gamer927/rav4/docs/06-system-review.md

# System review: fail-safes, fallbacks and integrity

A whole-system review of the RAV4 transmission controller before it goes on a custom circuit
board. It covers how the parts fit together, what happens when each one fails, how every
behaviour is tested, and the risks that are left.

**Verdict:** every failure we can think of ends with the factory computer in charge, and nearly
all of them are also reported on the screen. All tests pass (§6). There are no known open
defects. The remaining risks (§7) can't be designed out, or can only be checked on the real car.
The circuit is laid out as one circuit board (§8) that passes KiCad's design-rule check; the first
one built still has to pass the bench checks listed there.

---

## 1. The system on one page

Cable map

| Piece | Where | What it does |
|---|---|---|
| **TCU box** | Under the passenger side of the dash | An Arduino Mega with one circuit board plugged on top (relays, drivers, inputs, switch filters, screen and probe connections, gyro). It listens to the engine computer and can take over the transmission's three solenoids. |
| **Dash pod** | Dash top, driver's side | The screen, then ECO, SPORT, MANUAL, TEST and ON/OFF in a row. |
| **Shifter base** | Centre console | The Beavis sequential lever (two microswitches). |
| **Car side** | — | 7 listening taps (nothing cut), the 3 solenoid wires (cut and taken through the box), key-on power, the ATF temperature probe, a heatsink with 3 dummy resistors. |

**How control works.** Each of the three solenoids (S1, S2, SL) has its own two-pole relay:

```
relay OFF (no coil power):  factory ECU ──────────────► solenoid      the car as built
relay ON  (coil powered):   factory ECU ──► 15 Ω dummy (ECU sees a normal load, no trouble code)
                            TCU driver  ──────────────► solenoid
```

The relays are only ON while the TCU is in charge. Everything in this review comes back to one
rule: **anything that goes wrong turns the relays off.**

---

## 2. The safety chain

The layers below each work on their own. The ones at the top don't need the Arduino to work.

| # | Layer | What it does | Needs the Arduino? |
|---|---|---|---|
| 1 | **Bypass plug** | Unplug the TCU, plug the BYPASS plug into the car's X2: the solenoids are wired straight to the ECU. The car is 100 % stock. | No |
| 2 | **Relays rest in the factory position** | No power, a dead Mega, a blown fuse, a cut wire: the relays drop out and the ECU drives. | No |
| 3 | **ON/OFF cuts the relays' power directly** | The switch has two poles. Pole 2 carries the relay coils' 12 V (through the dash cable, C7/C8), so OFF drops the relays even if the Mega has crashed with its outputs ON or a driver chip has failed shorted. | No |
| 4 | **Pull-downs on every output** | 10 kΩ on D6, D8, D9, D10: while the Mega resets or boots, every relay and driver reads OFF. | No |
| 5 | **Watchdog, 250 ms** | A hung program resets the Mega within a quarter of a second; the reset turns everything OFF (layer 4). The self-test proves the watchdog works. | Its own timer |
| 6 | **Faults hand back and latch** | Every fault in §4 turns the relays off and stays off until you flip ON/OFF off (or, for stuck hardware, until the next key-on). | Yes |
| 7 | **Rules for taking over** | Only after a fresh OFF→ON flip (≥ 100 ms off), only in D, only with exactly one of ECO/SPORT/MANUAL on, only when calibrated, only when the sensed gear agrees with engine rpm. Never by itself at key-on or after a reset. | Yes |
| 8 | **Self-tests** | At every key-on (PBIT), all the time (CBIT) and when you hold TEST (IBIT). Detailed in spec §7. | Yes |

Layers 1–5 mean that a software bug can't keep the relays on against your will: **ON/OFF off
always wins.**

---

## 3. Fallbacks: what you get when

| Situation | Who shifts | Screen |
|---|---|---|
| ON/OFF off | Factory ECU | TCU IS OFF |
| Key-on with ON/OFF already on | Factory ECU until you flip it off and on | WAITING |
| No mode switch on / two or more on (> 1 s) | Factory ECU; the TCU takes back over by itself when fixed | PICK MODE / MODE ERROR |
| Lever moved out of D | Factory ECU; back to TCU when you return to D (synced to the ECU's gear) | STOCK |
| Takeover asked for on the move, but the sensed gear doesn't fit engine rpm | Factory ECU until the car stops | STOP FIRST |
| Any fault (§4) | Factory ECU | PROBLEM + what's wrong |
| Not calibrated yet | Factory ECU | NOT READY |
| Screen dead or unplugged | TCU carries on (the screen is information only) | — |
| ATF probe or tach lost | TCU carries on, using safe defaults | warning |
| Box unplugged or removed | Factory ECU, via the bypass plug | — |

---

## 4. Failure modes and what happens

How to read this table: **Detected by** is what notices; **Result** is the state the car ends up
in; **Tested by** names the automated test that proves it (unit test function in `test/`,
system scenario in `test/system/`, or cross-check in `tools/system_check.py`). "Hardware" means
it is physics, not software: it happens even if the Mega is dead.

### Power and the Arduino

| Failure | Detected by | Result | Tested by |
|---|---|---|---|
| Key-on power lost / fuse blows | Hardware | Relays drop: ECU | system: *battery voltage collapses* |
| Battery below 10.5 V or above 16 V for 0.5 s | `FAULT_SUPPLY` | ECU, PROBLEM | unit `test_supply_and_tps_faults`; system: *battery voltage collapses* |
| Load dump / spikes on 12 V | TVS1/TVS2 (27 V) | Clamped | — (part choice) |
| Wires reversed at X1 | D1 blocks on the logic feed; TVS1 conducts on the driver feed and blows its 5 A fuse | Logic protected, nothing powered | — (part choice) |
| 5 V regulator fails shorted (12 V on 5 V) | TVS3 clamps, the 2 A fuse blows | Mega off: relays drop, ECU | — (part choice) |
| Program hangs | Watchdog (250 ms) | Reset, everything off, ECU | system: *firmware hung with relays on*; IBIT watchdog step |
| Reset mid-drive (any cause) | Pull-downs + arming rule | Relays drop; **no** automatic re-takeover | unit `test_boot_requires_switch_cycle`, `test_boot_glitch_does_not_arm`; system: *reset at 50 mph* |
| Mega's outputs stuck ON (crash, damaged pin, shorted ULN2803) | You flip ON/OFF off | Relays drop in hardware | system: *firmware hung with relays on* |

### The ON/OFF switch and its wiring

| Failure | Detected by | Result | Tested by |
|---|---|---|---|
| Read pole's wire (C5) broken | Reads OFF | ECU (safe direction) | system: *ON/OFF turned OFF while driving* |
| Read pole's wire shorted to ground (reads ON) | Power pole still cuts; A7 vs D26 disagree | Relays drop in hardware, `FAULT_ONOFF` | unit `test_onoff_two_poles_and_relay`; system: *ON/OFF read wire shorted* |
| Power pole wire (C7/C8) broken, F2 blown | A7 sees no coil power with D26 ON | ECU, `FAULT_ONOFF` | system: *relay coil fuse blown* |
| Power pole welded or shorted (no hardware cut) | A7 sees coil power with D26 OFF; key-on and IBIT cut checks | `FAULT_ONOFF` on the screen; the firmware's own OFF still works | system: *ON/OFF power pole shorted*; IBIT *ON/OFF CUT* |
| C7/C8 shorted to ground | F2 (PTC) trips | No coil power: ECU, `FAULT_ONOFF` | cross-check 5 (PTC in the feed) |
| Switch bounce, a glitch at boot | Debounce + ≥ 100 ms OFF before arming | Not armed | unit `test_debouncer`, `test_boot_glitch_does_not_arm` |

### Relays, drivers and solenoids

| Failure | Detected by | Result | Tested by |
|---|---|---|---|
| Relay welded / stuck in the TCU position | Key-on relay-release check (drivers on, relays off: any current = stuck) | No takeover all drive, RELAY STUCK | unit `test_onoff_two_poles_and_relay`, `test_detects_faults`; system: *relay welded* |
| Relay doesn't pull in | Current check (commanded on, < 0.6 A) | ECU, `FAULT_SOLENOID` | unit `test_cbit_solenoid_fault` |
| Solenoid wire broken (open) | Current check | ECU, `FAULT_SOLENOID` | system: *solenoid wire breaks while driving* |
| Solenoid wire shorted to ground | Current check (> over-current limit) | ECU, `FAULT_SOLENOID` | unit `test_cbit_solenoid_short`; system: *solenoid wire shorted* |
| Driver MOSFET fails shorted | Current check (commanded off, > 0.2 A) | ECU (the relay disconnects the driver) | unit `test_cbit_solenoid_short` |
| Wrong gear engaged (swapped S1/S2, hydraulic fault, bad sensor) | Ratio check: rpm vs speed × gear, with lockup on | ECU, `FAULT_RATIO` / WRONG GEAR | unit `test_ratio_fault` |
| Relay coil flyback when ON/OFF opens | DF (UF4007) and the ULN2803's diodes | Clamped | cross-check 5 (DF on the coil feed) |

### Sensors and inputs

| Failure | Detected by | Result | Tested by |
|---|---|---|---|
| Speed signal lost at speed | Speed drops faster than any car can brake | ECU, `FAULT_VSS` | unit `test_vss_faults`; system: *speed signal lost at 45 mph* |
| Speed signal dead from the start | Engine working hard in 2nd+ at "0 mph" for 3 s | ECU, `FAULT_VSS` | unit `test_vss_faults` |
| Throttle sensor open/short | Voltage out of range for 0.2 s | ECU, `FAULT_TPS` | unit `test_supply_and_tps_faults` |
| Tach lost | No rpm above 15 mph for 2 s | TCU carries on: over-rev guards use speed × ratio, ratio check pauses; NO RPM warning | unit `test_onoff_two_poles_and_relay`; system: *tach lost* |
| ECU sense input dead or mis-wired | Sensed gear vs engine rpm at takeover | Waits for a stop, then starts in 1st | unit `test_entry_plausibility`, `test_entry_sync`; system: *ECU sense dead* |
| Lever-D input broken (reads "not D") | Reads not-D | ECU (safe direction) | system: *lever out of D* |
| **Lever-D input stuck on** (reads D in P, R, N, 2, L) | Engine starts while it reads D (the starter only turns in P or N) | No takeover until the next key-on, LEVER SENSOR | unit `test_lever_stuck_at_start`; system: *lever-D input stuck on* |
| Brake input dead | Self-test prompt PRESS THE BRAKE | Lockup still releases on throttle-off rules; found at the next self-test | IBIT prompts |
| ATF probe unplugged | Bad readings | Warning; lockup uses the normal rules | system: *ATF probe unplugged* |
| ATF overheats | 110 °C / 125 °C | Warning; lockup held on to cool | system: *ATF overheats*; unit `test_hot_atf_widens_lockup` |
| Gyro dead | Self-test, `latValid` false | Corner hold switched off; everything else carries on | unit `test_corner_hold` |

### Driver controls

| Failure | Detected by | Result | Tested by |
|---|---|---|---|
| Two mode switches on, or none | Exactly-one rule, 1 s grace | ECU until fixed, MODE ERROR / PICK MODE | unit `test_mode_switch_fault_and_stuck_button`; system: *two mode switches on* |
| Mode switch wire broken | Reads off: none on | ECU, PICK MODE | same |
| Shifter microswitch stuck | Held 10 s | Warning (SHIFTER?); no repeat shifts | unit `test_mode_switch_fault_and_stuck_button`, `test_no_autorepeat_and_interval` |
| Dangerous shift asked for | Over-rev check (5,800 rpm), 1st capped at 28 mph; ECO/SPORT upshift at 6,200 rpm, MANUAL shows SHIFT UP! from 6,000 rpm and leaves it to the driver | Downshift refused; upshift done (ECO/SPORT) or asked for (MANUAL) | unit `test_downshift_overrev_guard`, `test_rev_limit_upshift`, `test_manual_auto_downshift_to_stop` |
| Screen cable cut / screen dead | I²C timeout (3 ms) | Control unaffected, loop never stalls | system: *screen cable cut* |

### The self-test itself

| Failure | Detected by | Result | Tested by |
|---|---|---|---|
| Self-test started with the engine running | Two checks: rpm **and** charging voltage | Refused (CAN'T TEST) | unit `test_interlocks`; system: *self-test refused with the engine running* |
| Car moves / lever to D / engine starts mid-test | Checked every loop | Test aborts, everything off at once | unit `test_abort` |

---

## 5. Integrity: does everything agree?

`tools/system_check.py` checks the things no single test sees, by reading the actual circuit,
circuit board, firmware, housings and documents:

1. Every Mega pin the firmware uses is wired to the signal that means the same thing, and no
   wired Mega pin is unused.
2. Every net at a Mega pin carries that pin's signal.
3. Every output that drives a relay or a solenoid driver goes only to ULN2803A inputs (each has
   its own pull-down inside the chip): nothing can hold it on while the Mega resets.
4. Every switch input has its 2.2k pull-up, 10k series resistor and 100 nF capacitor.
5. The ON/OFF hardware cut: the relay coils are fed **only** through the switch's power pole (DASH terminals 7 and 8),
   through the PTC, with the flyback diode, and the sense reaches A7.
6. The box's glands, the board's terminal groups and the cable map agree, in the same order.
7. Every screen text fits where it's drawn.
8. Part counts on the shopping list match the board.
9. The spec's pin table lists every pin the firmware uses.
10. Every link in the documents points at a file that exists.
11. The circuit board file is the circuit: every pad of every part is on the net the circuit
    says (read straight from `hardware/pcb/rav4-tcu.kicad_pcb`), and KiCad's design-rule check
    reports no errors and no unconnected pads.

The checker was itself tested by breaking things on purpose (a wrong Mega pin, relay coils fed
straight from 12 V, an over-long screen line, a missing pull-down): it caught every one.

**Physical fit** (`tools/build_stl.sh`): each housing's fit check intersects every part, wire
bundle, plug and gland with the housing and with each other, and must come out empty:

- **TCU box:** the circuit board with every part at its real size and height (read from the
  board design), the Mega under it with its jacks, every cable's wires fanning from its gland to
  its terminal group, the lid lip, at least 15 mm of working room in front of the terminals,
  and no two glands' nuts touching.
- **Dash pod:** every switch body with its terminals and a wire bend (ON/OFF modelled as a
  2-pole switch, 18 × 22 × 50 mm), the screen, 8 lever connectors, both glands, the ON/OFF
  cover, and the pod tilting through its whole range on the hinge.
- **Shifter base:** bolt tips, mounting bolts, the gland and cable, connectors, and the real
  Beavis shifter body standing on the deck with its wire hole opening into the body's pocket.

All three pass.

---

## 6. Test results

| Suite | What | Result |
|---|---|---|
| `make test` | Unit tests: every control rule, fault, interlock and self-test step, every limit exactly at its value (`test/test_tcu_logic.cpp`, `test/test_self_test.cpp`). Built with AddressSanitizer and UBSan: a read past an array fails | **2,221 + 274 checks, 0 failures** |
| `make system` | The real `tcu.ino`, compiled for a PC, wired to a simulated car (engine, gears that follow the solenoids, relays that pull in 15 ms after their coil is powered, current sensors with their own zero offsets, a gyro that drifts, welded contacts, broken wires), one failure per scenario. The screen is read back from the pixels sent over I2C; 250 ms without a watchdog kick fails | **38 scenarios, 0 failures** |
| `make golden` | Every system scenario's screen changes (row by row, flashes included) and USB event lines, and the calibration session's whole log, against reference copies (`test/system/golden/`) | **identical** |
| `make chip` | The `.hex` exactly as flashed, started by the Mega's real bootloader, on a simulated ATmega2560 (simavr): see §6.1 | **18 scenarios, 0 failures** |
| `make calibrate-test` | The calibration helper on a simulated parked session and drive, with a speed sensor 6 % off and an engine 5 % off: it must find both, write a `config.h` that compiles, and refuse bad recordings | **32 checks, 0 failures** |
| `python3 tools/system_check.py` | Cross-checks (§5) | **864 pass, 0 problems** |
| `tools/build_stl.sh` | Fit checks (§5), STLs, renders | **all pass** |
| `make avr` | Compile for the Mega 2560, warnings as errors | **OK**: 15 % flash, 47 % RAM (the core linked as the Arduino IDE does it); the self-test's saved results are clear of the bootloader's stack |
| `make mutate` | How good the tests are: §6.2 | see §6.2 |

`make check` runs all of these but the fit checks and `make mutate`. Run it after any change.

### 6.1 The chip test: the firmware as flashed

The PC tests replace the Arduino core, the chip and its bootloader with stand-ins written for the
tests. A wrong assumption about the hardware then sits in the stand-in too, and the test passes:
the bootloader clearing the reset-cause register (§6.4) was found only once the real bootloader
ran. `make chip` (`test/chip/chip_test.cpp`) removes that layer: the `.hex` the Arduino build
makes, the real stk500v2 bootloader at its real address, every instruction, timer, interrupt, the
watchdog, the ADC, the UART and the I2C hardware simulated by simavr. Around the chip, the board
and the car come from the circuit, not from `config.h`: the pins are read from the Arduino core's
own Mega pin table; the screen is an SSD1309 whose pixels are read back as text; the temperature
probe is a DS18B20 answering bit by bit on the 1-Wire line, with its checksum written from the
datasheet; the gyro is an MPU-6050. The firmware is judged only by its pins, its USB log and its
screen.

It covers, on the shipped build: the boot through the bootloader; never taking over before
calibration; the probe (read once a second, bad readings and its power-on value handled, nothing
made up before the first reading); the screen cable cut and back; the **full self-test answered
from the screen, ending in the deliberate watchdog reset through the real bootloader**. And on the
calibrated build: taking over and shifting 1-4, MANUAL shifting with the lever, corner hold from
the gyro over I2C, ON/OFF, a broken solenoid wire, a lost speed signal, a battery collapse, the
reset button mid-drive, a welded relay at key-on, a lost tach.

Measured on the chip: the slowest loop while driving is **7.6 ms** (the control period is 10 ms;
the watchdog allows 250 ms); 46 ms once at power-up, parked, while it prints the self-test table;
**3,740 bytes** of stack never touched.

### 6.2 Do the tests catch bugs? Mutation testing

A test suite that passes says nothing until you know it would fail on a bug. `tools/mutate.py`
plants one small bug at a time in the firmware (a `<` becomes `<=`, `&&` becomes `||`, `true`
becomes `false`, a statement disappears; 1,397 in all), rebuilds, and runs the unit tests, the
system test, the calibration helper and the golden comparison against it; the hardware-side ones
that get past those also face the chip test. Each planted bug ends up in one of these:

- **caught**: some test fails;
- **missed**: a gap;
- **at a limit only**: it only matters when a reading lands exactly on a limit (`<` vs `<=` on a
  voltage, a speed or a time). The safety limits have their own exactly-at-the-limit tests;
- **can't simulate**: real, but no simulation can show it (an interrupt landing between two
  reads, a floating pin). Counted against the score, never as caught;
- **equivalent**: provably changes nothing, each listed in `mutate.py` with the reason (e.g.
  "the Mega's bootloader already disables the watchdog", "the Mega's own LED is under the board").

| Code | Caught | Missed | At a limit only | Can't simulate | Equivalent | Score (all) | Score without the at-a-limit ones |
|---|---|---|---|---|---|---|---|
| `self_test.cpp` (the self-test's verdicts) | 208 | 0 | 0 | 0 | 15 | **100 %** | **100 %** |
| `tcu_logic.cpp` (every driving and safety decision) | 443 | 0 | 62 | 0 | 44 | 88 % | **100 %** |
| `tcu.ino` (pins, sensors, screen, log, the watchdog step) | 522 | 5 | 37 | 6 | 44 | 92 % | **98 %** |

When this started the scores were 60 %, 68 % and 29 %: passing tests were far weaker than they
looked. The five still missed, all minor:

- the temperature reading could come one second later than it does;
- two in the health line's stack-margin arithmetic (a diagnostic);
- "LEVER NOT IN D" could also show in one rare STOCK state;
- a refused self-test's CAN'T TEST could linger for a second into a new one.

The full list, with every equivalent's reason, is in `build/mutants/report.md` after
`make mutate` (`python3 tools/mutate.py --report` rewrites it from the saved results).

### 6.3 What only the real car can prove

Everything above is simulation. These can't be simulated with any confidence and are checked by
the build book's meter checks, the bench test and the staged car test (spec §9): the solenoids'
real resistance and the hydraulics' response time; the real gear ratios, speed-sensor pulses and
throttle voltages (calibration, spec §8); electrical noise in the car; the relays' and MOSFETs'
real switching; the screen's I2C over the real 2.5 m cable; heat.

### 6.4 Found by the deeper testing

| Found | Fix |
|---|---|
| **Bug (real hardware only):** the Mega's bootloader clears the reset-cause register, so SAFETY RESET would always fail and a hang never showed TCU RESTARTED | A mark left by the watchdog's interrupt; the PC simulator now models the bootloader too, and the chip test runs the real one |
| The PC tests read the screen from the firmware's own text buffer: deleting the call that draws the screen passed | The screen is read from the pixels sent over I2C |
| The PC stand-in returned the wire's level when the firmware read back one of its own outputs; the chip returns the level written. So on the PC the current sensors' zeros were never learned, hidden by a perfect 2.50 V zero | Fixed, and every sensor now has a real-world zero offset (2.47-2.54 V) |
| Relays and solenoids reacted instantly in the tests, so a self-test step that measured too early still passed | A relay takes 15 ms to close, a solenoid's current 20 ms to come up |
| A broken ON/OFF hardware cut, a welded relay during the cut, or the cut with no current sensors could all have shown OK in the self-test without a test noticing | Each has its own test now |
| No test ran the gyro from end to end; a stuck lever-D, the throttle sensor's open wire, a corrupted saved self-test table, the probe's bad readings | Scenarios for each, on the PC and on the chip |

**System scenarios** (each in its own process, from a cold boot):

| Scenario | Shows |
|---|---|
| boots parked | key-on checks pass, factory ECU drives |
| ON/OFF already ON at key-on | waits for a fresh flip |
| normal drive | takes over in D, shifts 1-4, watchdog kicked |
| ON/OFF turned OFF while driving | ECU back within 60 ms |
| firmware hung with relays on | ON/OFF still cuts them in hardware |
| ON/OFF read wire shorted | power pole cuts, mismatch reported |
| ON/OFF power pole shorted | found at key-on and reported |
| relay coil fuse blown | no takeover, reported |
| relay welded | found at key-on, no takeover |
| solenoid wire breaks while driving | ECU back, reported |
| two mode switches on | ECU after 1 s, back when fixed |
| lever out of D | ECU back |
| lever-D input stuck on | found at engine start, no takeover |
| MANUAL at the redline | no automatic upshift, SHIFT UP! on the screen |
| speed signal lost at 45 mph | ECU back |
| tach lost | still in control, warned |
| screen cable cut | control unaffected, loop never stalls |
| battery voltage collapses | ECU back |
| ECU sense dead, takeover on the move | waits for a stop |
| reset at 50 mph (a hang: the watchdog fires) | relays drop, no takeover after the reboot, TCU RESTARTED |
| reset button at 30 mph | relays drop, no RESTARTED note (it wasn't a hang) |
| self-test SAFETY RESET on a real Mega's bootloader | passes after the reboot; pressing reset instead fails it |
| solenoid wire shorted | over-current, ECU back |
| ATF probe unplugged | warned, still in control |
| ATF overheats | warned, lockup held to cool it |
| self-test (IBIT) | every check passes, including the hardware cut |
| self-test refused with the engine running | refused |
| build book 13.4 (jack stands), step by step | the screen says what the book says at each step |
| corner hold from the gyro | an 8 deg/s zero drift learned at a stop and re-learned as it warms up; a long gentle bend doesn't spoil it; a real corner holds the gear |
| gyro glitches, then dies mid-corner | the hold ends, still in control |
| throttle reading | 0/50/100 % right, also with a shifted engine ground |
| throttle sensor wire broken | ECU back, PEDAL SENSOR |
| saved self-test table corrupted over the reset | not restored |
| screen tour | below zero, the SENSORS page's values, the TEST page before the key-on checks, a self-test stopped by the engine starting, one TEST press skipping one prompt, a self-test with more failures than fit on the screen |
| wrong gear engaged (S1/S2 swapped) | ECU back, WRONG GEAR |
| shifter switch stuck closed | one shift, SHIFTER? |
| SPORT brake hold | HOLDING GEAR on the screen |
| 40 mph round a long gentle bend | not learned as the gyro's zero |

### What this review found and fixed

| Found | Fix |
|---|---|
| ON/OFF only *asked* the Mega to hand back: a crashed Mega or a shorted driver chip could keep the relays on | Two-pole switch; pole 2 carries the coils' power (J5, F2, DF), A7 checks it, `FAULT_ONOFF`, IBIT step ON/OFF CUT |
| **Bug:** the switch filters started at "off", so a switch already ON at key-on (or after a reset at speed) looked like a fresh flip and armed the TCU | Filters start from the real pin level; arming needs ≥ 100 ms of OFF first |
| A dead ECU-sense input reads as "4th gear": a takeover on the move could start in the wrong gear | Sensed gear must agree with engine rpm, else wait for a stop |
| A welded relay was only found when you ran the self-test | Relay-release check at every key-on, `FAULT_RELAY` |
| Losing the tach while driving was silent | NO RPM warning |
| A lever-D input stuck on was never noticed | Checked at every engine start, `FAULT_LEVER` |
| A failed 5 V regulator could put 12 V into the Mega | TVS3 across the 5 V rail |
| Several screen lines were too long for the display | Shortened; now checked automatically |
| The dash cable's C7/C8 route to J5 crossed the logic board | Routed along the front gap, then back between the boards; fit check passes. Since then C7/C8 are DASH terminals 7 and 8 on the circuit board |
| Hand-wiring two perfboards and a hub (~175 wires) was the biggest job, and the likeliest place for a mistake | One printed circuit board does all the wiring; its connections are checked pad by pad against the circuit |
| The ON/OFF switch was modelled as a 1-pole switch; the pod had room for only 5 connectors | Modelled as a larger 2-pole switch with 8 connectors; pod fit check passes |
| Before calibration the self-test marked CALIBRATED as **BAD**, so the bench test could never say ALL OK, and the main screen said SELF-TEST BAD | "Not calibrated yet" is now a CHECK (a reminder) |
| On the bench nothing drives the gas pedal input, so the self-test always reported GAS PEDAL BAD | Build book 10.1: a two-resistor gas pedal stand-in for the bench |
| **Bug (real hardware only):** the Mega's own bootloader clears the chip's reset-cause register before the program starts, so the program never saw a watchdog reset: the self-test's SAFETY RESET step would always have said BAD, and a hang never showed TCU RESTARTED. The simulator had set the register by hand, so it couldn't see this | The watchdog's timeout now runs a short routine that leaves a mark in memory that survives the reset, then resets. The simulator now models the bootloader, and the new scenarios fail on the old code |
| Unused Mega pins were left floating (the datasheet advises against it: they pick up noise) | Pulled up at boot; a cross-check makes sure none of them is wired on the board |
| Nothing showed how close the program runs to its limits | Every 10 s the USB log has a `# health` line: the slowest loop (the watchdog allows 250 ms) and the stack margin. The calibration helper prints both and flags a loop over 100 ms or under 512 bytes of margin |

---

## 7. What's left: honest residual risks

Nothing on this list has a known fix that wouldn't add a new risk of its own.

1. **A dummy resistor goes open while the TCU is in charge.** The ECU sees an open solenoid
   circuit, stores a trouble code, lights the check-engine light, and may run its own limp mode
   after you hand back, until the next key cycle. The TCU can't see it (it senses the ECU's
   command voltage, not the current into the dummy). *Mitigation:* 50 W resistors on a
   heatsink, checked in build book part 9; the light tells you. Not dangerous.
2. **Relay contact gap at handover.** Break-before-make takes about 5–10 ms with no drive to the
   solenoid. That's shorter than the hydraulics respond, so no shift happens, but it's not zero.
3. **MANUAL doesn't upshift for you at the redline** (your choice). The screen says SHIFT UP!
   from 6,000 rpm; past that, the engine computer's own fuel cut limits the revs. That fuel cut
   is expected but not yet confirmed for this engine (spec §10). Setting
   `MANUAL_REV_LIMIT_UPSHIFT = true` brings back the automatic upshift.
4. **The screen going dark doesn't hand back.** By design: the screen is information, not
   safety. Faults still hand back; ON/OFF still works by feel (the cover).
5. **A relay that sticks *during* a drive** (rather than at key-on). If it sticks in the TCU
   position after you hand back, that solenoid gets no command from either side until it's
   found at the next key-on (RELAY STUCK). The relays switch about 1 A against an 8 A rating,
   so welding is very unlikely. *Recovery:* the bypass plug.
6. **The solenoid wire itself (outside the box) shorted to +12 V.** The solenoid is on whatever
   either computer says. This is the same as on a stock car; the ratio check catches the wrong
   gear while the TCU is in charge.
7. **Brake input dead.** Lockup then releases only on the throttle rules, not on the brake. A
   stall is still prevented by the low-speed lockup release, and the next self-test finds it.
8. **What the manual valve does in 2, L and R with D-range solenoid commands** (only possible
   with a stuck lever-D input, which is now caught at engine start). Toyota's hydraulics are
   expected to block it; **VERIFY** in the repair manual.
9. **Untested on real hardware.** Every number above comes from simulation and the design.
   Calibration (spec §8) and the staged test plan (spec §9) are required before driving.
10. **Zero risk isn't possible.** A double failure (for example a hung Mega *and* a welded
   ON/OFF power pole) defeats two layers at once. The bypass plug, and pulling the TCU's
   fuse, are always there.

---

## 8. The circuit board

The whole TCU circuit is one 2-layer board, 200 × 170 mm, that plugs onto the Mega's pins
(`tools/pcb.py`; the files to order it are in [`hardware/pcb/`](../hardware/pcb/README.md)).
It reuses the tested circuit in `tools/boards.py` net for net, with the same connectors, so the
cables, housings and tests carry over. What changed on the way:

| Change | Why |
|---|---|
| The ribbon cables and the hub are gone: the board's own pins plug into the Mega | Fewer connections to go wrong; nothing to come loose |
| The adjustable LM2596HV buck module became a fixed RECOM R-78HB5.0-0.5 (9–72 V in) with 47 µF + 100 nF | Nothing to set before first power-up, so the Mega can't get a wrongly set voltage; through-hole, solders straight in |
| The two pull-up groups were both RU1–RU6; the switch inputs' are now **RU11–RU17** | One board needs unique names |
| The MOSFETs lie flat with their tabs bolted down; the current-sensor modules plug into 3 holes plus 2 short **LINK** wires | Low and solid in a car that vibrates |
| Tracks sized by current: 1.5 mm for the solenoid supply, 1.0 mm for the solenoid, load and 12 V lines, ground filled on both layers | Each solenoid draws about 1 A; the tracks stay cool |
| **Found on review:** the ground copper ran under each MOSFET's bolted metal tab (which is its drain, switched +12 V) and under the bolt's nut, with only the thin solder mask between them | Bare board, no copper, under every tab and around every bolt on both sides; a system check keeps it that way |
| **Found by the part fit check:** the Mega's and the modules' pin holes left 0.09 mm round a square pin; the MOSFETs' 1.1 mm holes left almost nothing round their legs; a 10 mm-wide 100 µF capacitor (some are) would hit the regulator; a long ACS712 module could cover its LINK holes | Pin holes 1.1 mm, MOSFET holes 1.3 mm, regulator moved 1.3 mm, LINK holes 35 mm from the pins; `tools/part_fit.py` checks every part at its largest size on every build |
| Made easier to solder (rev 2): the board grew from 150 to 170 mm deep and its parts spread out, bigger pads (long ovals on the chips), every part's value printed beside its name, sockets for U1 and U2, no ground pad joined solidly to the ground copper | A first-time builder can read every part off the board and heat every joint; the box grew to 216 × 212 mm. The router's via check was also fixed (it let a wide track leave a via too close to another track; KiCad's check caught it) |
| **Optimised (rev 3):** 22 parts left out. The 4 pull-downs on the ULN2803A's inputs duplicated the chip's own (2.7 kΩ + 7.2 kΩ to ground inside each input). The 18 BAT85 clamp diodes on the switch and throttle inputs: with the switch inputs' series resistor raised from 1 kΩ to 10 kΩ, a core shorted to 12 V puts at most 0.65 mA into the Mega's own input clamps (Microchip AN2519 allows 1 mA), and the 10 kΩ + 100 nF filter swallows a spike | 113 parts instead of 135, 44 fewer joints, one part type less to buy; nothing on the board depends on a part that isn't there any more (cross-checks 3 and 4) |
| **Found on review:** the board's posts were 2.5 mm too short: they left out the plastic strip of the male headers, which sits on top of the Mega's sockets | Posts 18.6 mm; the fit check passes at the new height |

Checks on the design: every chip's pinout was compared by hand with its datasheet (ULN2803,
LM393, PC817, IRF4905, R-78HB, the G2RL-2 relay's contacts, the sensor and gyro modules), and
`tools/part_fit.py` checks every real part at the largest size it's sold in against its holes,
its neighbours, the screw heads and the Mega underneath
([report](../hardware/pcb/part_fit.md)). KiCad's design-rule check reports **0 errors and 0 unconnected pads**
(`hardware/pcb/drc.txt`; the warnings left are text crossing pads, and library notices), the
system check matches every pad to the circuit, and the box's fit check uses the real board.

Still to do on the **first board** (nothing has been made yet):

- [ ] Look over the board maker's preview of the Gerbers before paying: the outline with its
      notch, the 5 mounting holes and the labels.
- [ ] Before soldering anything, push it onto a bare Mega with the header strips in: every pin
      goes through without force, and the notch clears the USB and power jacks.
- [ ] Build it step by step with the build book's meter checks (part 4 onwards), then the bench
      test (part 10): the full self-test passes, including **ON/OFF CUT** and **SAFETY RESET**.
- [ ] `IS_AMPS_PER_VOLT` calibrated; each solenoid channel reads about 0.8 A into 15 Ω.
- [ ] The 5 V rail reads 4.9–5.1 V and stays there with the engine cranking. The regulator
      needs about 9 V in; a weak battery that sags lower than that while cranking resets the
      Mega, which is safe (the relays drop and the engine computer is in charge) but will
      show as a fresh key-on.
- [ ] The 2-pole ON/OFF switch you bought fits the pod (18 × 22 mm body or smaller) and its
      cover clears.
- [ ] Everything in spec §10 (open items to VERIFY) ticked off.

---

*RAV4 TCU by gamer927 · [CC BY-NC-SA 4.0](../LICENSE): free to build, not to sell.*
