gamer927/rav4/docs/pcb-bottom.png

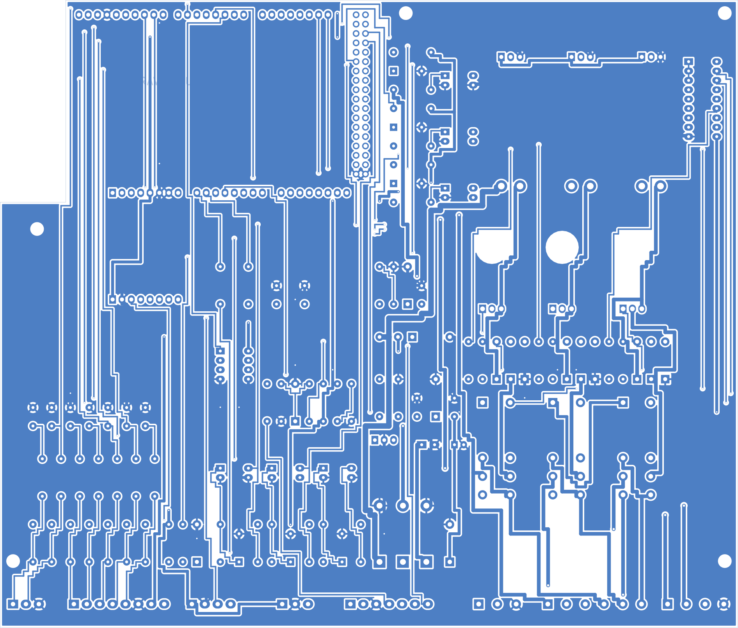
docs/pcb-bottom.png
