gamer927/rav4/hardware/fit-pod.png

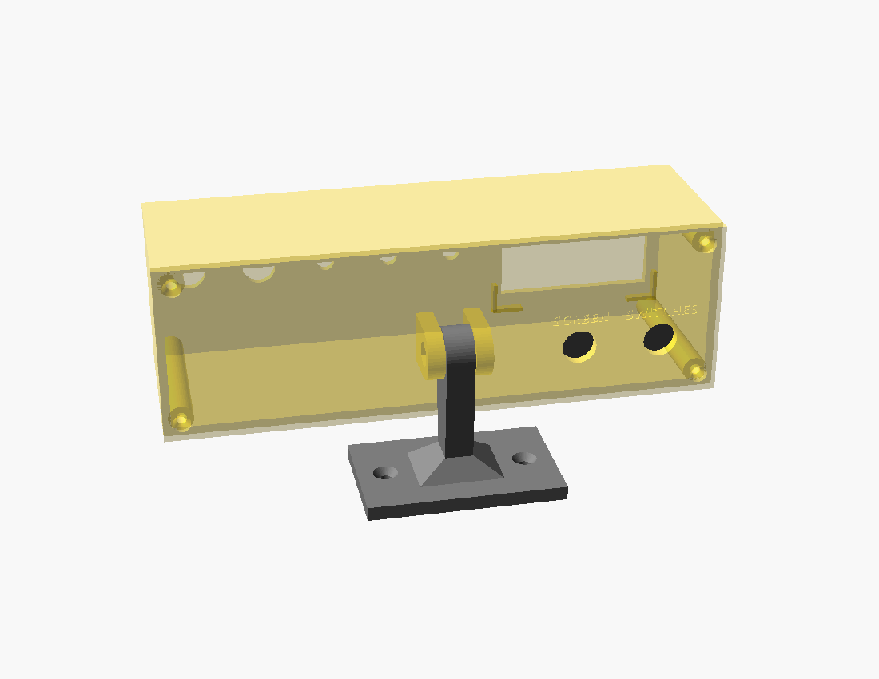
hardware/fit-pod.png
