gamer927/rav4/hardware/pcb/placement.png

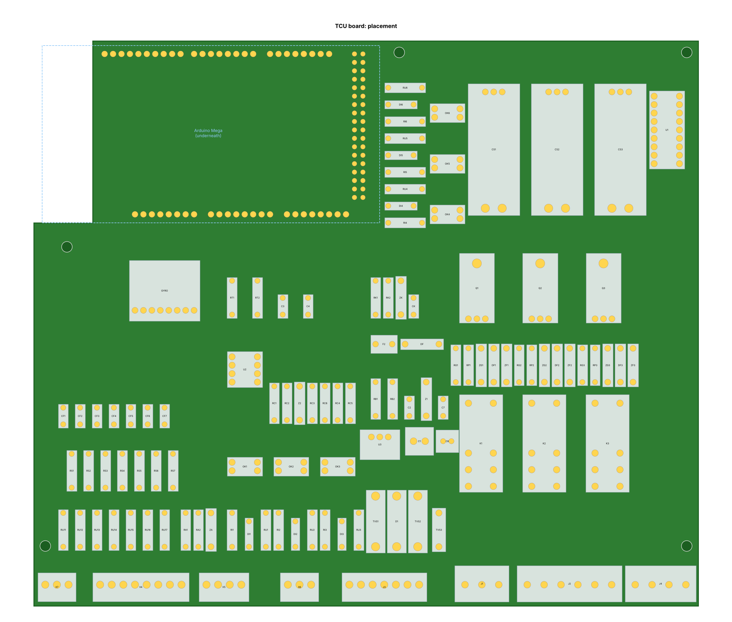
hardware/pcb/placement.png
