gamer927/rav4/hardware/pcb/bom.csv

Qty | Value | Footprint | References
3 | ACS712-05B | ACS712_Module | CS1 CS2 CS3
1 | 47 µF 16 V | CP_Radial_D6.3mm_P2.50mm | C6
1 | 100 µF 50 V | CP_Radial_D8.0mm_P3.50mm | C1
12 | 100 nF | C_Disc_D5.0mm_W2.5mm_P5.00mm | C2 C3 C4 C7 CF1 CF2 CF3 CF4 CF5 CF6 CF7 CK
1 | PTC 0.25 A | C_Disc_D7.5mm_W5.0mm_P5.00mm | F2
1 | R-78HB5.0-0.5 | Converter_DCDC_RECOM_R-78HB-0.5_THT | U3
1 | ULN2803A | DIP-18_W7.62mm_LongPads | U1
6 | PC817 | DIP-4_W7.62mm_LongPads | OK1 OK2 OK3 OK4 OK5 OK6
1 | LM393 | DIP-8_W7.62mm_LongPads | U2
1 | P6KE6.8A | D_DO-15_P10.16mm_Horizontal | TVS3
2 | 1.5KE27A | D_DO-201AD_P15.24mm_Horizontal | TVS1 TVS2
1 | 1N5822 | D_DO-201AD_P15.24mm_Horizontal | D1
6 | 1N4148 | D_DO-35_SOD27_P7.62mm_Horizontal | DI1 DI2 DI3 DI4 DI5 DI6
4 | 1N4733A 5.1 V | D_DO-41_SOD81_P10.16mm_Horizontal | Z1 Z2 ZA ZK
3 | 1N4744A 15 V | D_DO-41_SOD81_P10.16mm_Horizontal | ZG1 ZG2 ZG3
3 | 1N4749A 24 V | D_DO-41_SOD81_P10.16mm_Horizontal | ZF1 ZF2 ZF3
4 | UF4007 | D_DO-41_SOD81_P10.16mm_Horizontal | DF DF1 DF2 DF3
1 | GY-521 | GY-521_Module | GYRO
1 | 1.8k | R_Axial_DIN0207_L6.3mm_D2.5mm_P10.16mm_Horizontal | RC5
1 | 100 | R_Axial_DIN0207_L6.3mm_D2.5mm_P10.16mm_Horizontal | RA2
23 | 10k | R_Axial_DIN0207_L6.3mm_D2.5mm_P10.16mm_Horizontal | RB2 RC2 RC4 RC6 RK2 RP1 RP2 RP3 RS1 RS2 RS3 RS4 RS5 RS6 RS7 RT1 RT2 RU1 RU2 RU3 RU4 RU5 RU6
1 | 1M | R_Axial_DIN0207_L6.3mm_D2.5mm_P10.16mm_Horizontal | RC3
10 | 2.2k | R_Axial_DIN0207_L6.3mm_D2.5mm_P10.16mm_Horizontal | RI1 RI2 RI3 RU11 RU12 RU13 RU14 RU15 RU16 RU17
1 | 22k | R_Axial_DIN0207_L6.3mm_D2.5mm_P10.16mm_Horizontal | RC1
3 | 3.3k | R_Axial_DIN0207_L6.3mm_D2.5mm_P10.16mm_Horizontal | RI4 RI5 RI6
4 | 4.7k | R_Axial_DIN0207_L6.3mm_D2.5mm_P10.16mm_Horizontal | RA1 RG1 RG2 RG3
2 | 47k | R_Axial_DIN0207_L6.3mm_D2.5mm_P10.16mm_Horizontal | RB1 RK1
3 | G2RL-2 12 V | Relay_DPDT_Omron_G2RL-2 | K1 K2 K3
3 | IRF4905 | TO-220-3_Horizontal_TabDown | Q1 Q2 Q3
1 | PWR | TerminalBlock_Phoenix_MKDS-1,5-3-5.08_1x03_P5.08mm_Horizontal | J1
1 | LOAD | TerminalBlock_Phoenix_MKDS-1,5-4-5.08_1x04_P5.08mm_Horizontal | J4
1 | SOL | TerminalBlock_Phoenix_MKDS-1,5-6-5.08_1x06_P5.08mm_Horizontal | J2
1 | ATF | TerminalBlock_Phoenix_PT-1,5-3-3.5-H_1x03_P3.50mm_Horizontal | X6
1 | SHIFT | TerminalBlock_Phoenix_PT-1,5-3-3.5-H_1x03_P3.50mm_Horizontal | X7
1 | SCREEN | TerminalBlock_Phoenix_PT-1,5-4-3.5-H_1x04_P3.50mm_Horizontal | X5
1 | SIG | TerminalBlock_Phoenix_PT-1,5-7-3.5-H_1x07_P3.50mm_Horizontal | J3
1 | DASH | TerminalBlock_Phoenix_PT-1,5-8-3.5-H_1x08_P3.50mm_Horizontal | X4
1 | Arduino Mega 2560 (underneath, on male headers) | Arduino_Mega2560_Shield | A1
