gamer927/rav4/hardware/beavis_shifter/MainBody.stl

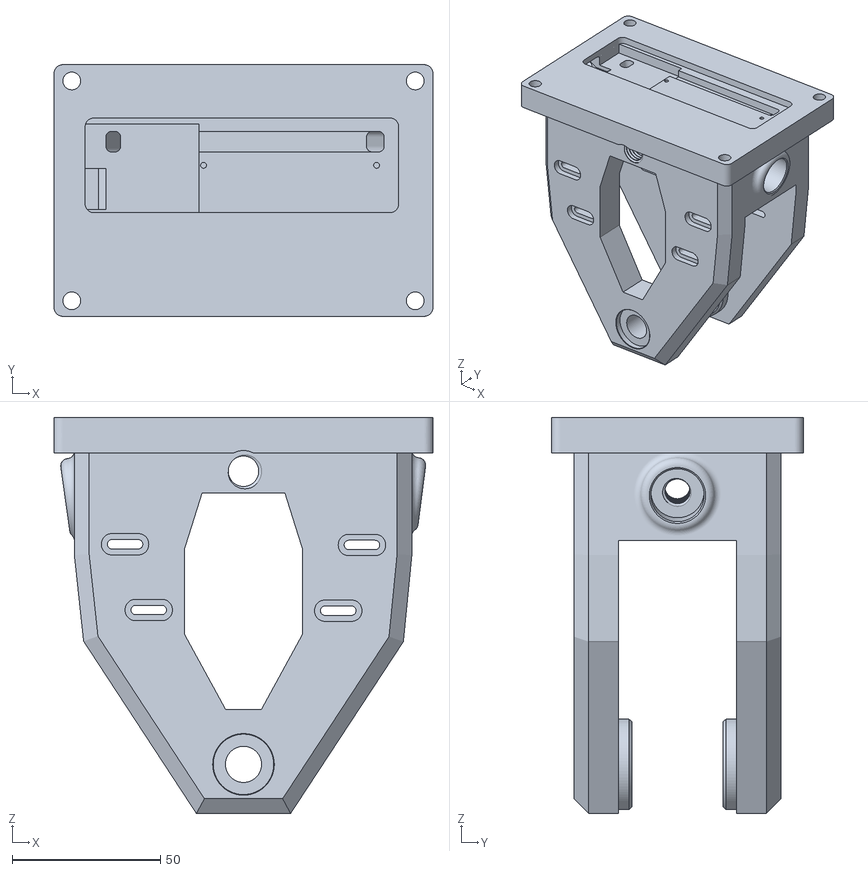
[picture p12: CAD file, 2026-10-27]
hardware/beavis_shifter/MainBody.stl
128.0 x 85.0 x 133.7
