gamer927/rav4/hardware/stl/tcu_enclosure_box.stl

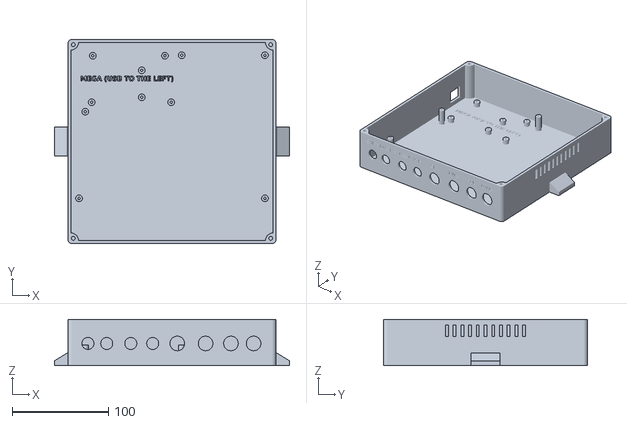
[picture p13: CAD file, 2026-10-28]
hardware/stl/tcu_enclosure_box.stl
244.0 x 212.0 x 48.0
