gamer927/rav4/hardware/beavis_shifter/BottomCover.stl

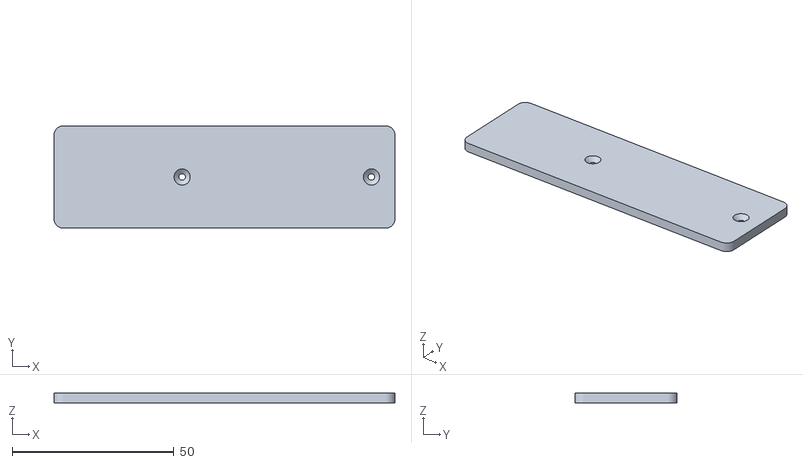
[picture p14: CAD file, 2026-10-27]
hardware/beavis_shifter/BottomCover.stl
105.3 x 31.6 x 3.05
