gamer927/rav4/hardware/stl/tcu_enclosure_lid.stl

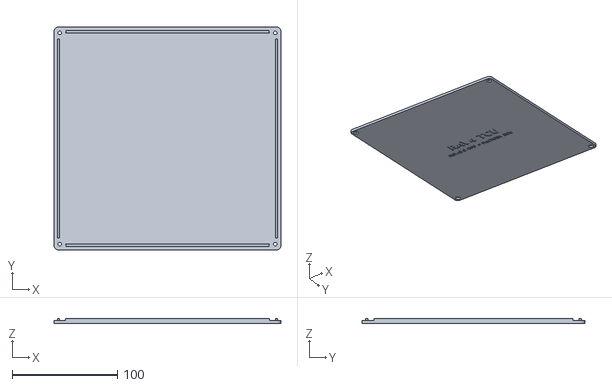
[picture p15: CAD file, 2026-10-28]
hardware/stl/tcu_enclosure_lid.stl
216.0 x 212.0 x 5.00
