gamer927/rav4/hardware/beavis_shifter/ShifterShaft.stl

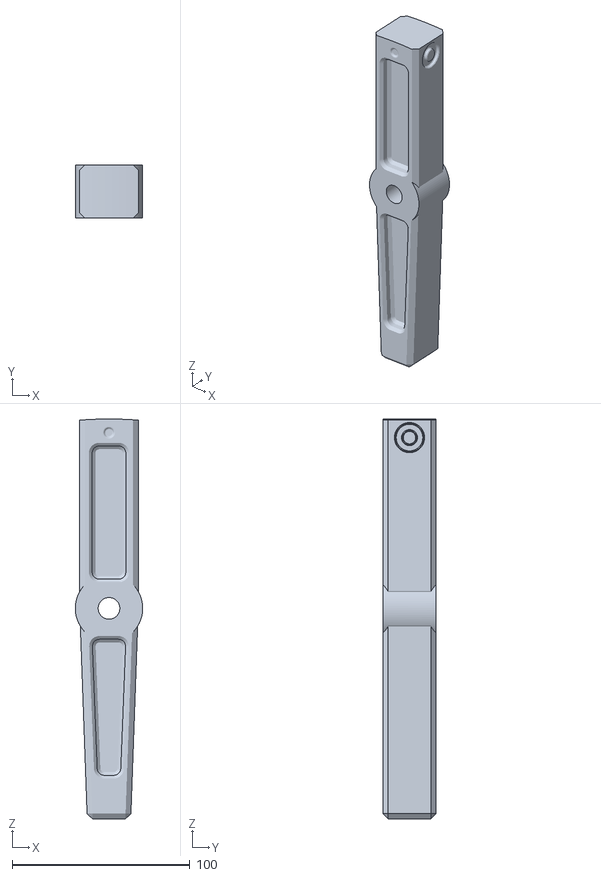
[picture p16: CAD file, 2026-10-27]
hardware/beavis_shifter/ShifterShaft.stl
38.0 x 30.0 x 225.3
