gamer927/rav4/hardware/stl/tcu_enclosure_box_no_ears.stl

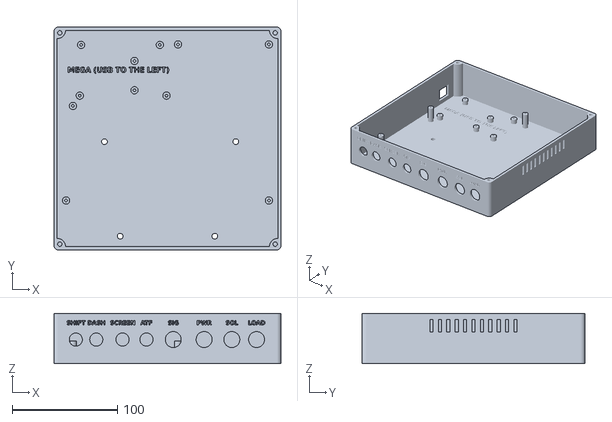
[picture p17: CAD file, 2026-10-28]
hardware/stl/tcu_enclosure_box_no_ears.stl
216.0 x 212.0 x 48.0
