gamer927/rav4/hardware/beavis_shifter/Knob.stl

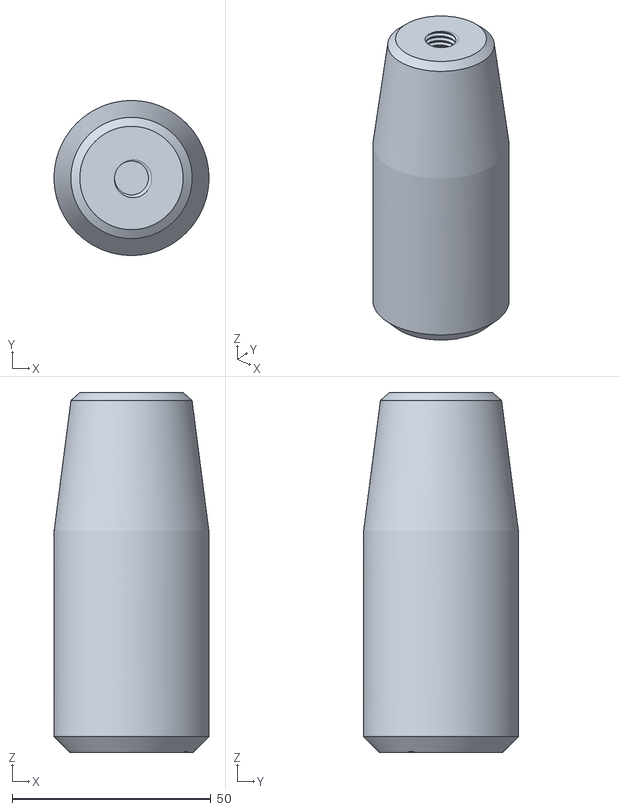
[picture p18: CAD file, 2026-10-27]
hardware/beavis_shifter/Knob.stl
39.0 x 39.0 x 90.6
