gamer927/rav4/hardware/stl/dash_pod_back.stl

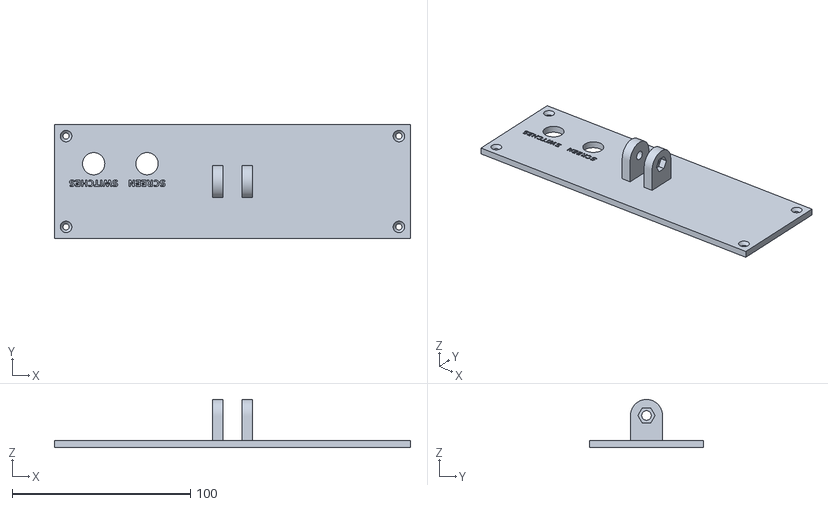
[picture p19: CAD file, 2026-10-28]
hardware/stl/dash_pod_back.stl
200.0 x 64.0 x 27.0
