gamer927/rav4/hardware/beavis_shifter/PivotCap.stl

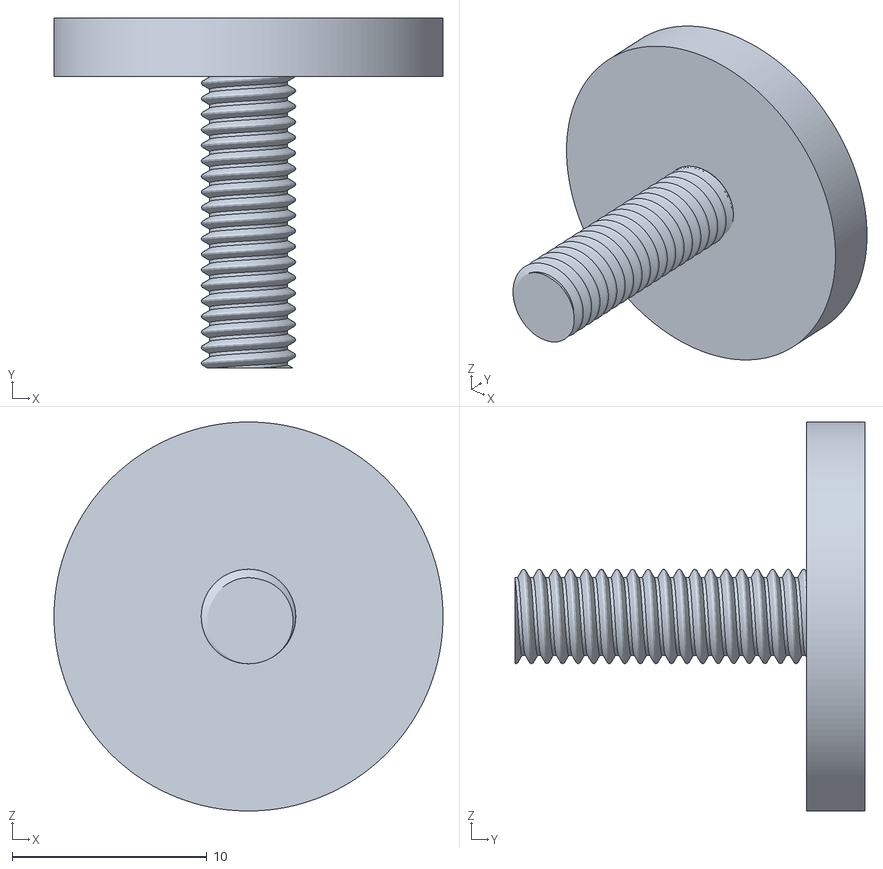
[picture p20: CAD file, 2026-10-27]
hardware/beavis_shifter/PivotCap.stl
20.0 x 18.0 x 20.0
