gamer927/rav4/hardware/stl/dash_pod_panel_test.stl

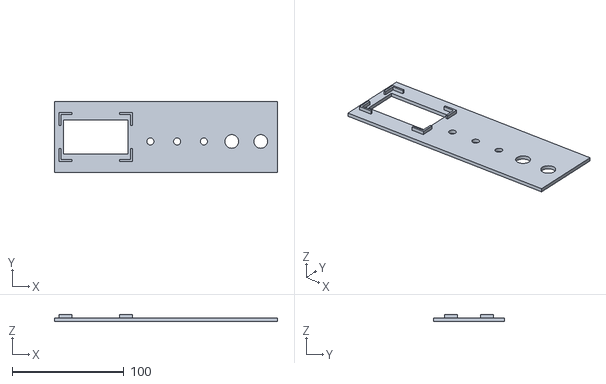
[picture p21: CAD file, 2026-10-28]
hardware/stl/dash_pod_panel_test.stl
200.0 x 64.0 x 6.00
