gamer927/rav4/hardware/beavis_shifter/SwitchSpacer.stl

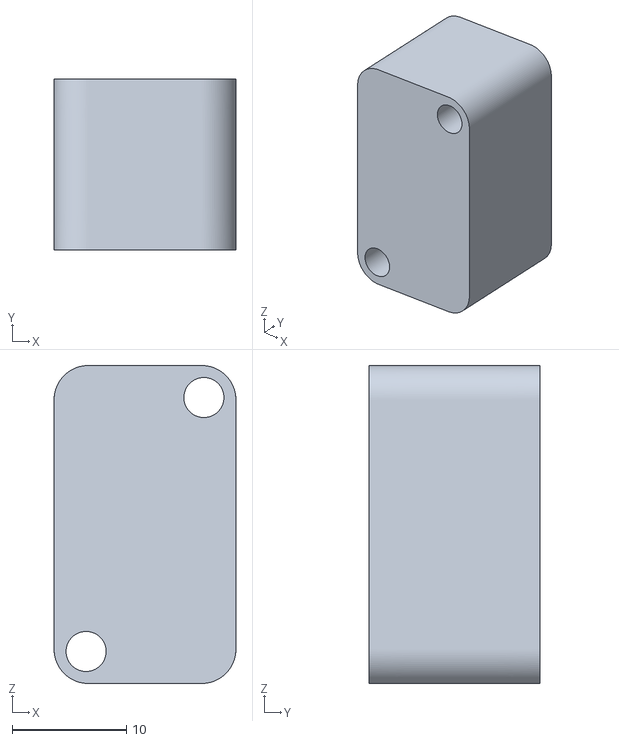
[picture p22: CAD file, 2026-10-27]
hardware/beavis_shifter/SwitchSpacer.stl
15.9 x 15.0 x 27.8
