gamer927/rav4/hardware/stl/shifter_base_box.stl

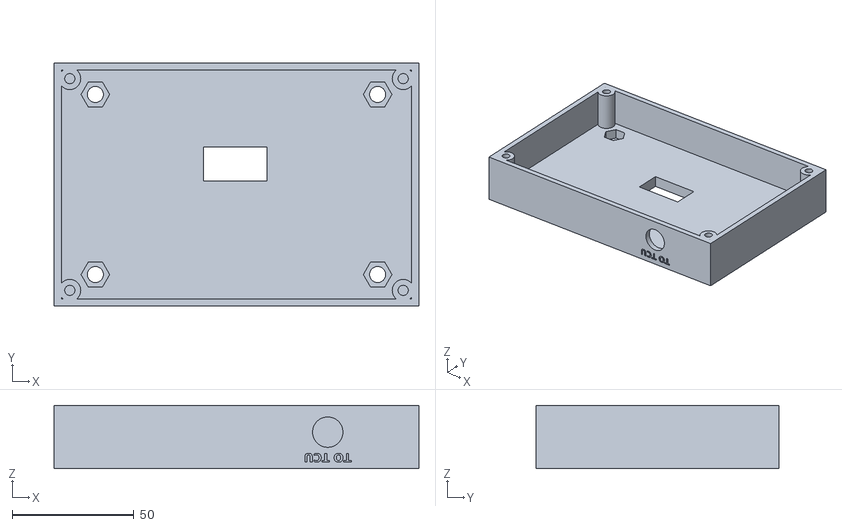
[picture p23: CAD file, 2026-10-28]
hardware/stl/shifter_base_box.stl
150.0 x 100.0 x 26.0
