gamer927/rav4/hardware/beavis_shifter/PivotPin.stl

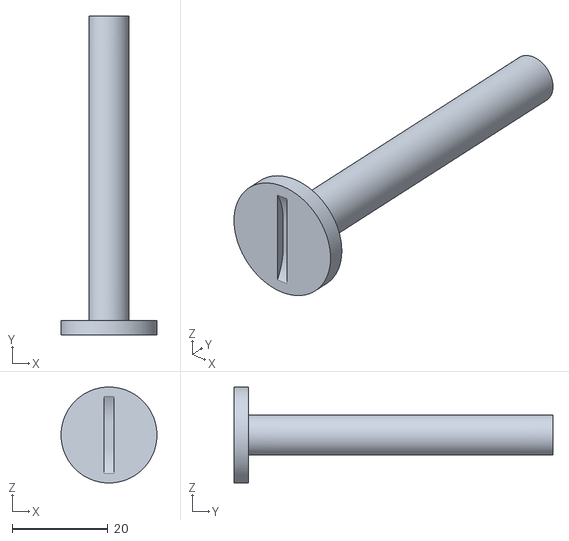
[picture p24: CAD file, 2026-10-27]
hardware/beavis_shifter/PivotPin.stl
20.0 x 66.5 x 20.0
