gamer927/rav4/hardware/stl/dash_pod_mount.stl

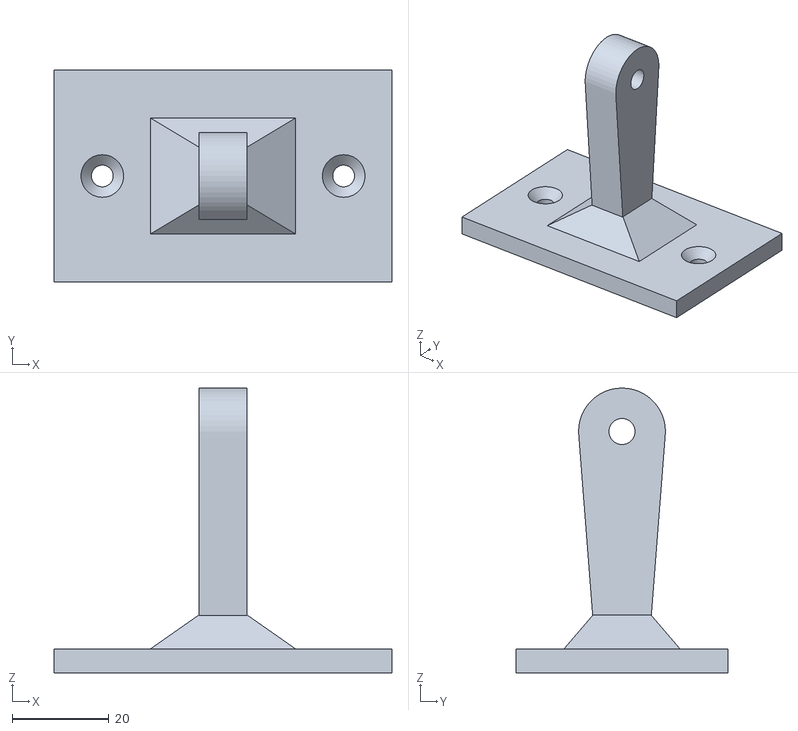
[picture p25: CAD file, 2026-10-28]
hardware/stl/dash_pod_mount.stl
70.0 x 44.0 x 59.0
