gamer927/rav4/hardware/stl/dash_pod_shell.stl

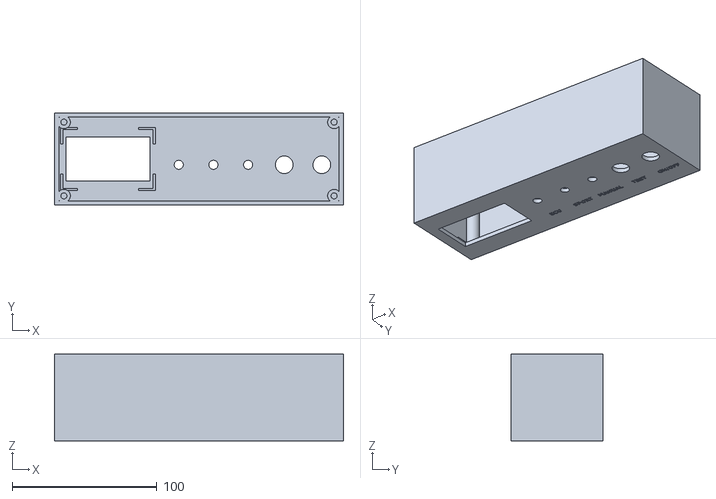
[picture p26: CAD file, 2026-10-28]
hardware/stl/dash_pod_shell.stl
200.0 x 64.0 x 60.0
