gamer927/rav4/hardware/stl/shifter_base_bottom.stl

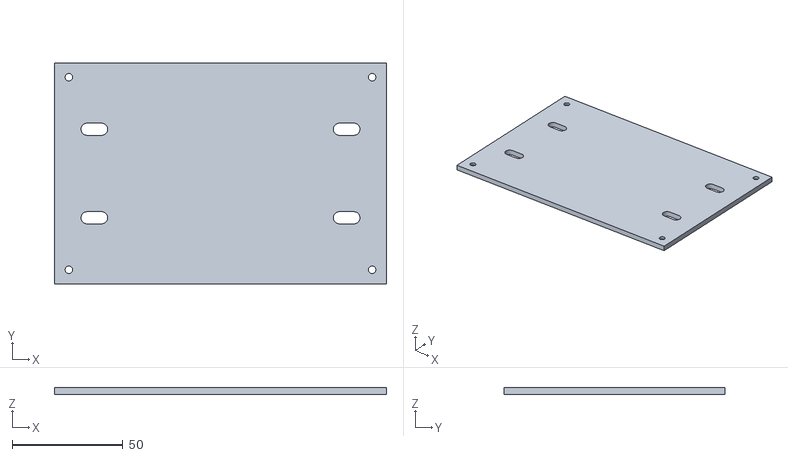
[picture p27: CAD file, 2026-10-28]
hardware/stl/shifter_base_bottom.stl
150.0 x 100.0 x 3.00
