gamer927/rav4/hardware/stl/console_pod_shell.stl

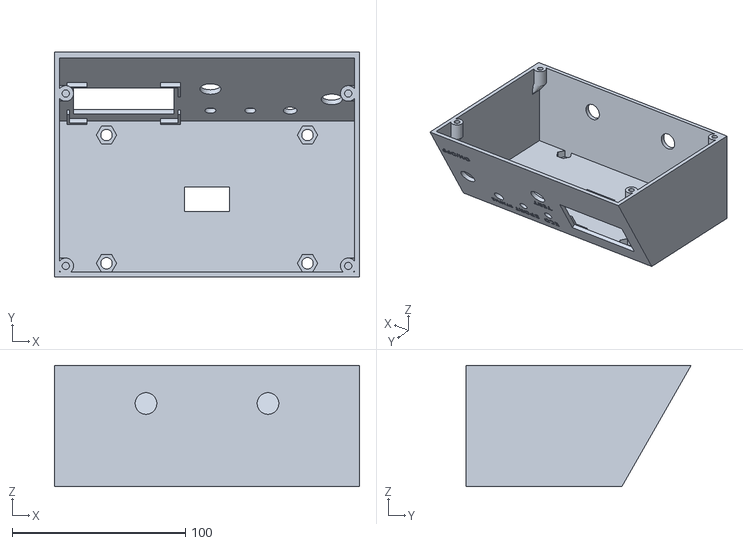
[picture p28: CAD file, 2026-10-27]
hardware/stl/console_pod_shell.stl
176.0 x 130.0 x 70.0
