gamer927/rav4/hardware/stl/console_pod_panel_test.stl

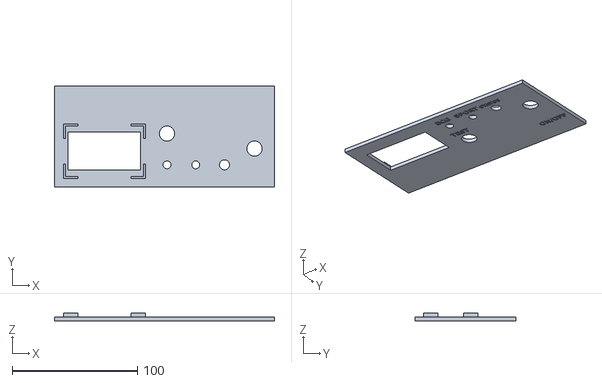
[picture p29: CAD file, 2026-10-27]
hardware/stl/console_pod_panel_test.stl
176.0 x 80.6 x 6.00
