gamer927/rav4/hardware/stl/console_pod_bottom.stl

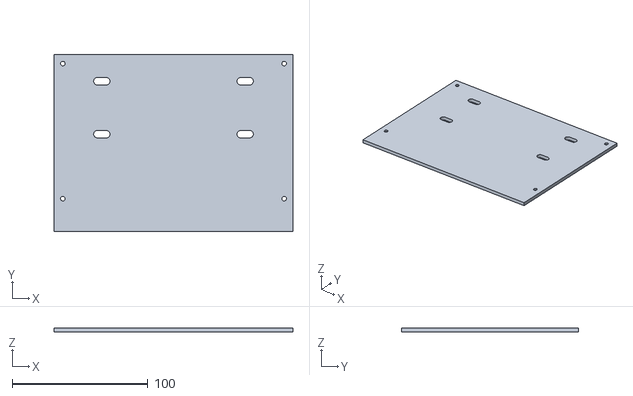
[picture p30: CAD file, 2026-10-27]
hardware/stl/console_pod_bottom.stl
176.0 x 130.0 x 3.00
