gamer927/rav4/hardware/board_envelopes.scad

// SPDX-License-Identifier: CC-BY-NC-SA-4.0
// Copyright (c) 2026 gamer927. RAV4 TCU, https://github.com/gamer927/rav4
// Generated by tools/boards.py - do not edit. Each part: [x0, y0, x1, y1, height]
// in mm, board-local (origin = board's front-left corner, height above the board).
power_board_size = [90, 150];
power_parts = [
    [6.90, 2.36, 11.98, 9.98, 10],  // J1a
    [11.98, 2.36, 17.06, 9.98, 10],  // J1b
    [17.06, 2.36, 22.14, 9.98, 10],  // J1c
    [9.31, 16.83, 14.65, 26.49, 6],  // TVS1
    [16.93, 16.83, 22.27, 26.49, 6],  // D1
    [24.55, 16.83, 29.89, 26.49, 6],  // TVS2
    [9.19, 35.38, 17.31, 43.50, 14],  // C1
    [18.33, 36.14, 20.87, 42.74, 3],  // RB1
    [23.41, 36.14, 25.95, 42.74, 3],  // RB2
    [13.50, 45.79, 20.62, 48.33, 6],  // C2
    [22.01, 48.20, 27.35, 51.00, 3],  // Z1
    [42.97, 125.29, 85.64, 146.63, 15],  // BUCK
    [1.19, 111.83, 10.08, 149.93, 18],  // JA
    [8.04, 82.49, 10.84, 87.83, 3],  // TVS3
    [28.24, 127.07, 33.82, 149.93, 5],  // U1
    [16.30, 144.85, 22.90, 147.39, 3],  // RD1
    [16.30, 139.77, 22.90, 142.31, 3],  // RD2
    [16.30, 134.69, 22.90, 137.23, 3],  // RD3
    [16.30, 129.61, 22.90, 132.15, 3],  // RD4
    [32.30, 17.98, 45.00, 46.81, 15.7],  // K1
    [47.54, 17.98, 60.24, 46.81, 15.7],  // K2
    [62.78, 17.98, 75.48, 46.81, 15.7],  // K3
    [0.30, 57.22, 7.92, 62.30, 10],  // J5a
    [0.30, 62.30, 7.92, 67.38, 10],  // J5b
    [5.38, 71.44, 8.42, 78.56, 11],  // F2
    [79.16, 46.93, 81.96, 52.27, 3],  // DF
    [79.29, 18.36, 81.83, 24.96, 3],  // RK1
    [84.37, 18.36, 86.91, 24.96, 3],  // RK2
    [84.37, 30.80, 86.91, 37.92, 6],  // CK
    [79.16, 34.23, 81.96, 39.57, 3],  // ZK
    [27.22, 2.36, 32.30, 9.98, 10],  // J2a
    [32.30, 2.36, 37.38, 9.98, 10],  // J2b
    [37.38, 2.36, 42.46, 9.98, 10],  // J2c
    [42.46, 2.36, 47.54, 9.98, 10],  // J2d
    [47.54, 2.36, 52.62, 9.98, 10],  // J2e
    [52.62, 2.36, 57.70, 9.98, 10],  // J2f
    [62.78, 2.36, 67.86, 9.98, 10],  // J4a
    [67.86, 2.36, 72.94, 9.98, 10],  // J4b
    [72.94, 2.36, 78.02, 9.98, 10],  // J4c
    [78.02, 2.36, 83.10, 9.98, 10],  // J4d
    [32.30, 53.66, 42.46, 58.24, 19],  // Q1
    [31.03, 61.54, 33.57, 68.14, 3],  // RG1
    [36.11, 61.54, 38.65, 68.14, 3],  // RP1
    [41.06, 62.17, 43.86, 67.51, 3],  // ZG1
    [34.71, 73.60, 40.05, 76.40, 3],  // DF1
    [34.71, 78.68, 40.05, 81.48, 3],  // ZF1
    [31.03, 84.65, 43.73, 115.64, 15],  // CS1
    [47.54, 53.66, 57.70, 58.24, 19],  // Q2
    [46.27, 61.54, 48.81, 68.14, 3],  // RG2
    [51.35, 61.54, 53.89, 68.14, 3],  // RP2
    [56.30, 62.17, 59.10, 67.51, 3],  // ZG2
    [49.95, 73.60, 55.29, 76.40, 3],  // DF2
    [49.95, 78.68, 55.29, 81.48, 3],  // ZF2
    [46.27, 84.65, 58.97, 115.64, 15],  // CS2
    [62.78, 53.66, 72.94, 58.24, 19],  // Q3
    [61.51, 61.54, 64.05, 68.14, 3],  // RG3
    [66.59, 61.54, 69.13, 68.14, 3],  // RP3
    [71.54, 62.17, 74.34, 67.51, 3],  // ZG3
    [65.19, 73.60, 70.53, 76.40, 3],  // DF3
    [65.19, 78.68, 70.53, 81.48, 3],  // ZF3
    [61.51, 84.65, 74.21, 115.64, 15],  // CS3
    [0.30, 49.60, 7.92, 54.68, 10],  // J3a
    [0.30, 44.52, 7.92, 49.60, 10],  // J3b
    [0.30, 39.44, 7.92, 44.52, 10],  // J3c
    [0.30, 34.36, 7.92, 39.44, 10],  // J3d
    [0.30, 29.28, 7.92, 34.36, 10],  // J3e
    [0.30, 24.20, 7.92, 29.28, 10],  // J3f
    [0.30, 19.12, 7.92, 24.20, 10],  // J3g
    [18.08, 53.41, 23.66, 58.49, 5],  // OK1
    [10.71, 53.92, 13.25, 60.52, 3],  // RI1
    [13.50, 53.66, 15.54, 58.24, 2],  // DI1
    [28.49, 53.92, 31.03, 60.52, 3],  // RU1
    [18.08, 66.11, 23.66, 71.19, 5],  // OK2
    [10.71, 66.62, 13.25, 73.22, 3],  // RI2
    [13.50, 66.36, 15.54, 70.94, 2],  // DI2
    [28.49, 66.62, 31.03, 73.22, 3],  // RU2
    [18.08, 78.81, 23.66, 83.89, 5],  // OK3
    [10.71, 79.32, 13.25, 85.92, 3],  // RI3
    [13.50, 79.06, 15.54, 83.64, 2],  // DI3
    [28.49, 79.32, 31.03, 85.92, 3],  // RU3
    [18.08, 91.51, 23.66, 96.59, 5],  // OK4
    [10.71, 92.02, 13.25, 98.62, 3],  // RI4
    [13.50, 91.76, 15.54, 96.34, 2],  // DI4
    [28.49, 92.02, 31.03, 98.62, 3],  // RU4
    [18.08, 104.21, 23.66, 109.29, 5],  // OK5
    [10.71, 104.72, 13.25, 111.32, 3],  // RI5
    [13.50, 104.46, 15.54, 109.04, 2],  // DI5
    [28.49, 104.72, 31.03, 111.32, 3],  // RU5
    [18.08, 116.91, 23.66, 121.99, 5],  // OK6
    [10.71, 117.42, 13.25, 124.02, 3],  // RI6
    [13.50, 117.16, 15.54, 121.74, 2],  // DI6
    [28.49, 117.42, 31.03, 124.02, 3],  // RU6
    [79.04, 106.75, 84.62, 116.91, 5],  // U2
    [76.75, 59.00, 79.29, 65.60, 3],  // RC1
    [79.29, 59.00, 81.83, 65.60, 3],  // RC2
    [81.70, 59.63, 84.50, 64.97, 3],  // Z2
    [84.37, 59.00, 86.91, 65.60, 3],  // RC3
    [86.91, 59.00, 89.45, 65.60, 3],  // RC6
    [76.75, 74.24, 79.29, 80.84, 3],  // RC4
    [79.29, 74.24, 81.83, 80.84, 3],  // RC5
    [81.83, 74.24, 84.37, 80.84, 3],  // RT1
    [84.37, 74.24, 86.91, 80.84, 3],  // RT2
    [86.91, 71.44, 89.45, 78.56, 6],  // C3
    [76.75, 86.68, 79.29, 93.80, 6],  // C4
    [79.54, 89.22, 81.58, 93.80, 2],  // DT1
    [82.08, 89.22, 84.12, 93.80, 2],  // DT2
    [84.62, 89.22, 86.66, 93.80, 2],  // DT3
    [87.16, 89.22, 89.20, 93.80, 2],  // DT4
];
power_terminals = [  // [name, x0, y0, x1, y1, height]
    ["J1", 6.90, 2.36, 22.14, 9.98, 10],
    ["J2", 27.22, 2.36, 57.70, 9.98, 10],
    ["J3", 0.30, 19.12, 7.92, 54.68, 10],
    ["J4", 62.78, 2.36, 83.10, 9.98, 10],
    ["J5", 0.30, 57.22, 7.92, 67.38, 10],
    ["JA", 1.19, 111.83, 10.08, 149.93, 18],
];
logic_board_size = [90, 70];
logic_parts = [
    [1.82, 0.46, 6.90, 8.08, 10],  // X7a
    [6.90, 0.46, 11.98, 8.08, 10],  // X7b
    [11.98, 0.46, 17.06, 8.08, 10],  // X7c
    [17.06, 0.46, 22.14, 8.08, 10],  // X4a
    [22.14, 0.46, 27.22, 8.08, 10],  // X4b
    [27.22, 0.46, 32.30, 8.08, 10],  // X4c
    [32.30, 0.46, 37.38, 8.08, 10],  // X4d
    [37.38, 0.46, 42.46, 8.08, 10],  // X4e
    [42.46, 0.46, 47.54, 8.08, 10],  // X4f
    [52.62, 0.46, 57.70, 8.08, 10],  // X5a
    [57.70, 0.46, 62.78, 8.08, 10],  // X5b
    [62.78, 0.46, 67.86, 8.08, 10],  // X5c
    [67.86, 0.46, 72.94, 8.08, 10],  // X5d
    [72.94, 0.46, 78.02, 8.08, 10],  // X6a
    [78.02, 0.46, 83.10, 8.08, 10],  // X6b
    [83.10, 0.46, 88.18, 8.08, 10],  // X6c
    [3.09, 57.22, 28.49, 66.12, 18],  // JB
    [3.09, 13.92, 5.63, 20.52, 3],  // RU1
    [5.63, 26.62, 8.17, 33.22, 3],  // RS1
    [3.09, 36.52, 5.63, 43.64, 6],  // CF1
    [5.88, 41.60, 7.92, 46.18, 2],  // DH1
    [3.34, 49.22, 5.38, 53.80, 2],  // DL1
    [8.17, 13.92, 10.71, 20.52, 3],  // RU2
    [10.71, 26.62, 13.25, 33.22, 3],  // RS2
    [8.17, 36.52, 10.71, 43.64, 6],  // CF2
    [10.96, 41.60, 13.00, 46.18, 2],  // DH2
    [8.42, 49.22, 10.46, 53.80, 2],  // DL2
    [18.33, 13.92, 20.87, 20.52, 3],  // RU3
    [20.87, 26.62, 23.41, 33.22, 3],  // RS3
    [18.33, 36.52, 20.87, 43.64, 6],  // CF3
    [21.12, 41.60, 23.16, 46.18, 2],  // DH3
    [18.58, 49.22, 20.62, 53.80, 2],  // DL3
    [23.41, 13.92, 25.95, 20.52, 3],  // RU4
    [25.95, 26.62, 28.49, 33.22, 3],  // RS4
    [23.41, 36.52, 25.95, 43.64, 6],  // CF4
    [26.20, 41.60, 28.24, 46.18, 2],  // DH4
    [23.66, 49.22, 25.70, 53.80, 2],  // DL4
    [28.49, 13.92, 31.03, 20.52, 3],  // RU5
    [31.03, 26.62, 33.57, 33.22, 3],  // RS5
    [28.49, 36.52, 31.03, 43.64, 6],  // CF5
    [31.28, 41.60, 33.32, 46.18, 2],  // DH5
    [28.74, 49.22, 30.78, 53.80, 2],  // DL5
    [33.57, 13.92, 36.11, 20.52, 3],  // RU6
    [36.11, 26.62, 38.65, 33.22, 3],  // RS6
    [33.57, 36.52, 36.11, 43.64, 6],  // CF6
    [36.36, 41.60, 38.40, 46.18, 2],  // DH6
    [33.82, 49.22, 35.86, 53.80, 2],  // DL6
    [38.65, 13.92, 41.19, 20.52, 3],  // RU7
    [41.19, 26.62, 43.73, 33.22, 3],  // RS7
    [38.65, 36.52, 41.19, 43.64, 6],  // CF7
    [41.44, 41.60, 43.48, 46.18, 2],  // DH7
    [38.90, 49.22, 40.94, 53.80, 2],  // DL7
    [74.21, 16.46, 76.75, 23.06, 3],  // RA1
    [79.29, 16.46, 81.83, 23.06, 3],  // RA2
    [84.24, 17.09, 87.04, 22.43, 3],  // ZA
    [53.64, 31.19, 74.72, 47.19, 7],  // GYRO
];
logic_terminals = [  // [name, x0, y0, x1, y1, height]
    ["JB", 3.09, 57.22, 28.49, 66.12, 18],
    ["X4", 17.06, 0.46, 47.54, 8.08, 10],
    ["X5", 52.62, 0.46, 72.94, 8.08, 10],
    ["X6", 72.94, 0.46, 88.18, 8.08, 10],
    ["X7", 1.82, 0.46, 17.06, 8.08, 10],
];
