gamer927/rav4/hardware/pcb_envelope.scad

// Generated by tools/pcb.py - do not edit.
// Board mm: origin at the front-left corner, y towards the back; part heights above the board.
pcb_size = [200.0, 170.0];
pcb_outline = [[0.00, 0.00], [200.00, 0.00], [200.00, 170.00], [17.78, 170.00], [17.78, 115.25], [0.00, 115.25]];
pcb_holes = [[3.50, 18.00], [196.50, 18.00], [196.50, 166.50], [10.00, 108.00], [110.00, 166.50]];
pcb_mega_at = [2.54, 115.25];
pcb_standoff_h = 18.6;
pcb_parts = [  // [ref, x0, y0, x1, y1, height]
    ["RP3", 167.38, 66.24, 170.44, 78.54, 3.0],
    ["DI1", 63.50, 16.71, 66.05, 26.47, 2.5],
    ["X4", 17.70, 1.32, 46.75, 9.97, 11.0],
    ["RT2", 65.78, 86.56, 68.83, 98.86, 3.0],
    ["RG2", 144.53, 66.24, 147.57, 78.54, 3.0],
    ["TVS1", 100.00, 15.91, 105.75, 34.90, 5.8],
    ["RU15", 27.69, 16.71, 30.73, 29.01, 3.0],
    ["DF1", 136.81, 65.94, 140.06, 78.84, 3.2],
    ["RA1", 44.19, 16.71, 47.25, 29.01, 3.0],
    ["RI6", 105.60, 144.20, 117.91, 147.25, 3.0],
    ["CS3", 168.75, 117.50, 184.31, 157.15, 15.0],
    ["F2", 101.34, 75.97, 109.40, 81.51, 13.5],
    ["RG1", 125.47, 66.24, 128.53, 78.54, 3.0],
    ["RI1", 58.17, 16.71, 61.22, 29.01, 3.0],
    ["ZF3", 178.72, 65.94, 181.97, 78.84, 3.2],
    ["RT1", 58.17, 86.56, 61.22, 98.86, 3.0],
    ["RI5", 105.60, 128.97, 117.91, 132.01, 3.0],
    ["RS6", 35.31, 34.49, 38.36, 46.79, 3.0],
    ["RS1", 9.91, 34.49, 12.95, 46.79, 3.0],
    ["RU11", 7.37, 16.71, 10.41, 29.01, 3.0],
    ["ZG3", 171.09, 65.94, 174.34, 78.84, 3.2],
    ["Q1", 128.07, 85.09, 138.62, 106.09, 8.0],
    ["CF1", 7.37, 53.53, 10.41, 60.69, 8.0],
    ["ZG1", 133.00, 65.94, 136.25, 78.84, 3.2],
    ["OK6", 119.18, 145.42, 129.78, 151.12, 9.0],
    ["RU16", 32.77, 16.71, 35.81, 29.01, 3.0],
    ["CF7", 37.84, 53.53, 40.89, 60.69, 8.0],
    ["Q2", 147.12, 85.09, 157.68, 106.09, 8.0],
    ["RK1", 101.34, 86.56, 104.40, 98.86, 3.0],
    ["RC6", 86.10, 54.81, 89.16, 67.12, 3.0],
    ["RU6", 105.60, 154.37, 117.91, 157.41, 3.0],
    ["RC1", 70.86, 54.81, 73.92, 67.12, 3.0],
    ["RU14", 22.61, 16.71, 25.66, 29.01, 3.0],
    ["DF", 110.38, 77.12, 123.29, 80.37, 3.2],
    ["Z1", 116.49, 55.78, 119.74, 68.69, 3.2],
    ["K2", 147.09, 34.19, 160.13, 63.53, 15.7],
    ["K1", 128.03, 34.19, 141.09, 63.53, 15.7],
    ["C6", 121.01, 46.10, 127.87, 52.96, 12.5],
    ["CF3", 17.53, 53.53, 20.58, 60.69, 8.0],
    ["RS4", 25.14, 34.49, 28.19, 46.79, 3.0],
    ["OK2", 72.19, 39.06, 82.78, 44.75, 9.0],
    ["RU13", 17.53, 16.71, 20.58, 29.01, 3.0],
    ["J3", 92.71, 1.32, 118.25, 9.97, 11.0],
    ["RK2", 105.16, 86.56, 108.21, 98.86, 3.0],
    ["OK1", 58.22, 39.06, 68.81, 44.75, 9.0],
    ["OK5", 119.18, 130.18, 129.78, 135.88, 9.0],
    ["RI4", 105.60, 113.72, 117.91, 116.78, 3.0],
    ["RS7", 40.39, 34.49, 43.44, 46.79, 3.0],
    ["X6", 74.20, 1.32, 85.75, 9.97, 11.0],
    ["RU3", 96.26, 16.71, 99.31, 29.01, 3.0],
    ["J2", 145.44, 1.22, 176.97, 12.09, 11.0],
    ["Z2", 78.38, 54.50, 81.63, 67.41, 3.2],
    ["TVS3", 119.84, 16.31, 124.00, 29.41, 4.1],
    ["C2", 111.50, 56.07, 114.56, 63.22, 8.0],
    ["CF4", 22.61, 53.53, 25.66, 60.69, 8.0],
    ["Q3", 166.18, 85.09, 176.72, 106.09, 8.0],
    ["C7", 121.66, 56.07, 124.72, 63.22, 8.0],
    ["ZA", 51.72, 16.41, 54.97, 29.31, 3.2],
    ["DI5", 105.60, 134.30, 115.38, 136.84, 2.5],
    ["U2", 58.22, 65.75, 68.81, 76.50, 9.0],
    ["RU12", 12.45, 16.71, 15.50, 29.01, 3.0],
    ["DI2", 77.47, 16.71, 80.01, 26.47, 2.5],
    ["RC4", 89.91, 54.81, 92.97, 67.12, 3.0],
    ["ZF1", 140.62, 65.94, 143.87, 78.84, 3.2],
    ["RU17", 37.84, 16.71, 40.89, 29.01, 3.0],
    ["RU2", 82.29, 16.71, 85.34, 29.01, 3.0],
    ["ZG2", 152.04, 65.94, 155.29, 78.84, 3.2],
    ["D1", 106.34, 15.91, 112.09, 34.90, 5.8],
    ["RG3", 163.57, 66.24, 166.62, 78.54, 3.0],
    ["GYRO", 28.70, 85.68, 50.06, 103.97, 7.0],
    ["J4", 177.93, 1.22, 199.29, 12.09, 11.0],
    ["C4", 81.03, 86.56, 84.07, 93.70, 8.0],
    ["RA2", 48.00, 16.71, 51.06, 29.01, 3.0],
    ["RC2", 74.67, 54.81, 77.72, 67.12, 3.0],
    ["DF3", 174.91, 65.94, 178.16, 78.84, 3.2],
    ["TVS2", 112.69, 15.91, 118.44, 34.90, 5.8],
    ["CK", 112.78, 86.56, 115.82, 93.70, 8.0],
    ["RU1", 68.33, 16.71, 71.38, 29.01, 3.0],
    ["ZF2", 159.66, 65.94, 162.91, 78.84, 3.2],
    ["RC5", 93.72, 54.81, 96.78, 67.12, 3.0],
    ["X7", 1.20, 1.32, 12.76, 9.97, 11.0],
    ["K3", 166.13, 34.19, 179.19, 63.53, 15.7],
    ["ZK", 108.87, 86.25, 112.12, 99.17, 3.2],
    ["U1", 185.22, 131.47, 195.81, 154.93, 9.0],
    ["RS2", 14.98, 34.49, 18.03, 46.79, 3.0],
    ["RI2", 72.14, 16.71, 75.19, 29.01, 3.0],
    ["CF6", 32.77, 53.53, 35.81, 60.69, 8.0],
    ["CS1", 130.66, 117.50, 146.21, 157.15, 15.0],
    ["OK3", 86.16, 39.06, 96.75, 44.75, 9.0],
    ["RU4", 105.60, 123.89, 117.91, 126.94, 3.0],
    ["U3", 98.12, 44.03, 110.16, 53.07, 18.0],
    ["X5", 49.70, 1.32, 64.75, 9.97, 11.0],
    ["CF2", 12.45, 53.53, 15.50, 60.69, 8.0],
    ["DF2", 155.85, 65.94, 159.10, 78.84, 3.2],
    ["OK4", 119.18, 114.94, 129.78, 120.64, 9.0],
    ["J1", 126.71, 1.22, 143.00, 12.09, 11.0],
    ["RU5", 105.60, 139.12, 117.91, 142.18, 3.0],
    ["CF5", 27.69, 53.53, 30.73, 60.69, 8.0],
    ["RP2", 148.34, 66.24, 151.38, 78.54, 3.0],
    ["RP1", 129.28, 66.24, 132.34, 78.54, 3.0],
    ["RS5", 30.22, 34.49, 33.28, 46.79, 3.0],
    ["RI3", 86.10, 16.71, 89.16, 29.01, 3.0],
    ["DI6", 105.60, 149.53, 115.38, 152.08, 2.5],
    ["RC3", 82.29, 54.81, 85.34, 67.12, 3.0],
    ["DI4", 105.60, 119.06, 115.38, 121.61, 2.5],
    ["CS2", 149.71, 117.50, 165.25, 157.15, 15.0],
    ["DI3", 91.44, 16.71, 93.99, 26.47, 2.5],
    ["RS3", 20.06, 34.49, 23.11, 46.79, 3.0],
    ["C3", 73.41, 86.56, 76.45, 93.70, 8.0],
    ["C1", 111.78, 45.25, 120.32, 53.81, 16.0],
    ["RB1", 101.34, 56.07, 104.40, 68.38, 3.0],
    ["RB2", 106.43, 56.07, 109.47, 68.38, 3.0],
];
pcb_terminals = [  // [gland, pad x first, pad x last, front of the body y]
    ["SHIFT", 3.48, 10.48, 1.32],
    ["DASH", 19.98, 44.48, 1.32],
    ["SCREEN", 51.98, 62.48, 1.32],
    ["ATF", 76.48, 83.48, 1.32],
    ["SIG", 94.98, 115.98, 1.32],
    ["PWR", 129.77, 139.93, 1.22],
    ["SOL", 148.51, 173.91, 1.22],
    ["LOAD", 180.99, 196.23, 1.22],
];
