gamer927/rav4/docs/05-build-book.md

# Build book: 1999 RAV4 transmission controller

<!-- Generated by tools/pcb.py from tools/build_book_template.md. Edit the template, then run
     python3 tools/pcb.py -->

**Use it like a Lego book.** Do one small step at a time, in order. Each step has a picture, a
list of what you need, and boxes to tick.

Lots of steps end with a **✅ CHECK**. **Don't move on until the check passes.** A mistake
caught straight away takes a minute to fix. Caught at the end, it takes a whole weekend.

You don't need to understand electronics. If you can match a picture to a board, use a
multimeter and solder, you can build this.

| Part | What you do | How long |
|---|---|---|
| [0](#part-0--look-at-the-car) | Look at the car and measure. Nothing gets cut. | 1 evening |
| [1](#part-1--buy-the-parts) | Buy the parts | 1 evening + delivery |
| [2](#part-2--start-printing) | Start the 3D prints (they print while you solder) | about 45 h of printing |
| [3](#part-3--get-ready) | Set up the table, sort the parts into bags | 1 hour |
| [4](#part-4--solder-the-board-steps-1-to-3) | Solder the board: power, relays, solenoid drivers | 2 evenings |
| [5](#part-5--solder-the-board-steps-4-and-5) | Solder the board: the inputs | 1 evening |
| [6](#part-6--the-mega) | Solder the Mega's pins and plug it in | 1 hour |
| [7](#part-7--screen) | Wire the screen | 1 hour |
| [8](#part-8--dash-pod-and-shifter-base) | Build the dash pod and the shifter base | 1 evening |
| [9](#part-9--dummy-loads) | Bolt the 3 big resistors to the heatsink | 30 min |
| [10](#part-10--test-everything-on-the-bench) | Test everything on the table | 1 evening |
| [11](#part-11--close-the-box) | Put it all in the box | 1 evening |
| [12](#part-12--put-it-in-the-car) | Put it in the car | 4 evenings, one job each |
| [13](#part-13--calibrate-and-drive) | Teach it your car, then test drive in 4 stages | 2 evenings + a week of normal driving |

---

## Before you start

### Words you'll see

| Word | What it means |
|---|---|
| **TCU** | This project: the box that can shift the transmission. |
| **Engine computer (ECM)** | The car's own computer, under the dash. It normally shifts the transmission. It stays in the car, untouched. |
| **Solenoid** | An electric valve inside the transmission. Three of them (called **S1, S2, SL**) choose the gear. These are the only 3 car wires that get cut. |
| **Mega** | The Arduino Mega: the little computer inside the TCU box. |
| **The board** | The TCU's printed circuit board. Every part's name and value are printed where it goes (like **RU11 2.2k**); the parts push through the holes and get soldered underneath. All the wiring between them is already on the board. |
| **Screw terminal** | A small block where a wire is held by a screw. Each position's name (like **SOL1** or **ECO**) is printed on the board behind it. |
| **Ground (GND)** | The minus (−) side of the 12 V. On a meter, the black probe goes on ground. |
| **12 V / 5 V** | Voltages. 12 V is the car battery. 5 V is what the Mega runs on. |
| **Relay** | A switch moved by a magnet. It clicks when it gets power. |
| **Resistor** | A small part with coloured stripes. The stripes tell you its value. Each step lists the colours to look for. |
| **Diode** | A small part that only works one way round. **The end with the stripe matters.** |
| **Chip** | A black part with legs. It has a **notch or dot at one end**: match it to the picture. |
| **Module** | A small ready-made board with its own pins. It plugs into the board like a part (the gyro, and the three current sensors). |
| **Socket** | A holder for a chip. You solder the socket in, then push the chip into it: the chip never gets hot, and it can be swapped. |
| **Gland** | The round plastic fitting a cable goes through in the box wall. Tighten it and it grips the cable. |
| **Insert** | A small brass nut you press into the plastic with the hot soldering iron. Screws then go into it. |

### Four skills

**1. The multimeter.** You only need two settings.
- **Beep** (the setting with a speaker symbol). Touch the two probes to two points. A beep
  means they are connected.
- **Volts DC** (V with a straight line). Put the black probe on ground and the red probe on
  the point you're measuring.

**2. Soldering a part.**
1. Push the legs through the holes.
2. Turn the board over. Bend the legs out a little so the part can't fall out.
3. Touch the iron to the leg **and** the copper ring around it, together, for 2 seconds.
4. Feed in solder until it flows around the leg like a little volcano.
5. Take the solder away first, then the iron.
6. Snip the leg off just above the joint.

**3. Soldering a wire** (to the screen's pins, the dash pod switches, the car's wires).
1. Slide a piece of heat-shrink onto the wire first, out of the way.
2. Strip 4 mm of plastic off the end. Twist the strands.
3. Melt a little solder into the strands.
4. Hold the wire against the pin, and touch the iron to both. They join.
5. Slide the heat-shrink over the joint and warm it with the heat gun until it grips.

**4. A screw terminal.** Strip 6 mm off the wire and twist the strands (no solder: it loosens
under a screw). Open the screw, push the wire in all the way, tighten firmly. **Tug it**: it
mustn't come out, and no bare copper shows outside the terminal.

### If a check fails

1. **Stop.** Don't go on to the next step.
2. Compare the board with the picture, part by part. Is anything in the wrong holes, or the
   wrong way round (diodes, chips, the big capacitor)?
3. Look at the underside under a bright light. Look for a **blob of solder joining two pads
   that shouldn't touch**. This is the most common fault. Heat it and drag the iron away to
   split it.
4. Look for a joint that looks dull or lumpy, or a leg with no solder. Reheat it.
5. Do the check again.

### Stay safe

- **Disconnect the car battery's negative (−) terminal before every job on the car.**
- The iron is hot: put it back in its stand every time.
- Wear glasses when snipping legs. Snipped legs fly.

---

## Part 0 — Look at the car

Nothing gets cut or changed today. You're finding things and writing them down.

**You need:** a multimeter, a tape measure, a pen, your phone (for photos), and the factory
repair manual and wiring diagram for your car (search for "1999 RAV4 repair manual" and
"1999 RAV4 EWD").

- [ ] **Transmission code.** Find the metal ID plate on the transmission. Write down the code. On
  a 4WD it's A241H or A540H.
- [ ] **Fuse size.** Pull one fuse out of the fuse box inside the car. Is it a **standard** or a
  **mini** fuse? Write it down.
- [ ] **A key-ON fuse.** Find a fuse that only has power when the key is ON. Check it with the
  meter: about 12 V with the key ON, 0 V with the key OFF. Write down which fuse it is.
- [ ] **Cooler hose size.** At the radiator, find the two transmission cooler hoses
  ([where they are](03-wiring-guide.md#the-atf-temperature-probe)). Measure the rubber hose's
  inside size: **5/16"** or **3/8"**.
- [ ] **Which hose is hot.** Start the cold engine and wait 2 minutes. Feel both hoses. The one
  that warms up first is the **hot hose**. Put a piece of tape on it.
- [ ] **A spot for the TCU box.** Kneel in the passenger footwell and look up under the dash,
  below the glovebox. You need:
  - a metal spot to bolt to (the dash frame, or somewhere to hang a steel bracket)
  - room for a box **216 × 212 × 51 mm** (244 mm wide with its mounting ears)
  - about 10 cm of free space in front of it for the cables
  - nothing in the way of the passenger's knees or the heater ducts

  No room? Take the glovebox out and look behind it instead.
  ([Why this spot](03-wiring-guide.md#where-the-tcu-box-goes).)
- [ ] **A spot for the heatsink** (100 × 100 × 25 mm) near the box, where air moves.
- [ ] **A spot for the dash pod** (200 × 64 × 64 mm) on the **dash top, driver's side**. Sit in
  the driver's seat. You must be able to see it without it blocking the road or the gauges.
  **Never put it over the passenger airbag** (the right-hand half of the dash top).
- [ ] **Room for the shifter base** (150 × 100 mm) on the centre console, next to the gear
  lever, long side pointing front-to-back. With the shifter on top it stands about **35 cm
  tall**: check it clears the dash and the radio. Move your hand through where the lever will
  swing: it mustn't hit the gear lever, handbrake, cup holder or your knee.
- [ ] **The engine computer's wires.** Find the engine computer (the repair manual's "location
  of components" page). For each wire below, do its meter test from
  [wiring guide §5](03-wiring-guide.md) and fill in the table. **Don't cut anything.** Take
  photos.

| Signal | What it is | Terminal | Wire colour | Test OK? |
|---|---|---|---|---|
| S1 | Solenoid 1 | | | ☐ |
| S2 | Solenoid 2 | | | ☐ |
| SL | Lockup solenoid | | | ☐ |
| SPD | Speed | | | ☐ |
| TAC | Engine rpm | | | ☐ |
| VTA | Gas pedal | | | ☐ |
| E2 | Gas pedal sensor ground | | | ☐ |
| E1 | Engine computer ground | | | ☐ |
| STP | Brake light | | | ☐ |
| D | Gear lever in D | | | ☐ |

✅ **CHECK:** every box ticked.
**If not:** stop here. Work out why before you buy anything. Every later step depends on
these wires being the right ones.

---

## Part 1 — Buy the parts

- [ ] **Order the circuit board first** (it takes 1–2 weeks to arrive). Upload
  [`hardware/pcb/rav4-tcu-gerbers.zip`](../hardware/pcb/rav4-tcu-gerbers.zip) to a board maker
  such as JLCPCB or PCBWay. Choose: **2 layers, 1.6 mm thick, 1 oz copper, lead-free HASL**, any
  colour, quantity **5** (the minimum). About $20–40 for five, with shipping. Details:
  [hardware/pcb/README.md](../hardware/pcb/README.md).
- [ ] Open the [shopping list](04-shopping-list.md) (about $625 of parts).
- [ ] Pick the brass tee that matches **your hose size**, and the fuse tap that matches **your
  fuse size** (both from part 0).
- [ ] Order the small electronic parts from **DigiKey or Mouser**.
- [ ] Order the modules and kits from **Amazon** (or AliExpress: cheaper but slower).
- [ ] Get the rest at a **hardware store** and an **auto-parts store**.

✅ **CHECK:** as boxes arrive, tick off each line of the shopping list.

---

## Part 2 — Start printing

The prints take a long time, so start them first. They can print while you solder parts 4
to 7.

**Use PETG or ASA plastic. Never PLA**: it goes soft in a hot car.
Printer settings: 0.2 mm layers, 4 walls, 30–40 % infill, no supports.
(More detail: [hardware/README.md](../hardware/README.md).)

The files are in `hardware/stl/`.

- [ ] **First, the test panel**: `dash_pod_panel_test.stl` (about 1 hour). It's a flat copy of
  the dash pod's front. When your switches and screen arrive, push each one into its hole. If
  one is too tight, the hole size can be changed in `hardware/dash_pod.scad` before you print
  the real pod.
- [ ] TCU box: `tcu_enclosure_box.stl` (about 12 h). If your printer bed is only 220 mm, print
  `tcu_enclosure_box_no_ears.stl` instead.
- [ ] TCU lid: `tcu_enclosure_lid.stl` (about 4 h).
- [ ] Dash pod: `dash_pod_shell.stl` (about 7 h, front face down on the bed).
- [ ] Dash pod back cover: `dash_pod_back.stl` (about 2 h).
- [ ] Dash pod mount: `dash_pod_mount.stl` (about 1 h).
- [ ] Shifter base: `shifter_base_box.stl` (about 5 h, upside down on the bed).
- [ ] Shifter base bottom plate: `shifter_base_bottom.stl` (about 2 h).
- [ ] The shifter's own parts, from [`hardware/beavis_shifter/`](../hardware/beavis_shifter/README.md)
  (designed by bbeavis; about 1.5 days of printing):
  - `MainBody.stl` and `ShifterShaft.stl`, with 3 walls and about 50 % infill
  - `SwitchSpacer.stl`, **4 times**
  - if you want them: `PivotPin.stl`, `PivotCap.stl`, `Knob.stl`
  - skip `BottomCover.stl`
  - use PETG, not the PLA its designer used

The printed parts

✅ **CHECK:** each print lies flat on the table without rocking.
**If not:** it warped. Print it again with the bed a little hotter, or a brim turned on.

---

## Part 3 — Get ready

- [ ] Clear a table. Lay out: soldering iron (set to about 330 °C), solder, flux, wire cutters,
  wire strippers, multimeter, hot-glue gun.
- [ ] **Make your bench power lead:** 12 V adapter → the screw-terminal plug → a **5 A fuse** on
  the + wire. Every test on the table goes through this fuse.
- [ ] **Look over the bare board** under a bright light. Everything is printed on it: each part's
  name and value (like **RU11 2.2k** or **DI1 1N4148**) on or beside its outline, a stripe where a
  diode's stripe goes, a notch where a chip's notch goes, a **+** for the big capacitors, and the
  name of every screw terminal and every Mega pin the TCU uses. Check it against the picture at
  the start of part 4: the outline, the cut-away back-left corner and the 5 mounting holes.
- [ ] **Sort the parts into bags.** One bag per step. Write the step name on each bag. Then
  every step starts with "open the bag":

- [ ] **Bag 1** (step 1, Power in): 1× 3-way 5.08 mm screw terminal (J1); 2× 1.5KE27A diode; 1× P6KE6.8A diode; 1× 1N5822 diode; 1× 100 µF 50 V capacitor, printed **100u**; 1× R-78HB5.0-0.5 regulator; 1× 47 µF 16 V capacitor, printed **47u**; 2× 100 nF capacitor, printed **100n**; 1× 47k resistor (yellow-violet-black-red-brown); 1× 10k resistor (brown-black-black-red-brown); 1× 1N4733A 5.1 V diode, printed **5V1**
- [ ] **Bag 2** (step 2, Relays and the ON/OFF power pole): 1× ULN2803A chip; 3× G2RL-2 12 V relay; 1× 8-way 3.5 mm screw terminal (X4); 1× PTC 0.25 A resettable fuse; 1× UF4007 diode; 1× 47k resistor (yellow-violet-black-red-brown); 1× 10k resistor (brown-black-black-red-brown); 1× 100 nF capacitor, printed **100n**; 1× 1N4733A 5.1 V diode, printed **5V1**; 1× 18-pin chip socket (for U1)
- [ ] **Bag 3** (step 3, Solenoid drivers and current sensors): 1× 6-way 5.08 mm screw terminal (J2); 1× 4-way 5.08 mm screw terminal (J4); 3× IRF4905 transistor; 3× 4.7k resistor (yellow-violet-black-brown-brown); 3× 10k resistor (brown-black-black-red-brown); 3× 1N4744A 15 V diode, printed **15V**; 3× UF4007 diode; 3× 1N4749A 24 V diode, printed **24V**; 3× ACS712-05B module; 3× M3 × 8 screw and nut (to bolt the transistors' tabs down); 6× 2 cm of stiff wire for the LINK holes (the cut-off legs of step 1's three big diodes are perfect)
- [ ] **Bag 4** (step 4, Car signal inputs): 1× 7-way 3.5 mm screw terminal (J3); 1× LM393 chip; 1× 22k resistor (red-red-black-red-brown); 11× 10k resistor (brown-black-black-red-brown); 1× 1M resistor (brown-black-black-yellow-brown); 1× 1.8k resistor (brown-grey-black-brown-brown); 1× 1N4733A 5.1 V diode, printed **5V1**; 2× 100 nF capacitor, printed **100n**; 6× PC817 chip; 3× 2.2k resistor (red-red-black-brown-brown); 6× 1N4148 diode, printed **4148**; 3× 3.3k resistor (orange-orange-black-brown-brown); 1× 8-pin chip socket (for U2)
- [ ] **Bag 5** (step 5, Dash, shifter, screen and probe inputs): 1× 3-way 3.5 mm screw terminal (X7); 1× 4-way 3.5 mm screw terminal (X5); 1× 3-way 3.5 mm screw terminal (X6); 1× 4.7k resistor (yellow-violet-black-brown-brown); 1× 100 Ω resistor (brown-black-black-black-brown); 1× 1N4733A 5.1 V diode, printed **5V1**; 1× GY-521 module; 7× 2.2k resistor (red-red-black-brown-brown); 7× 10k resistor (brown-black-black-red-brown); 7× 100 nF capacitor, printed **100n**
- [ ] **Bag 6** (step 6, The Mega's pins): 3× male header strip, 40-pin (cut to 8, 8, 8, 10, 8, 8 and two 18s)

✅ **CHECK:** the meter reads about 12 V after the fuse, and every bag is full.
**If a bag is short:** order the missing part now, before you start soldering.

---

## Part 4 — Solder the board (steps 1 to 3)

The finished board

**How it goes, like a Lego manual:** the board goes together in **56 small steps**, each one a
few parts of the same kind. Every small step has a picture:

- **FIND** (left): the part to take out of the bag, drawn as it looks: a resistor with its
  coloured stripes, a diode with its stripe, a chip with its notch. How many, and what's
  printed on the board for it.
- **WHERE** (bottom left): the whole board, with the area of this step boxed.
- **The close-up** (right): where they go. This step's parts are in colour with an **orange
  outline** and their name on an orange tag. Parts you've already fitted are faded. Empty places
  look like the bare board: a white outline with the part's name.

For each small step: push the parts in from the top, matching the picture (and the name and
value printed on the board, like **RU11 2.2k**). Bend the legs out a little underneath so they
stay put. Turn the board over, solder, then snip each leg to **no more than 1.5 mm** (the Mega
sits 11 mm below). Tick the boxes and go on to the next small step. The steps go **lowest
parts first**, so the board lies flat on the table while you solder.

**Before you solder a step,** push all of its parts in first and look: everything sits in its
outline without touching its neighbour. Every part on the shopping list has been checked against
the board at the largest size it's sold in ([part fit report](../hardware/pcb/part_fit.md)), so
if something doesn't fit, it's a different part from the one on the list: check it before you
solder it.

**The board's front edge** is the one with the screw terminals. The **back-left corner** is cut
away: that's where the Mega's USB socket comes up.

**Never solder anything into the Mega's holes** until step 6: the two long rows across the back
and the double row at the back, right of the title (their labels say **5V**, **A0**, **D22**…).

After each step there are two checks:
- **No shorts** (power off, meter on beep): the pairs listed must **not** beep. Put the **red**
  probe on the first one named (the 12V, 5V or signal side) and the **black** on GND: the other
  way round, some meters beep through a protection diode. A short chirp that stops straight away
  is fine (a capacitor filling up); a beep that keeps going is a short: find the solder blob
  before you go on.
- **It works** (bench 12 V on): readings taken at the labelled holes.

**Where to probe:** the Mega's holes the TCU uses are labelled on the board (**5V**, **GND**,
**D6**, **A4** and so on). The screw terminals are labelled too (**12V**, **GND**, **SOL1**…).

### Step 1 — Power in

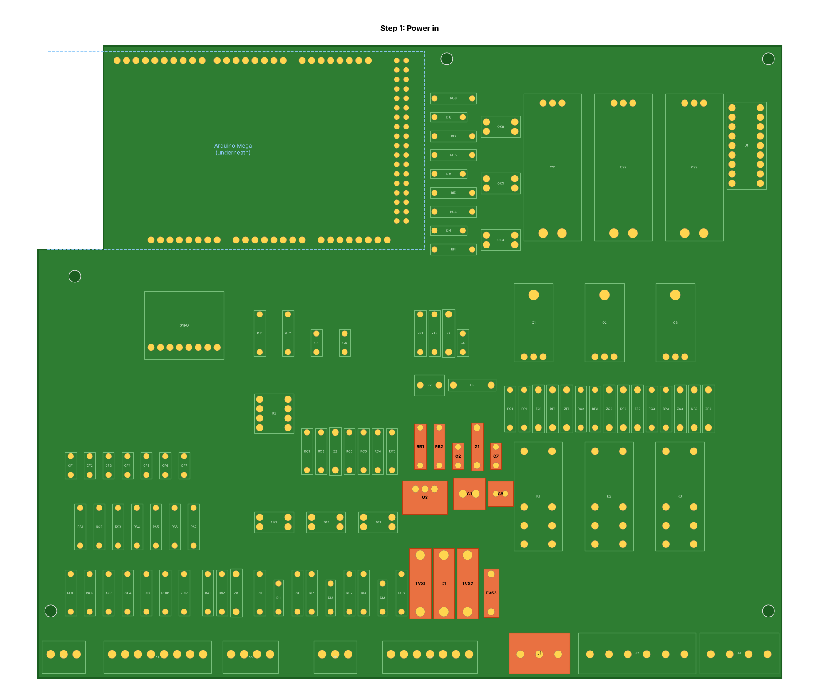
[picture p31: docs/build/pcb-S1.png]
Step 1: everything in this step


*The whole step: 13 parts in 11 small steps. Orange = this step, grey = already in.*

#### 1.1  1× 47k resistor

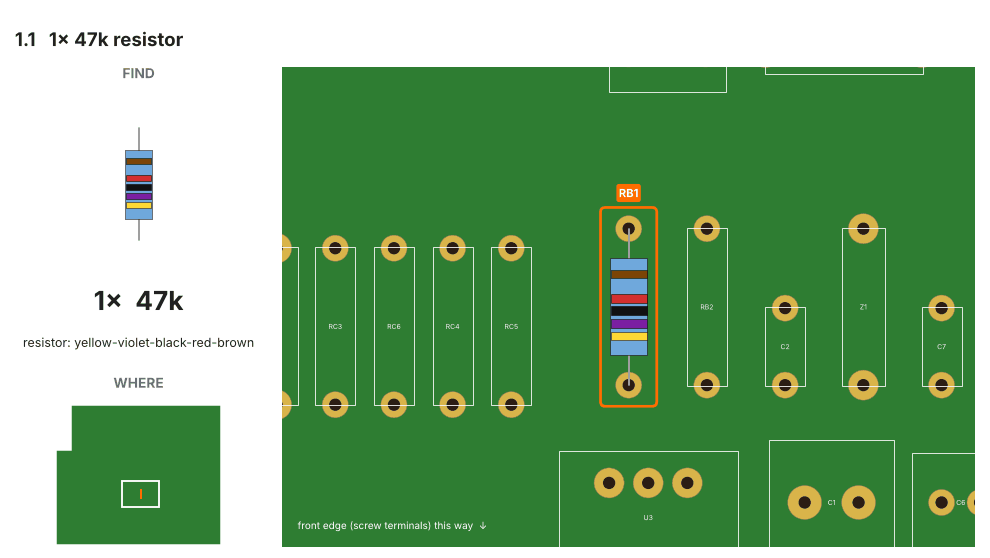
[picture p32: docs/build/pcb-1-1.png]


- [ ] **Where:** **RB1** (printed **47k**), orange in the picture.
- [ ] **Stripes:** yellow-violet-black-red-brown.
- [ ] Solder, then snip the legs to 1.5 mm.

#### 1.2  1× 10k resistor

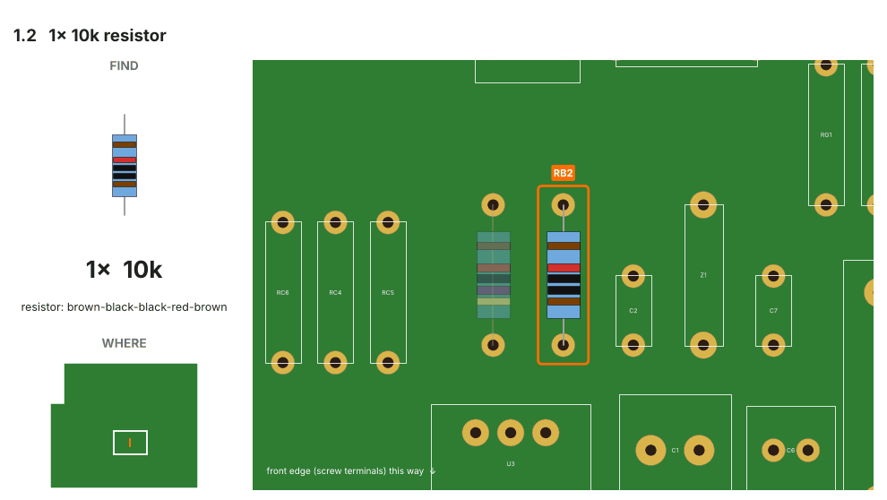
[picture p33: docs/build/pcb-1-2.png]


- [ ] **Where:** **RB2** (printed **10k**), orange in the picture.
- [ ] **Stripes:** brown-black-black-red-brown.
- [ ] Solder, then snip the legs to 1.5 mm.

#### 1.3  2× 1.5KE27A diode

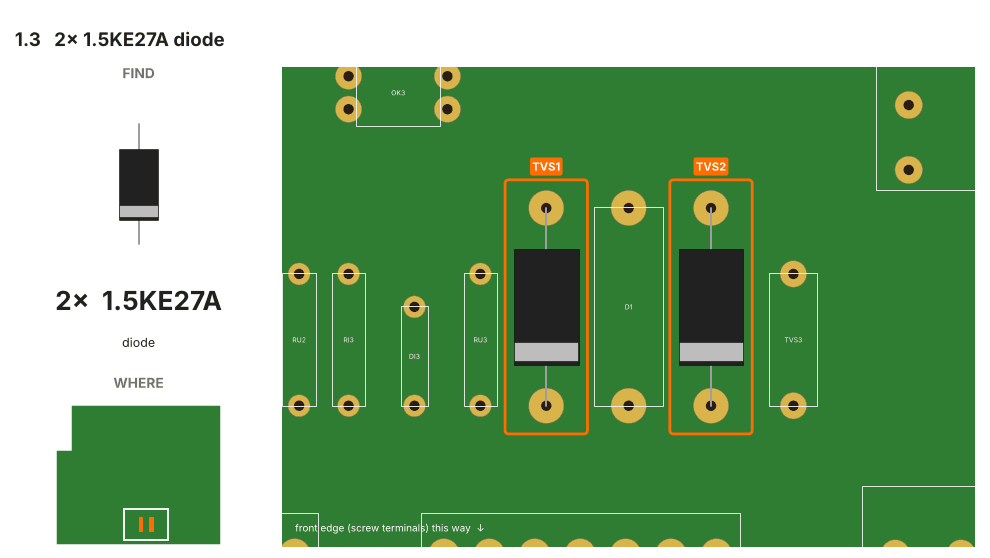
[picture p34: docs/build/pcb-1-3.png]


- [ ] **Where:** **TVS1**, **TVS2** (printed **1.5KE27A**), orange in the picture.
- [ ] **Which way:** Stripe to the end with the stripe printed on the board.
- [ ] Solder, then snip the legs to 1.5 mm.

#### 1.4  1× 1N5822 diode

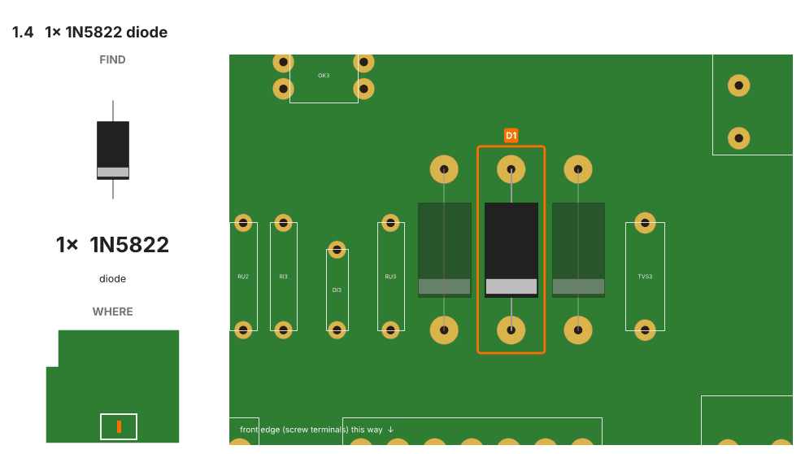
[picture p35: docs/build/pcb-1-4.png]


- [ ] **Where:** **D1** (printed **1N5822**), orange in the picture.
- [ ] **Which way:** Stripe to the end with the stripe printed on the board.
- [ ] Solder, then snip the legs to 1.5 mm.

#### 1.5  1× 1N4733A 5.1 V diode

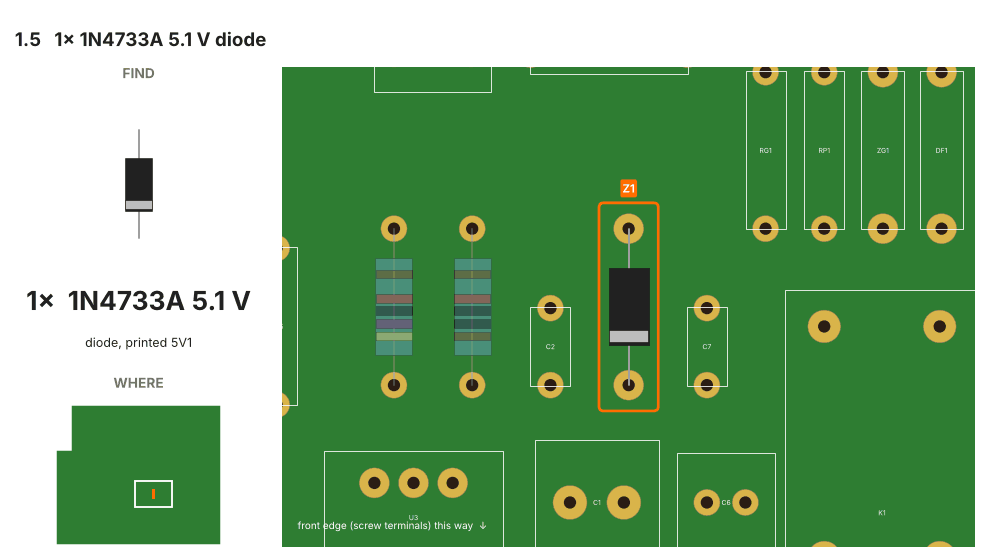
[picture p36: docs/build/pcb-1-5.png]


- [ ] **Where:** **Z1** (printed **5V1**), orange in the picture.
- [ ] **Which way:** Stripe to the end with the stripe printed on the board.
- [ ] Solder, then snip the legs to 1.5 mm.

#### 1.6  1× P6KE6.8A diode

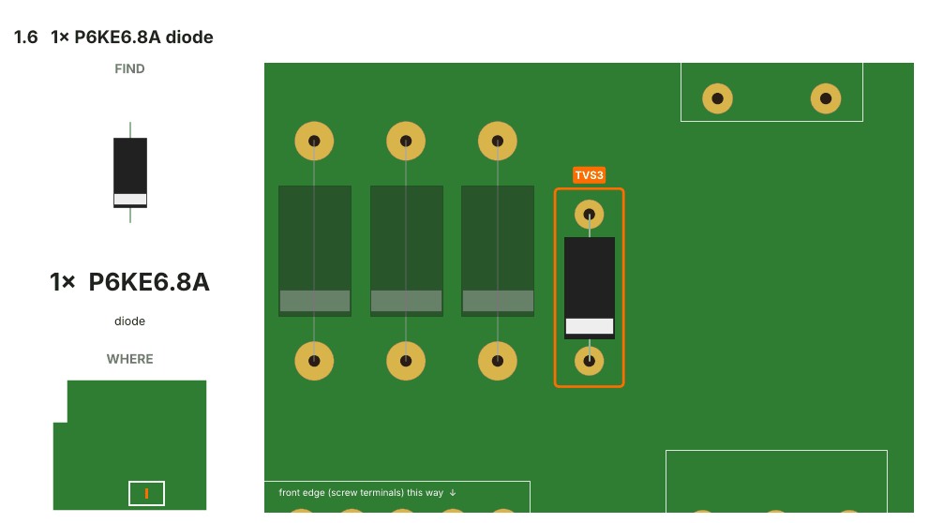
[picture p37: docs/build/pcb-1-6.png]


- [ ] **Where:** **TVS3** (printed **P6KE6.8A**), orange in the picture.
- [ ] **Which way:** Stripe to the end with the stripe printed on the board.
- [ ] Solder, then snip the legs to 1.5 mm.

#### 1.7  2× 100 nF capacitor

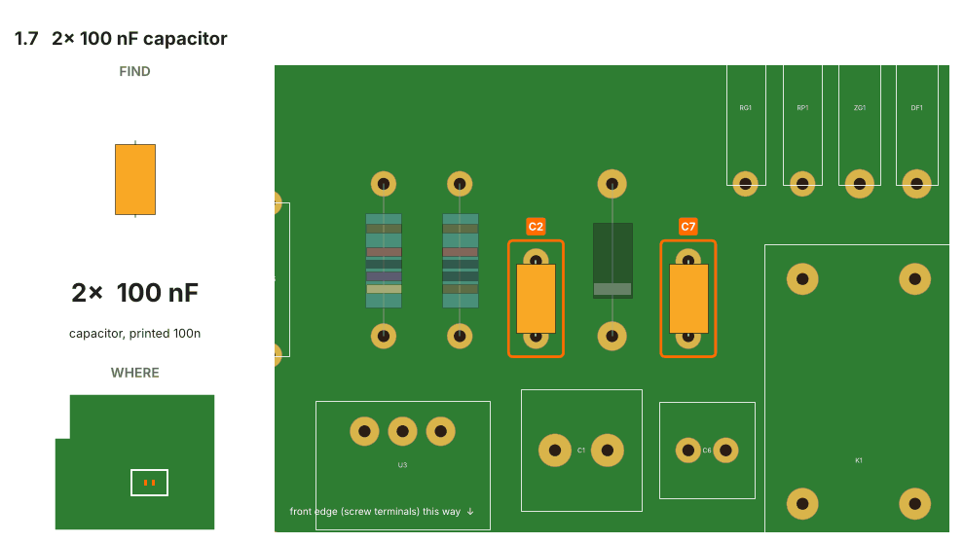
[picture p38: docs/build/pcb-1-7.png]


- [ ] **Where:** **C2**, **C7** (printed **100n**), orange in the picture.
- [ ] Solder, then snip the legs to 1.5 mm.

#### 1.8  1× R-78HB5.0-0.5 5 V regulator

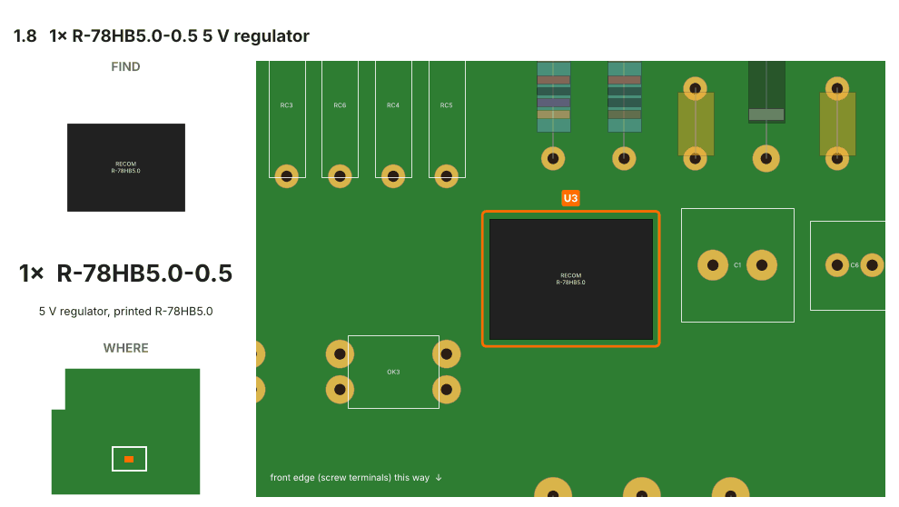
[picture p39: docs/build/pcb-1-8.png]


- [ ] **Where:** **U3**, orange in the picture.
- [ ] **Which way:** The printed side faces the front edge (pin 1, the square pad, on the left).
- [ ] Solder every leg.

#### 1.9  1× 100 µF 50 V capacitor

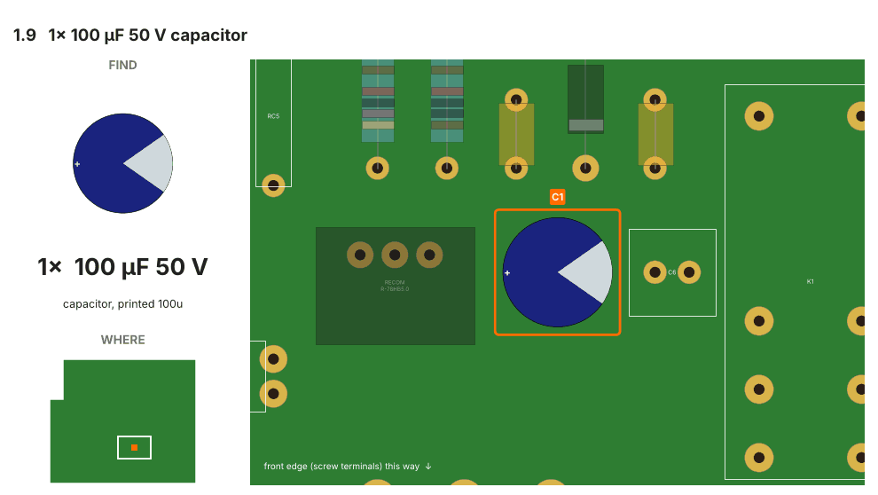
[picture p40: docs/build/pcb-1-9.png]


- [ ] **Where:** **C1** (printed **100u**), orange in the picture.
- [ ] **Which way:** Long leg (+) into the hole marked +; the stripe on the can is the − side.
- [ ] Solder, then snip the legs to 1.5 mm.

#### 1.10  1× 47 µF 16 V capacitor

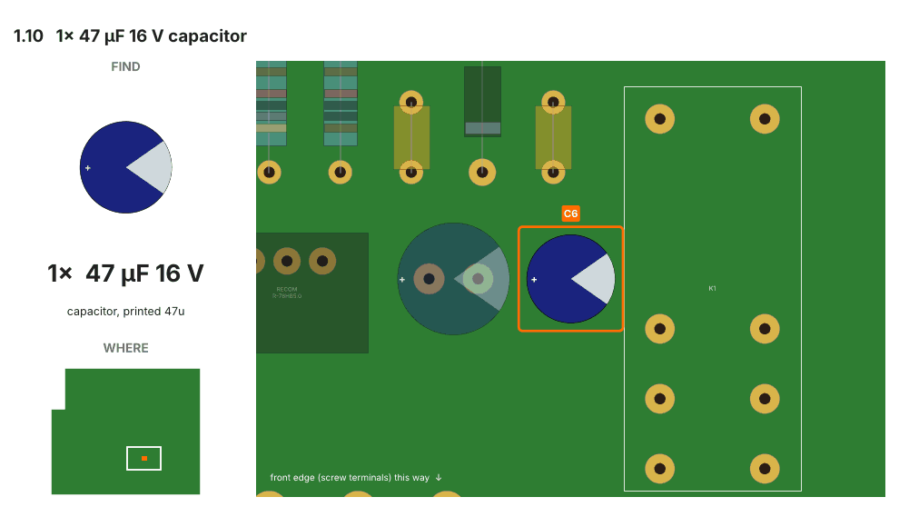
[picture p41: docs/build/pcb-1-10.png]


- [ ] **Where:** **C6** (printed **47u**), orange in the picture.
- [ ] **Which way:** Long leg (+) into the hole marked +; the stripe on the can is the − side.
- [ ] Solder, then snip the legs to 1.5 mm.

#### 1.11  The PWR screw terminal (3-way, 5.08 mm)

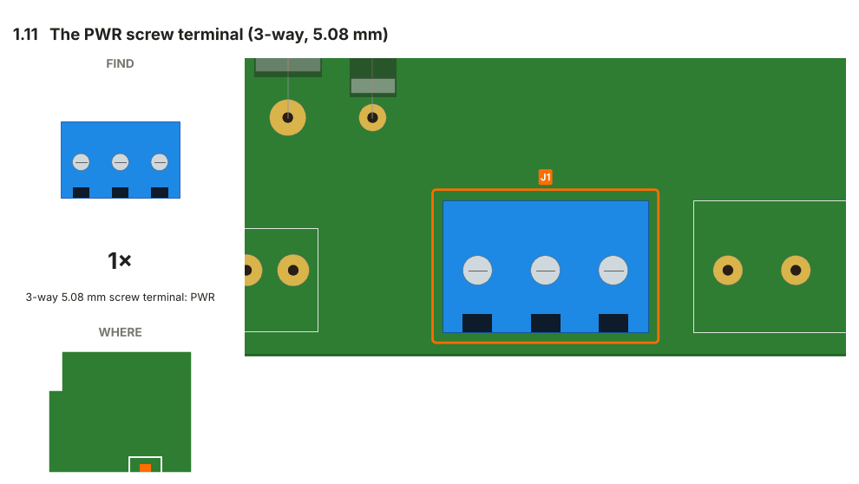
[picture p42: docs/build/pcb-1-11.png]


- [ ] **Where:** **J1**, orange in the picture.
- [ ] **Which way:** Wire openings towards the front edge of the board.
- [ ] Solder every leg.

✅ **CHECK, no shorts** (power off, beep): the first **12V** terminal and **GND**; the second
**12V** terminal and **GND**; the Mega holes **5V** and **GND**.

✅ **CHECK, it works:** bench 12 V **+** to the **second 12V** terminal (the logic feed) and **−**
to **GND**.
- [ ] The Mega holes **5V** to **GND** read **4.8–5.2 V**.
- [ ] Swap the bench wires the wrong way round for one second: **5V** reads **0 V** (the
  wrong-way-round protection works). Put them back.

**If not:** check D1 and the regulator U3 are the right way round.

### Step 2 — Relays and the ON/OFF power pole

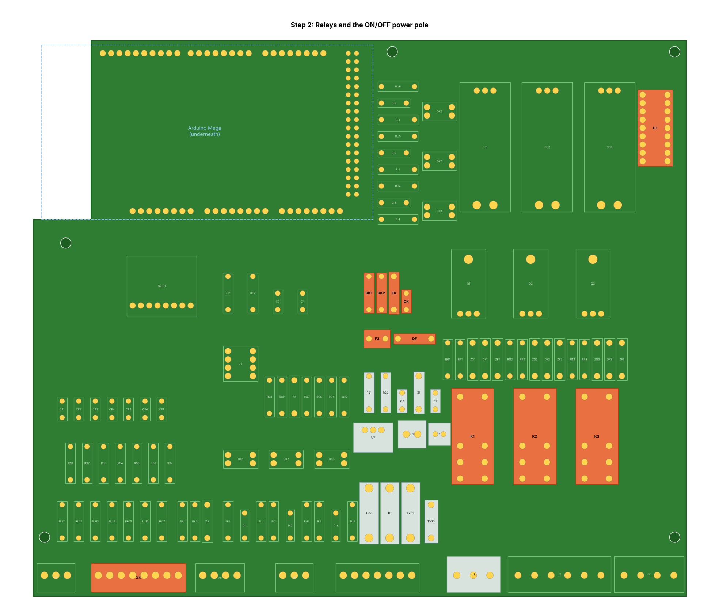
[picture p43: docs/build/pcb-S2.png]
Step 2: everything in this step


*The whole step: 11 parts in 9 small steps. Orange = this step, grey = already in.*

#### 2.1  1× 47k resistor

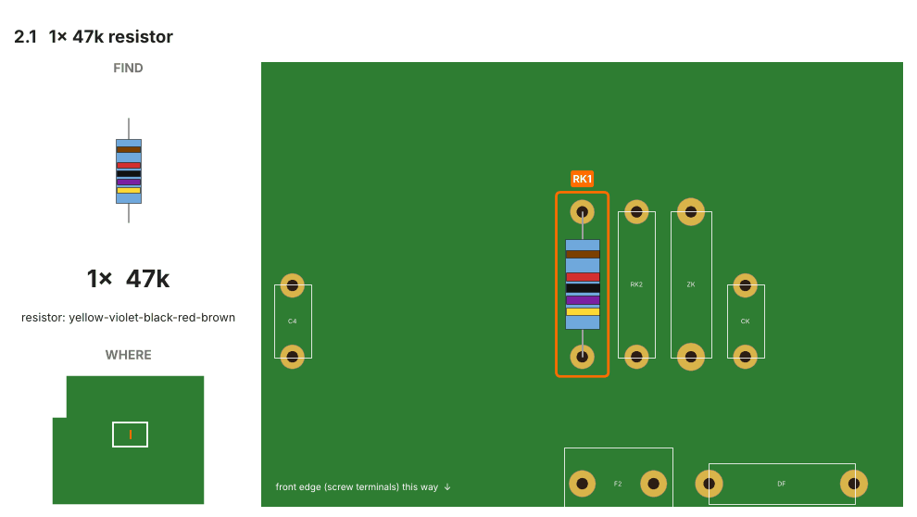
[picture p44: docs/build/pcb-2-1.png]


- [ ] **Where:** **RK1** (printed **47k**), orange in the picture.
- [ ] **Stripes:** yellow-violet-black-red-brown.
- [ ] Solder, then snip the legs to 1.5 mm.

#### 2.2  1× 10k resistor

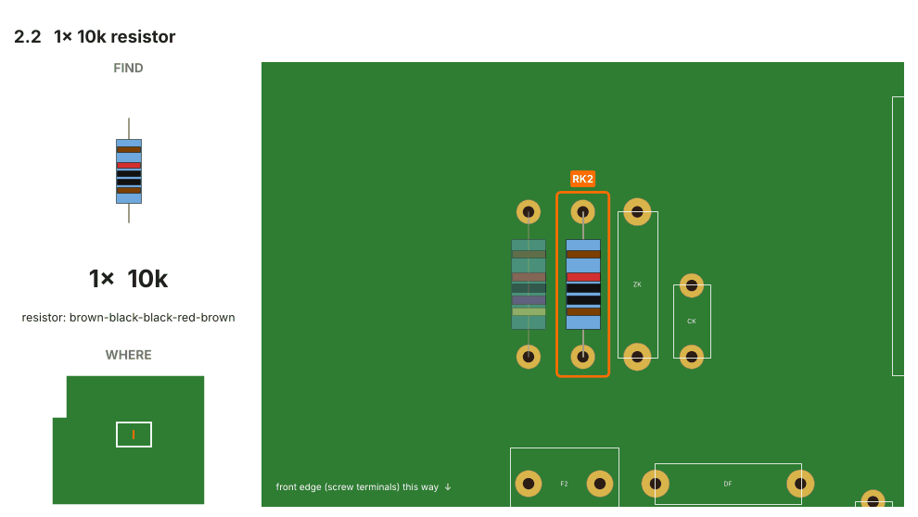
[picture p45: docs/build/pcb-2-2.png]


- [ ] **Where:** **RK2** (printed **10k**), orange in the picture.
- [ ] **Stripes:** brown-black-black-red-brown.
- [ ] Solder, then snip the legs to 1.5 mm.

#### 2.3  1× 1N4733A 5.1 V diode

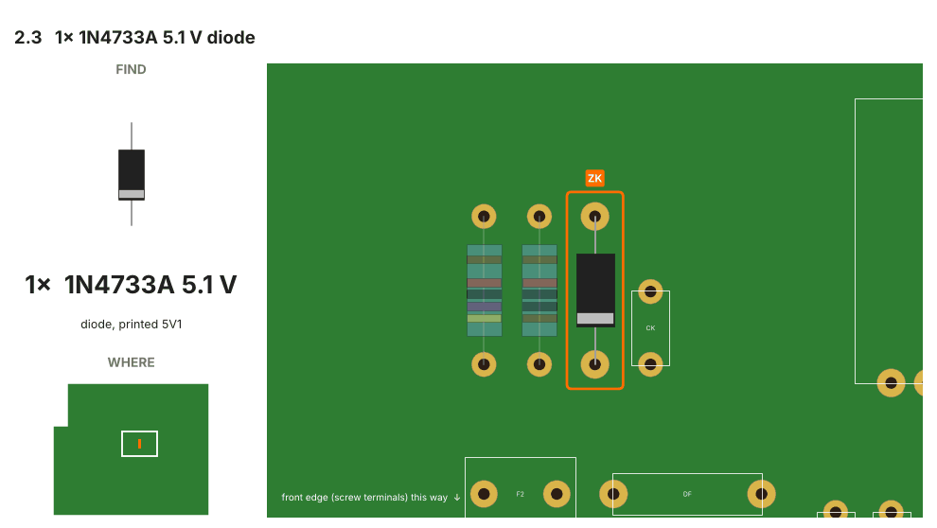
[picture p46: docs/build/pcb-2-3.png]


- [ ] **Where:** **ZK** (printed **5V1**), orange in the picture.
- [ ] **Which way:** Stripe to the end with the stripe printed on the board.
- [ ] Solder, then snip the legs to 1.5 mm.

#### 2.4  1× UF4007 diode

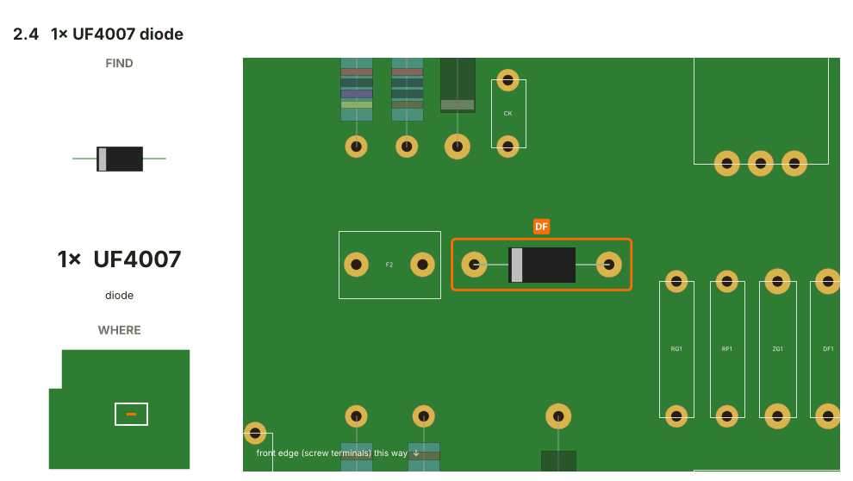
[picture p47: docs/build/pcb-2-4.png]


- [ ] **Where:** **DF** (printed **UF4007**), orange in the picture.
- [ ] **Which way:** Stripe to the end with the stripe printed on the board.
- [ ] Solder, then snip the legs to 1.5 mm.

#### 2.5  1× 100 nF capacitor

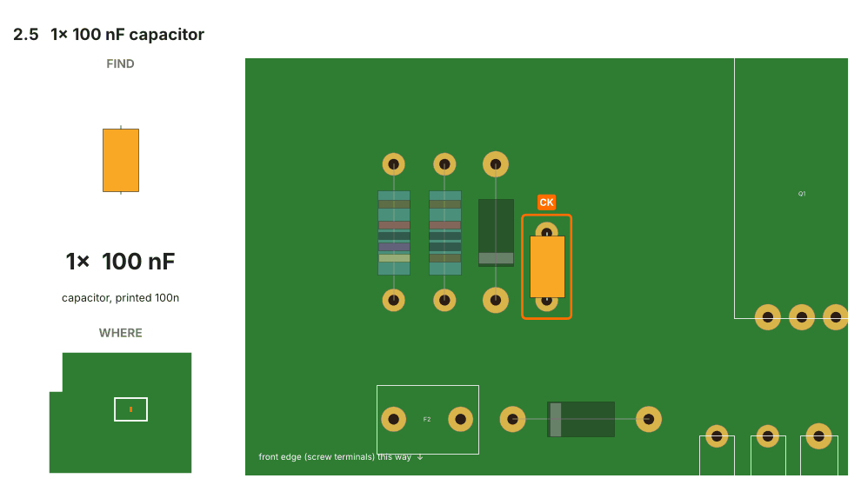
[picture p48: docs/build/pcb-2-5.png]


- [ ] **Where:** **CK** (printed **100n**), orange in the picture.
- [ ] Solder, then snip the legs to 1.5 mm.

#### 2.6  1× PTC 0.25 A resettable fuse

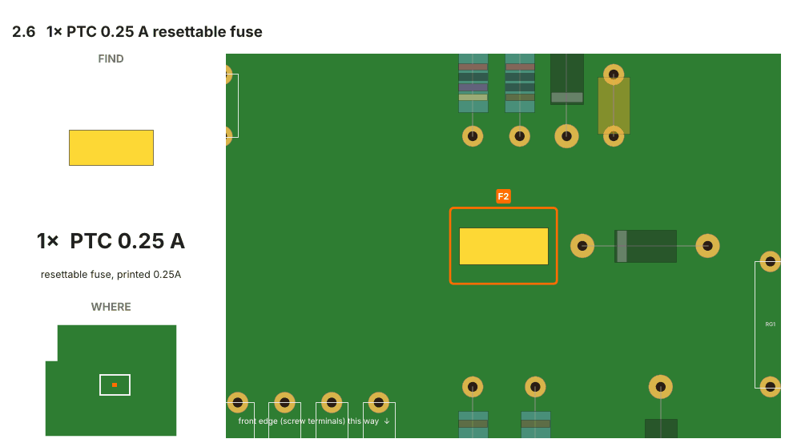
[picture p49: docs/build/pcb-2-6.png]


- [ ] **Where:** **F2** (printed **0.25A**), orange in the picture.
- [ ] **Which way:** Either way round.
- [ ] Solder, then snip the legs to 1.5 mm.

#### 2.7  1× ULN2803A chip

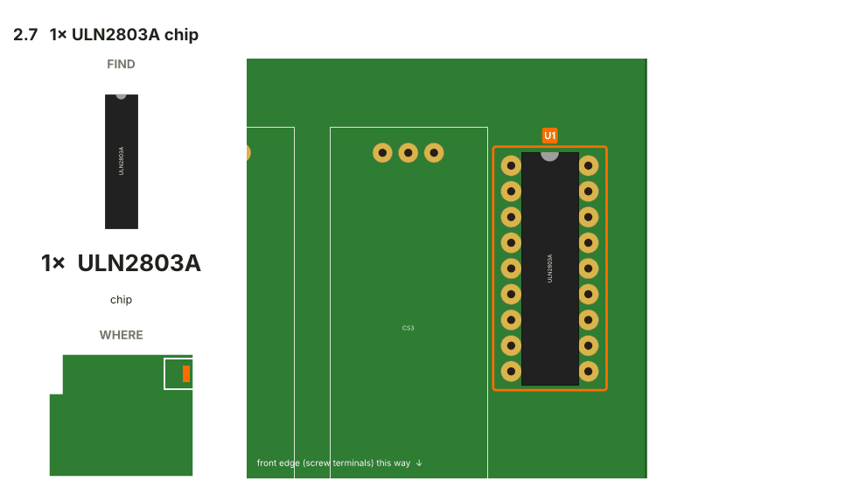
[picture p50: docs/build/pcb-2-7.png]


- [ ] **Where:** **U1**, orange in the picture.
- [ ] **Which way:** Solder its 18-pin socket in, notch to the notch printed on the board. Push the chip into the socket at the end of the step, notch to the notch (bend its legs in a little on the table first if they're splayed).
- [ ] Solder every leg.

#### 2.8  The DASH screw terminal (8-way, 3.5 mm)

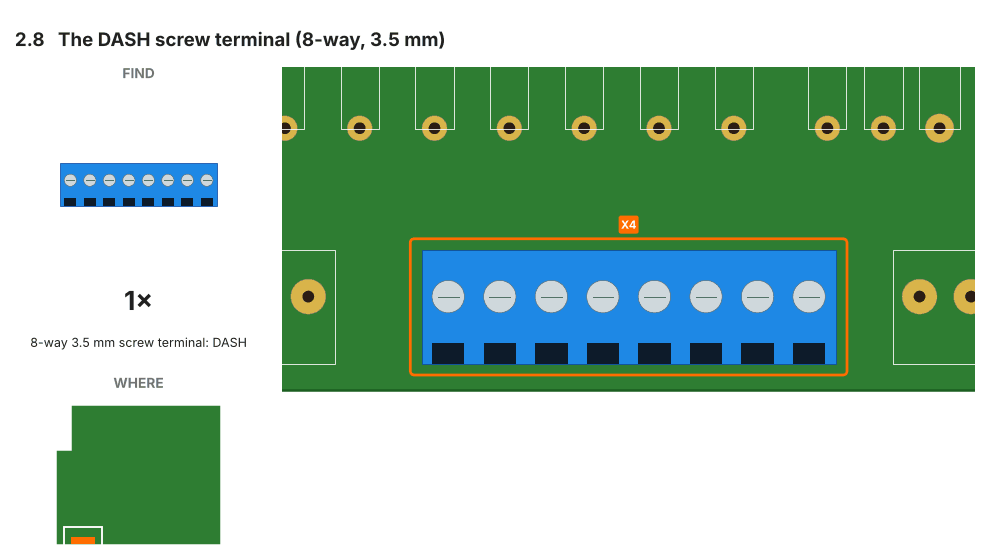
[picture p51: docs/build/pcb-2-8.png]


- [ ] **Where:** **X4**, orange in the picture.
- [ ] **Which way:** Wire openings towards the front edge of the board.
- [ ] Solder every leg.

#### 2.9  3× G2RL-2 12 V relay

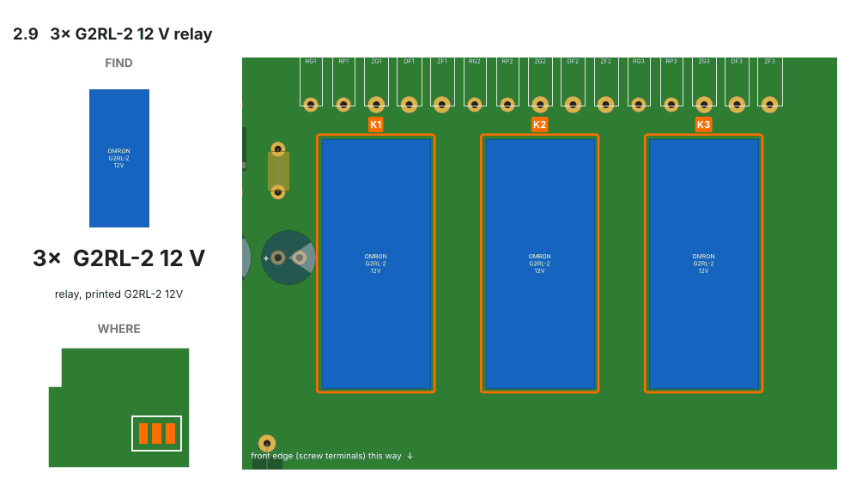
[picture p52: docs/build/pcb-2-9.png]


- [ ] **Where:** **K1**, **K2**, **K3**, orange in the picture.
- [ ] **Which way:** It only fits one way.
- [ ] Solder every leg.

The relays don't get their 12 V directly. It goes out through the **C7** terminal to the
ON/OFF switch on the dash, and comes back on **C8**. So turning ON/OFF off cuts the relays'
power by itself, even if the Mega has frozen. On the table, put a short wire from **C7** to
**C8** to stand in for the switch.

✅ **CHECK, no shorts** (power off, beep): **C8** and **GND**; step 1's pairs again.

✅ **CHECK, it works** (12 V on **both 12V** terminals, **−** on **GND**, C7–C8 wire in):
- [ ] Touch a wire from the Mega hole **5V** to the Mega hole **D6**. All three relays **click**.
  Take the wire away: they click off.
- [ ] Hold 5V to D6 again and pull out the C7–C8 wire: the relays click off.
- [ ] The Mega hole **A7** reads about **2 V** with the C7–C8 wire in, and **0 V** with it out.

**If the relays don't click:** check the chip U1's notch, and that the C7–C8 wire is in.

### Step 3 — Solenoid drivers and current sensors

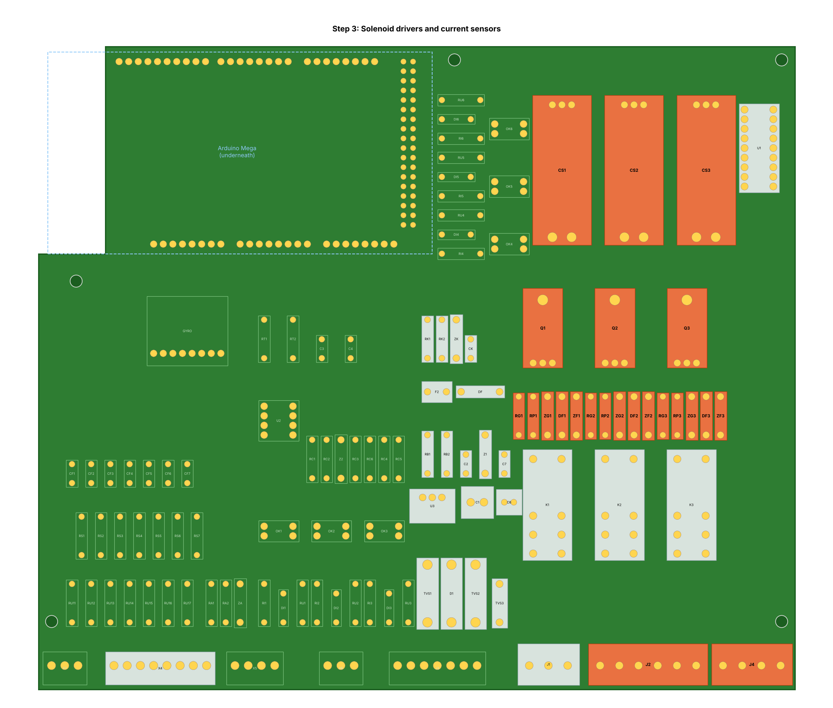
[picture p53: docs/build/pcb-S3.png]
Step 3: everything in this step


*The whole step: 23 parts in 9 small steps. Orange = this step, grey = already in.*

#### 3.1  3× 4.7k resistor

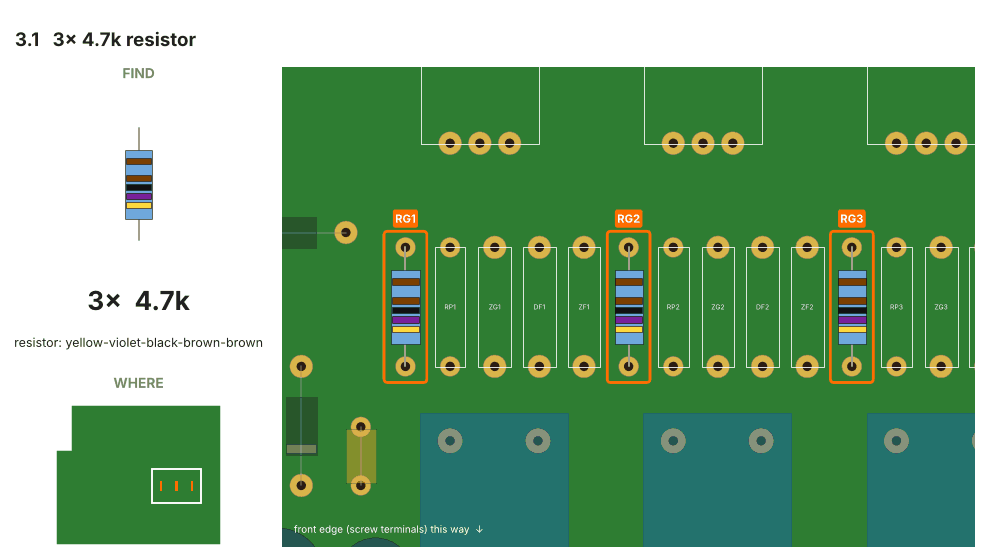
[picture p54: docs/build/pcb-3-1.png]


- [ ] **Where:** **RG1**, **RG2**, **RG3** (printed **4.7k**), orange in the picture.
- [ ] **Stripes:** yellow-violet-black-brown-brown.
- [ ] Solder, then snip the legs to 1.5 mm.

#### 3.2  3× 10k resistor

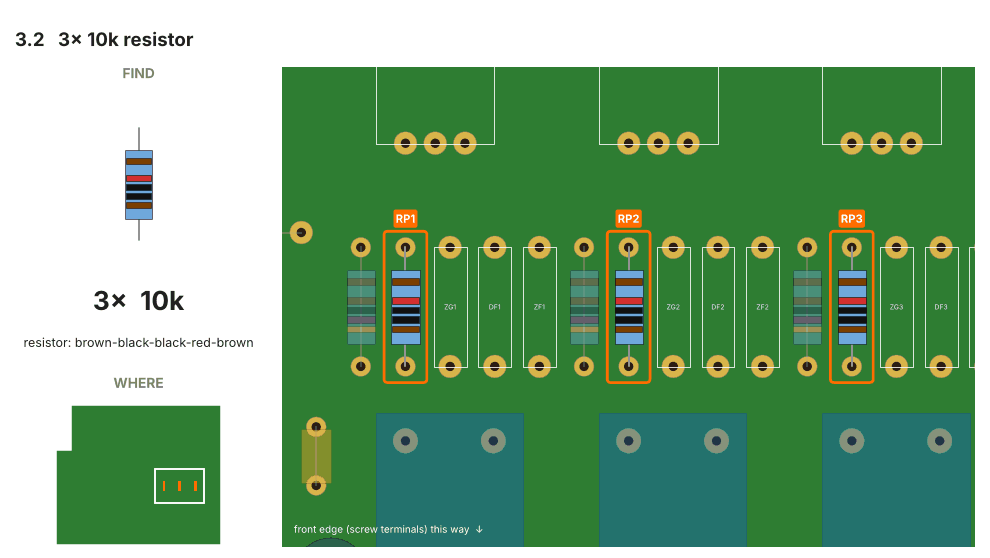
[picture p55: docs/build/pcb-3-2.png]


- [ ] **Where:** **RP1**, **RP2**, **RP3** (printed **10k**), orange in the picture.
- [ ] **Stripes:** brown-black-black-red-brown.
- [ ] Solder, then snip the legs to 1.5 mm.

#### 3.3  3× 1N4744A 15 V diode

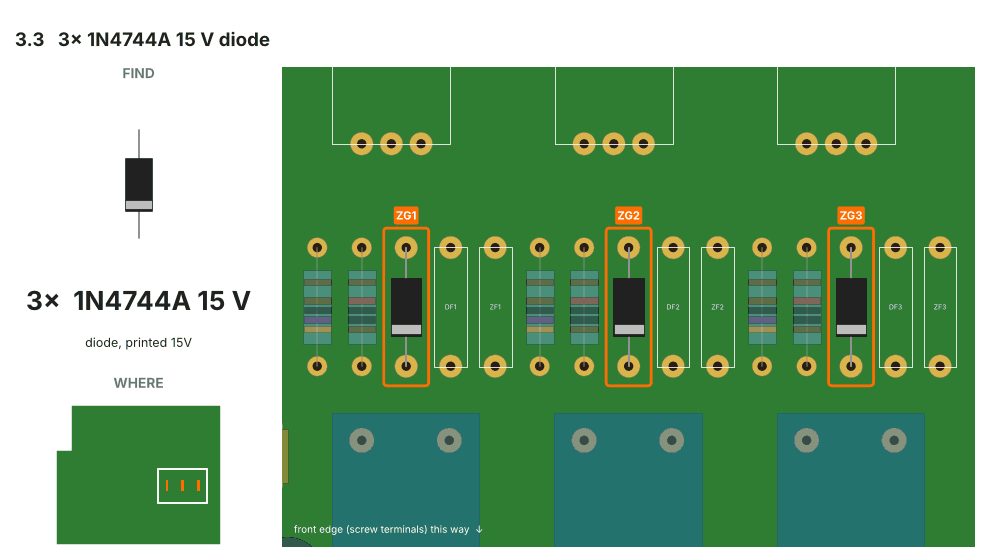
[picture p56: docs/build/pcb-3-3.png]


- [ ] **Where:** **ZG1**, **ZG2**, **ZG3** (printed **15V**), orange in the picture.
- [ ] **Which way:** Stripe to the end with the stripe printed on the board.
- [ ] Solder, then snip the legs to 1.5 mm.

#### 3.4  3× UF4007 diode

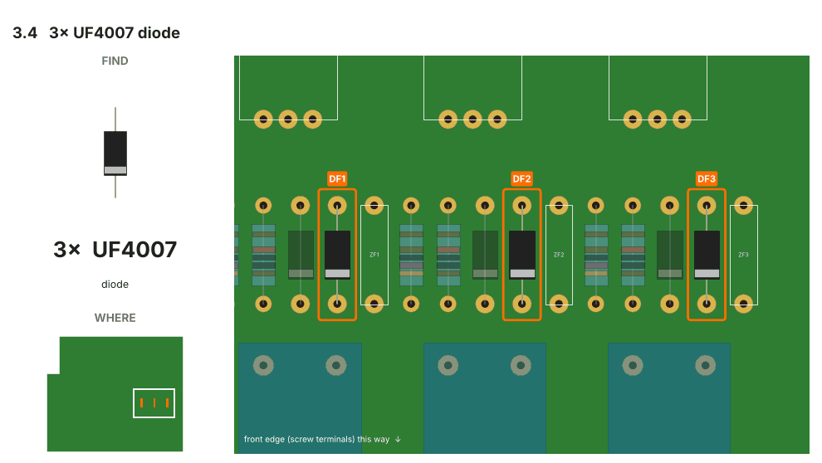
[picture p57: docs/build/pcb-3-4.png]


- [ ] **Where:** **DF1**, **DF2**, **DF3** (printed **UF4007**), orange in the picture.
- [ ] **Which way:** Stripe to the end with the stripe printed on the board.
- [ ] Solder, then snip the legs to 1.5 mm.

#### 3.5  3× 1N4749A 24 V diode

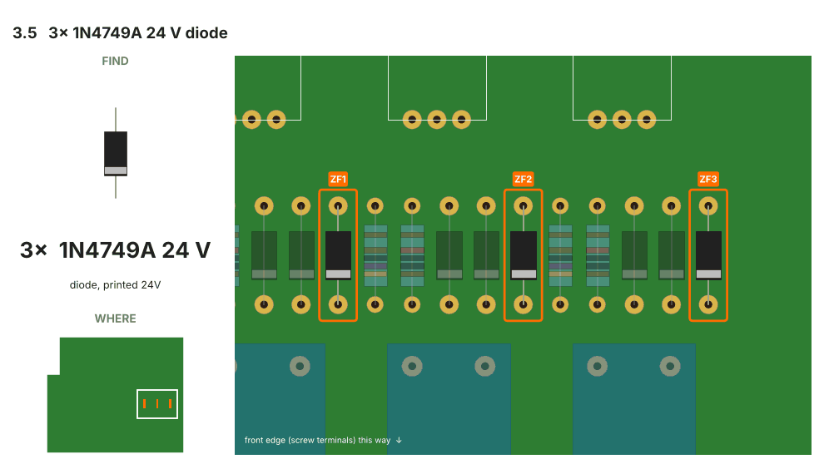
[picture p58: docs/build/pcb-3-5.png]


- [ ] **Where:** **ZF1**, **ZF2**, **ZF3** (printed **24V**), orange in the picture.
- [ ] **Which way:** Stripe to the end with the stripe printed on the board.
- [ ] Solder, then snip the legs to 1.5 mm.

#### 3.6  3× IRF4905 transistor

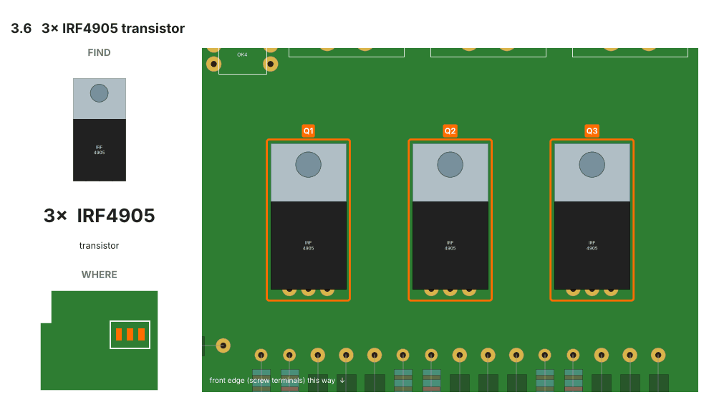
[picture p59: docs/build/pcb-3-6.png]


- [ ] **Where:** **Q1**, **Q2**, **Q3**, orange in the picture.
- [ ] **How:** Bend the legs down 90° about 3.5 mm from the body, so it lies flat with the hole in its metal tab over the hole in the board. Bolt the tab down (M3 × 8 screw and nut) before soldering.
- [ ] Solder every leg.

#### 3.7  The SOL screw terminal (6-way, 5.08 mm)

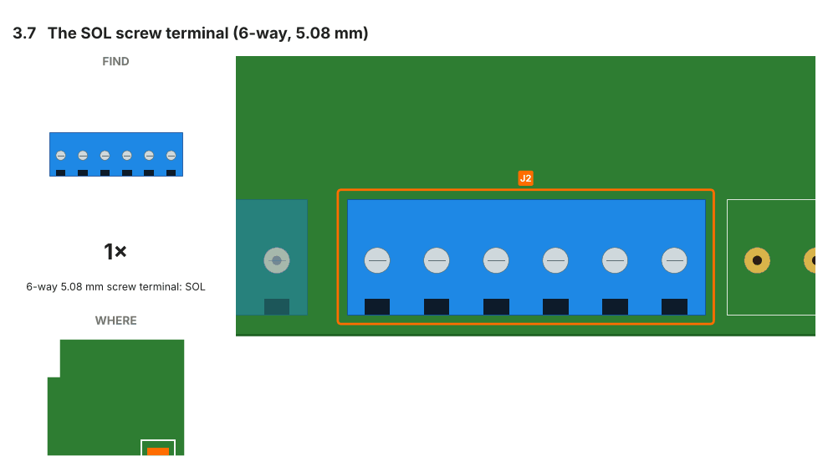
[picture p60: docs/build/pcb-3-7.png]


- [ ] **Where:** **J2**, orange in the picture.
- [ ] **Which way:** Wire openings towards the front edge of the board.
- [ ] Solder every leg.

#### 3.8  The LOAD screw terminal (4-way, 5.08 mm)

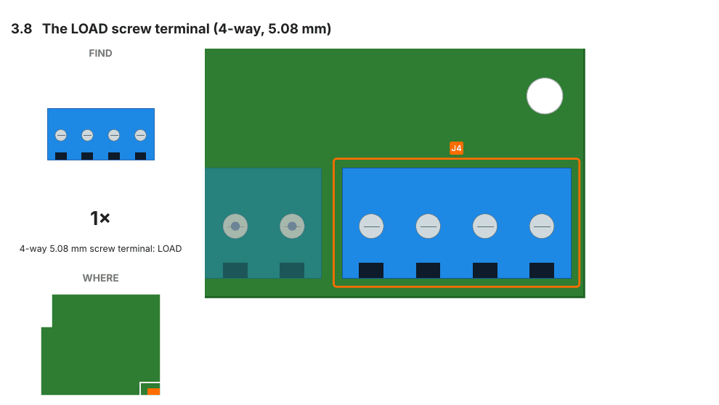
[picture p61: docs/build/pcb-3-8.png]


- [ ] **Where:** **J4**, orange in the picture.
- [ ] **Which way:** Wire openings towards the front edge of the board.
- [ ] Solder every leg.

#### 3.9  3× ACS712-05B module

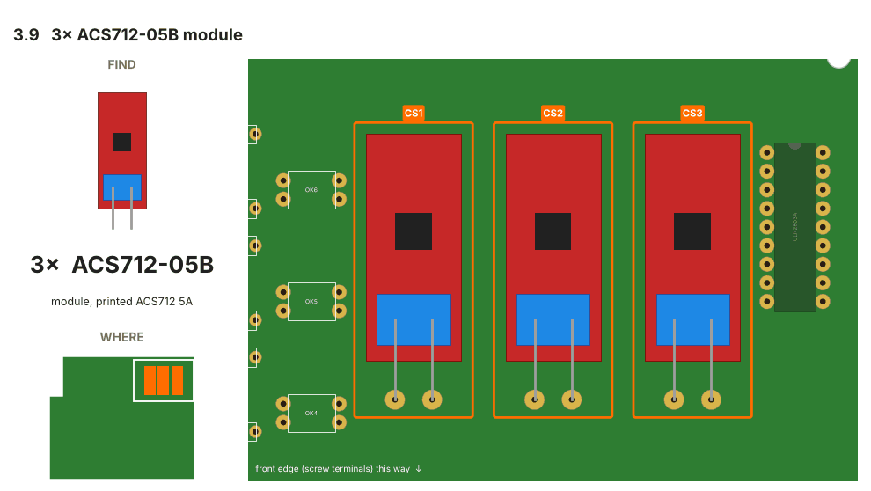
[picture p62: docs/build/pcb-3-9.png]


- [ ] **Where:** **CS1**, **CS2**, **CS3**, orange in the picture.
- [ ] **How:** Its 3 pins go into the holes marked VCC, OUT, GND: check its own printed labels match. If its pins point up or sideways instead of down (sellers differ), lay it in the same place, the same way round, and join each pin to its hole with a short leg offcut. Then two short pieces of stiff wire from its screw terminal into the two big holes marked LINK.
- [ ] Solder every leg.

✅ **CHECK, no shorts** (power off, beep): each **SOL** terminal and **GND**; each **LD**
terminal and **GND**.

✅ **CHECK, relays at rest** (power off, beep): **ECU1** beeps to **SOL1**, **ECU2** to **SOL2**,
**ECU3** to **SOL3**. (Relays off = the engine computer straight through to the transmission.)

✅ **CHECK, it works:** clip one big 15 Ω resistor between **SOL1** and **GND**, lying on the
heatsink. 12 V on both 12V terminals and GND, C7–C8 wire in. While a channel is on, the
resistor takes about **10 W** and gets hot within a minute: keep each test short, and don't
touch it.
- [ ] Hold a wire from **5V** to **D6** (relays on) and another from **5V** to **D8**: **SOL1**
  reads **about 12 V**, and the Mega hole **A4** goes from about **2.50 V** up to about **2.65 V**.
- [ ] Take the wire off **D8**: SOL1 drops to **0 V**.
- [ ] Relays off (no wire on D6), wire on D8: SOL1 stays at **0 V**.
- [ ] The same for the second channel (resistor on **SOL2**, wire on **D9**, reading on **A5**)
  and the third (**SOL3**, **D10**, **A6**).

**If SOL1 stays at 0 V:** check Q1's legs and the two LINK wires on CS1.

---

## Part 5 — Solder the board (steps 4 and 5)

### Step 4 — Car signal inputs

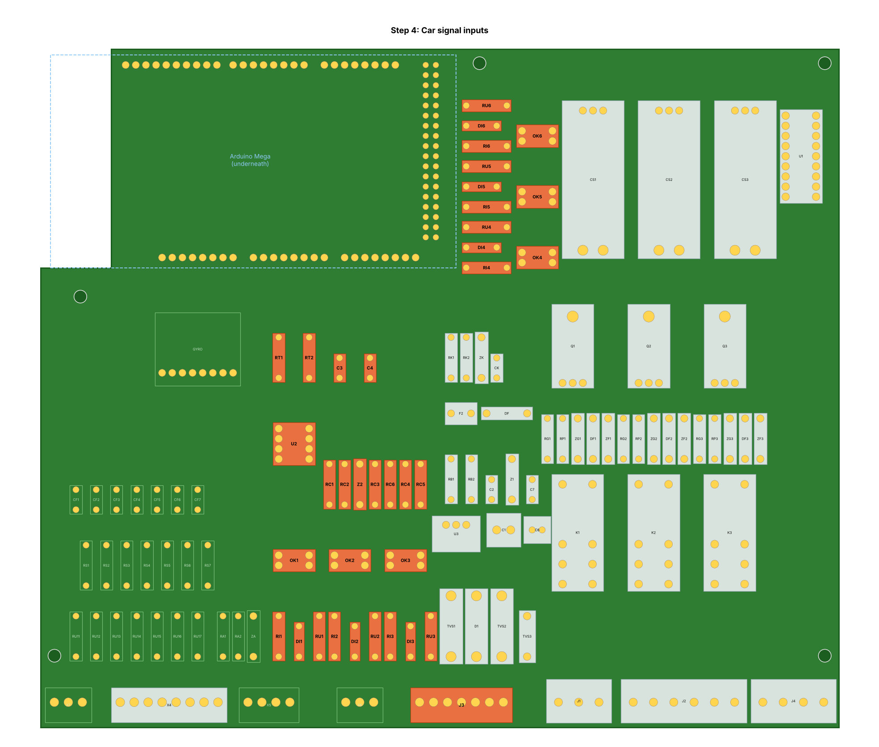
[picture p63: docs/build/pcb-S4.png]
Step 4: everything in this step


*The whole step: 37 parts in 16 small steps. Orange = this step, grey = already in.*

#### 4.1  6× 10k resistor

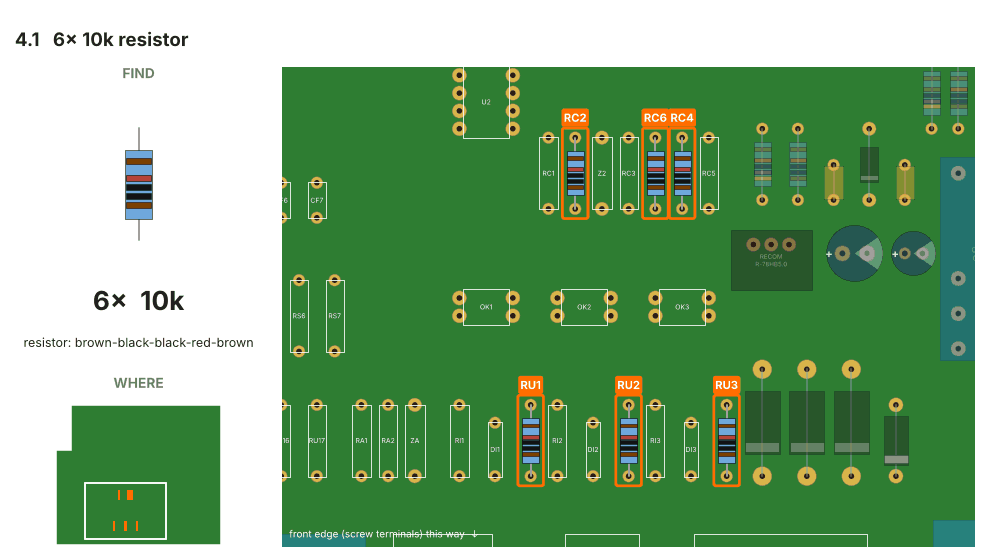
[picture p64: docs/build/pcb-4-1.png]


- [ ] **Where:** **RU1**, **RU2**, **RU3**, **RC2**, **RC6**, **RC4** (printed **10k**), orange in the picture.
- [ ] **Stripes:** brown-black-black-red-brown.
- [ ] Solder, then snip the legs to 1.5 mm.

#### 4.2  3× 10k resistor

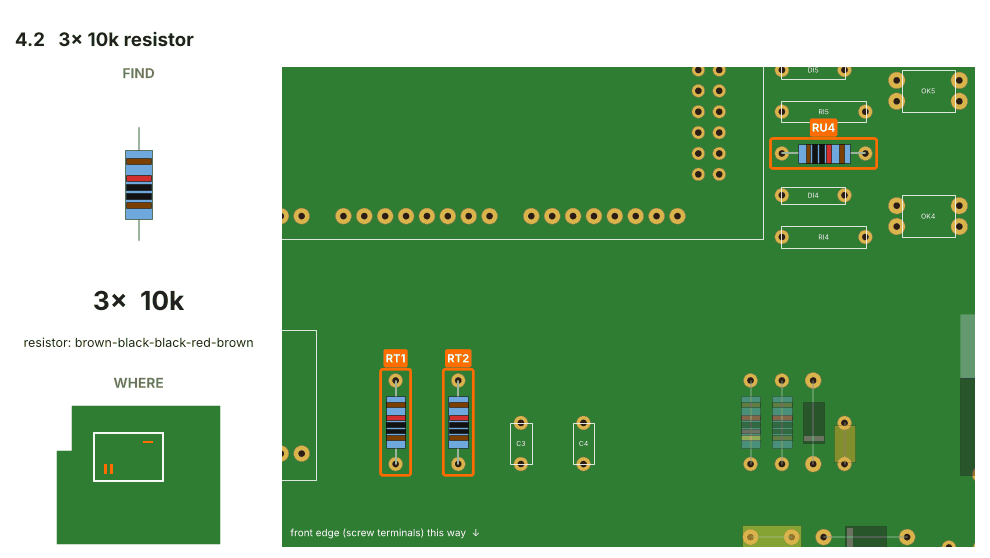
[picture p65: docs/build/pcb-4-2.png]


- [ ] **Where:** **RT1**, **RT2**, **RU4** (printed **10k**), orange in the picture.
- [ ] **Stripes:** brown-black-black-red-brown.
- [ ] Solder, then snip the legs to 1.5 mm.

#### 4.3  2× 10k resistor

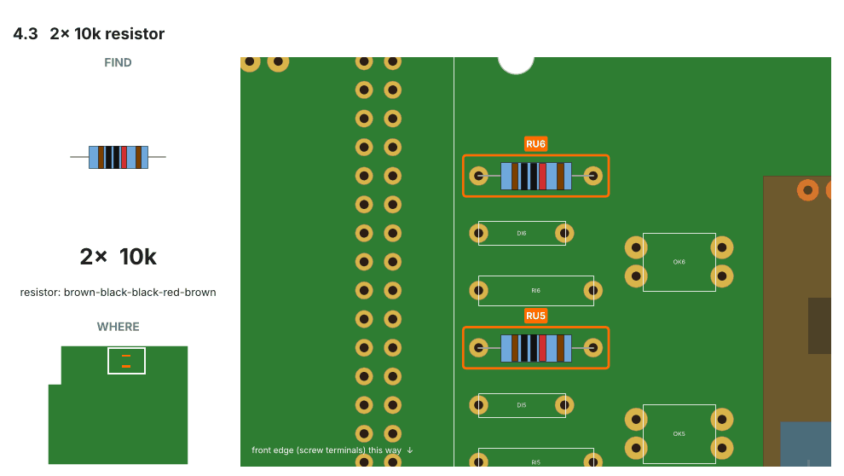
[picture p66: docs/build/pcb-4-3.png]


- [ ] **Where:** **RU5**, **RU6** (printed **10k**), orange in the picture.
- [ ] **Stripes:** brown-black-black-red-brown.
- [ ] Solder, then snip the legs to 1.5 mm.

#### 4.4  3× 2.2k resistor

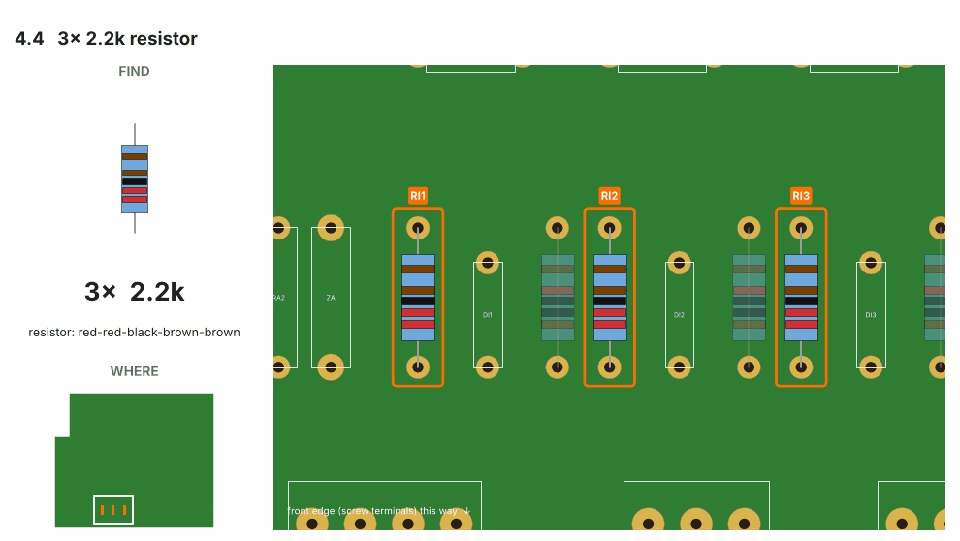
[picture p67: docs/build/pcb-4-4.png]


- [ ] **Where:** **RI1**, **RI2**, **RI3** (printed **2.2k**), orange in the picture.
- [ ] **Stripes:** red-red-black-brown-brown.
- [ ] Solder, then snip the legs to 1.5 mm.

#### 4.5  1× 22k resistor

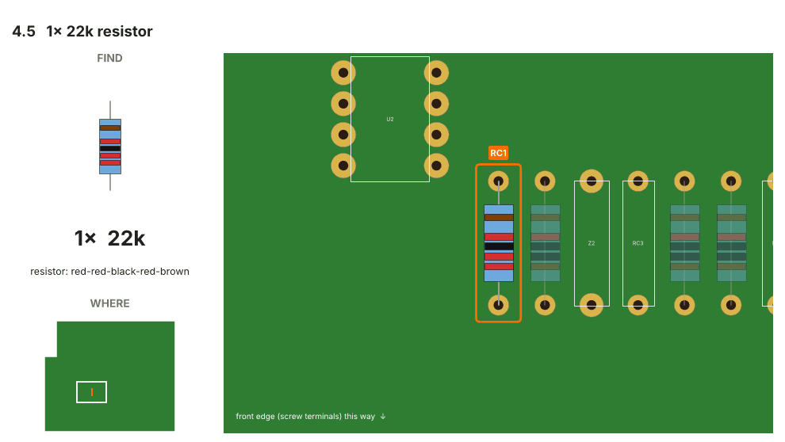
[picture p68: docs/build/pcb-4-5.png]


- [ ] **Where:** **RC1** (printed **22k**), orange in the picture.
- [ ] **Stripes:** red-red-black-red-brown.
- [ ] Solder, then snip the legs to 1.5 mm.

#### 4.6  1× 1M resistor

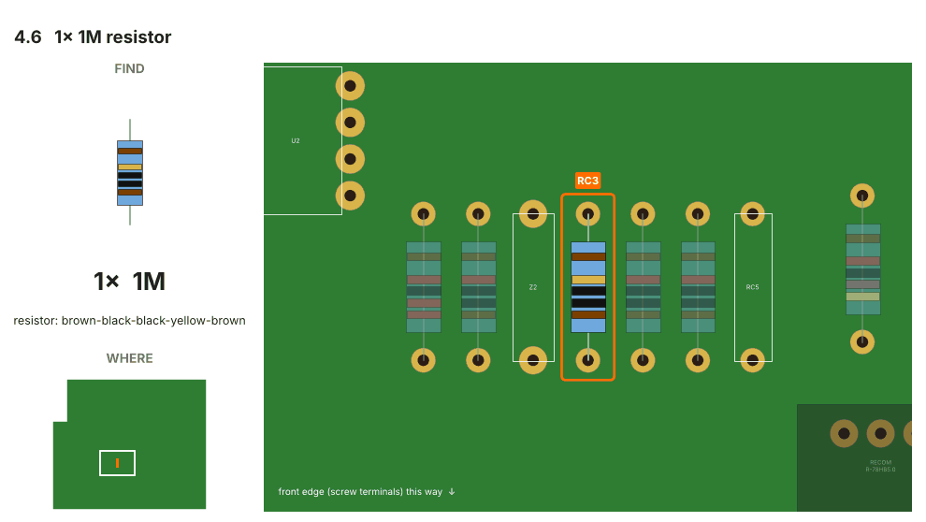
[picture p69: docs/build/pcb-4-6.png]


- [ ] **Where:** **RC3** (printed **1M**), orange in the picture.
- [ ] **Stripes:** brown-black-black-yellow-brown.
- [ ] Solder, then snip the legs to 1.5 mm.

#### 4.7  1× 1.8k resistor

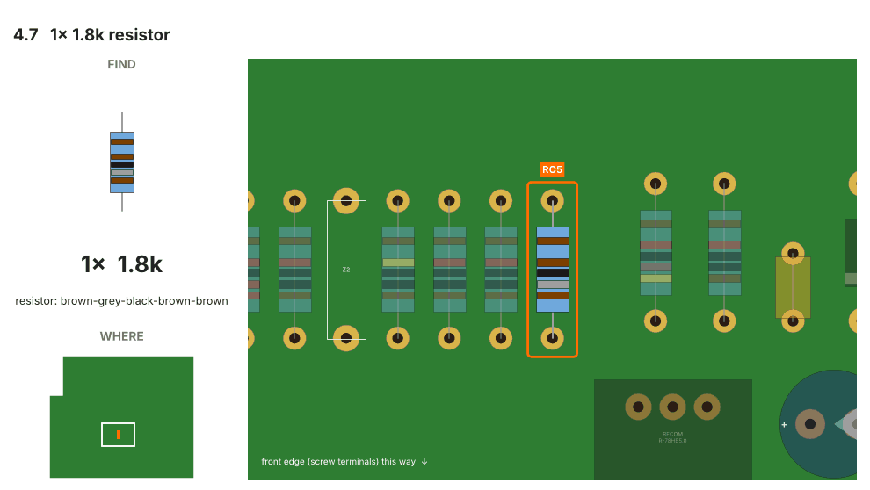
[picture p70: docs/build/pcb-4-7.png]


- [ ] **Where:** **RC5** (printed **1.8k**), orange in the picture.
- [ ] **Stripes:** brown-grey-black-brown-brown.
- [ ] Solder, then snip the legs to 1.5 mm.

#### 4.8  3× 3.3k resistor

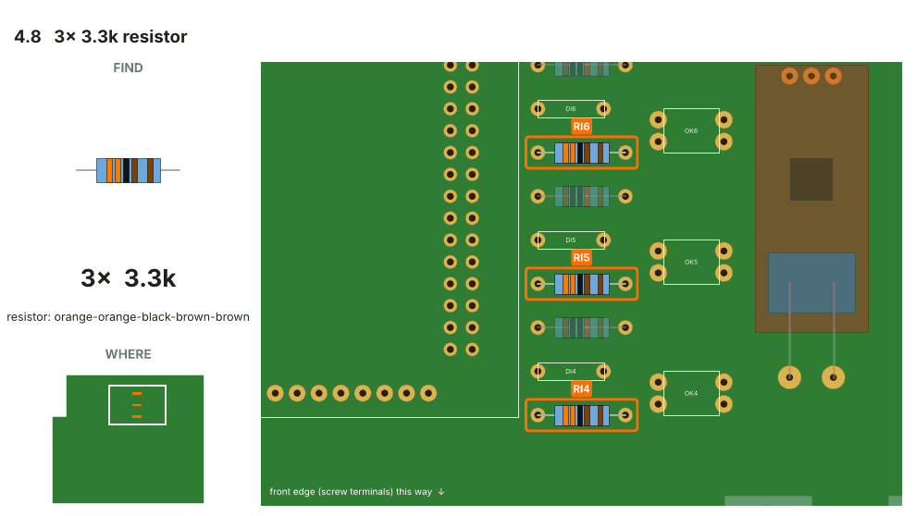
[picture p71: docs/build/pcb-4-8.png]


- [ ] **Where:** **RI4**, **RI5**, **RI6** (printed **3.3k**), orange in the picture.
- [ ] **Stripes:** orange-orange-black-brown-brown.
- [ ] Solder, then snip the legs to 1.5 mm.

#### 4.9  3× 1N4148 diode

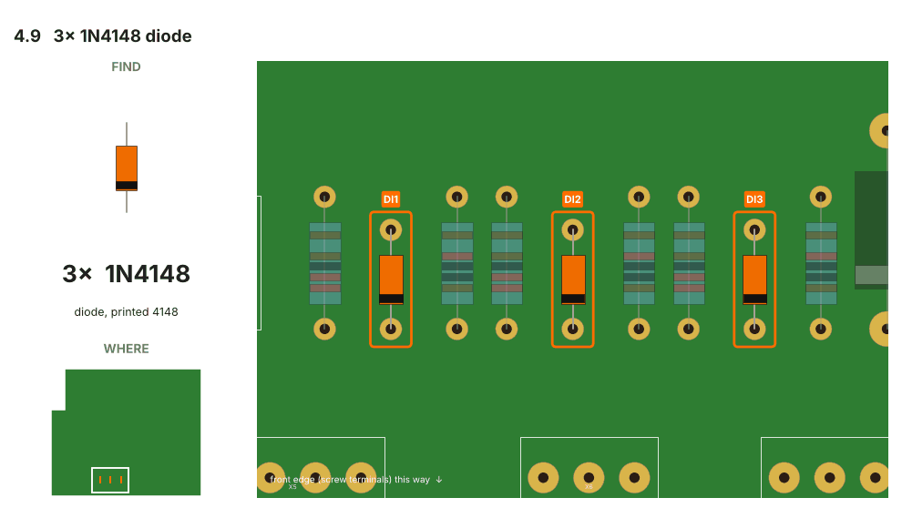
[picture p72: docs/build/pcb-4-9.png]


- [ ] **Where:** **DI1**, **DI2**, **DI3** (printed **4148**), orange in the picture.
- [ ] **Which way:** Stripe to the end with the stripe printed on the board.
- [ ] Solder, then snip the legs to 1.5 mm.

#### 4.10  3× 1N4148 diode

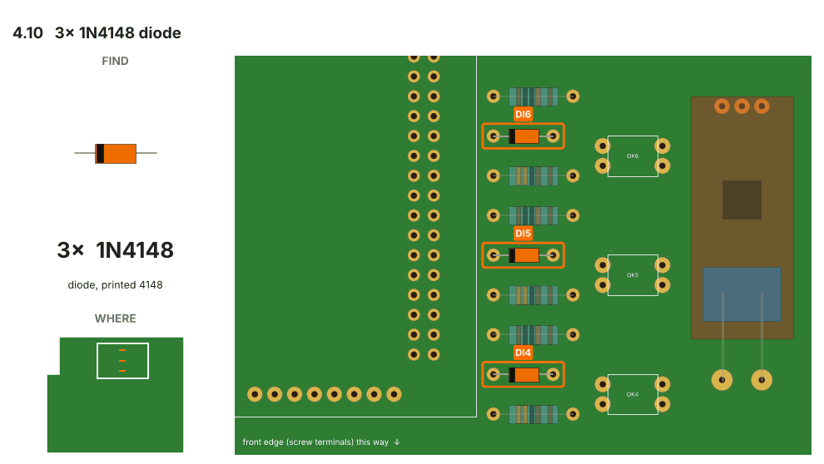
[picture p73: docs/build/pcb-4-10.png]


- [ ] **Where:** **DI4**, **DI5**, **DI6** (printed **4148**), orange in the picture.
- [ ] **Which way:** Stripe to the end with the stripe printed on the board.
- [ ] Solder, then snip the legs to 1.5 mm.

#### 4.11  1× 1N4733A 5.1 V diode

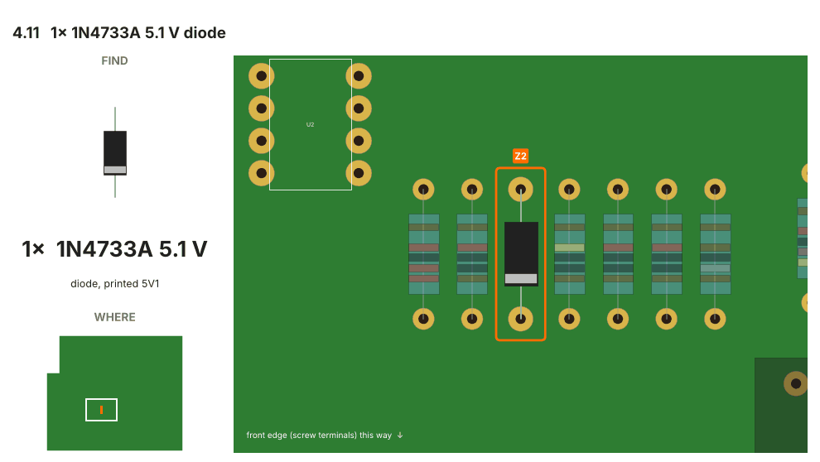
[picture p74: docs/build/pcb-4-11.png]


- [ ] **Where:** **Z2** (printed **5V1**), orange in the picture.
- [ ] **Which way:** Stripe to the end with the stripe printed on the board.
- [ ] Solder, then snip the legs to 1.5 mm.

#### 4.12  2× 100 nF capacitor

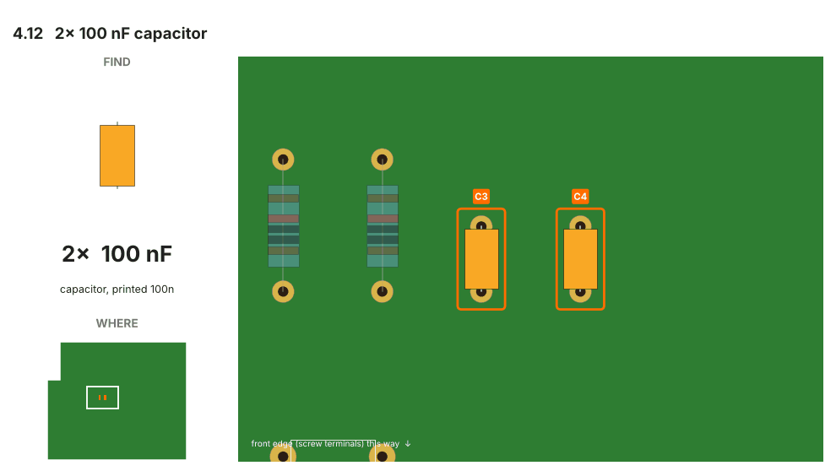
[picture p75: docs/build/pcb-4-12.png]


- [ ] **Where:** **C3**, **C4** (printed **100n**), orange in the picture.
- [ ] Solder, then snip the legs to 1.5 mm.

#### 4.13  1× LM393 chip

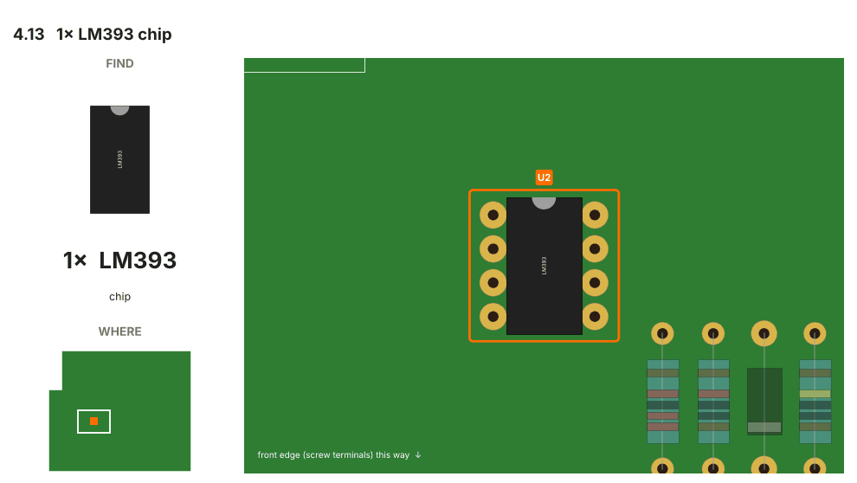
[picture p76: docs/build/pcb-4-13.png]


- [ ] **Where:** **U2**, orange in the picture.
- [ ] **Which way:** Solder its 8-pin socket in, notch to the notch printed on the board. Push the chip into the socket at the end of the step, notch to the notch (bend its legs in a little on the table first if they're splayed).
- [ ] Solder every leg.

#### 4.14  3× PC817 chip

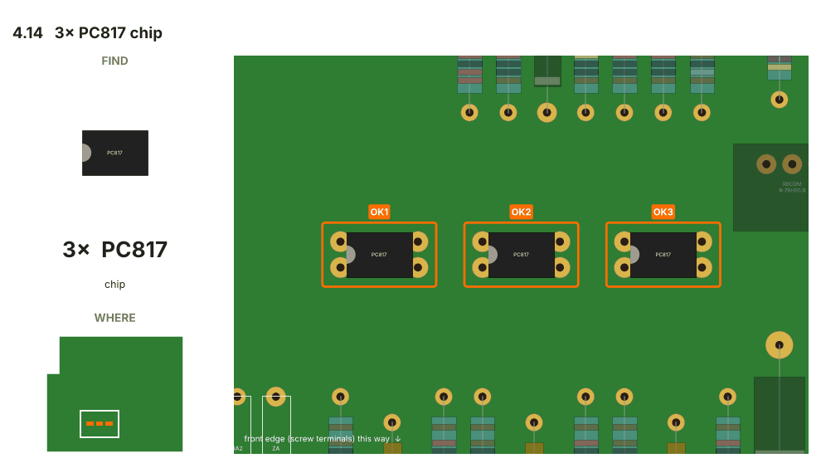
[picture p77: docs/build/pcb-4-14.png]


- [ ] **Where:** **OK1**, **OK2**, **OK3**, orange in the picture.
- [ ] **Which way:** Notch (or dot) to the notch printed on the board.
- [ ] Solder every leg.

#### 4.15  3× PC817 chip

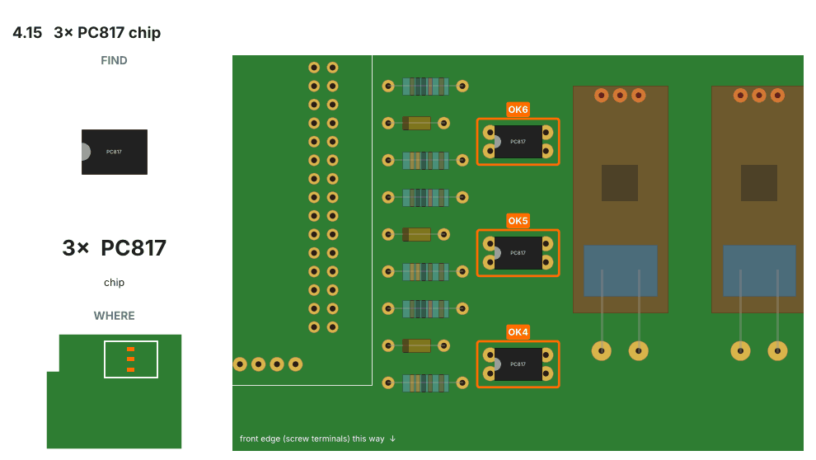
[picture p78: docs/build/pcb-4-15.png]


- [ ] **Where:** **OK4**, **OK5**, **OK6**, orange in the picture.
- [ ] **Which way:** Notch (or dot) to the notch printed on the board.
- [ ] Solder every leg.

#### 4.16  The SIG screw terminal (7-way, 3.5 mm)

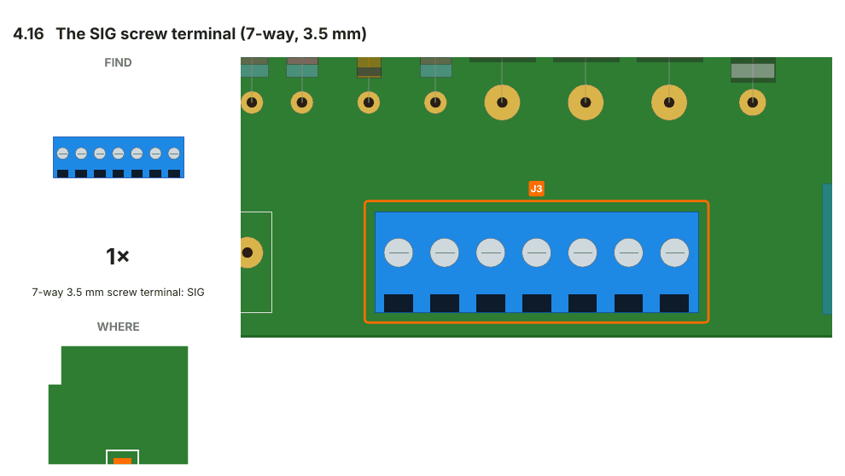
[picture p79: docs/build/pcb-4-16.png]


- [ ] **Where:** **J3**, orange in the picture.
- [ ] **Which way:** Wire openings towards the front edge of the board.
- [ ] Solder every leg.

✅ **CHECK, no shorts** (power off, beep): step 1's pairs again.

✅ **CHECK, it works** (bench 12 V on): each Mega hole below reads **5 V**. Then touch 12 V (a
wire from a **12V** terminal) to its terminal: the hole drops to **under 0.5 V**.

| Touch 12 V to | Mega hole |
|---|---|
| **D** (SIG) | D28 |
| **STP** (SIG) | D27 |
| **TAC** (SIG) | D3 |
| **ECU1** (SOL) | D29 |
| **ECU2** (SOL) | D30 |
| **ECU3** (SOL) | D31 |

- [ ] **Speed:** the Mega hole **D2** reads **0 V** with nothing on **SPD**, and **5 V** with
  5 V or with 12 V on SPD.
- [ ] **Gas pedal:** 5 V (a wire from the **5V** hole) on **VTA**: the **A0** hole reads about
  **5 V**; VTA to GND: **0 V**. The same for **E2** and **A1**.

**If one doesn't change:** check its little 4-legged chip (dot to the printed dot).

### Step 5 — Dash, shifter, screen and probe inputs

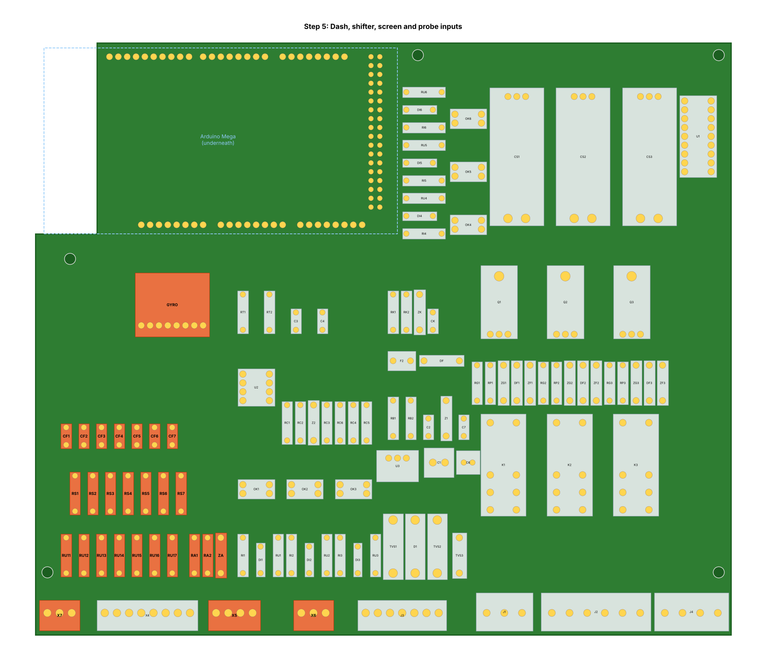
[picture p80: docs/build/pcb-S5.png]
Step 5: everything in this step


*The whole step: 28 parts in 10 small steps. Orange = this step, grey = already in.*

#### 5.1  7× 2.2k resistor

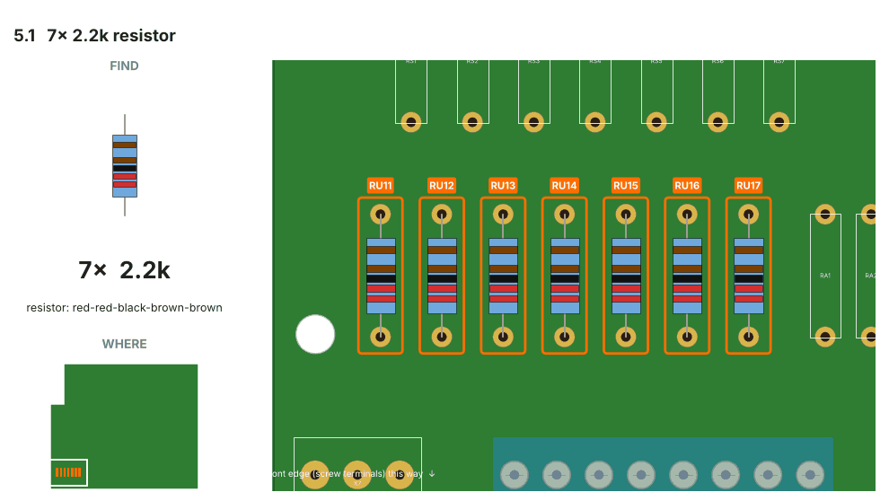
[picture p81: docs/build/pcb-5-1.png]


- [ ] **Where:** **RU11**, **RU12**, **RU13**, **RU14**, **RU15**, **RU16**, **RU17** (printed **2.2k**), orange in the picture.
- [ ] **Stripes:** red-red-black-brown-brown.
- [ ] Solder, then snip the legs to 1.5 mm.

#### 5.2  7× 10k resistor

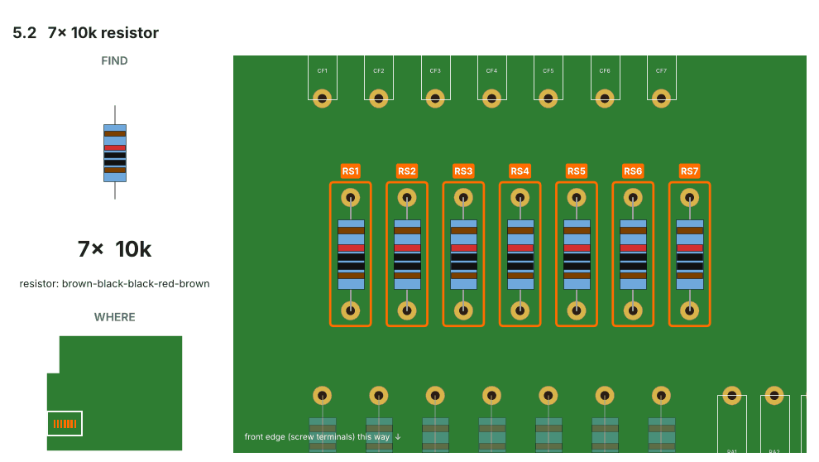
[picture p82: docs/build/pcb-5-2.png]


- [ ] **Where:** **RS1**, **RS2**, **RS3**, **RS4**, **RS5**, **RS6**, **RS7** (printed **10k**), orange in the picture.
- [ ] **Stripes:** brown-black-black-red-brown.
- [ ] Solder, then snip the legs to 1.5 mm.

#### 5.3  1× 4.7k resistor

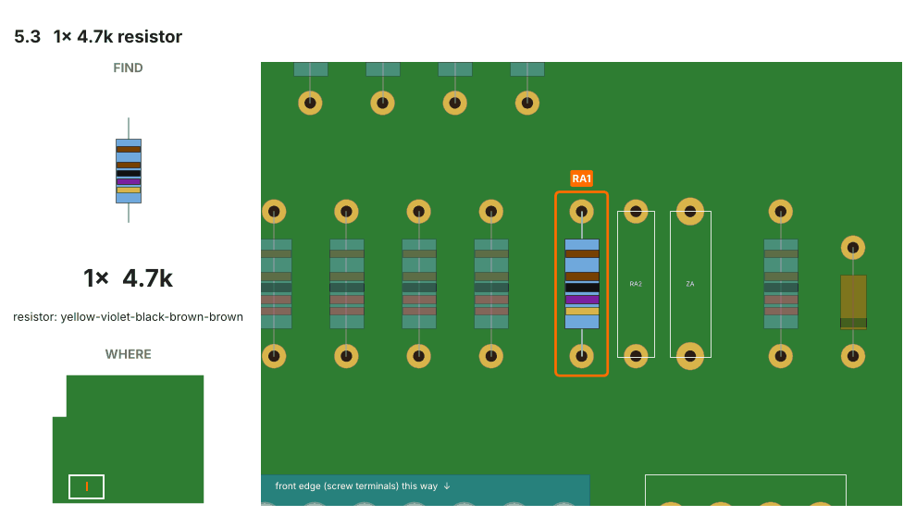
[picture p83: docs/build/pcb-5-3.png]


- [ ] **Where:** **RA1** (printed **4.7k**), orange in the picture.
- [ ] **Stripes:** yellow-violet-black-brown-brown.
- [ ] Solder, then snip the legs to 1.5 mm.

#### 5.4  1× 100 Ω resistor

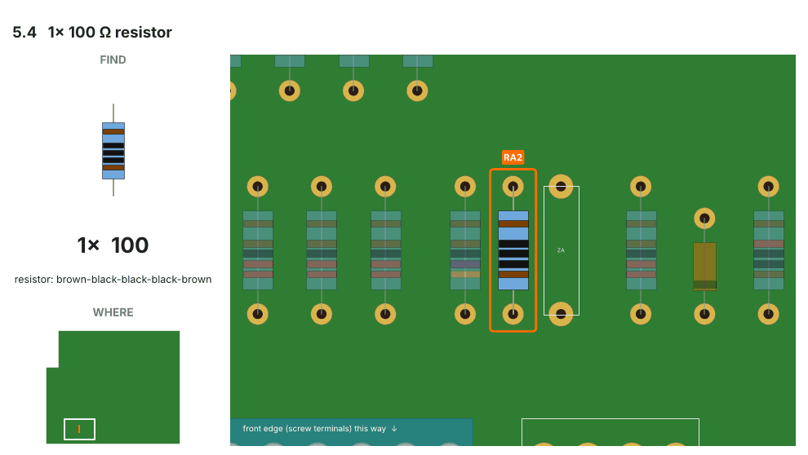
[picture p84: docs/build/pcb-5-4.png]


- [ ] **Where:** **RA2** (printed **100R**), orange in the picture.
- [ ] **Stripes:** brown-black-black-black-brown.
- [ ] Solder, then snip the legs to 1.5 mm.

#### 5.5  1× 1N4733A 5.1 V diode

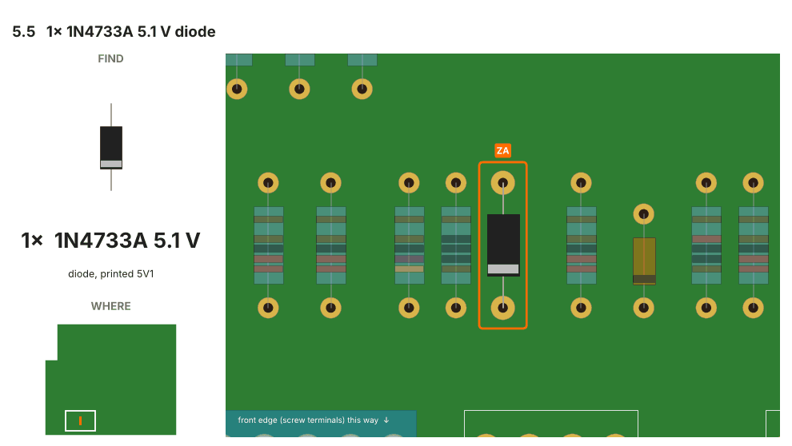
[picture p85: docs/build/pcb-5-5.png]


- [ ] **Where:** **ZA** (printed **5V1**), orange in the picture.
- [ ] **Which way:** Stripe to the end with the stripe printed on the board.
- [ ] Solder, then snip the legs to 1.5 mm.

#### 5.6  7× 100 nF capacitor

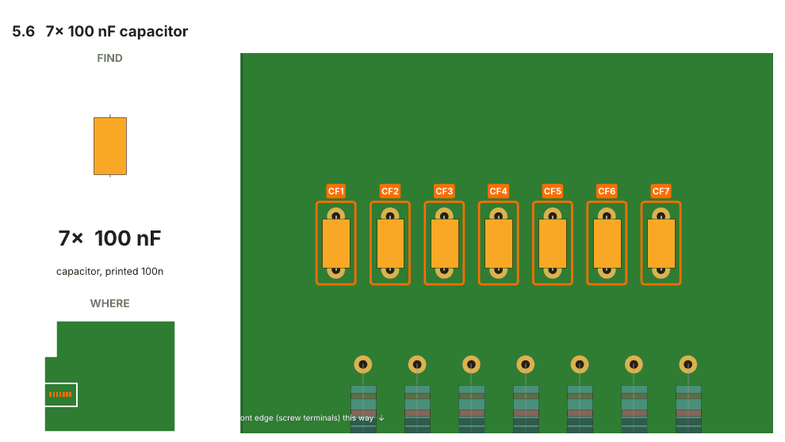
[picture p86: docs/build/pcb-5-6.png]


- [ ] **Where:** **CF1**, **CF2**, **CF3**, **CF4**, **CF5**, **CF6**, **CF7** (printed **100n**), orange in the picture.
- [ ] Solder, then snip the legs to 1.5 mm.

#### 5.7  The SHIFT screw terminal (3-way, 3.5 mm)

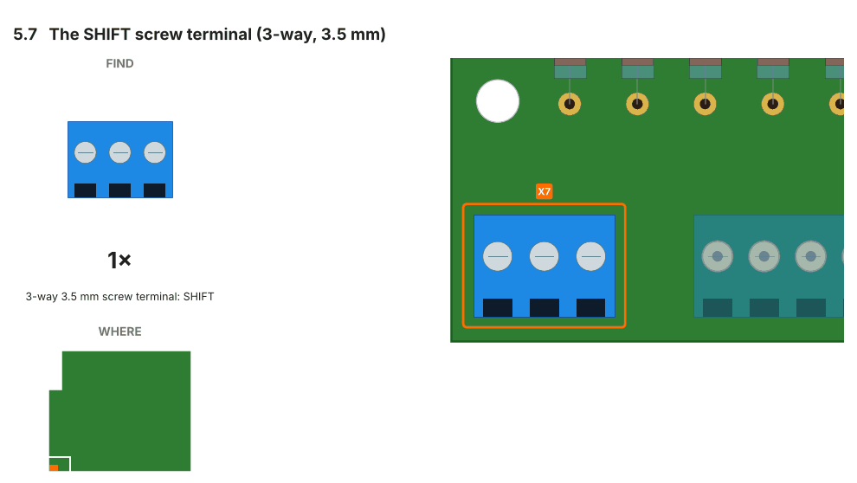
[picture p87: docs/build/pcb-5-7.png]


- [ ] **Where:** **X7**, orange in the picture.
- [ ] **Which way:** Wire openings towards the front edge of the board.
- [ ] Solder every leg.

#### 5.8  The SCREEN screw terminal (4-way, 3.5 mm)

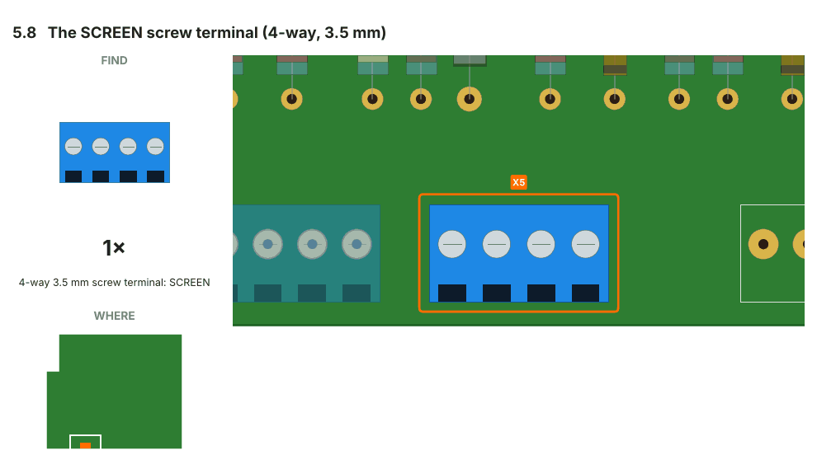
[picture p88: docs/build/pcb-5-8.png]


- [ ] **Where:** **X5**, orange in the picture.
- [ ] **Which way:** Wire openings towards the front edge of the board.
- [ ] Solder every leg.

#### 5.9  The ATF screw terminal (3-way, 3.5 mm)

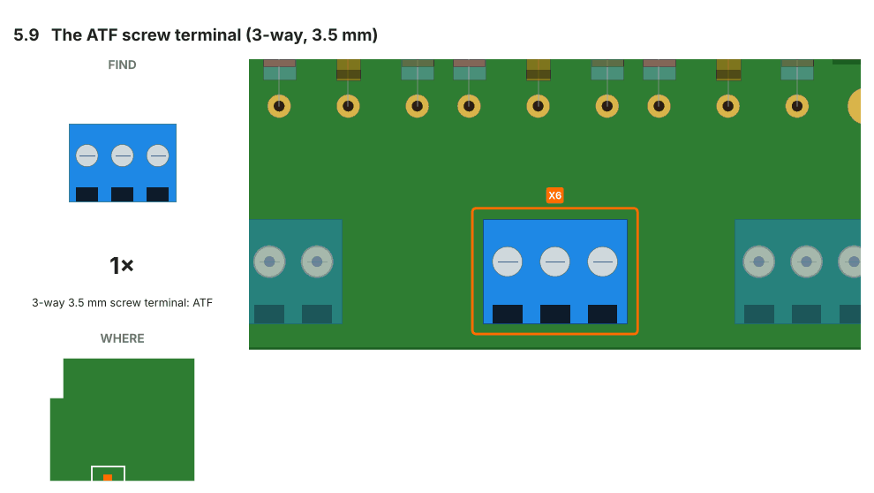
[picture p89: docs/build/pcb-5-9.png]


- [ ] **Where:** **X6**, orange in the picture.
- [ ] **Which way:** Wire openings towards the front edge of the board.
- [ ] Solder every leg.

#### 5.10  1× GY-521 module

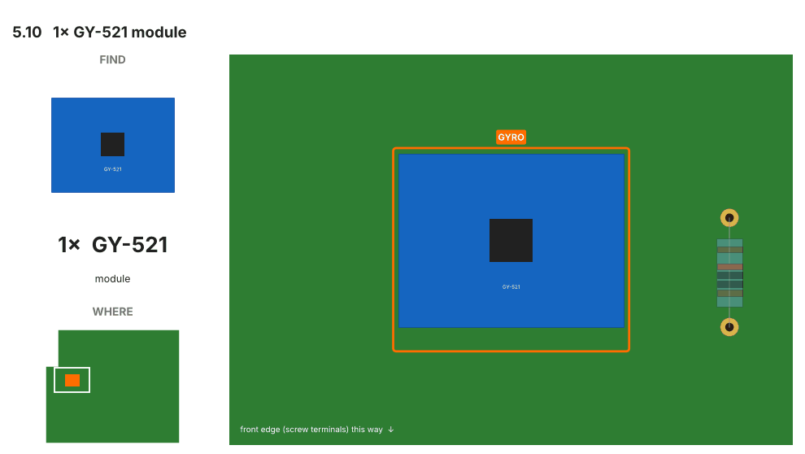
[picture p90: docs/build/pcb-5-10.png]


- [ ] **Where:** **GYRO**, orange in the picture.
- [ ] **How:** Solder its 8-pin header into the board first, then the gyro onto the header, lying flat, chip side up.
- [ ] Solder every leg.

✅ **CHECK, no shorts** (power off, beep): the **SCREEN** terminals **5V** and **GND**; step 1's
pairs again.

✅ **CHECK, it works** (bench 12 V on): the terminals below each read **5 V**. Touch each one to
a **GND** terminal: its Mega hole drops to **0 V**.

| Terminal | UP | DN | ECO | SPT | MAN | TST | ON |
|---|---|---|---|---|---|---|---|
| Mega hole | D22 | D23 | D24 | D25 | D34 | D32 | D26 |

- [ ] The **ATF** terminal **DQ** reads **5 V**.
- [ ] The gyro's tiny light comes on.

---

## Part 6 — The Mega

### Step 6 — The Mega's pins

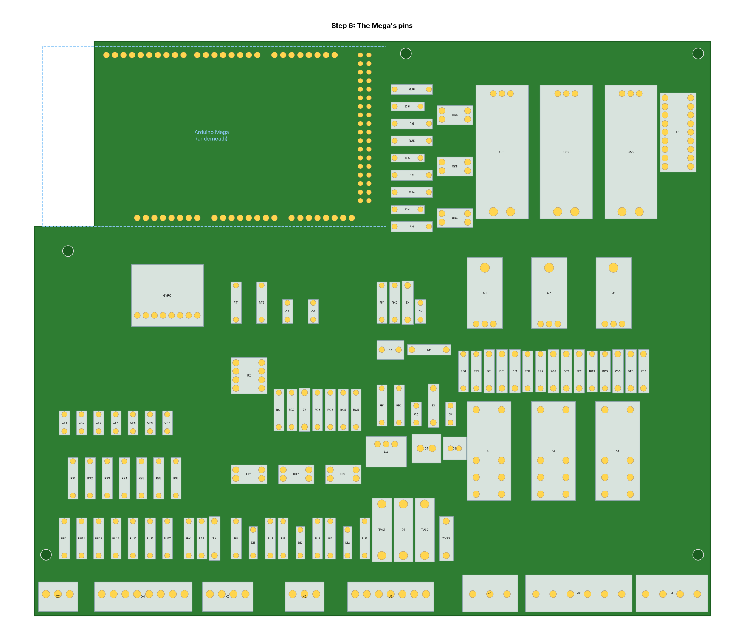
[picture p91: docs/build/pcb-S6.png]
Step 6: everything in this step


*The whole step: 1 part in 1 small step. Orange = this step, grey = already in.*

#### 6.1  The Mega's pins

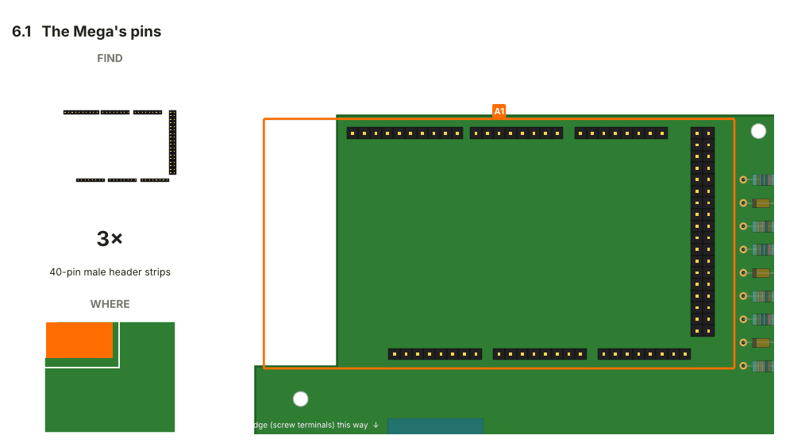
[picture p92: docs/build/pcb-6-1.png]


- [ ] **Where:** the Mega's holes, orange in the picture.
- [ ] **How:** Push the header strips into the Mega's sockets, **long ends down** (cut to length: 8, 8, 8, 10, 8, 8 and two 18s side by side), lay this board on top so every pin pokes through its hole, and solder them from the top. They line up perfectly that way.
- [ ] Solder every leg.

✅ **CHECK** (meter on beep): no two neighbouring Mega pins beep to each other, except where both
are labelled **5V** or both **GND**.

- [ ] Plug the board onto the Mega. Every pin goes into its socket; the Mega's USB and power
  sockets sit in the cut-away corner, clear of the board.

---

## Part 7 — Screen

The screen: gear 18 mm tall

The screen shows the **gear as a big number** with the mode beside it.

- [ ] **Set it up.** Look on the back for the setting printed **SPI** and **I2C** (sometimes
  **IIC**). The seller's page shows which tiny parts to move for I2C. Move them: heat one end,
  slide the part off, then solder it onto the I2C pads. *(Skip this if you bought one that's
  already set to I2C.)*
- [ ] Solder the 4-core screen cable: **VCC → red** core, **GND → black**, **DIN** and **CLK**
  to the other two. Write down which colour went where.
- [ ] Solder a short wire from **DC** to **GND**, and another from **CS** to **GND**.
- [ ] Solder a **10k resistor** (brown-black-black-red-brown) from **RES** to **VCC**.
- [ ] Solder the **1 µF capacitor** from **RES** to **GND**. If it has a stripe, the stripe side
  goes to GND.

✅ **CHECK** (meter on beep):
- [ ] **DC** beeps to **GND**, and **CS** beeps to **GND**.
- [ ] **VCC** does **not** beep to **GND**.
- [ ] Meter on Ω: **RES** to **VCC** reads about **10 kΩ**.
- [ ] At the **far end** of the cable, each core beeps to the screen pin you soldered it to
  (VCC, GND, DIN, CLK), and to no other.

Don't put it in the pod yet. It gets tested in part 10 first.

---

## Part 8 — Dash pod and shifter base

These are two separate pieces, each with its own cable to the TCU box:
- the **dash pod**: the screen and all the switches
- the **shifter base**: the lever you pull and push to shift

Neither needs the box yet.

**About the switches.** A small switch has 3 pins: a middle one and two outer ones. Meter on
beep, lever **up**: find the outer pin that beeps to the middle one. Use those two pins. Then
**lever up = on**.

**The ON/OFF switch has two halves.** It has 6 pins (two rows of 3), or 4 on some switches. Each
half is its own switch, and both flip together. Test each half the same way: lever up, find the
outer pin that beeps to that half's middle pin. Its red cover pushes the lever down (off) when
you close it.

### The dash pod

**8.1 Inserts.** Press the 4 brass inserts into the ends of the corner posts at the open back,
with the soldering iron at 230–250 °C. Push straight in; stop when they're flush with the
plastic.

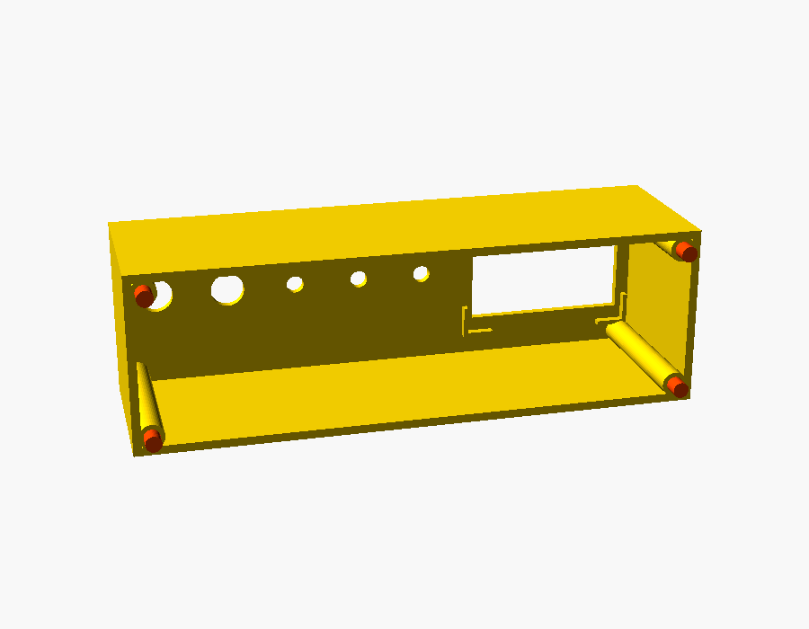
[picture p93: docs/build/pod-1.png]
Dash pod step 1


**8.2 Screen and switches.** Left to right on the front:
- [ ] The **screen** goes into the pocket behind its window, face first. Stick it with
  double-sided foam tape on its black glass edge. It only fits one way.
- [ ] **ECO**, **SPORT**, **MANUAL**: the three small switches.
- [ ] **TEST**: the push button.
- [ ] **ON/OFF**: the big switch, with the red cover's hinge at the top.
- [ ] Tighten each nut from inside. The names are engraved under each hole.

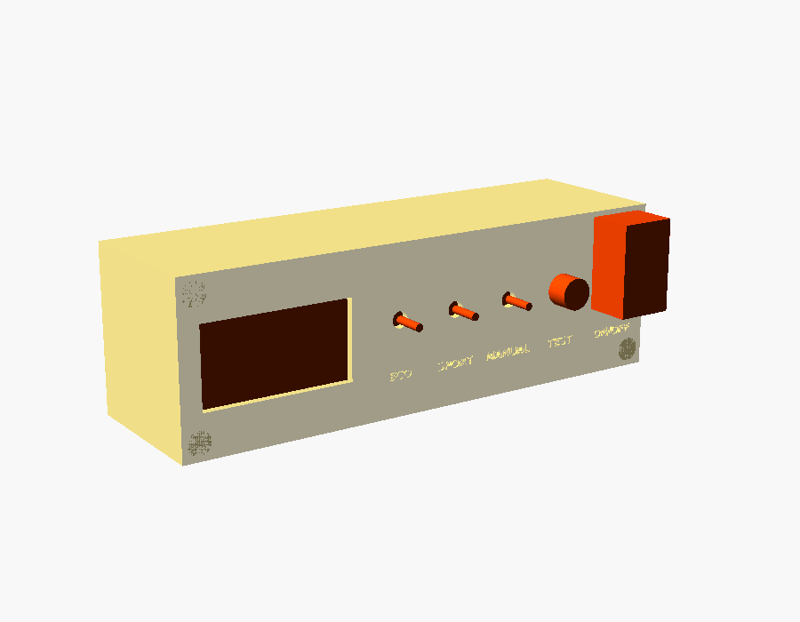
[picture p94: docs/build/pod-2.png]
Dash pod step 2


**8.3 Cables.**
- [ ] Fit the 2 glands in the back cover: **SWITCHES** and **SCREEN**.
- [ ] Push the **8-core cable** through SWITCHES, and the screen's **4-core cable** (from part 7)
  through SCREEN.
- [ ] Join each core of the 8-core cable to its switch with a lever connector:

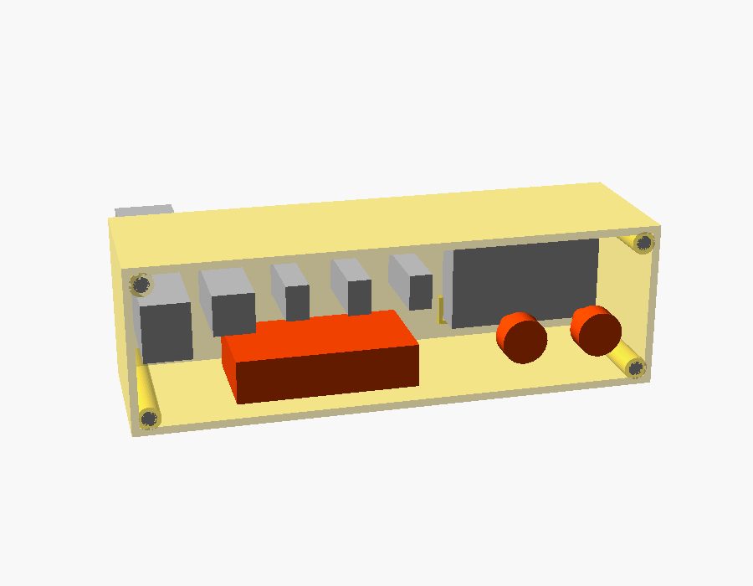
[picture p95: docs/build/pod-3.png]
Dash pod step 3


| Core | Goes to |
|---|---|
| C1 | ECO switch |
| C2 | SPORT switch |
| C3 | MANUAL switch |
| C4 | TEST button |
| C5 | ON/OFF switch, **first half** |
| C6 (ground) | the other pin of **every** switch and the button. Easiest: one black wire soldered from switch to switch, ECO → SPORT → MANUAL → TEST → ON/OFF (first half), with C6 joined to its end |
| C7 | ON/OFF switch, **second half**, middle pin |
| C8 | ON/OFF switch, **second half**, the outer pin that's on with the lever up |

**Never join the two halves of the ON/OFF switch.** C7 and C8 carry the relays' 12 V; the other
cores carry only 5 V.

**8.4 Back cover.** Screw the back cover on (4 × M3 × 10 countersunk). The two hinge tabs stick
out of the back.

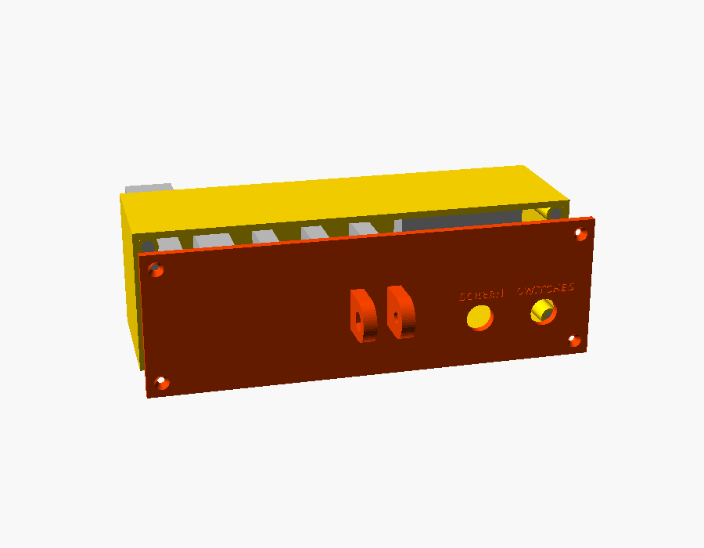
[picture p96: docs/build/pod-4.png]
Dash pod step 4


**8.5 Mount:** later, in the car (part 12.4).

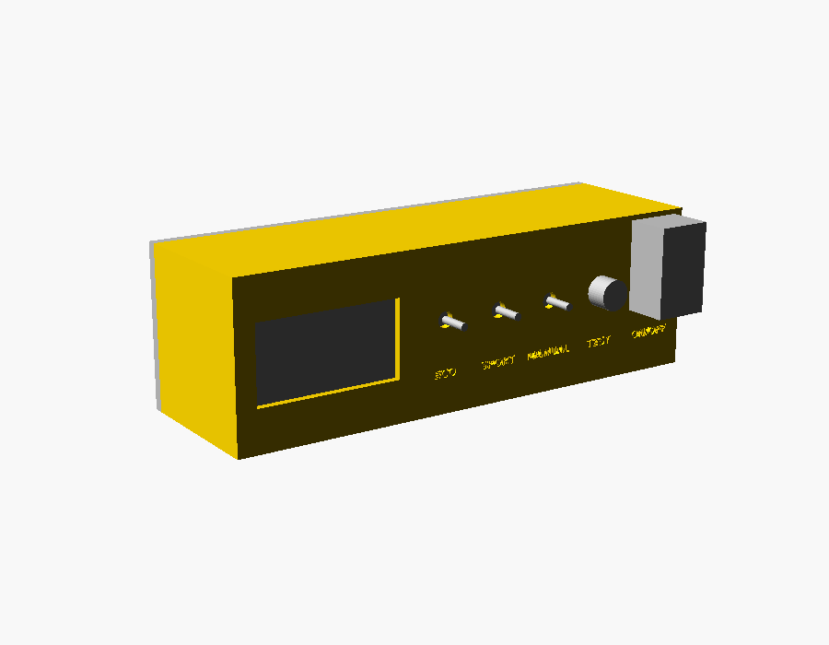
[picture p97: docs/build/pod-5.png]
Dash pod step 5


✅ **CHECK** (meter on beep, at the far end of the 8-core cable):
- [ ] C1 beeps to C6 only with ECO on.
- [ ] C2 beeps to C6 only with SPORT on.
- [ ] C3 beeps to C6 only with MANUAL on.
- [ ] C4 beeps to C6 only while TEST is pressed.
- [ ] C5 beeps to C6 only with ON/OFF on.
- [ ] **C7 beeps to C8 only with ON/OFF on.**
- [ ] C7 and C8 **never** beep to any of C1–C6.

**If a switch works backwards** (beeps when off): move its wire to the other outer pin.

### The shifter base

**8.6 Inserts.** Press 4 brass inserts into the base's corner posts, from underneath.

**8.7 Lever.** Build the Beavis lever as its guide and
[assembly video](https://www.youtube.com/watch?v=a-w8Zu3LSlE) show:
- [ ] The shaft into the body.
- [ ] The pivot tube or M12 bolt.
- [ ] The travel-stop bolts, with the springs over them.
- [ ] Each **V-155-1C25** switch between two spacers, on two M3 × 70 bolts.
- [ ] Leave out the Arduino it mentions: you don't need it.
- [ ] Drill the body's four mounting holes out to **6.5 mm**.
- [ ] Drop 4 M6 nuts into the hex slots under the base's top.
- [ ] Cut the M6 bolts to **the thickness of the shifter's foot + 6 mm**.
- [ ] Bolt the lever down, its long side matching the base's long side.
- [ ] Feed its switch wires down through the rectangular hole.

**8.8 Cable.**
- [ ] Fit a small gland in the back wall (marked **TO TCU**) and push the **3-core cable**
  through.
- [ ] Join it with 3 lever connectors:

| Core | Goes to |
|---|---|
| UP | the upshift switch's **NO** pin (it's printed on the switch) |
| DOWN | the downshift switch's **NO** pin |
| GND | the **COM** pin of **both** switches |

Leave each switch's **NC** pin empty. Write down which colour is UP, DOWN and GND.

The shifter base with the lever

**8.9 Bottom plate:** later, in the car (part 12.4).

✅ **CHECK** (meter on beep, at the far end of the 3-core cable):
- [ ] UP beeps to GND only while you pull the lever for an upshift.
- [ ] DOWN beeps to GND only while you push it for a downshift.

**If it's the wrong way round:** swap the UP and DOWN wires.

---

## Part 9 — Dummy loads

While the TCU is driving the transmission, these 3 big resistors stand in for the solenoids,
so the engine computer doesn't notice anything is different.

- [ ] Lay the three **15 Ω 50 W resistors** on the heatsink's flat side, side by side with a
  finger's width between them. Mark through their corner holes, and drill each mark with a
  **3.2 mm** bit, going through between the fins.
- [ ] Put a thin layer of heatsink paste under each resistor, then bolt it down: **M3 × 16**
  screws from the resistor side, nuts between the fins (2 per resistor). Firm, not crushing.
- [ ] Join one end of all three with a black 18 AWG wire: label it **LOAD GND**.
- [ ] Put a white 18 AWG wire on the other end of each one. Label them **LOAD 1, LOAD 2,
  LOAD 3**.

✅ **CHECK:**
- [ ] Each LOAD wire reads **15 Ω** to LOAD GND (meter on Ω).
- [ ] None of the wires beeps to the heatsink.

---

## Part 10 — Test everything on the bench

The first time everything runs together. Take it slowly: every stage says what you should see,
and what to do if you don't. Allow an evening.

### 10.1 Connect everything (power off)

The board is plugged onto the Mega (part 6). Every cable screws into the terminals with the
same names printed behind them.
- [ ] Shifter cable → the **SHIFT** terminals **UP**, **DN**, **GND**.
- [ ] Dash cable: C1–C8 → the **DASH** terminals **ECO**, **SPT**, **MAN**, **TST**, **ON**,
  **GND**, **C7**, **C8**. (Take out the C7–C8 test wire from step 2 first.)
- [ ] Screen cable → the **SCREEN** terminals: the screen's **VCC** core to **5V**, **GND** to
  **GND**, **DIN** to **SDA**, **CLK** to **SCL** (part 7 says which colour is which).
- [ ] ATF probe → the **ATF** terminals (red = **5V**, black = **GND**, yellow = **DQ**).
- [ ] Dummy loads: LOAD 1, 2, 3, GND → the **LOAD** terminals **LD1**, **LD2**, **LD3**, **GND**.
- [ ] **For the bench only**, three short wires: **SOL1 → LD1, SOL2 → LD2, SOL3 → LD3**. Now the
  big resistors stand in for the solenoids.
- [ ] **For the bench only, a gas pedal stand-in** (otherwise the self-test reports the
  disconnected gas pedal as bad): one 10k resistor from the ATF terminal **5V** to the SIG
  terminal **VTA**, a second 10k from **VTA** to **E2**, and a short wire from **E2** to a **GND**
  terminal.
- [ ] Switches: **ON/OFF off**, ECO on, SPORT and MANUAL off.

✅ **CHECK** (meter on beep, power still off): the two **12V** terminals don't keep beeping to
**GND** (a short chirp is fine).

### 10.2 Load the software onto the Mega

- [ ] Install the free **Arduino IDE** (arduino.cc → Software) on a laptop.
- [ ] Plug the Mega into the laptop with its USB cable. Bench power stays off: the USB powers it.
- [ ] In the Arduino IDE: **File → Open** → `firmware/tcu/tcu.ino` (from this project's folder).
- [ ] **Tools → Board → Arduino Mega or Mega 2560**.
- [ ] **Tools → Port** → the port that appeared when you plugged it in.
- [ ] Press **Upload** (the round arrow button, top left). Wait for **"Done uploading"** at the
  bottom.

**If there's no port:** try another USB cable (some only charge). Cheaper "compatible" Megas
need the **CH340** driver: search "CH340 driver" for your computer, install it, and plug in
again.
**If the upload fails:** close every other program that might be using the port (including a
second Arduino window), unplug, plug back in, and try again.

### 10.3 Open the message window

The Mega writes what it's doing to the laptop. That's often the quickest way to see what's wrong.

- [ ] **Tools → Serial Monitor**. In the bottom-right of the new window, pick **115200 baud**.
- [ ] Press the Mega's small reset button. You should see `# TCU boot`, then a `# PBIT` list of
  checks, then lines of numbers scrolling (one every 0.1 s).

### 10.4 First power-on

- [ ] Bench 12 V: **+** to **both 12V** terminals, **−** to **GND**. The USB cable can stay plugged in.
- [ ] Keep a hand near the bench power plug. Switch the bench 12 V **on**.
- [ ] For 10 seconds, watch and sniff. **Any smoke or a hot smell: power off at once**, and go
  back over the last board step's checks.
- [ ] After 30 seconds, power off and carefully touch the parts. The 5 V regulator U3 may be warm.
  Nothing should be too hot to keep a finger on. Power back on.

✅ **CHECK:** within a second, the screen shows a big **–**, **STOCK**, "TCU IS OFF: STOCK
SHIFTING", and **TRANS** with the room temperature in °F.

**If the screen stays dark:**
- The message window shows `# TCU boot`? Then the Mega is fine and it's the screen: check the
  screen cable in the **SCREEN** terminals (DIN to SDA, CLK to SCL), and part 7's checks.
- Nothing in the message window either? The Mega isn't running the software: check the USB
  cable and the port, and upload again (10.2).

✅ **CHECK:** in the message window, the `# PBIT` list says **OK** on every line, or `--` (not
tested yet), or **CHECK** for CALIBRATED (that's done in part 13). A line saying **BAD** names
the problem: see the table in 10.8.

### 10.5 The SENSORS page

- [ ] Tap TEST once. The **SENSORS** page shows:

| Line | Should read |
|---|---|
| SPEED | 0 MPH |
| ENGINE | 0 RPM |
| GAS PEDAL | about 55 % (the stand-in) |
| TRANS TEMP | room temperature |
| BATTERY | your bench supply's voltage, ±0.3 V |
| SIDE FORCE | about 0.00 G (keep the table still) |
| BRAKE / LEVER | BRAKE OFF, NOT IN D |

- [ ] Touch a wire from a **12V** terminal to **STP**: it says **BRAKE ON**. Take it away: **OFF**.
- [ ] Touch the wire from **12V** to **D**: it says **LEVER IN D**. Take it away.
- [ ] Tap TEST twice more to get back to the main page.

**If a line is wrong:** gas pedal → the stand-in resistors and step 4; trans temp → the ATF
terminals and step 5; brake or lever → STP/D and step 4; side force jumping about → the gyro,
step 5.

### 10.6 The switches

- [ ] Flip **ON/OFF on** (only ECO on): the screen says **NOT READY / NOT CALIBRATED**. That's
  correct: it stays locked until part 13.
- [ ] Turn **SPORT** on as well: after a second, **MODE ERROR**. Turn SPORT off.
- [ ] Turn **ECO** off too (no mode on): after a second, **PICK MODE**. Turn ECO back on.
- [ ] Flip **ON/OFF off**: back to **TCU IS OFF**.

**If a switch does nothing:** check its core in the dash cable (part 8's check) and its
terminal (step 5's check).

### 10.7 The self-test, with the calibration helper

The self-test checks every part of the system in about a minute, asking you to do things as it
goes. The **calibration helper** records it at the same time, and uses the solenoid currents to
set the current sensors.

**Get the helper ready (once):**
- [ ] Install **Python 3** (python.org → Downloads). On Windows, tick **"Add Python to PATH"**
  in the installer.
- [ ] Open a terminal (Windows: Command Prompt; Mac: Terminal) and type:
  `pip install pyserial`
- [ ] In the terminal, go to this project's folder (type `cd ` and drag the folder into the
  window, then press Enter).
- [ ] **Close the Arduino Serial Monitor.** Only one program can use the USB port at a time.

**Run it:**
- [ ] Meter on volts across a **12V** terminal and **GND**. Write down the reading.
- [ ] In the terminal, type: `python3 tools/calibrate.py bench` (on Windows: `py tools\calibrate.py bench`).
- [ ] Type the meter reading when it asks. For the resistor question, press Enter (or measure one
  big resistor on Ω and type that).
- [ ] **ON/OFF on**, only ECO on. **Hold TEST for 2 seconds.** The screen says **TESTING**.
- [ ] The screen flashes (that's the screen test), then the relays click and each solenoid
  channel is tested in turn.
- [ ] Then it asks you to do things. Do each one when it appears (you have 8 seconds; a quick
  TEST press skips one):

| The screen says | You do |
|---|---|
| UPSHIFT THE LEVER | Pull the shifter lever (upshift) |
| DOWNSHIFT THE LEVER | Push it (downshift) |
| TURN ON ONLY ECO | Only ECO on |
| TURN ON ONLY SPORT | Only SPORT on |
| TURN ON ONLY MANUAL | Only MANUAL on |
| PRESS THE BRAKE | Touch a wire from a **12V** terminal to **STP** for a second |
| TURN ON/OFF OFF | Flip ON/OFF off. This checks the switch cuts the relays by itself. |

- [ ] The Mega then restarts itself on purpose (it's testing its safety reset). The screen goes
  blank for a moment and comes back.
- [ ] The helper shows the current-sensor number, old and new, and asks to write it. Type **y**.
- [ ] Open the Arduino IDE and press **Upload** again, so the Mega gets the new number.

### 10.8 The result

✅ **CHECK:** the screen says **ALL OK**. Two lines say **CHECK**, which is normal:
- **SCREEN**: it's asking whether you saw the screen flash. Did you? Then it's fine.
- **CALIBRATED**: that's done in part 13.

- [ ] Hold TEST for 2 seconds once more and run the whole test again. This time each solenoid
  reads about **0.8 A** (your bench voltage ÷ 15).

**If a line says BAD** (tap TEST to page through the details):

| BAD line | What to check |
|---|---|
| BATTERY | The bench supply: must be 10.5–16 V |
| GAS PEDAL | The stand-in resistors (10.1), then step 4 |
| TEMP PROBE | The ATF terminals, then step 5 |
| GYRO | Step 5 |
| SHIFTER | A shifter switch stuck on: part 8's shifter check |
| SOLENOID 1 / SOLENOID 2 / LOCKUP SOL | That channel: its bench wire (SOL → LD), its big resistor, then step 3 |
| RELAYS | A relay contact stuck: steps 2 and 3 |
| SHIFT UP / SHIFT DOWN | The shifter cable and the SHIFT terminals, then step 5 |
| ECO / SPORT / MANUAL SWITCH | That switch's core in the dash cable and the DASH terminals, then step 5 |
| BRAKE | The STP terminal, then step 4 |
| ON/OFF CUT | C7 and C8 at the DASH terminals 7 and 8, and the ON/OFF switch's second half (part 8) |
| RESTARTS | The Mega froze and restarted itself since power-on. Power off and on; if it comes back, upload the software again |
| SAFETY RESET | The Mega didn't come back by itself after restarting. Re-upload; if it keeps happening, see spec §9 (bootloader) |

**If it says STOPPED BECAUSE…**, the next line says why (for example **ON/OFF IS OFF**: it was
turned off before the last prompt). Fix that and run it again.

- [ ] **Bench test passed.** Power off. Take out the three bench wires (SOL1–3 → LD1–3) and the
  gas pedal stand-in.

---

## Part 11 — Close the box

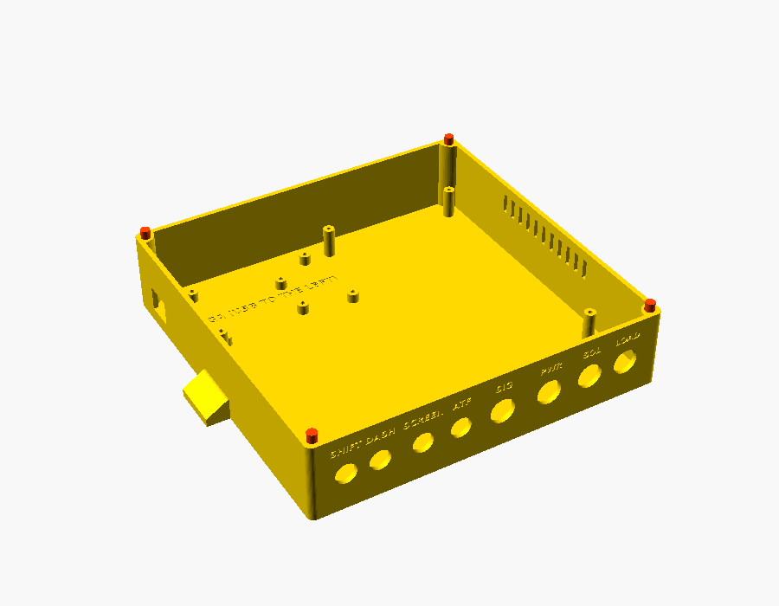
[picture p98: docs/build/box-1.png]
Box step 1


- [ ] **11.1** Press the 4 brass inserts into the box's corner posts with the soldering iron.

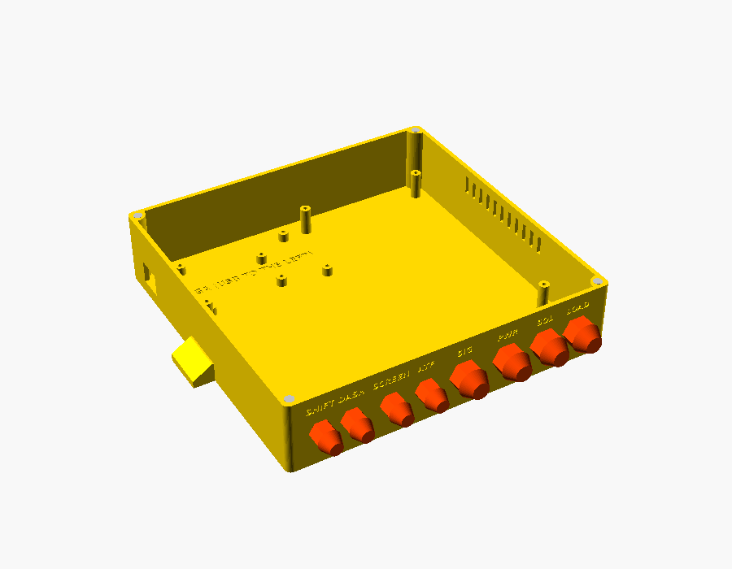
[picture p99: docs/build/box-2.png]
Box step 2


- [ ] **11.2** Fit the 8 glands in the round holes in the front wall. Each hole has its name above
  it. Small glands go in **SHIFT, DASH, SCREEN, ATF**. Big glands go in **SIG, PWR, SOL, LOAD**.

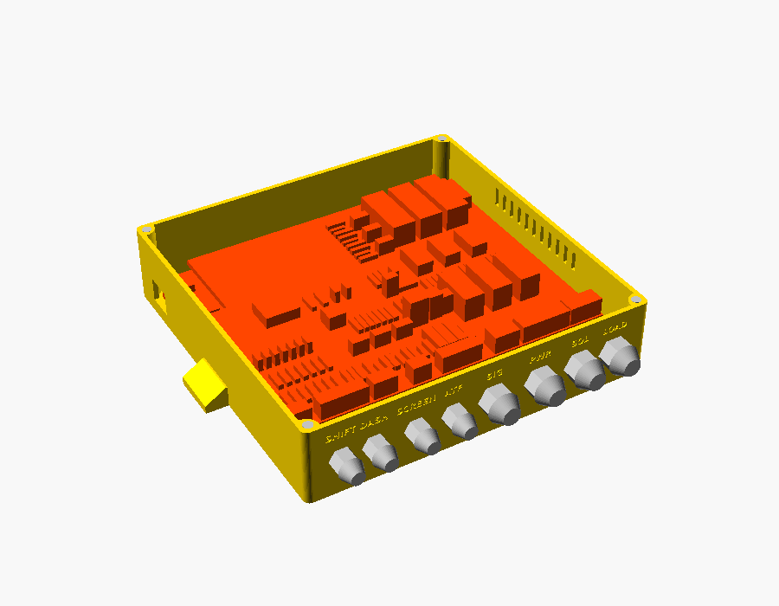
[picture p100: docs/build/box-3.png]
Box step 3


- [ ] **11.3** Unplug the board from the Mega. Screw the Mega onto its 6 short posts (M3 × 6),
  USB socket to the left wall: its name is printed on the floor. Plug the board back onto the Mega
  and screw it to its 5 tall posts (M3 × 6).
- [ ] **11.4** Make the cable ends, one gland at a time. Push the cable through its gland, screw
  its wires into their terminals inside, then fit the **box half** of its plug on the outside end,
  about 30 cm out ([which pin is which](03-wiring-guide.md)):

| Gland | Cable | Inside, to | Plug outside |
|---|---|---|---|
| SHIFT | 3-core from the shifter base | UP, DN, GND | none (goes straight to the shifter base) |
| DASH | 8-core from the dash pod | ECO, SPT, MAN, TST, ON, GND, C7, C8 | none (straight to the dash pod) |
| SCREEN | 4-core from the dash pod | 5V, GND, SDA, SCL | none (straight to the dash pod) |
| ATF | 3-core | 5V, GND, DQ | X6, 3-way |
| SIG | 7 thin wires: D, STP, E1, SPD, TAC, VTA, E2 | D, STP, E1, SPD, TAC, VTA, E2 | X3, 8-way |
| PWR | red, red, black (thick) | 12V (drivers, 5 A fuse), 12V (logic, 2 A fuse), GND | X1, 3-way |
| SOL | 6 wires (thick) | ECU1, ECU2, ECU3, SOL1, SOL2, SOL3 | X2, 6-way |
| LOAD | the heatsink's 4 wires | LD1, LD2, LD3, GND | none (straight to the heatsink) |

✅ **CHECK each cable as soon as it's done** (meter on beep, nothing plugged in):
- [ ] **Every wire:** one probe on the plug's pin outside, the other on its terminal inside:
  beep. Pin 1 goes to the first terminal of its group (counting from the left), pin 2 to the
  second, and so on.
- [ ] **No crossed wires:** no plug pin beeps to the pin next to it.

  These pairs **should** beep, because they're joined inside the box:
  - **X2:** pins 1 and 4, 2 and 5, 3 and 6 (the relays at rest join them).
  - **X3:** pin 3 (E1) beeps to ground (any GND terminal).
- [ ] For cables without a plug (SHIFT, DASH, SCREEN, LOAD), repeat the far-end check from
  part 8, 7 or 9, now through the box's terminals.

- [ ] **11.5** Make the **BYPASS plug**: a 6-way plug that fits the car's half of X2, with three
  short wires inside: **1 to 4, 2 to 5, 3 to 6**. Label it **BYPASS**. Keep it in the glovebox.
  If you ever have a problem, unplug the TCU and plug this in: the car is back to completely
  stock.

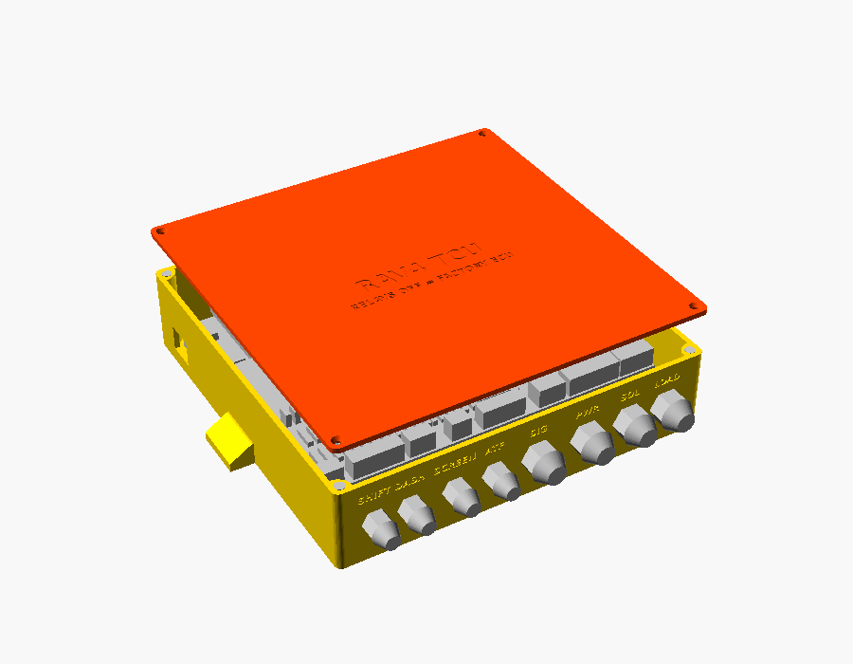
[picture p101: docs/build/box-4.png]
Box step 4


- [ ] **11.6** Tighten every gland. Screw the lid on (4 × M3 × 10 countersunk).

✅ **CHECK, it still works through the plugs** (the full self-test comes again in the car,
12.4): plug the ATF probe into **X6**, and bench 12 V into the box's half of **X1**: **+** to
pins 1 and 2, **−** to pin 3.
- [ ] The screen comes up as in 10.4, with the room temperature.
- [ ] The SENSORS page (tap TEST): BATTERY reads your bench voltage, SIDE FORCE about 0.00 G.
- [ ] ON/OFF **on**: **NOT READY / NOT CALIBRATED**. ON/OFF **off**: **TCU IS OFF**.

---

## Part 12 — Put it in the car

**One job per evening.** After each job the car must drive exactly as before. The TCU can't take
over until the very last job, and only when its ON/OFF switch is on.

**Disconnect the battery's negative (−) terminal before every job.** Solder and heat-shrink
every join. Don't use the clip-on "Scotch-lock" taps.

### 12.1 Mount
- [ ] Bolt the box **flat** in the spot from part 0. Check it with a level app on your phone:
  within 5°.
- [ ] Optional: a USB extension cable from the box into the glovebox, for the laptop.
- [ ] Bolt the heatsink where air moves, at least 50 mm from plastic and from other wires. **It
  gets hot.**

### 12.2 Power
- [ ] Fuse tap into the **key-ON fuse** from part 0.
- [ ] Fuse tap → **5 A** inline fuse → X1 pin 1.
- [ ] Fuse tap → **2 A** inline fuse → X1 pin 2.
- [ ] X1 pin 3 → a body ground bolt (on bare metal).

✅ **CHECK before plugging X1 into the box** (car-side plug):
- [ ] Battery still off, meter on beep: **pin 3** beeps to bare metal on the body. Pins 1 and 2
  do **not** beep to the body.
- [ ] Battery back on, meter on volts, black probe on pin 3:
  - key OFF: pins 1 and 2 read **0 V**
  - key ON: pins 1 and 2 read **about 12 V**
- [ ] Key OFF. Plug X1 into the box. **ON/OFF off.** Key ON.

✅ **CHECK:** the screen lights up within a second. Key OFF: it goes dark.
**If it doesn't light up:** check both fuses, and the ground bolt is on bare metal.

### 12.3 Signal wires
- [ ] At the engine computer, join a new wire to each wire in your part 0 table (D, STP, E1, SPD,
  TAC, VTA, E2). **Don't cut these**: strip a small window, wrap, solder, heat-shrink.
- [ ] Run them to the X3 plug. Twist SPD and TAC together, and VTA and E2 together.

✅ **CHECK before plugging X3 into the box** (car-side plug, battery on):
- [ ] Meter on beep, battery off: each X3 pin beeps to its engine-computer terminal from your
  part 0 table, and **not** to the pins next to it. Pin 3 (E1) beeps to body ground.
- [ ] Battery on, key ON, engine off, meter on volts, black probe on pin 3 (E1):

| X3 pin | Signal | What you should read |
|---|---|---|
| 1 | D | 0 V in P. **About 12 V** with the lever in D (foot on the brake). |
| 2 | STP | 0 V. **About 12 V** with the brake pressed. |
| 6 | VTA | **0.3–0.8 V** with the pedal up, rising smoothly to **3.2–4.9 V** pressed to the floor. |
| 7 | E2 | **Under 0.1 V** |

- [ ] Engine running (in P): pin 5 (TAC) reads a few volts (a pulse signal; the exact number
  depends on your meter).
- [ ] Key OFF, plug X3 into the box.

✅ **CHECK** (SENSORS page):
- [ ] The gas pedal goes from 0 % to about 100 % as you press the pedal.
- [ ] Engine rpm is about 700–800 at idle.
- [ ] BRAKE shows ON while the pedal is pressed.
- [ ] LEVER IN D shows only with the lever in D.

### 12.4 Dash pod and shifter base
- [ ] **Dash pod mount** on the dash top, driver's side: 2 screws into the dash frame, or VHB tape
  on a cleaned spot, arm pointing up ([details](03-wiring-guide.md#the-dash-pod)).
- [ ] **Hang the pod.** Slide the mount's knuckle between the pod's two tabs. Put the M5 × 25 bolt
  through all three, with the nyloc nut in its hex pocket. Tilt the screen to face you, then
  tighten until it holds that angle over bumps.
- [ ] **Shifter base.** Bolt its bottom plate to the console next to the gear lever (4 bolts, big
  washers). Then screw the base onto it from underneath (4 × M3).
- [ ] Hide all three cables under the trim, running to the box. The dash pod's two cables go
  down behind the dash trim.

✅ **CHECK** (engine off, lever in P, ON/OFF on): hold TEST for 2 seconds and do the prompts.
Every prompt passes. **TEMP PROBE** and the three solenoid lines (**SOLENOID 1**, **SOLENOID 2**,
**LOCKUP SOL**) say **BAD** for now: that's expected, their wires go in next (12.5, 12.6). The
self-test runs once more, complete, in 13.3.

### 12.5 ATF probe (engine cold)
- [ ] Follow the [ATF probe instructions](03-wiring-guide.md#the-atf-temperature-probe): cut the
  **hot** hose, fit the tee, probe pointing sideways, clamps tight.
- [ ] Run the cable through a rubber grommet in the firewall, to X6.
- [ ] **Before plugging in:** meter on beep, each X6 pin beeps to its wire at the probe end
  (red, black, yellow), and none beeps to the body.
- [ ] Engine on. Shift through every gear. Look for drips. Check the transmission fluid level
  when it's hot, and top up.

✅ **CHECK:** the trans temperature on the screen rises as the engine warms up. No drips after
a drive.

### 12.6 Solenoid wires (the last job)
- [ ] Battery off. Check the S1, S2 and SL wires once more with the beep test (on the 4WD
  transmission connector they're pins **B3, B6, B5**).
- [ ] Cut each of the three wires.
- [ ] Engine computer side → X2 pins 1, 2, 3. Transmission side → X2 pins 4, 5, 6.

✅ **CHECK before plugging X2 into the box** (car-side plug, battery off, meter on beep):
- [ ] Pins 1, 2, 3 beep to engine computer terminals **S1, S2, SL** (your part 0 table).
- [ ] Pins 4, 5, 6 beep to transmission connector pins **B3, B6, B5** (unplug that connector to
  reach them, then plug it back).
- [ ] Pins 1–3 do **not** beep to pins 4–6 (the cut is clean), and no pin beeps to the body.
- [ ] Meter on Ω: pins 4, 5, 6 each read **11–15 Ω** to the body (that's the solenoid).

- [ ] Plug in X2. **ON/OFF stays off.**

✅ **CHECK:**
- [ ] Go for a drive. It must feel **exactly** as before.
- [ ] Swap in the **BYPASS** plug and drive again. Also exactly as before.
- [ ] Plug in an OBD-II scanner: **no trouble codes**.

**If anything feels different:** put the BYPASS plug in and check the X2 wiring before going
further.

---

## Part 13 — Calibrate and drive

Two halves. First you teach the TCU your car, with the factory computer still shifting (ON/OFF
off the whole time). Then you test it in four stages, from standing still to the road. **Stop at
the first problem.**

You need: the laptop with the Arduino IDE and Python (part 10), the USB cable from the box (or
its extension in the glovebox), and for 13.2 a **passenger** to work the laptop.

### 13.1 Parked: the gas pedal and the battery

About 5 minutes. Car parked, lever in P, **engine OFF**, key **ON**, ON/OFF off.

- [ ] Plug the laptop into the TCU's USB.
- [ ] In the terminal, in the project folder: `python3 tools/calibrate.py parked`
- [ ] Follow it. It asks you to:
  1. keep your foot off the gas pedal for 3 seconds
  2. press the pedal **all the way down** and hold it for 3 seconds
  3. put the meter on the battery's two terminals and type the reading
- [ ] It shows the new numbers next to the old ones. Type **y** to write them.
- [ ] Arduino IDE: **Upload**.

**If it says PROBLEM:** it says what's wrong in words, usually a wire to check from your
part 0 table. Fix it and run the step again.

### 13.2 A drive: speed and engine rpm

About 30 minutes. ON/OFF stays **off**: the factory computer shifts as normal. **Your passenger
works the laptop**; you just drive.

- [ ] Phone on the dash with a GPS speed app (any free "speedometer" app).
- [ ] Before you set off, your passenger types: `python3 tools/calibrate.py drive`
- [ ] Somewhere quiet and safe, at any point in the drive:
  1. Hold a steady **30 mph** on the GPS for **15 seconds**.
  2. Press the **O/D OFF** button on the gear lever (the O/D OFF light comes on). Hold a steady
     **45 mph** for **20 seconds**. Press O/D OFF again (light off).
  3. On a highway, hold a steady **60 mph** on the GPS for **20 seconds**.
- [ ] Then just drive normally for another 20 minutes or so: some gentle, some normal and some
  brisk starts. (It records the factory computer's shift points, for reference.)
- [ ] Parked again, your passenger presses **Ctrl+C**. The helper asks which speeds you held:
  press Enter for "30 60".
- [ ] It shows the new numbers. Type **y** to write them. Arduino IDE: **Upload**.

**If it says PROBLEM:** it tells you which part of the drive to do again, for example "hold
60 mph for longer". The recording is saved in the `calibration` folder.

### 13.3 Unlock

- [ ] In the terminal: `python3 tools/calibrate.py unlock`. It checks all three steps (bench,
  parked, drive) are done and written, then asks you to type **UNLOCK**.
- [ ] Arduino IDE: **Upload**.

✅ **CHECK:** key ON, engine off, lever in P, only ECO on. Flip ON/OFF on: the screen says
**LEVER NOT IN D** instead of NOT CALIBRATED. Run the self-test (hold TEST 2 s): **ALL OK**, and
CALIBRATED now says **OK**.

### 13.4 Test 1: on jack stands

The TCU drives the transmission for the first time, with the car going nowhere.

**Set up safely:**
- [ ] Level, solid ground. **All four wheels** on jack stands, clear of the ground. Your RAV4 is
  full-time 4WD: **never test with only the front or only the rear up.**
- [ ] Parking brake **off** (it would hold the rear wheels while the front ones turn). Nobody
  near the wheels.
- [ ] ON/OFF **off**, ECO on.

**Go:**
1. [ ] Start the engine in P. The screen shows **STOCK** and the trans temperature.
2. [ ] Foot on the brake, lever to **D**. The big number shows **1** (the factory computer's gear).
3. [ ] Flip **ON/OFF on**. The screen says **TCU ON: TCU IS DOING THE SHIFTING**, with **ECO**.
4. [ ] Release the brake: the wheels creep round slowly.
5. [ ] Press the gas gently until the wheels are doing about **25 mph** (tap TEST for the SENSORS
   page to see the speed). Watch the big number go **1 → 2 → 3**. At each shift the engine rpm
   should drop and the wheels keep turning smoothly.
6. [ ] Lift off and brake gently to a stop. The number comes back down to **1**.
7. [ ] Back up to about 20 mph, then flip **ON/OFF off**. The screen says **TCU OFF** and the
   factory computer carries on. Nothing dramatic should happen. Flip it back **on**.
8. [ ] Stop. Turn **ECO off** and **MANUAL on**: the screen says **MANUAL**. Now you shift: at about
   **10 mph** pull the shifter lever: **2**. At about **20 mph** pull again: **3**. Push it: **2**.
   (Pull too early and it says **NO SHIFT: TOO SLOW**: that's correct.)
9. [ ] In 2nd, at about **30 mph**, push the lever for 1st: the screen says **NO SHIFT: TOO FAST
   FOR THAT GEAR**. That's the engine protection working.
10. [ ] Stop, lever to **P**, ON/OFF **off**, engine off.

**Stop at once (flip ON/OFF off) if** the engine revs up without the wheels speeding up (a
"flare"), there's a clunk or grinding, or the screen says **PROBLEM**. Then check the table at
the end of this part.

### 13.5 Test 2: an empty car park

- [ ] Engine on in P, **ON/OFF off**, ECO on. Lever to D, then flip ON/OFF **on**.
- [ ] **ECO:** drive gently around. Shifts should come early and feel as smooth as stock.
- [ ] **SPORT** (stop first, ECO off, SPORT on): the same loop a bit more briskly. Shifts come
  later. Brake firmly from 25 mph: it shifts down as you slow.
- [ ] **MANUAL** (stop, SPORT off, MANUAL on): shift up and down yourself with the lever, between
  10 and 30 mph.
- [ ] At 15 mph, flip **ON/OFF off**: the factory computer takes straight back over.
- [ ] Stopped, turn **two** mode switches on: after a second, **MODE ERROR**, and the factory
  computer shifts. Fix it: the TCU takes back over by itself.

### 13.6 Test 3: the road

- [ ] A short, familiar route, at a quiet time. A passenger to watch the screen helps.
- [ ] Start in **ECO**. Keep a hand near ON/OFF.
- [ ] Afterwards: the trans temperature stayed sensible (usually 160–200 °F; the screen warns
  from 230 °F), and an OBD-II scanner shows **no trouble codes**.

### 13.7 Test 4: normal driving

- [ ] Use it day to day, in each mode. For the first week, check for trouble codes every few
  days.

✅ **CHECK, at any time:** flip ON/OFF off. The car goes straight back to the factory computer.

### If something isn't right

| What happens | What to do |
|---|---|
| Flare (rpm jumps, the car doesn't speed up), clunk or slip | ON/OFF **off** at once. Then check the X2 wiring with 12.6's check. |
| **PROBLEM: WRONG GEAR** | S1 and S2 are probably swapped. ON/OFF off; recheck 12.6's check (pins 1→S1, 2→S2…). |
| **PROBLEM: SOLENOID WIRE** | A solenoid wire or plug: 12.6's check, and the X2 plug's pins. |
| **PROBLEM: NO SPEED SIGNL** | The SPD wire: 12.3's check. |
| **PROBLEM: PEDAL SENSOR** | The VTA or E2 wire: 12.3's check, then redo 13.1. |
| **PROBLEM: ON/OFF SWITCH** | C7/C8 in the dash cable, or the switch's second half (part 8's check). |
| **PROBLEM: RELAY STUCK** | Engine off, P, ON/OFF on, hold TEST: the self-test re-checks the relays. |
| **PROBLEM: LEVER SENSOR** | The D wire reads D all the time: 12.3's check (pin 1). |
| **STOP FIRST** | Normal: the TCU only takes over on the move when it's sure of the gear. Stop, and it takes over. |
| **WAITING** | ON/OFF was already on at key-on. Flip it off, then on. |
| **NO RPM** | The TAC wire: 12.3's check. It's still safe to drive. |
| **SHIFT UP!** (in MANUAL) | Not a fault: the engine is at the redline and the TCU leaves the upshift to you. Pull the lever. |
| Shifts feel too early or too late | Not a fault: the shift points can be adjusted (spec §6.3). Note the speed and gas pedal position. |
| Anything you're unsure about | ON/OFF off, and fit the BYPASS plug until it's sorted. |

---

*The board steps and their pictures are drawn from the board design by
[`tools/pcb.py`](../tools/pcb.py) and [`tools/build_steps.py`](../tools/build_steps.py), the 3D pictures from
the models in [`hardware/`](../hardware/), and the shopping list from
[`tools/shopping_list.py`](../tools/shopping_list.py).*

---

*RAV4 TCU by gamer927 · [CC BY-NC-SA 4.0](../LICENSE): free to build, not to sell.*
