gamer927/rav4/docs/build/board-steps.md

<!-- Generated by tools/boards.py - do not edit by hand. -->

<!-- STEP P1 -->
#### P1.1 — Place 6 parts

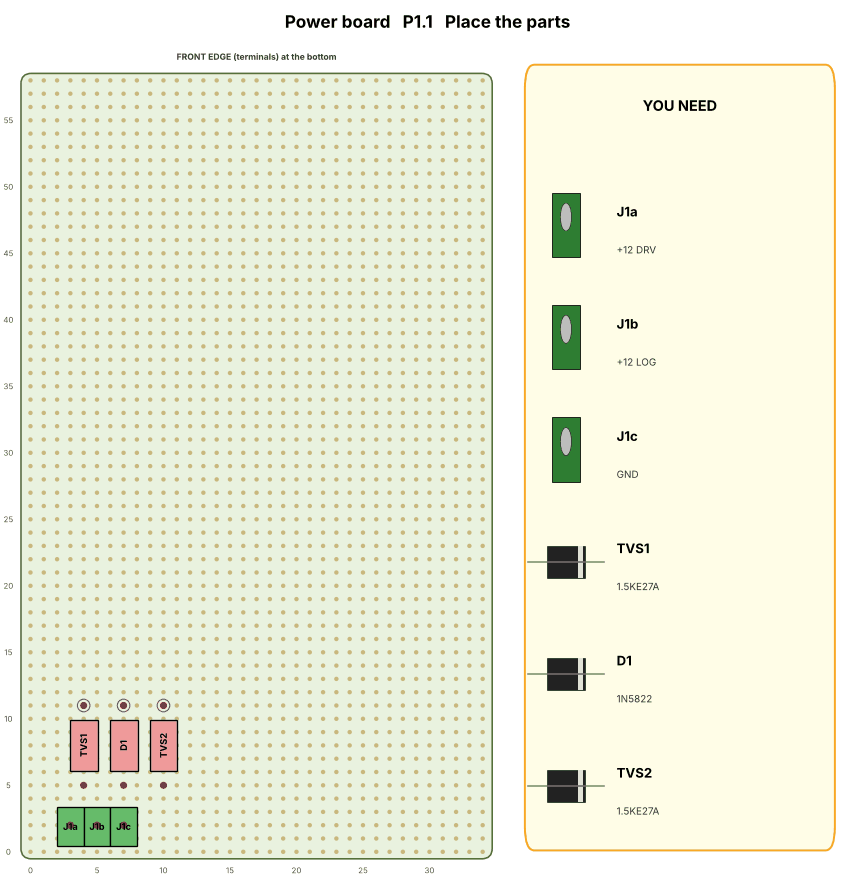
[picture p102: docs/build/power-P1-1.png]
P1.1


- [ ] **J1a**: +12 DRV screw terminal → col 3, row 2
- [ ] **J1b**: +12 LOG screw terminal → col 5, row 2
- [ ] **J1c**: GND screw terminal → col 7, row 2
- [ ] **TVS1**: 1.5KE27A diode → col 4, row 5 and col 4, row 11. Stripe towards the back
- [ ] **D1**: 1N5822 diode → col 7, row 5 and col 7, row 11. Stripe towards the back
- [ ] **TVS2**: 1.5KE27A diode → col 10, row 5 and col 10, row 11. Stripe towards the back

Push the legs through, bend them out a little underneath, solder, snip.

#### P1.2 — Place 6 parts

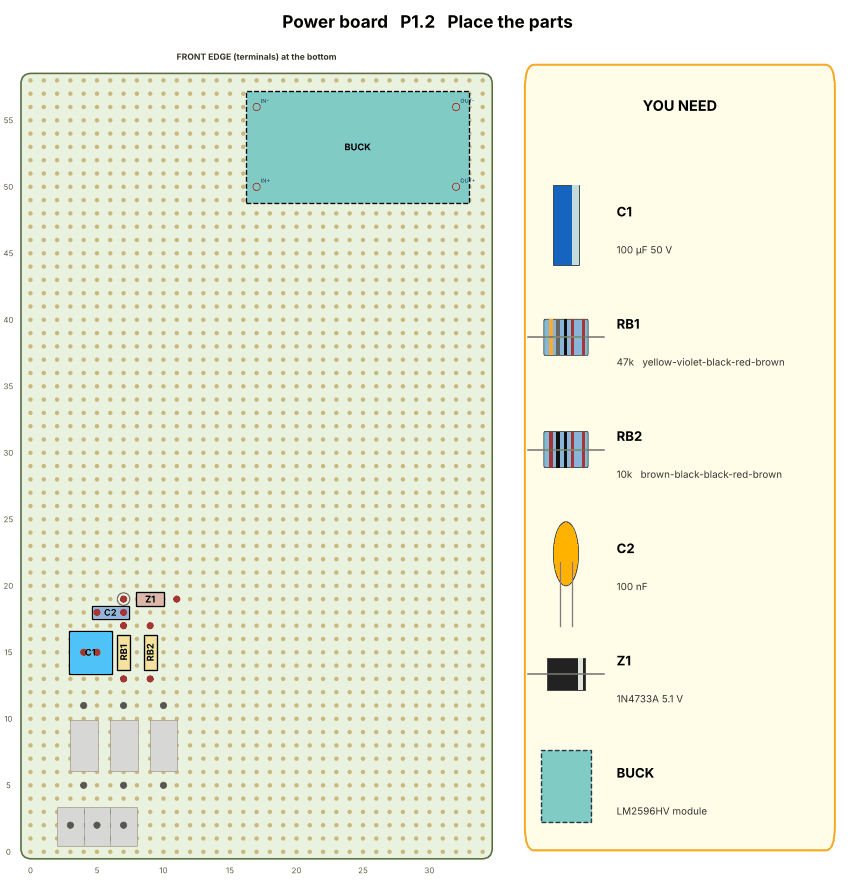
[picture p103: docs/build/power-P1-2.png]
P1.2


- [ ] **C1**: 100 µF 50 V capacitor → col 4, row 15 and col 5, row 15. Long leg left, striped side right
- [ ] **RB1**: 47k resistor (bands: yellow-violet-black-red-brown) → col 7, row 13 and col 7, row 17
- [ ] **RB2**: 10k resistor (bands: brown-black-black-red-brown) → col 9, row 13 and col 9, row 17
- [ ] **C2**: 100 nF capacitor → col 5, row 18 and col 7, row 18
- [ ] **Z1**: 1N4733A 5.1 V diode → col 11, row 19 and col 7, row 19. Stripe left
- [ ] **BUCK**: LM2596HV module → stick it down with foam tape where shown. Set to 5.0 V before wiring 5 V anywhere

Push the legs through, bend them out a little underneath, solder, snip.

#### P1.3 — Solder 6 wires (bottom side)

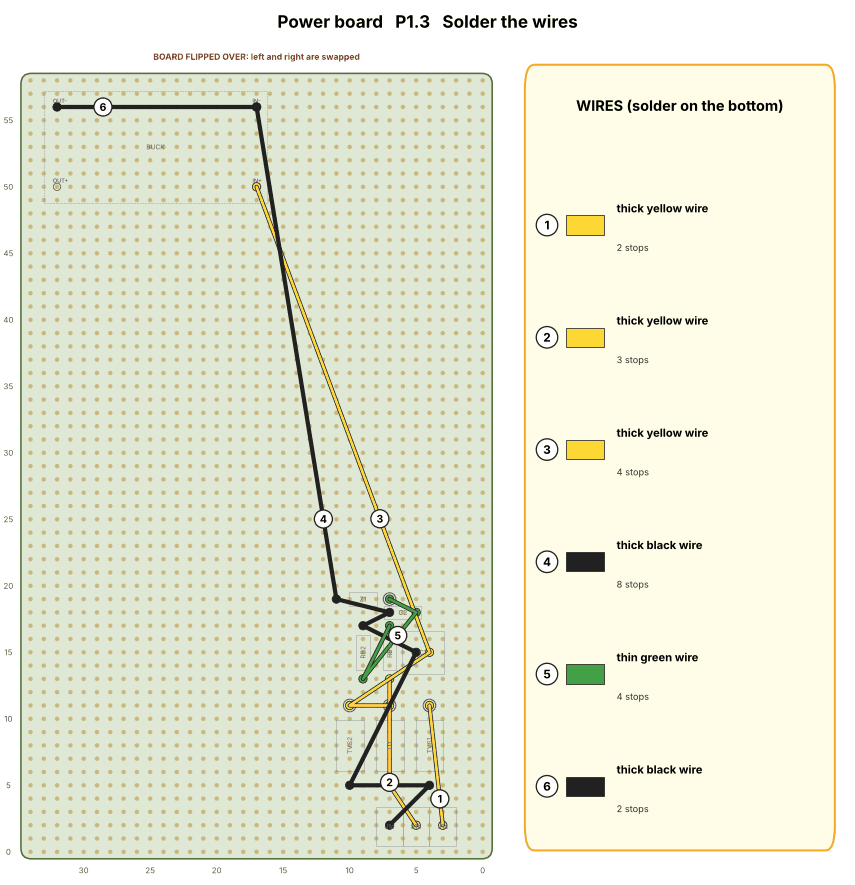
[picture p104: docs/build/power-P1-3.png]
P1.3


- [ ] **1** thick yellow wire: **J1a** (+12 DRV) → **TVS1** stripe end
- [ ] **2** thick yellow wire: **J1b** (+12 LOG) → **D1** plain end → **RB1** at col 7, row 13
- [ ] **3** thick yellow wire: **D1** stripe end → **TVS2** stripe end → **C1** long leg → **BUCK** IN+
- [ ] **4** thick black wire: **J1c** (GND) → **TVS1** plain end → **TVS2** plain end → **C1** short leg → **RB2** at col 9, row 17 → **C2** at col 7, row 18 → **Z1** plain end → **BUCK** IN-
- [ ] **5** thin green wire: **RB1** at col 7, row 17 → **RB2** at col 9, row 13 → **C2** at col 5, row 18 → **Z1** stripe end
- [ ] **6** thick black wire: **BUCK** IN- → **BUCK** OUT-

#### P1 — Meter check (power off)

**Every wire:** meter on beep. Hold one probe on the wire's **first** stop and keep it there. Touch the other probe to **each** of its other stops: every one must beep. (This finds a stop that didn't get soldered.)

- [ ] P1.3 wire 1 (yellow): from **J1a** (+12 DRV), 1 beep
- [ ] P1.3 wire 2 (yellow): from **J1b** (+12 LOG), 2 beeps
- [ ] P1.3 wire 3 (yellow): from **D1** stripe end, 3 beeps
- [ ] P1.3 wire 4 (black): from **J1c** (GND), 7 beeps
- [ ] P1.3 wire 5 (green): from **RB1** at col 7, row 17, 3 beeps
- [ ] P1.3 wire 6 (black): from **BUCK** IN-, 1 beep

**No shorts:** these pairs must **not** beep. (A short chirp that stops straight away is fine: that's a capacitor filling up. A beep that keeps going is a short: find the solder blob before you go on.)

- [ ] **J1a** (+12 DRV) and **J1c** (GND): 12 V (drivers) to ground
- [ ] **J1b** (+12 LOG) and **J1c** (GND): 12 V to ground

<!-- STEP P2 -->
#### P2.1 — Place 2 parts

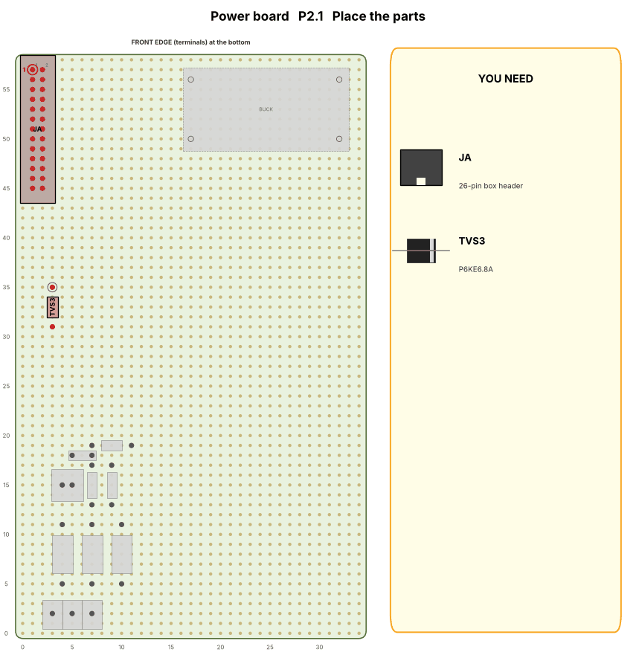
[picture p105: docs/build/power-P2-1.png]
P2.1


- [ ] **JA**: 26-pin box header (ribbon socket) → pin 1 in col 1, row 57. Notch facing the left edge; the square pad (pin 1) at the back
- [ ] **TVS3**: P6KE6.8A diode → col 3, row 31 and col 3, row 35. Stripe towards the back

Push the legs through, bend them out a little underneath, solder, snip.

#### P2.2 — Solder 4 wires (bottom side)

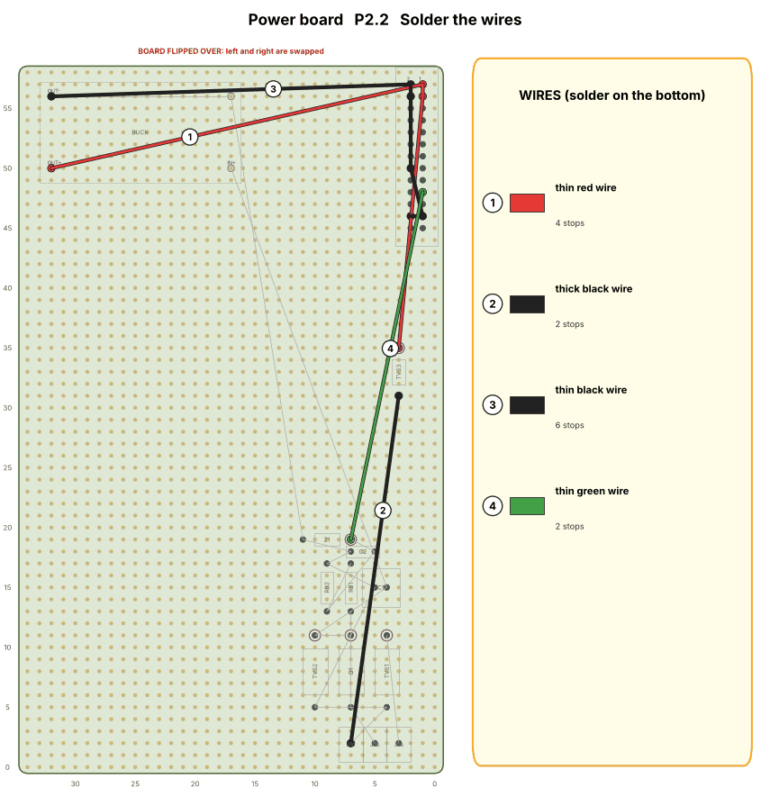
[picture p106: docs/build/power-P2-2.png]
P2.2


- [ ] **1** thin red wire: **BUCK** OUT+ → **JA** pin 1 → **JA** pin 3 → **TVS3** stripe end
- [ ] **2** thick black wire: **TVS3** plain end → **J1c** (GND)
- [ ] **3** thin black wire: **BUCK** OUT- → **JA** pin 2 → **JA** pin 4 → **JA** pin 16 → **JA** pin 23 → **JA** pin 24
- [ ] **4** thin green wire: **Z1** stripe end → **JA** pin 19

#### P2 — Meter check (power off)

**Every wire:** meter on beep. Hold one probe on the wire's **first** stop and keep it there. Touch the other probe to **each** of its other stops: every one must beep. (This finds a stop that didn't get soldered.)

- [ ] P2.2 wire 1 (red): from **BUCK** OUT+, 3 beeps
- [ ] P2.2 wire 2 (black): from **TVS3** plain end, 1 beep
- [ ] P2.2 wire 3 (black): from **BUCK** OUT-, 5 beeps
- [ ] P2.2 wire 4 (green): from **Z1** stripe end, 1 beep

**No shorts:** these pairs must **not** beep. (A short chirp that stops straight away is fine: that's a capacitor filling up. A beep that keeps going is a short: find the solder blob before you go on.)

- [ ] **J1a** (+12 DRV) and **J1c** (GND): 12 V (drivers) to ground
- [ ] **J1b** (+12 LOG) and **J1c** (GND): 12 V to ground
- [ ] **JA** pin 1 and **JA** pin 2: 5 V to ground
- [ ] **J1a** (+12 DRV) and **JA** pin 1: 12 V to 5 V

<!-- STEP P3 -->
#### P3.1 — Place 6 parts

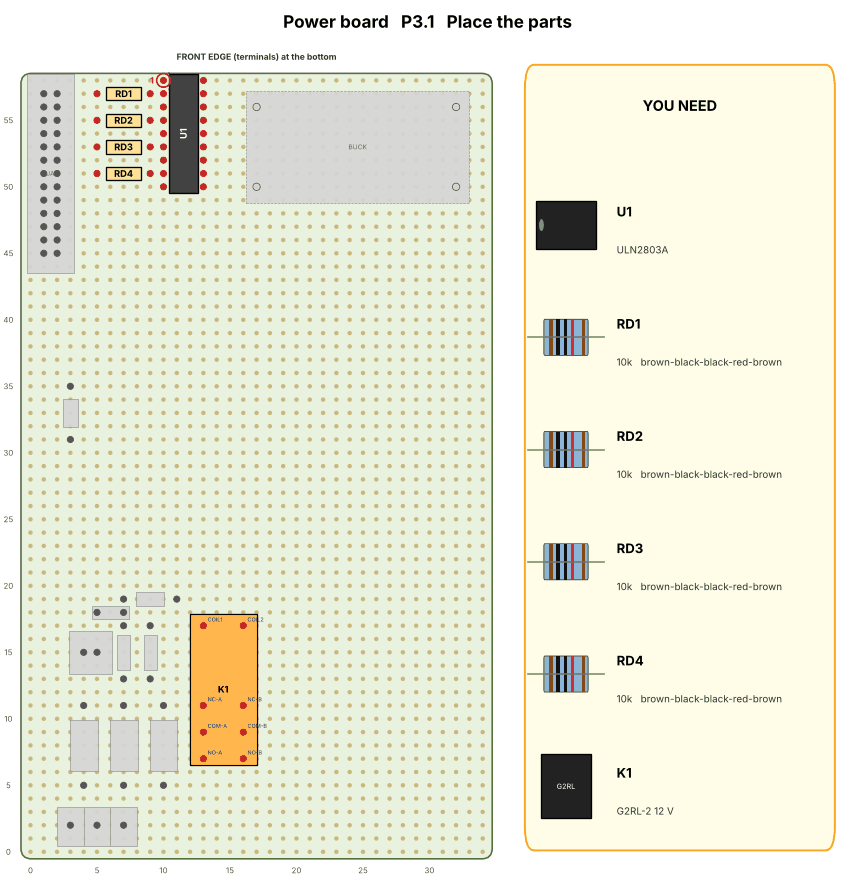
[picture p107: docs/build/power-P3-1.png]
P3.1


- [ ] **U1**: ULN2803A chip → pin 1 in col 10, row 58. Notch or dot at the back-left
- [ ] **RD1**: 10k resistor (bands: brown-black-black-red-brown) → col 5, row 57 and col 9, row 57
- [ ] **RD2**: 10k resistor (bands: brown-black-black-red-brown) → col 5, row 55 and col 9, row 55
- [ ] **RD3**: 10k resistor (bands: brown-black-black-red-brown) → col 5, row 53 and col 9, row 53
- [ ] **RD4**: 10k resistor (bands: brown-black-black-red-brown) → col 5, row 51 and col 9, row 51
- [ ] **K1**: G2RL-2 12 V relay → one coil pin in col 13, row 17. End with 2 pins at the back

Push the legs through, bend them out a little underneath, solder, snip.

#### P3.2 — Place 6 parts

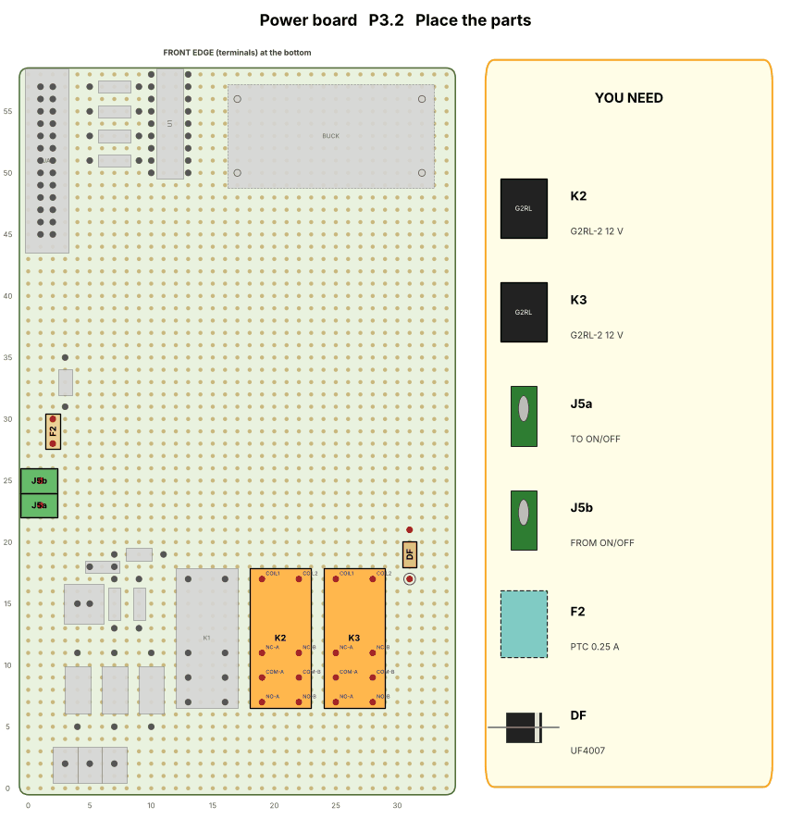
[picture p108: docs/build/power-P3-2.png]
P3.2


- [ ] **K2**: G2RL-2 12 V relay → one coil pin in col 19, row 17. End with 2 pins at the back
- [ ] **K3**: G2RL-2 12 V relay → one coil pin in col 25, row 17. End with 2 pins at the back
- [ ] **J5a**: TO ON/OFF screw terminal → col 1, row 23
- [ ] **J5b**: FROM ON/OFF screw terminal → col 1, row 25
- [ ] **F2**: PTC 0.25 A resettable fuse → col 2, row 28 and col 2, row 30. Either way round
- [ ] **DF**: UF4007 diode → col 31, row 21 and col 31, row 17. Stripe towards the front

Push the legs through, bend them out a little underneath, solder, snip.

#### P3.3 — Place 4 parts

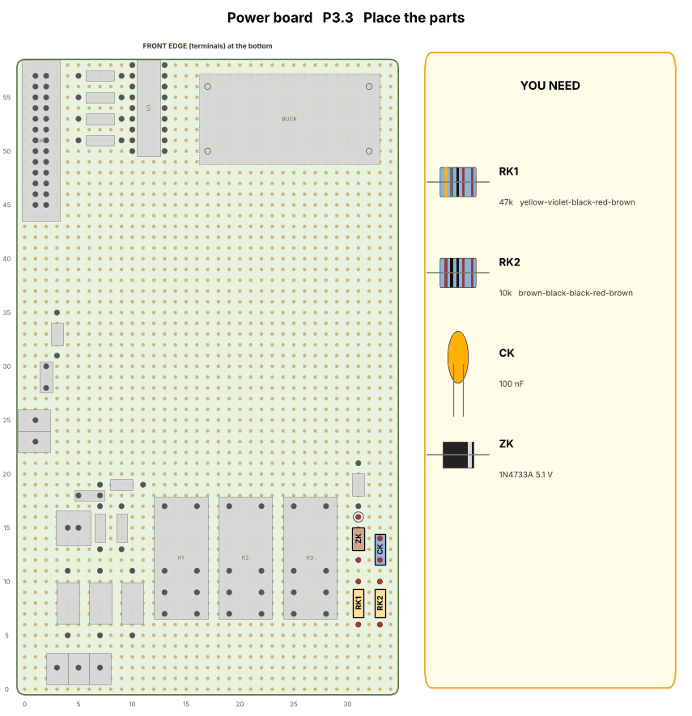
[picture p109: docs/build/power-P3-3.png]
P3.3


- [ ] **RK1**: 47k resistor (bands: yellow-violet-black-red-brown) → col 31, row 6 and col 31, row 10
- [ ] **RK2**: 10k resistor (bands: brown-black-black-red-brown) → col 33, row 6 and col 33, row 10
- [ ] **CK**: 100 nF capacitor → col 33, row 12 and col 33, row 14
- [ ] **ZK**: 1N4733A 5.1 V diode → col 31, row 12 and col 31, row 16. Stripe towards the back

Push the legs through, bend them out a little underneath, solder, snip.

#### P3.4 — Solder 6 wires (bottom side)

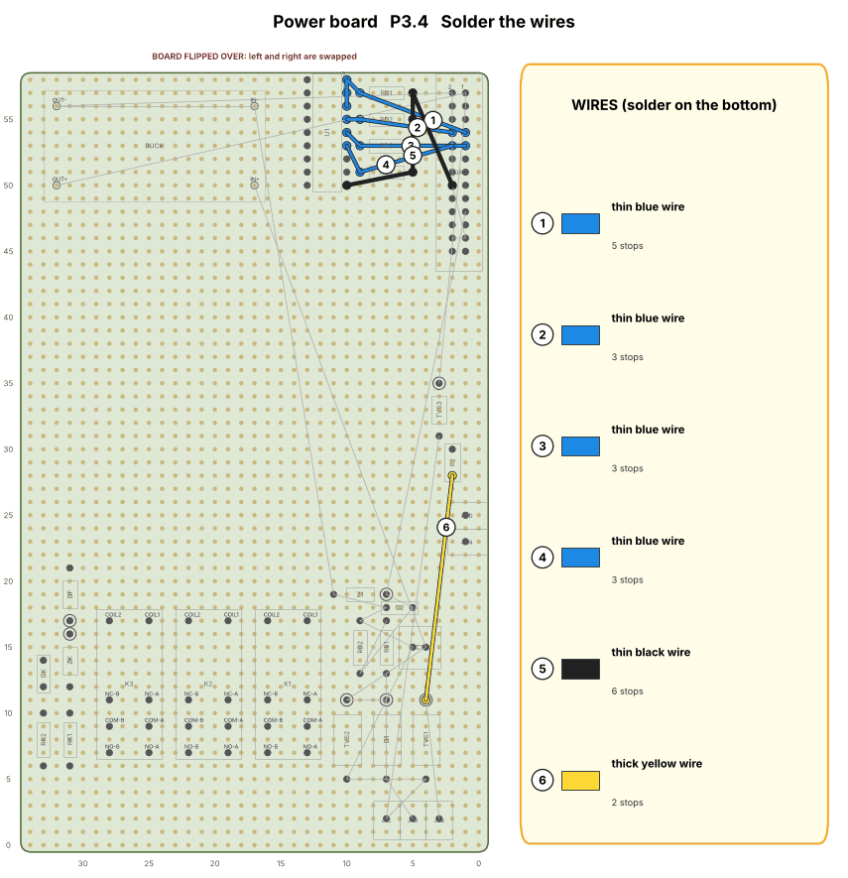
[picture p110: docs/build/power-P3-4.png]
P3.4


- [ ] **1** thin blue wire: **JA** pin 7 → **RD1** at col 9, row 57 → **U1** pin 1 → **U1** pin 2 → **U1** pin 3
- [ ] **2** thin blue wire: **JA** pin 8 → **RD2** at col 9, row 55 → **U1** pin 4
- [ ] **3** thin blue wire: **JA** pin 9 → **RD3** at col 9, row 53 → **U1** pin 5
- [ ] **4** thin blue wire: **JA** pin 10 → **RD4** at col 9, row 51 → **U1** pin 6
- [ ] **5** thin black wire: **JA** pin 16 → **RD1** at col 5, row 57 → **RD2** at col 5, row 55 → **RD3** at col 5, row 53 → **RD4** at col 5, row 51 → **U1** pin 9
- [ ] **6** thick yellow wire: **TVS1** stripe end → **F2** at col 2, row 28

#### P3.5 — Solder 6 wires (bottom side)

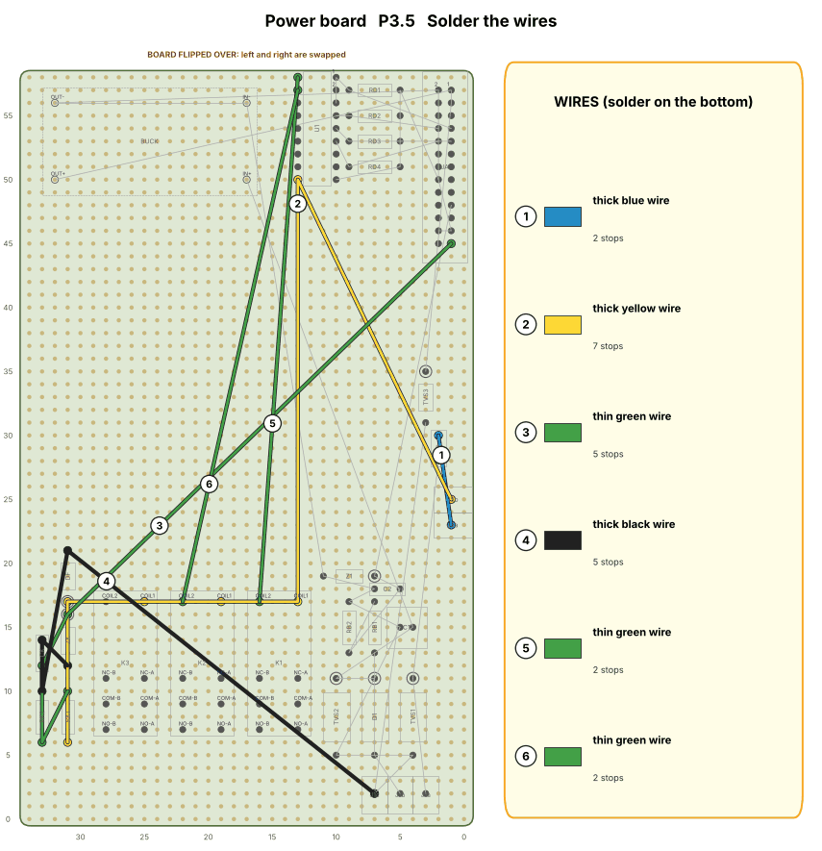
[picture p111: docs/build/power-P3-5.png]
P3.5


- [ ] **1** thick blue wire: **F2** at col 2, row 30 → **J5a** (TO ON/OFF)
- [ ] **2** thick yellow wire: **J5b** (FROM ON/OFF) → **U1** pin 10 → **K1** at col 13, row 17 → **K2** at col 19, row 17 → **K3** at col 25, row 17 → **DF** stripe end → **RK1** at col 31, row 6
- [ ] **3** thin green wire: **RK1** at col 31, row 10 → **RK2** at col 33, row 6 → **CK** at col 33, row 12 → **ZK** stripe end → **JA** pin 25
- [ ] **4** thick black wire: **J1c** (GND) → **DF** plain end → **RK2** at col 33, row 10 → **CK** at col 33, row 14 → **ZK** plain end
- [ ] **5** thin green wire: **U1** pin 18 → **K1** at col 16, row 17
- [ ] **6** thin green wire: **U1** pin 17 → **K2** at col 22, row 17

#### P3.6 — Solder 1 wire (bottom side)

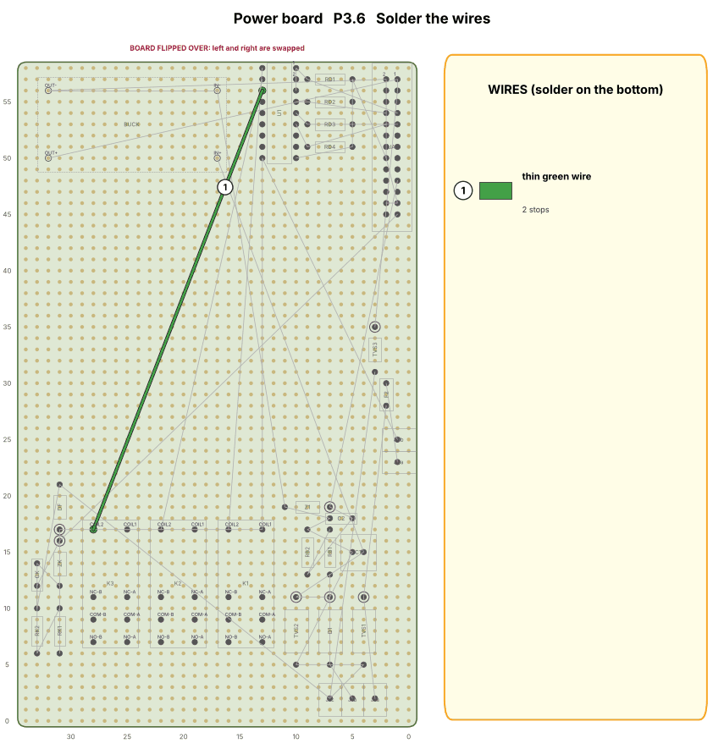
[picture p112: docs/build/power-P3-6.png]
P3.6


- [ ] **1** thin green wire: **U1** pin 16 → **K3** at col 28, row 17

#### P3 — Meter check (power off)

**Every wire:** meter on beep. Hold one probe on the wire's **first** stop and keep it there. Touch the other probe to **each** of its other stops: every one must beep. (This finds a stop that didn't get soldered.)

- [ ] P3.4 wire 1 (blue): from **JA** pin 7, 4 beeps
- [ ] P3.4 wire 2 (blue): from **JA** pin 8, 2 beeps
- [ ] P3.4 wire 3 (blue): from **JA** pin 9, 2 beeps
- [ ] P3.4 wire 4 (blue): from **JA** pin 10, 2 beeps
- [ ] P3.4 wire 5 (black): from **JA** pin 16, 5 beeps
- [ ] P3.4 wire 6 (yellow): from **TVS1** stripe end, 1 beep
- [ ] P3.5 wire 1 (blue): from **F2** at col 2, row 30, 1 beep
- [ ] P3.5 wire 2 (yellow): from **J5b** (FROM ON/OFF), 6 beeps
- [ ] P3.5 wire 3 (green): from **RK1** at col 31, row 10, 4 beeps
- [ ] P3.5 wire 4 (black): from **J1c** (GND), 4 beeps
- [ ] P3.5 wire 5 (green): from **U1** pin 18, 1 beep
- [ ] P3.5 wire 6 (green): from **U1** pin 17, 1 beep
- [ ] P3.6 wire 1 (green): from **U1** pin 16, 1 beep

**No shorts:** these pairs must **not** beep. (A short chirp that stops straight away is fine: that's a capacitor filling up. A beep that keeps going is a short: find the solder blob before you go on.)

- [ ] **J1a** (+12 DRV) and **J1c** (GND): 12 V (drivers) to ground
- [ ] **J1b** (+12 LOG) and **J1c** (GND): 12 V to ground
- [ ] **JA** pin 1 and **JA** pin 2: 5 V to ground
- [ ] **J1a** (+12 DRV) and **JA** pin 1: 12 V to 5 V
- [ ] **J5b** (FROM ON/OFF) and **J1c** (GND): relay power to ground

<!-- STEP P4 -->
#### P4.1 — Place 6 parts

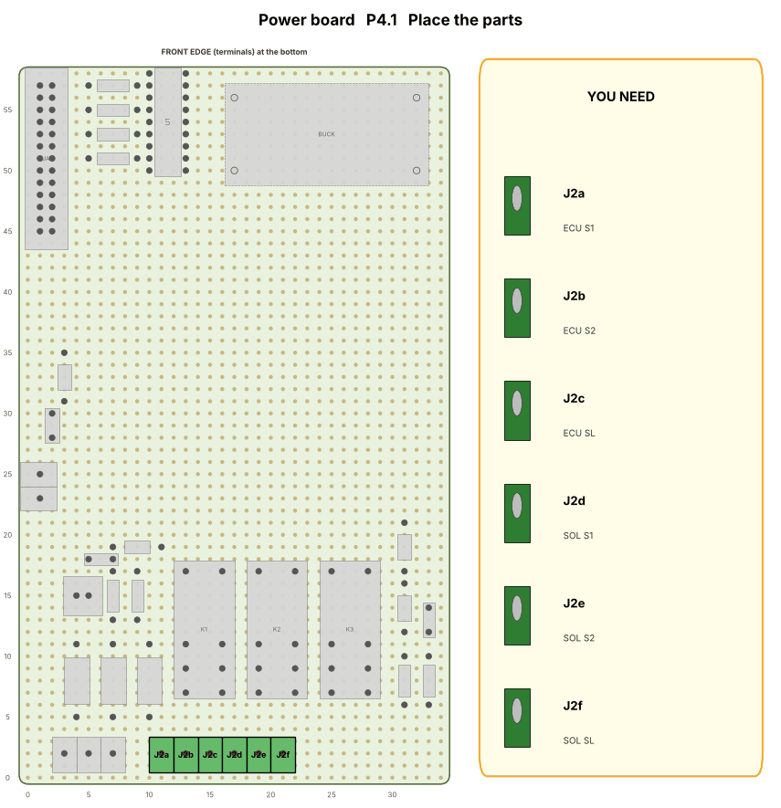
[picture p113: docs/build/power-P4-1.png]
P4.1


- [ ] **J2a**: ECU S1 screw terminal → col 11, row 2
- [ ] **J2b**: ECU S2 screw terminal → col 13, row 2
- [ ] **J2c**: ECU SL screw terminal → col 15, row 2
- [ ] **J2d**: SOL S1 screw terminal → col 17, row 2
- [ ] **J2e**: SOL S2 screw terminal → col 19, row 2
- [ ] **J2f**: SOL SL screw terminal → col 21, row 2

Push the legs through, bend them out a little underneath, solder, snip.

#### P4.2 — Place 4 parts

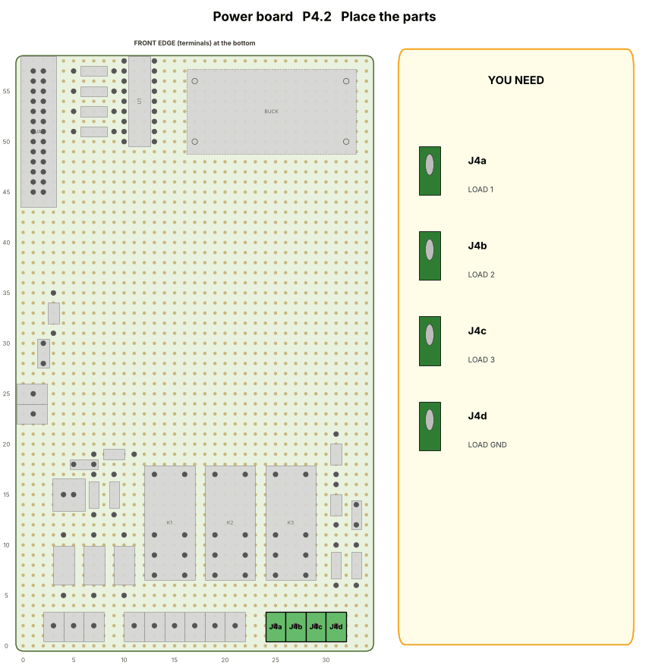
[picture p114: docs/build/power-P4-2.png]
P4.2


- [ ] **J4a**: LOAD 1 screw terminal → col 25, row 2
- [ ] **J4b**: LOAD 2 screw terminal → col 27, row 2
- [ ] **J4c**: LOAD 3 screw terminal → col 29, row 2
- [ ] **J4d**: LOAD GND screw terminal → col 31, row 2

Push the legs through, bend them out a little underneath, solder, snip.

#### P4.3 — Solder 6 wires (bottom side)

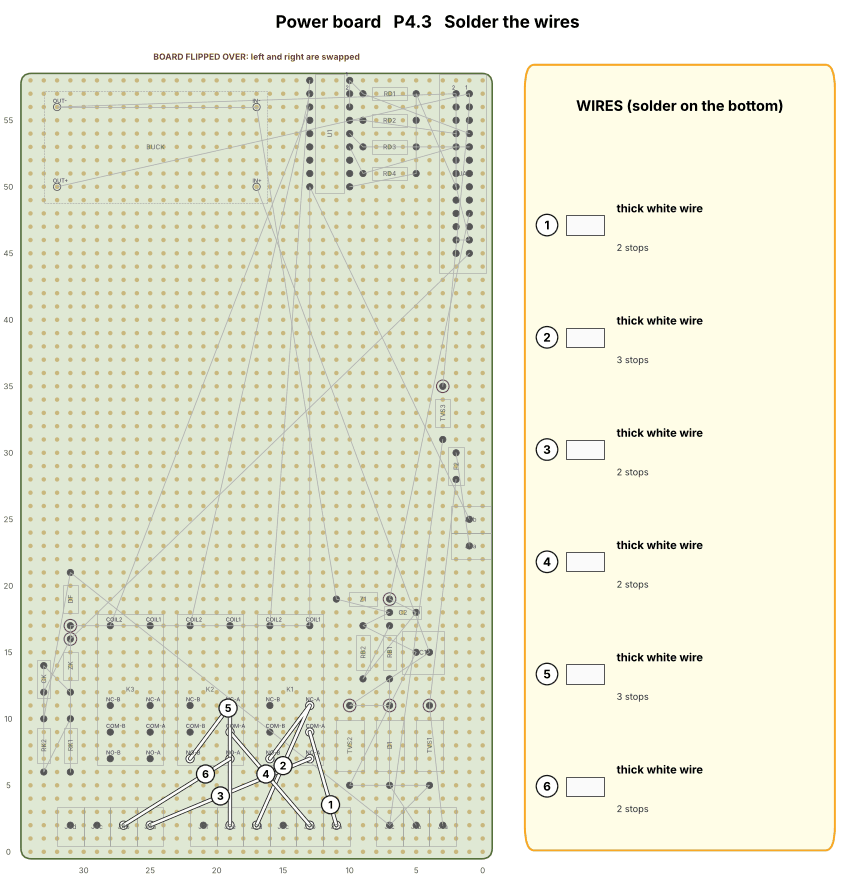
[picture p115: docs/build/power-P4-3.png]
P4.3


- [ ] **1** thick white wire: **J2a** (ECU S1) → **K1** at col 13, row 9
- [ ] **2** thick white wire: **J2d** (SOL S1) → **K1** at col 13, row 11 → **K1** at col 16, row 7
- [ ] **3** thick white wire: **J4a** (LOAD 1) → **K1** at col 13, row 7
- [ ] **4** thick white wire: **J2b** (ECU S2) → **K2** at col 19, row 9
- [ ] **5** thick white wire: **J2e** (SOL S2) → **K2** at col 19, row 11 → **K2** at col 22, row 7
- [ ] **6** thick white wire: **J4b** (LOAD 2) → **K2** at col 19, row 7

#### P4.4 — Solder 4 wires (bottom side)

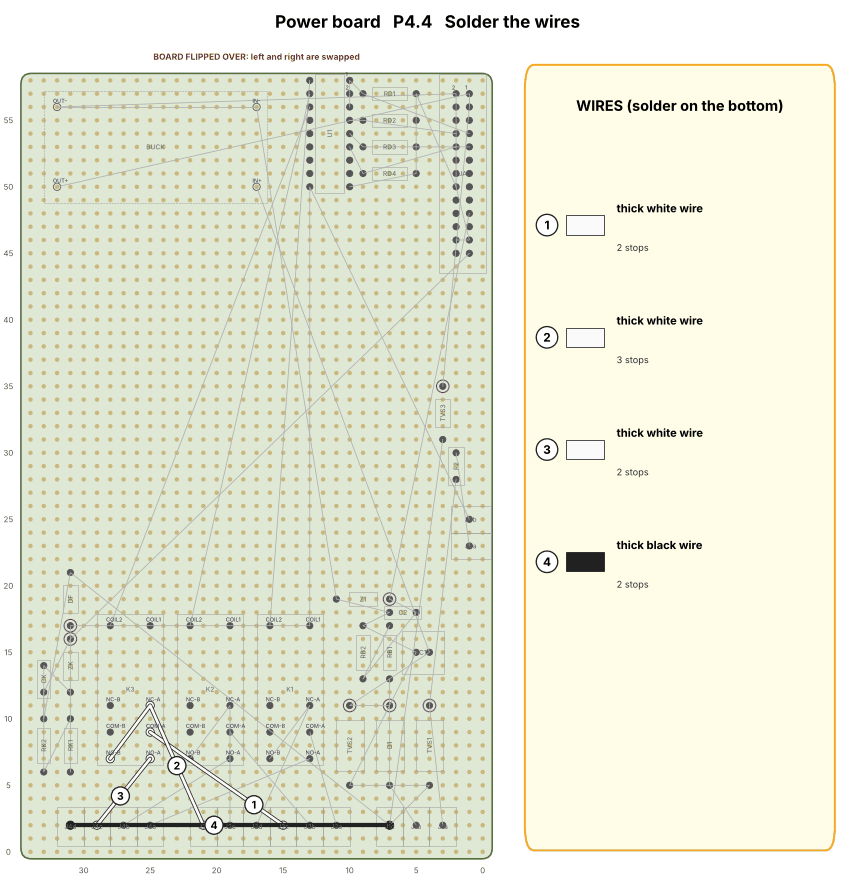
[picture p116: docs/build/power-P4-4.png]
P4.4


- [ ] **1** thick white wire: **J2c** (ECU SL) → **K3** at col 25, row 9
- [ ] **2** thick white wire: **J2f** (SOL SL) → **K3** at col 25, row 11 → **K3** at col 28, row 7
- [ ] **3** thick white wire: **J4c** (LOAD 3) → **K3** at col 25, row 7
- [ ] **4** thick black wire: **J1c** (GND) → **J4d** (LOAD GND)

#### P4 — Meter check (power off)

**Every wire:** meter on beep. Hold one probe on the wire's **first** stop and keep it there. Touch the other probe to **each** of its other stops: every one must beep. (This finds a stop that didn't get soldered.)

- [ ] P4.3 wire 1 (white): from **J2a** (ECU S1), 1 beep
- [ ] P4.3 wire 2 (white): from **J2d** (SOL S1), 2 beeps
- [ ] P4.3 wire 3 (white): from **J4a** (LOAD 1), 1 beep
- [ ] P4.3 wire 4 (white): from **J2b** (ECU S2), 1 beep
- [ ] P4.3 wire 5 (white): from **J2e** (SOL S2), 2 beeps
- [ ] P4.3 wire 6 (white): from **J4b** (LOAD 2), 1 beep
- [ ] P4.4 wire 1 (white): from **J2c** (ECU SL), 1 beep
- [ ] P4.4 wire 2 (white): from **J2f** (SOL SL), 2 beeps
- [ ] P4.4 wire 3 (white): from **J4c** (LOAD 3), 1 beep
- [ ] P4.4 wire 4 (black): from **J1c** (GND), 1 beep

**No shorts:** these pairs must **not** beep. (A short chirp that stops straight away is fine: that's a capacitor filling up. A beep that keeps going is a short: find the solder blob before you go on.)

- [ ] **J1a** (+12 DRV) and **J1c** (GND): 12 V (drivers) to ground
- [ ] **J1b** (+12 LOG) and **J1c** (GND): 12 V to ground
- [ ] **JA** pin 1 and **JA** pin 2: 5 V to ground
- [ ] **J1a** (+12 DRV) and **JA** pin 1: 12 V to 5 V
- [ ] **J5b** (FROM ON/OFF) and **J1c** (GND): relay power to ground

<!-- STEP P5 -->
#### P5.1 — Place 6 parts

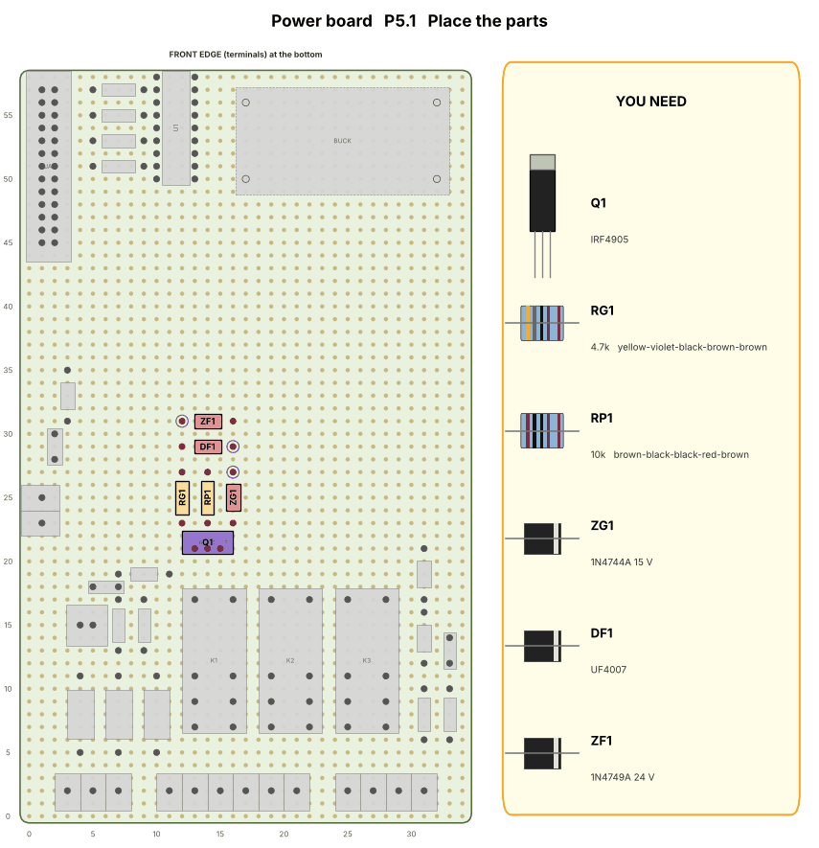
[picture p117: docs/build/power-P5-1.png]
P5.1


- [ ] **Q1**: IRF4905 transistor → left leg in col 13, row 21. Metal tab towards the back
- [ ] **RG1**: 4.7k resistor (bands: yellow-violet-black-brown-brown) → col 12, row 23 and col 12, row 27
- [ ] **RP1**: 10k resistor (bands: brown-black-black-red-brown) → col 14, row 23 and col 14, row 27
- [ ] **ZG1**: 1N4744A 15 V diode → col 16, row 23 and col 16, row 27. Stripe towards the back
- [ ] **DF1**: UF4007 diode → col 12, row 29 and col 16, row 29. Stripe right
- [ ] **ZF1**: 1N4749A 24 V diode → col 16, row 31 and col 12, row 31. Stripe left

Push the legs through, bend them out a little underneath, solder, snip.

#### P5.2 — Place 6 parts

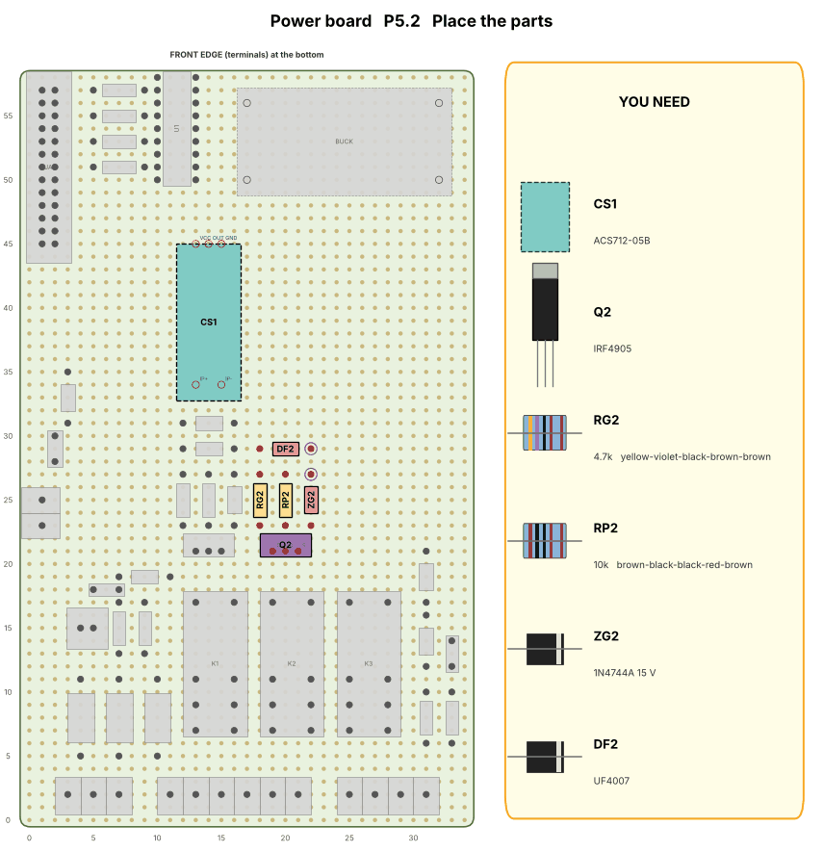
[picture p118: docs/build/power-P5-2.png]
P5.2


- [ ] **CS1**: ACS712-05B module → stick it down with foam tape where shown. Screw terminals towards the front
- [ ] **Q2**: IRF4905 transistor → left leg in col 19, row 21. Metal tab towards the back
- [ ] **RG2**: 4.7k resistor (bands: yellow-violet-black-brown-brown) → col 18, row 23 and col 18, row 27
- [ ] **RP2**: 10k resistor (bands: brown-black-black-red-brown) → col 20, row 23 and col 20, row 27
- [ ] **ZG2**: 1N4744A 15 V diode → col 22, row 23 and col 22, row 27. Stripe towards the back
- [ ] **DF2**: UF4007 diode → col 18, row 29 and col 22, row 29. Stripe right

Push the legs through, bend them out a little underneath, solder, snip.

#### P5.3 — Place 6 parts

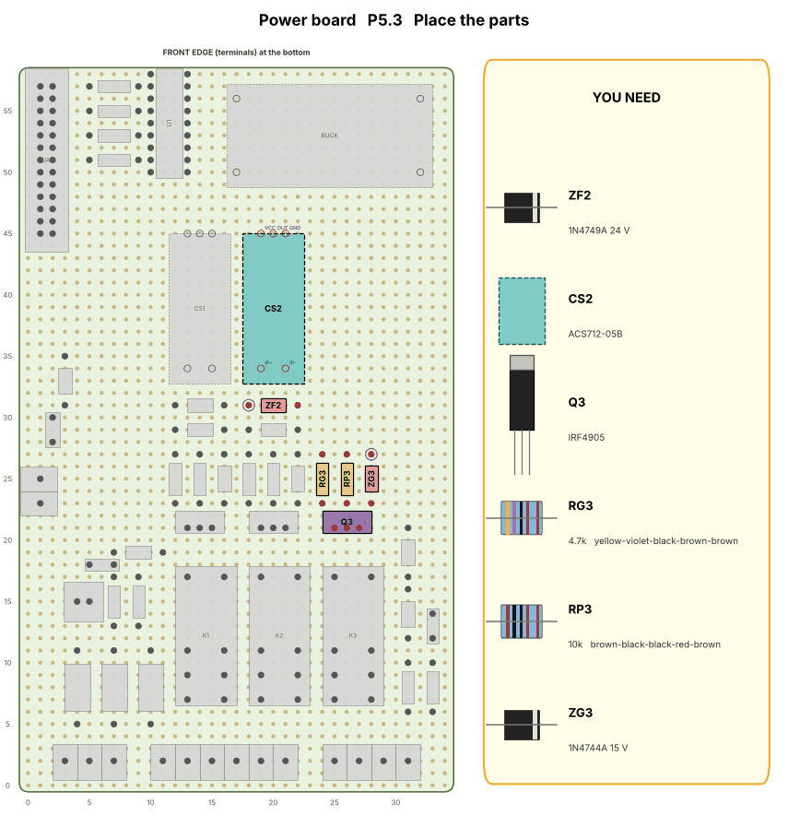
[picture p119: docs/build/power-P5-3.png]
P5.3


- [ ] **ZF2**: 1N4749A 24 V diode → col 22, row 31 and col 18, row 31. Stripe left
- [ ] **CS2**: ACS712-05B module → stick it down with foam tape where shown. Screw terminals towards the front
- [ ] **Q3**: IRF4905 transistor → left leg in col 25, row 21. Metal tab towards the back
- [ ] **RG3**: 4.7k resistor (bands: yellow-violet-black-brown-brown) → col 24, row 23 and col 24, row 27
- [ ] **RP3**: 10k resistor (bands: brown-black-black-red-brown) → col 26, row 23 and col 26, row 27
- [ ] **ZG3**: 1N4744A 15 V diode → col 28, row 23 and col 28, row 27. Stripe towards the back

Push the legs through, bend them out a little underneath, solder, snip.

#### P5.4 — Place 3 parts

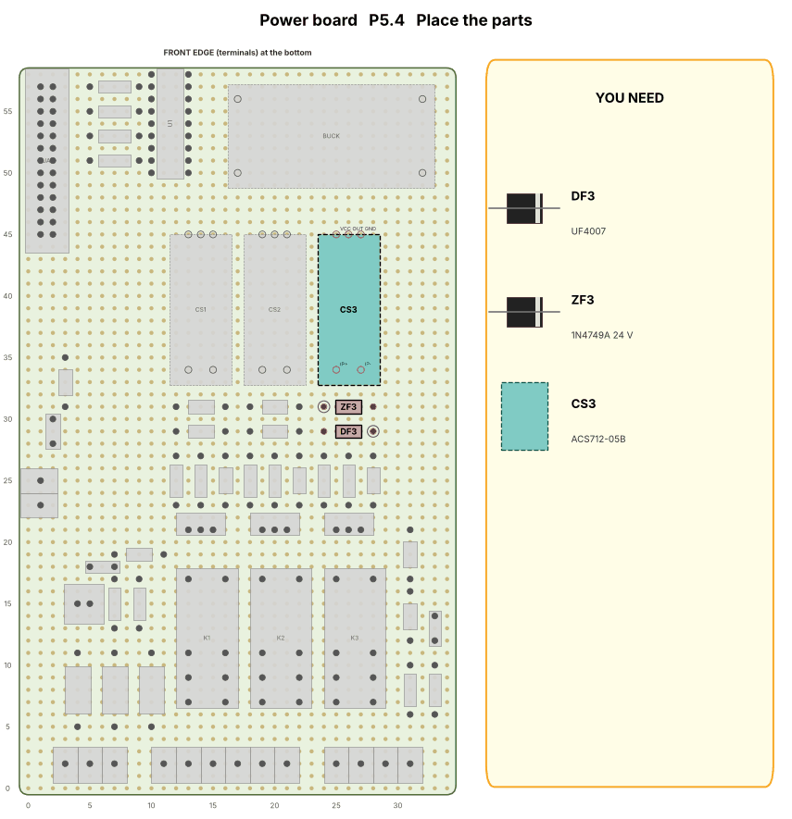
[picture p120: docs/build/power-P5-4.png]
P5.4


- [ ] **DF3**: UF4007 diode → col 24, row 29 and col 28, row 29. Stripe right
- [ ] **ZF3**: 1N4749A 24 V diode → col 28, row 31 and col 24, row 31. Stripe left
- [ ] **CS3**: ACS712-05B module → stick it down with foam tape where shown. Screw terminals towards the front

Push the legs through, bend them out a little underneath, solder, snip.

#### P5.5 — Solder 6 wires (bottom side)

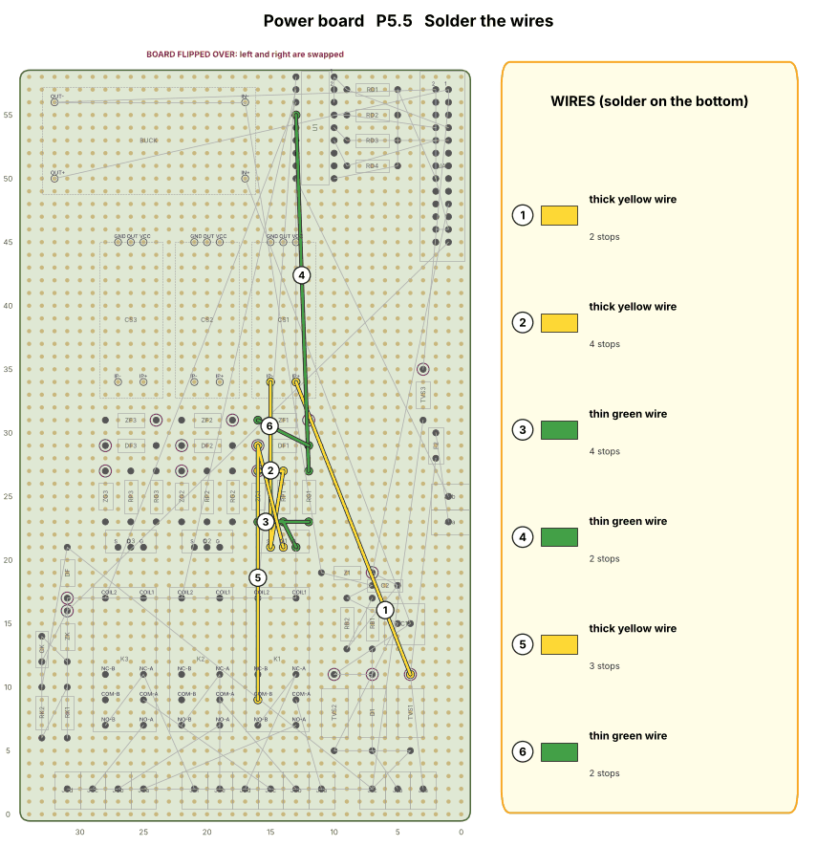
[picture p121: docs/build/power-P5-5.png]
P5.5


- [ ] **1** thick yellow wire: **TVS1** stripe end → **CS1** IP+
- [ ] **2** thick yellow wire: **CS1** IP- → **Q1** at col 15, row 21 → **RP1** at col 14, row 27 → **ZG1** stripe end
- [ ] **3** thin green wire: **Q1** at col 13, row 21 → **RP1** at col 14, row 23 → **ZG1** plain end → **RG1** at col 12, row 23
- [ ] **4** thin green wire: **RG1** at col 12, row 27 → **U1** pin 15
- [ ] **5** thick yellow wire: **Q1** at col 14, row 21 → **DF1** stripe end → **K1** at col 16, row 9
- [ ] **6** thin green wire: **DF1** plain end → **ZF1** plain end

#### P5.6 — Solder 6 wires (bottom side)

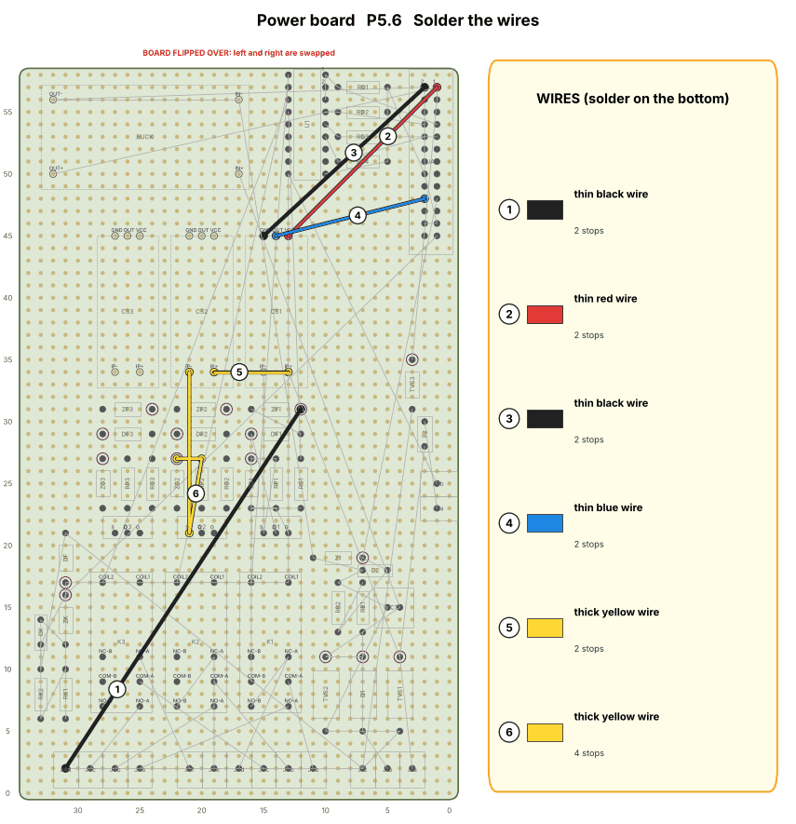
[picture p122: docs/build/power-P5-6.png]
P5.6


- [ ] **1** thin black wire: **J4d** (LOAD GND) → **ZF1** stripe end
- [ ] **2** thin red wire: **JA** pin 1 → **CS1** VCC
- [ ] **3** thin black wire: **JA** pin 2 → **CS1** GND
- [ ] **4** thin blue wire: **CS1** OUT → **JA** pin 20
- [ ] **5** thick yellow wire: **CS1** IP+ → **CS2** IP+
- [ ] **6** thick yellow wire: **CS2** IP- → **Q2** at col 21, row 21 → **RP2** at col 20, row 27 → **ZG2** stripe end

#### P5.7 — Solder 6 wires (bottom side)

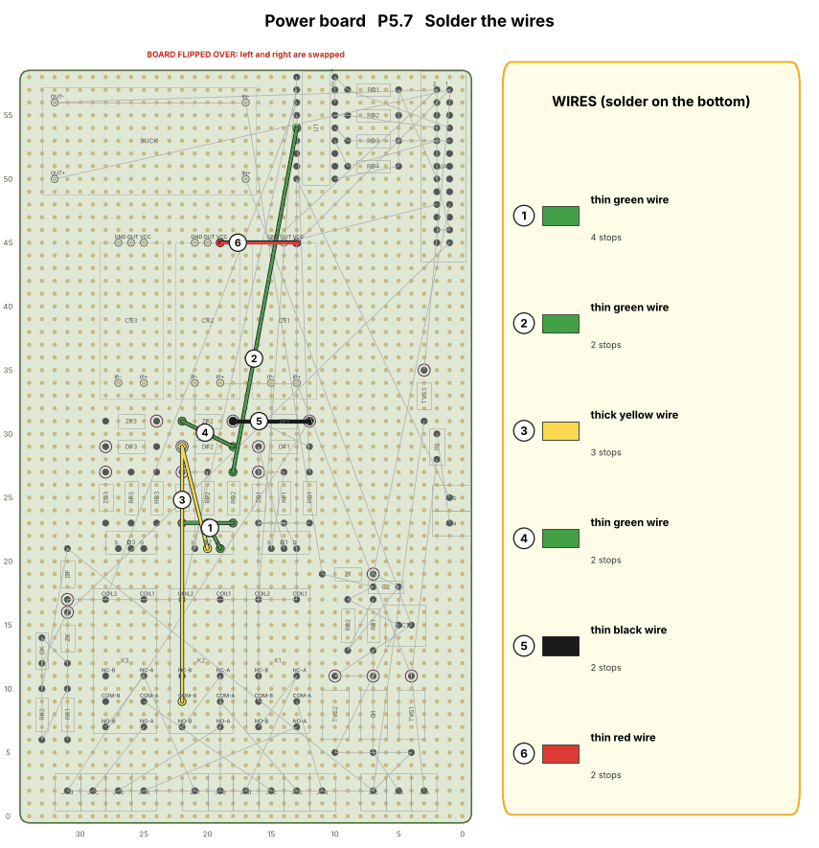
[picture p123: docs/build/power-P5-7.png]
P5.7


- [ ] **1** thin green wire: **Q2** at col 19, row 21 → **RP2** at col 20, row 23 → **ZG2** plain end → **RG2** at col 18, row 23
- [ ] **2** thin green wire: **RG2** at col 18, row 27 → **U1** pin 14
- [ ] **3** thick yellow wire: **Q2** at col 20, row 21 → **DF2** stripe end → **K2** at col 22, row 9
- [ ] **4** thin green wire: **DF2** plain end → **ZF2** plain end
- [ ] **5** thin black wire: **ZF1** stripe end → **ZF2** stripe end
- [ ] **6** thin red wire: **CS1** VCC → **CS2** VCC

#### P5.8 — Solder 6 wires (bottom side)

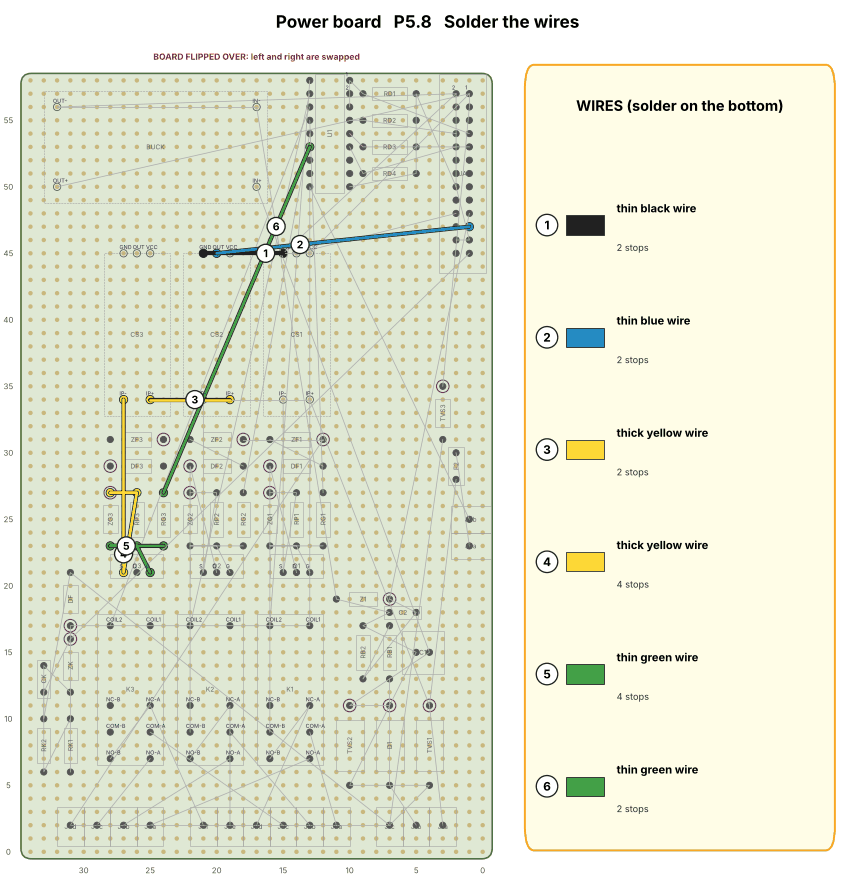
[picture p124: docs/build/power-P5-8.png]
P5.8


- [ ] **1** thin black wire: **CS1** GND → **CS2** GND
- [ ] **2** thin blue wire: **CS2** OUT → **JA** pin 21
- [ ] **3** thick yellow wire: **CS2** IP+ → **CS3** IP+
- [ ] **4** thick yellow wire: **CS3** IP- → **Q3** at col 27, row 21 → **RP3** at col 26, row 27 → **ZG3** stripe end
- [ ] **5** thin green wire: **Q3** at col 25, row 21 → **RP3** at col 26, row 23 → **ZG3** plain end → **RG3** at col 24, row 23
- [ ] **6** thin green wire: **RG3** at col 24, row 27 → **U1** pin 13

#### P5.9 — Solder 6 wires (bottom side)

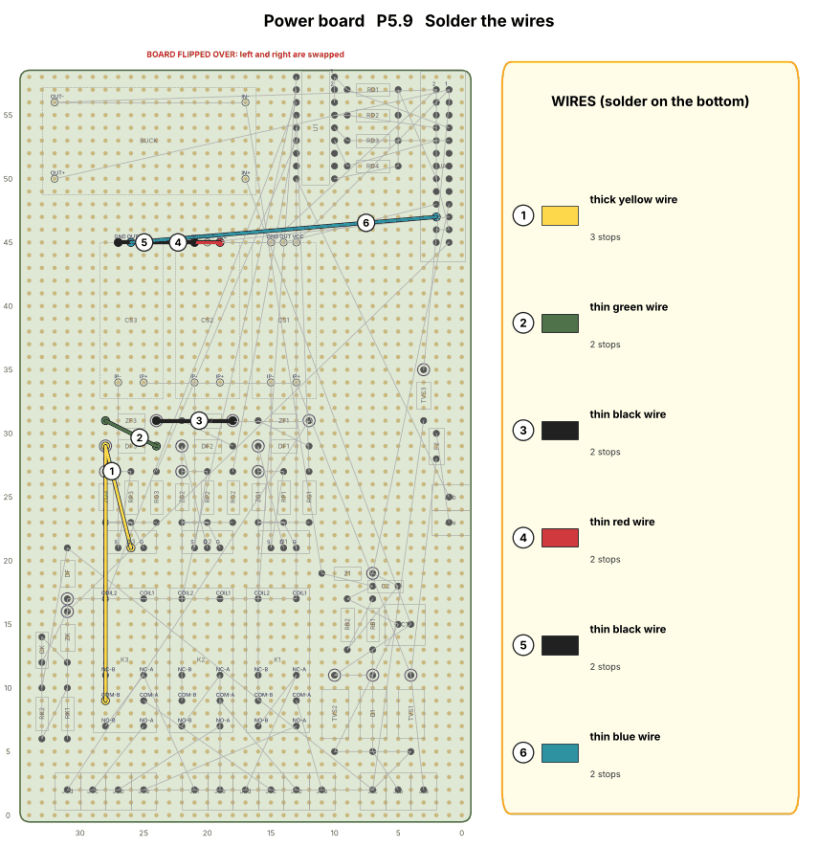
[picture p125: docs/build/power-P5-9.png]
P5.9


- [ ] **1** thick yellow wire: **Q3** at col 26, row 21 → **DF3** stripe end → **K3** at col 28, row 9
- [ ] **2** thin green wire: **DF3** plain end → **ZF3** plain end
- [ ] **3** thin black wire: **ZF2** stripe end → **ZF3** stripe end
- [ ] **4** thin red wire: **CS2** VCC → **CS3** VCC
- [ ] **5** thin black wire: **CS2** GND → **CS3** GND
- [ ] **6** thin blue wire: **CS3** OUT → **JA** pin 22

#### P5 — Meter check (power off)

**Every wire:** meter on beep. Hold one probe on the wire's **first** stop and keep it there. Touch the other probe to **each** of its other stops: every one must beep. (This finds a stop that didn't get soldered.)

- [ ] P5.5 wire 1 (yellow): from **TVS1** stripe end, 1 beep
- [ ] P5.5 wire 2 (yellow): from **CS1** IP-, 3 beeps
- [ ] P5.5 wire 3 (green): from **Q1** at col 13, row 21, 3 beeps
- [ ] P5.5 wire 4 (green): from **RG1** at col 12, row 27, 1 beep
- [ ] P5.5 wire 5 (yellow): from **Q1** at col 14, row 21, 2 beeps
- [ ] P5.5 wire 6 (green): from **DF1** plain end, 1 beep
- [ ] P5.6 wire 1 (black): from **J4d** (LOAD GND), 1 beep
- [ ] P5.6 wire 2 (red): from **JA** pin 1, 1 beep
- [ ] P5.6 wire 3 (black): from **JA** pin 2, 1 beep
- [ ] P5.6 wire 4 (blue): from **CS1** OUT, 1 beep
- [ ] P5.6 wire 5 (yellow): from **CS1** IP+, 1 beep
- [ ] P5.6 wire 6 (yellow): from **CS2** IP-, 3 beeps
- [ ] P5.7 wire 1 (green): from **Q2** at col 19, row 21, 3 beeps
- [ ] P5.7 wire 2 (green): from **RG2** at col 18, row 27, 1 beep
- [ ] P5.7 wire 3 (yellow): from **Q2** at col 20, row 21, 2 beeps
- [ ] P5.7 wire 4 (green): from **DF2** plain end, 1 beep
- [ ] P5.7 wire 5 (black): from **ZF1** stripe end, 1 beep
- [ ] P5.7 wire 6 (red): from **CS1** VCC, 1 beep
- [ ] P5.8 wire 1 (black): from **CS1** GND, 1 beep
- [ ] P5.8 wire 2 (blue): from **CS2** OUT, 1 beep
- [ ] P5.8 wire 3 (yellow): from **CS2** IP+, 1 beep
- [ ] P5.8 wire 4 (yellow): from **CS3** IP-, 3 beeps
- [ ] P5.8 wire 5 (green): from **Q3** at col 25, row 21, 3 beeps
- [ ] P5.8 wire 6 (green): from **RG3** at col 24, row 27, 1 beep
- [ ] P5.9 wire 1 (yellow): from **Q3** at col 26, row 21, 2 beeps
- [ ] P5.9 wire 2 (green): from **DF3** plain end, 1 beep
- [ ] P5.9 wire 3 (black): from **ZF2** stripe end, 1 beep
- [ ] P5.9 wire 4 (red): from **CS2** VCC, 1 beep
- [ ] P5.9 wire 5 (black): from **CS2** GND, 1 beep
- [ ] P5.9 wire 6 (blue): from **CS3** OUT, 1 beep

**No shorts:** these pairs must **not** beep. (A short chirp that stops straight away is fine: that's a capacitor filling up. A beep that keeps going is a short: find the solder blob before you go on.)

- [ ] **J1a** (+12 DRV) and **J1c** (GND): 12 V (drivers) to ground
- [ ] **J1b** (+12 LOG) and **J1c** (GND): 12 V to ground
- [ ] **JA** pin 1 and **JA** pin 2: 5 V to ground
- [ ] **J1a** (+12 DRV) and **JA** pin 1: 12 V to 5 V
- [ ] **J5b** (FROM ON/OFF) and **J1c** (GND): relay power to ground

<!-- STEP P6 -->
#### P6.1 — Place 6 parts

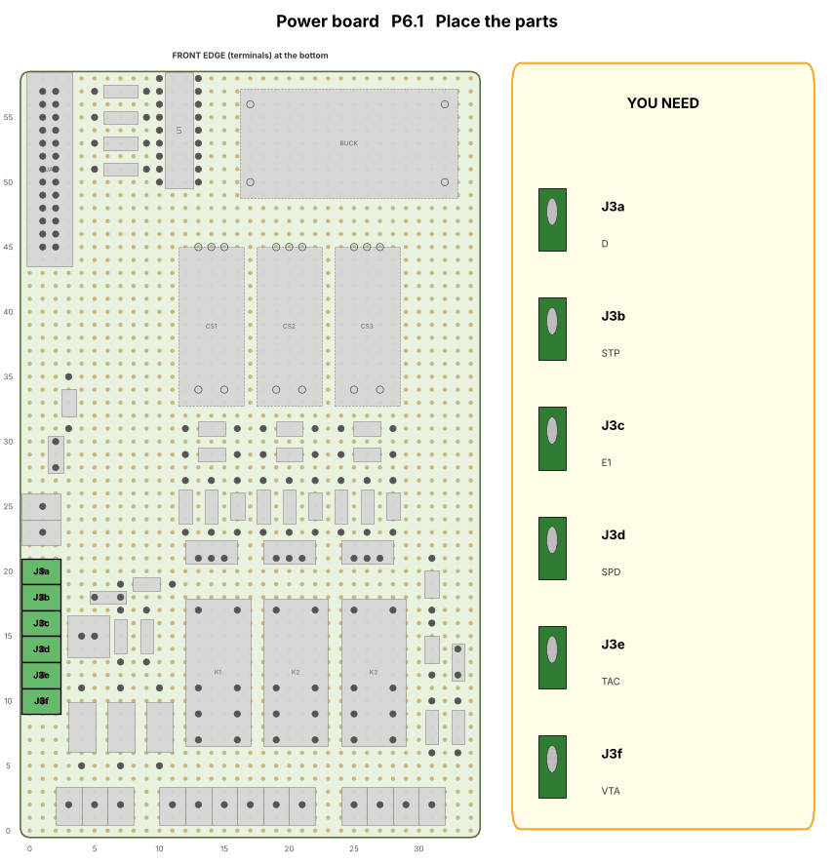
[picture p126: docs/build/power-P6-1.png]
P6.1


- [ ] **J3a**: D screw terminal → col 1, row 20
- [ ] **J3b**: STP screw terminal → col 1, row 18
- [ ] **J3c**: E1 screw terminal → col 1, row 16
- [ ] **J3d**: SPD screw terminal → col 1, row 14
- [ ] **J3e**: TAC screw terminal → col 1, row 12
- [ ] **J3f**: VTA screw terminal → col 1, row 10

Push the legs through, bend them out a little underneath, solder, snip.

#### P6.2 — Place 6 parts

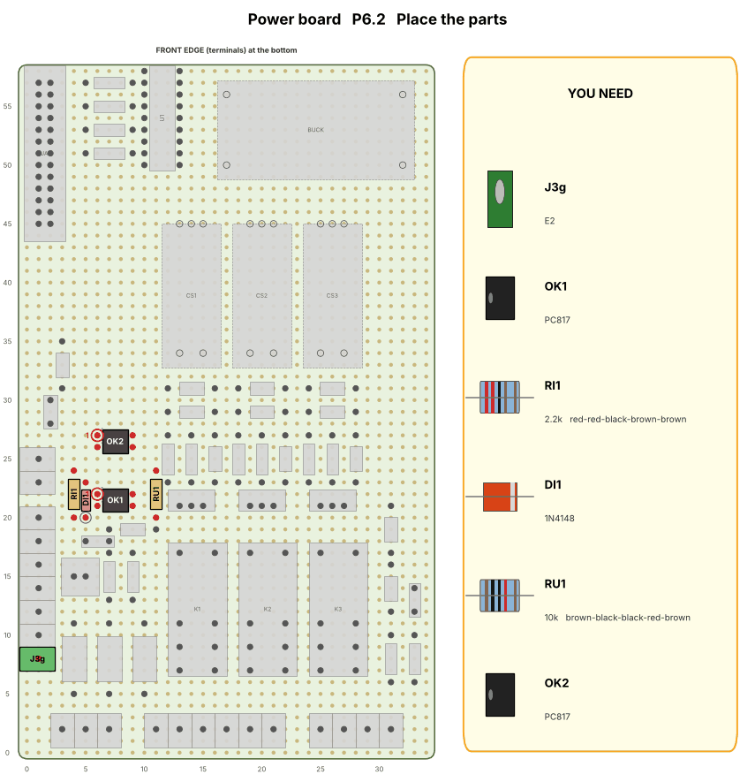
[picture p127: docs/build/power-P6-2.png]
P6.2


- [ ] **J3g**: E2 screw terminal → col 1, row 8
- [ ] **OK1**: PC817 chip → pin 1 in col 6, row 22. Dot top-left
- [ ] **RI1**: 2.2k resistor (bands: red-red-black-brown-brown) → col 4, row 20 and col 4, row 24
- [ ] **DI1**: 1N4148 diode → col 5, row 23 and col 5, row 20. Stripe towards the front
- [ ] **RU1**: 10k resistor (bands: brown-black-black-red-brown) → col 11, row 20 and col 11, row 24
- [ ] **OK2**: PC817 chip → pin 1 in col 6, row 27. Dot top-left

Push the legs through, bend them out a little underneath, solder, snip.

#### P6.3 — Place 6 parts

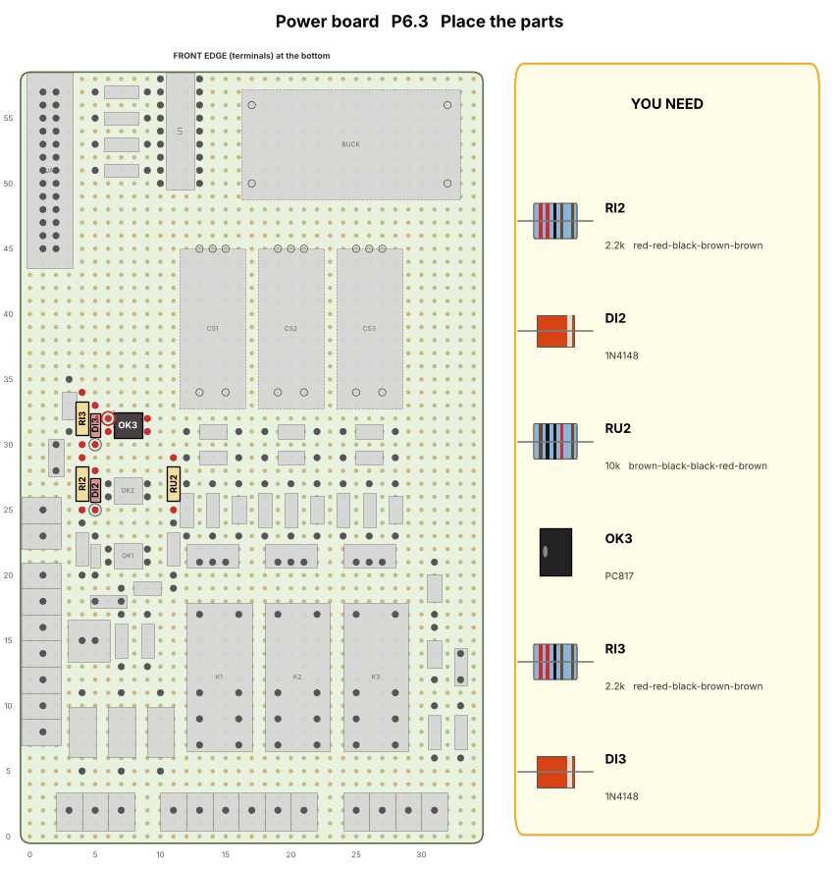
[picture p128: docs/build/power-P6-3.png]
P6.3


- [ ] **RI2**: 2.2k resistor (bands: red-red-black-brown-brown) → col 4, row 25 and col 4, row 29
- [ ] **DI2**: 1N4148 diode → col 5, row 28 and col 5, row 25. Stripe towards the front
- [ ] **RU2**: 10k resistor (bands: brown-black-black-red-brown) → col 11, row 25 and col 11, row 29
- [ ] **OK3**: PC817 chip → pin 1 in col 6, row 32. Dot top-left
- [ ] **RI3**: 2.2k resistor (bands: red-red-black-brown-brown) → col 4, row 30 and col 4, row 34
- [ ] **DI3**: 1N4148 diode → col 5, row 33 and col 5, row 30. Stripe towards the front

Push the legs through, bend them out a little underneath, solder, snip.

#### P6.4 — Place 6 parts

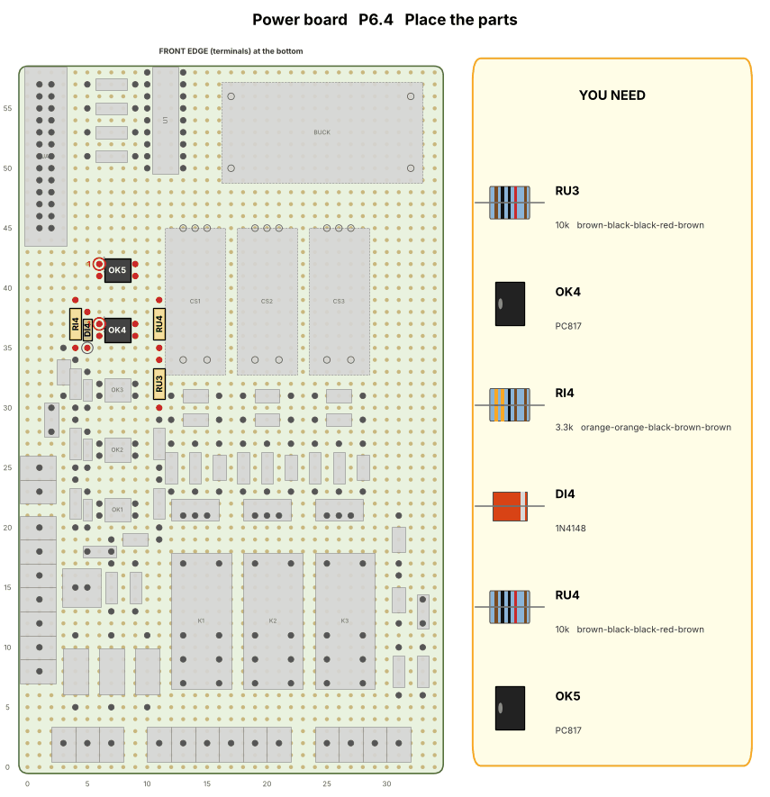
[picture p129: docs/build/power-P6-4.png]
P6.4


- [ ] **RU3**: 10k resistor (bands: brown-black-black-red-brown) → col 11, row 30 and col 11, row 34
- [ ] **OK4**: PC817 chip → pin 1 in col 6, row 37. Dot top-left
- [ ] **RI4**: 3.3k resistor (bands: orange-orange-black-brown-brown) → col 4, row 35 and col 4, row 39
- [ ] **DI4**: 1N4148 diode → col 5, row 38 and col 5, row 35. Stripe towards the front
- [ ] **RU4**: 10k resistor (bands: brown-black-black-red-brown) → col 11, row 35 and col 11, row 39
- [ ] **OK5**: PC817 chip → pin 1 in col 6, row 42. Dot top-left

Push the legs through, bend them out a little underneath, solder, snip.

#### P6.5 — Place 6 parts

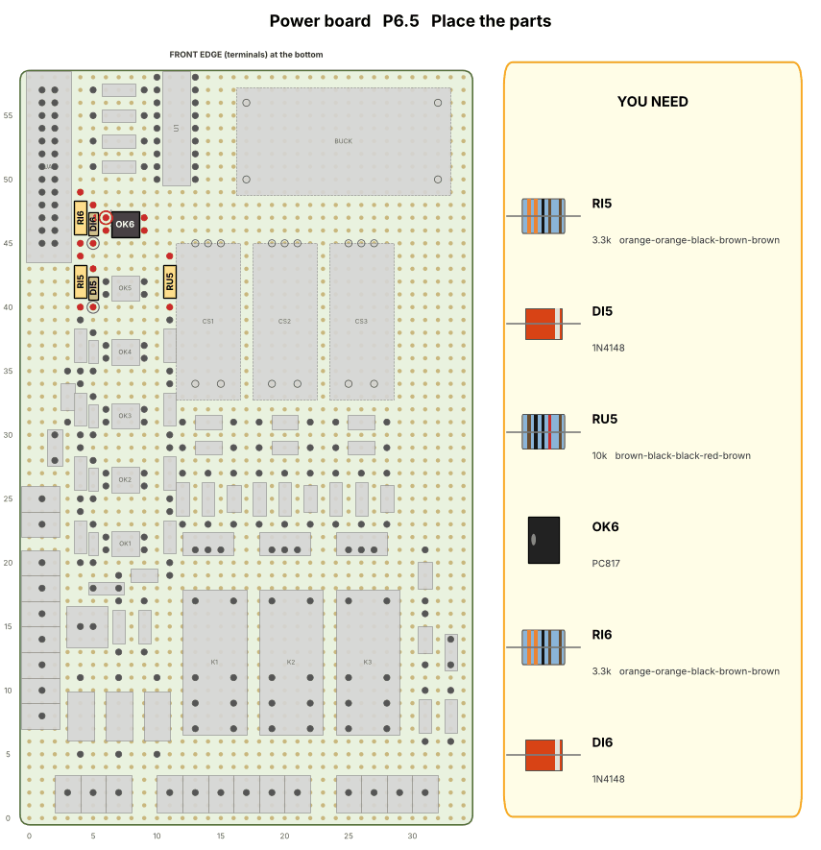
[picture p130: docs/build/power-P6-5.png]
P6.5


- [ ] **RI5**: 3.3k resistor (bands: orange-orange-black-brown-brown) → col 4, row 40 and col 4, row 44
- [ ] **DI5**: 1N4148 diode → col 5, row 43 and col 5, row 40. Stripe towards the front
- [ ] **RU5**: 10k resistor (bands: brown-black-black-red-brown) → col 11, row 40 and col 11, row 44
- [ ] **OK6**: PC817 chip → pin 1 in col 6, row 47. Dot top-left
- [ ] **RI6**: 3.3k resistor (bands: orange-orange-black-brown-brown) → col 4, row 45 and col 4, row 49
- [ ] **DI6**: 1N4148 diode → col 5, row 48 and col 5, row 45. Stripe towards the front

Push the legs through, bend them out a little underneath, solder, snip.

#### P6.6 — Place 1 part

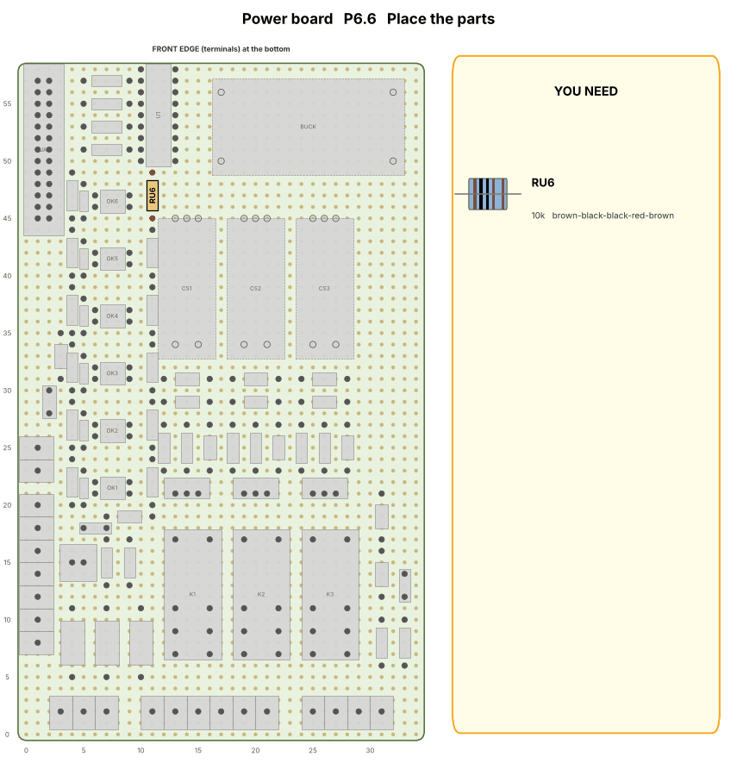
[picture p131: docs/build/power-P6-6.png]
P6.6


- [ ] **RU6**: 10k resistor (bands: brown-black-black-red-brown) → col 11, row 45 and col 11, row 49

Push the legs through, bend them out a little underneath, solder, snip.

#### P6.7 — Solder 6 wires (bottom side)

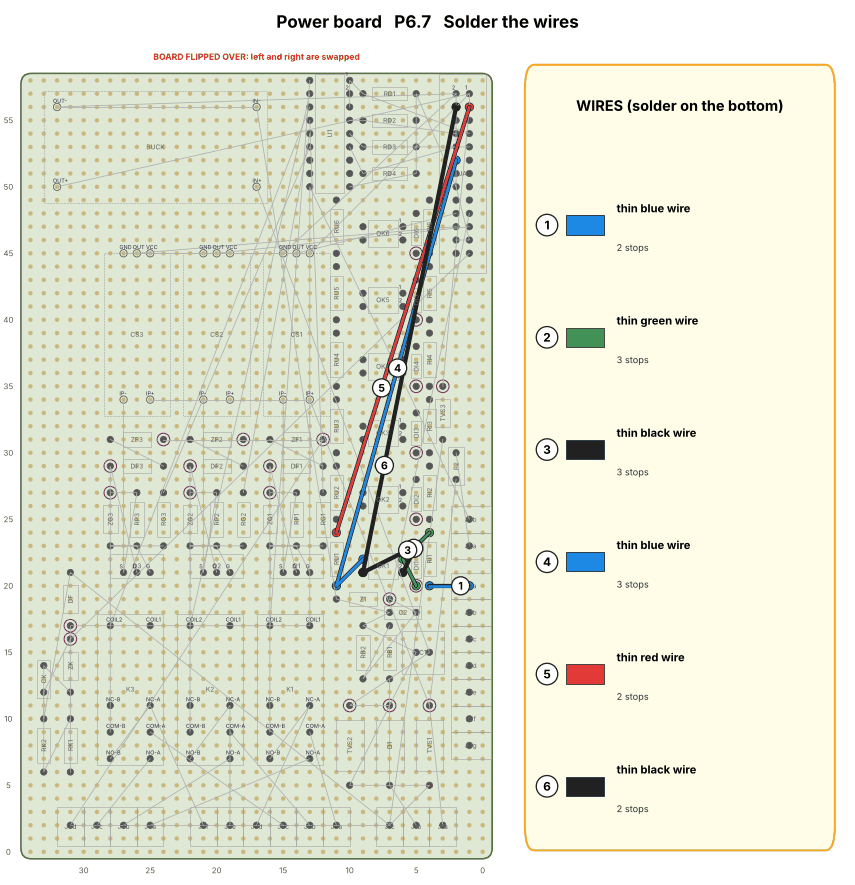
[picture p132: docs/build/power-P6-7.png]
P6.7


- [ ] **1** thin blue wire: **J3a** (D) → **RI1** at col 4, row 20
- [ ] **2** thin green wire: **RI1** at col 4, row 24 → **OK1** pin 1 → **DI1** stripe end
- [ ] **3** thin black wire: **OK1** pin 2 → **DI1** plain end → **OK1** pin 3
- [ ] **4** thin blue wire: **OK1** pin 4 → **RU1** at col 11, row 20 → **JA** pin 12
- [ ] **5** thin red wire: **JA** pin 3 → **RU1** at col 11, row 24
- [ ] **6** thin black wire: **JA** pin 4 → **OK1** pin 3

#### P6.8 — Solder 6 wires (bottom side)

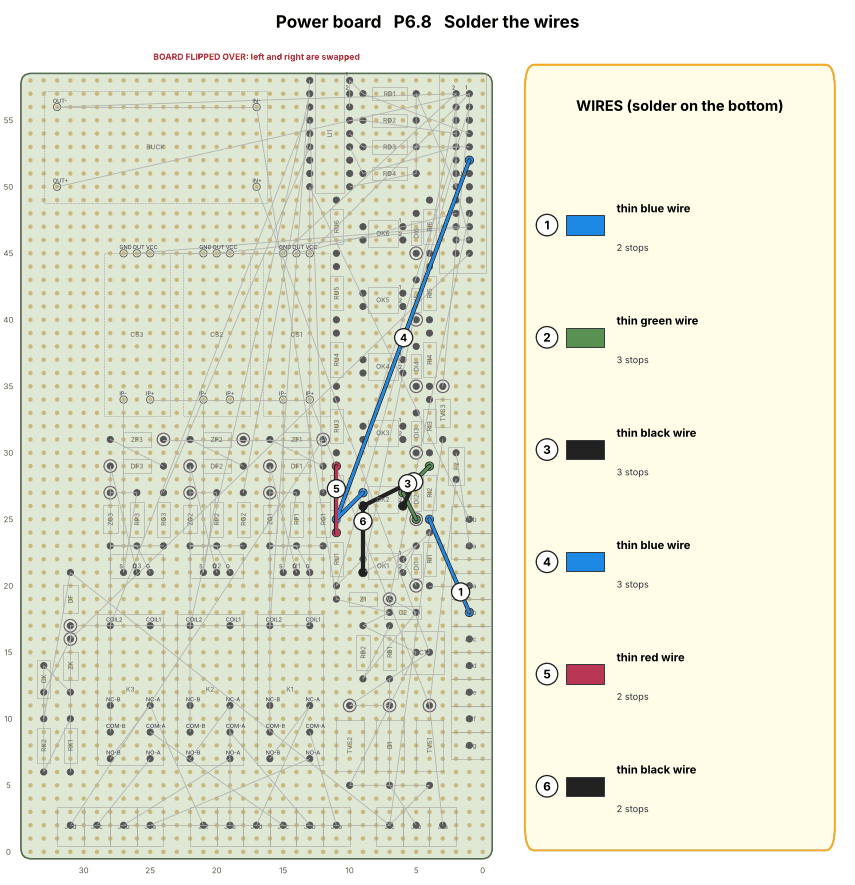
[picture p133: docs/build/power-P6-8.png]
P6.8


- [ ] **1** thin blue wire: **J3b** (STP) → **RI2** at col 4, row 25
- [ ] **2** thin green wire: **RI2** at col 4, row 29 → **OK2** pin 1 → **DI2** stripe end
- [ ] **3** thin black wire: **OK2** pin 2 → **DI2** plain end → **OK2** pin 3
- [ ] **4** thin blue wire: **OK2** pin 4 → **RU2** at col 11, row 25 → **JA** pin 11
- [ ] **5** thin red wire: **RU1** at col 11, row 24 → **RU2** at col 11, row 29
- [ ] **6** thin black wire: **OK1** pin 3 → **OK2** pin 3

#### P6.9 — Solder 6 wires (bottom side)

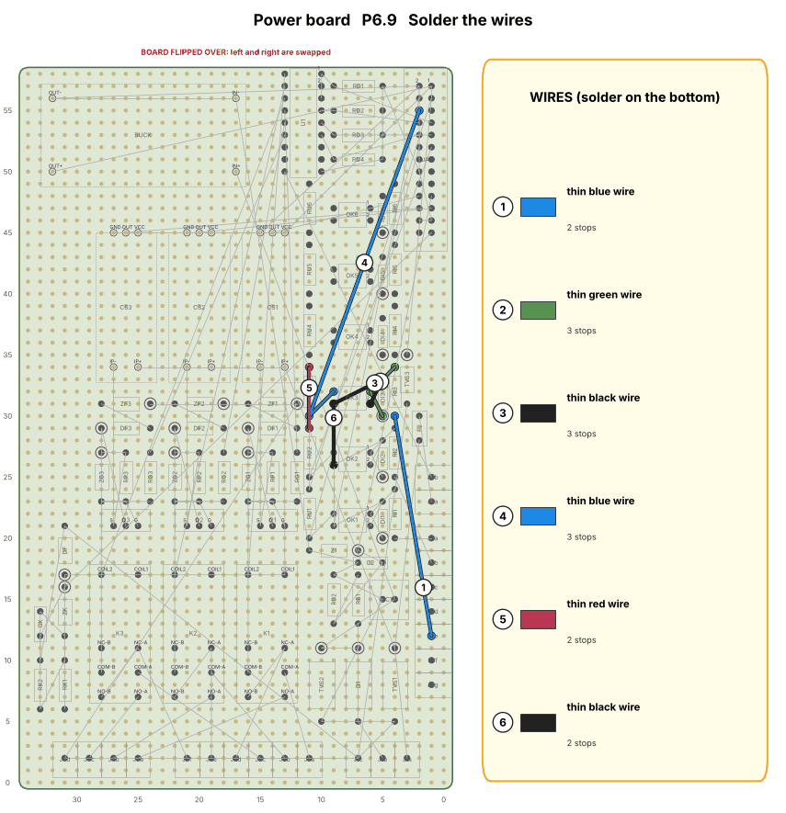
[picture p134: docs/build/power-P6-9.png]
P6.9


- [ ] **1** thin blue wire: **J3e** (TAC) → **RI3** at col 4, row 30
- [ ] **2** thin green wire: **RI3** at col 4, row 34 → **OK3** pin 1 → **DI3** stripe end
- [ ] **3** thin black wire: **OK3** pin 2 → **DI3** plain end → **OK3** pin 3
- [ ] **4** thin blue wire: **OK3** pin 4 → **RU3** at col 11, row 30 → **JA** pin 6
- [ ] **5** thin red wire: **RU2** at col 11, row 29 → **RU3** at col 11, row 34
- [ ] **6** thin black wire: **OK2** pin 3 → **OK3** pin 3

#### P6.10 — Solder 6 wires (bottom side)

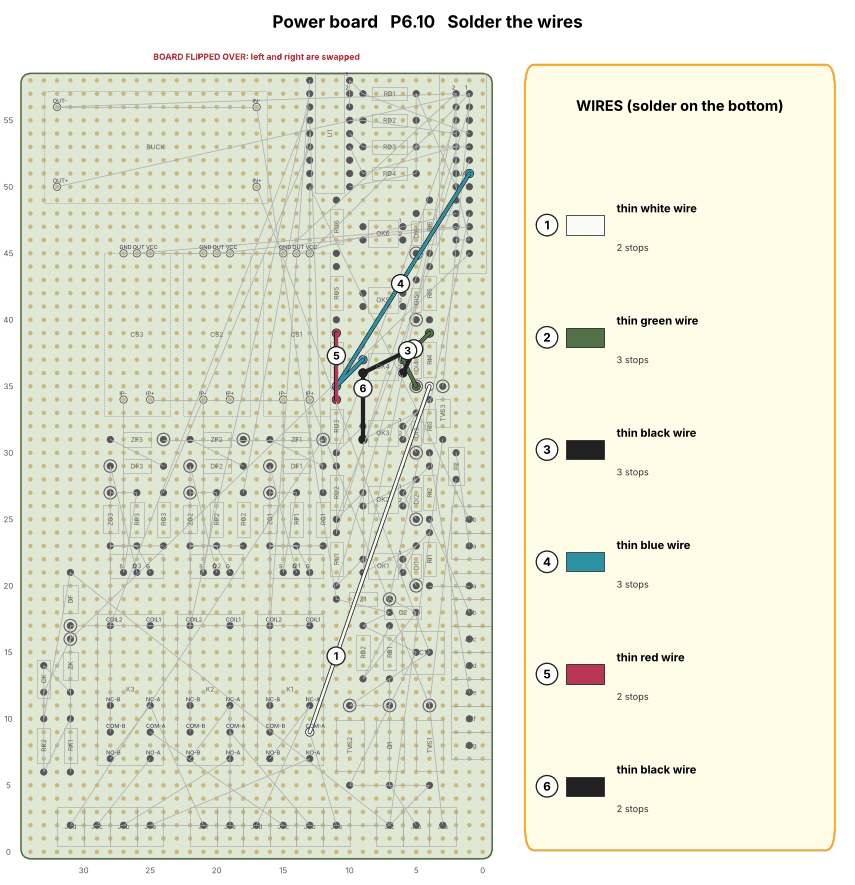
[picture p135: docs/build/power-P6-10.png]
P6.10


- [ ] **1** thin white wire: **K1** at col 13, row 9 → **RI4** at col 4, row 35
- [ ] **2** thin green wire: **RI4** at col 4, row 39 → **OK4** pin 1 → **DI4** stripe end
- [ ] **3** thin black wire: **OK4** pin 2 → **DI4** plain end → **OK4** pin 3
- [ ] **4** thin blue wire: **OK4** pin 4 → **RU4** at col 11, row 35 → **JA** pin 13
- [ ] **5** thin red wire: **RU3** at col 11, row 34 → **RU4** at col 11, row 39
- [ ] **6** thin black wire: **OK3** pin 3 → **OK4** pin 3

#### P6.11 — Solder 6 wires (bottom side)

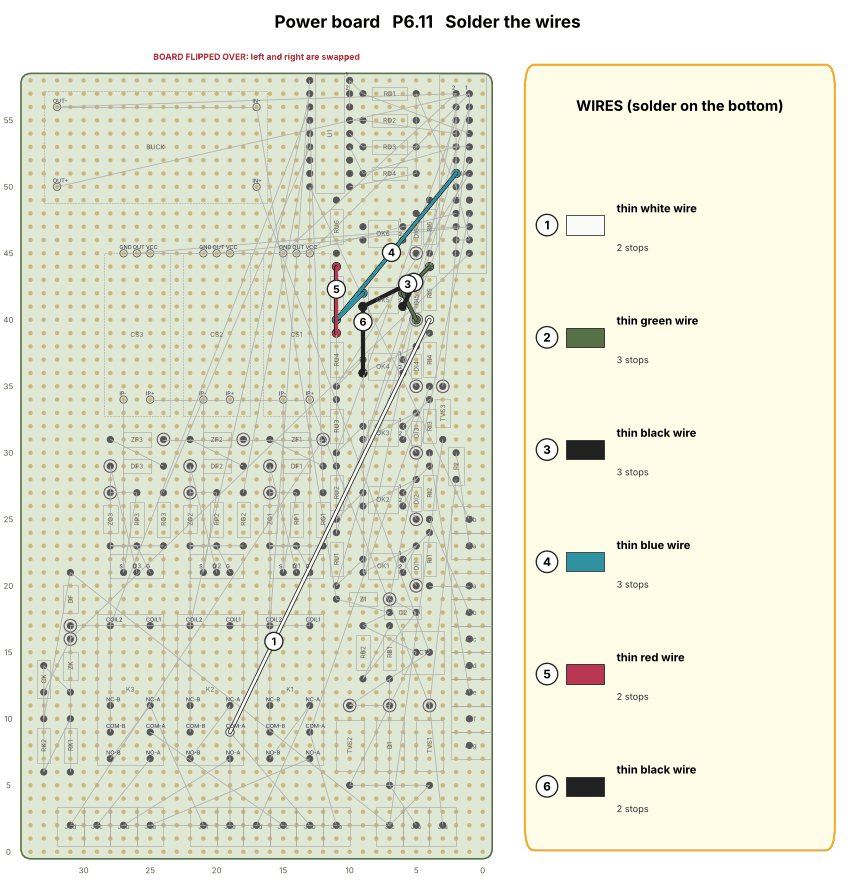
[picture p136: docs/build/power-P6-11.png]
P6.11


- [ ] **1** thin white wire: **K2** at col 19, row 9 → **RI5** at col 4, row 40
- [ ] **2** thin green wire: **RI5** at col 4, row 44 → **OK5** pin 1 → **DI5** stripe end
- [ ] **3** thin black wire: **OK5** pin 2 → **DI5** plain end → **OK5** pin 3
- [ ] **4** thin blue wire: **OK5** pin 4 → **RU5** at col 11, row 40 → **JA** pin 14
- [ ] **5** thin red wire: **RU4** at col 11, row 39 → **RU5** at col 11, row 44
- [ ] **6** thin black wire: **OK4** pin 3 → **OK5** pin 3

#### P6.12 — Solder 6 wires (bottom side)

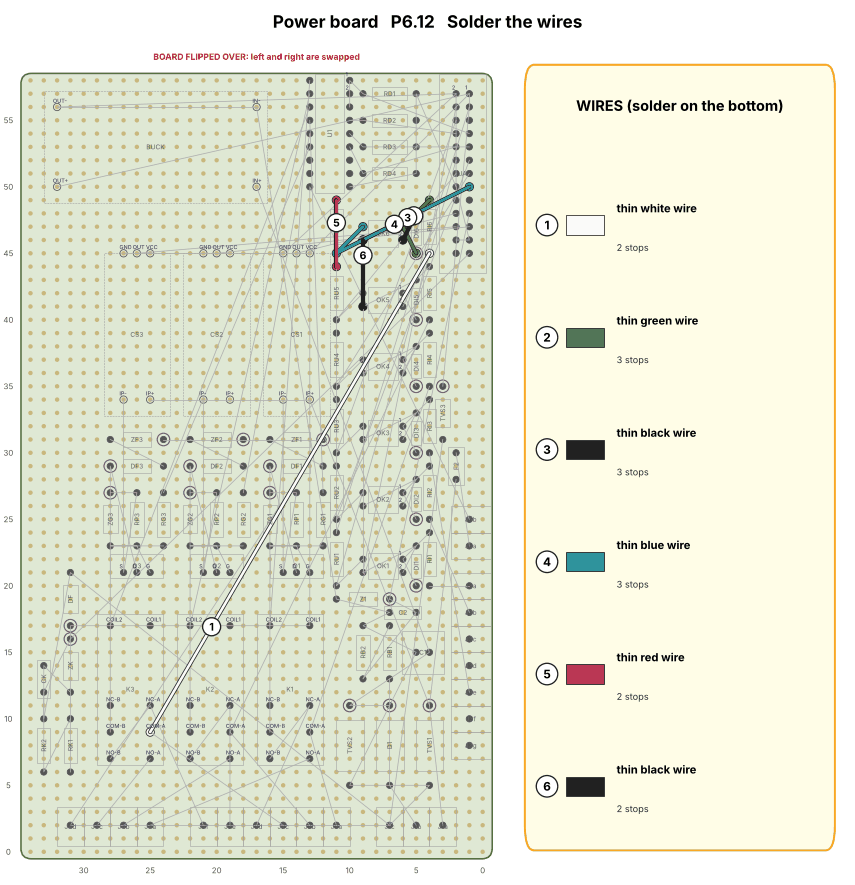
[picture p137: docs/build/power-P6-12.png]
P6.12


- [ ] **1** thin white wire: **K3** at col 25, row 9 → **RI6** at col 4, row 45
- [ ] **2** thin green wire: **RI6** at col 4, row 49 → **OK6** pin 1 → **DI6** stripe end
- [ ] **3** thin black wire: **OK6** pin 2 → **DI6** plain end → **OK6** pin 3
- [ ] **4** thin blue wire: **OK6** pin 4 → **RU6** at col 11, row 45 → **JA** pin 15
- [ ] **5** thin red wire: **RU5** at col 11, row 44 → **RU6** at col 11, row 49
- [ ] **6** thin black wire: **OK5** pin 3 → **OK6** pin 3

#### P6.13 — Solder 1 wire (bottom side)

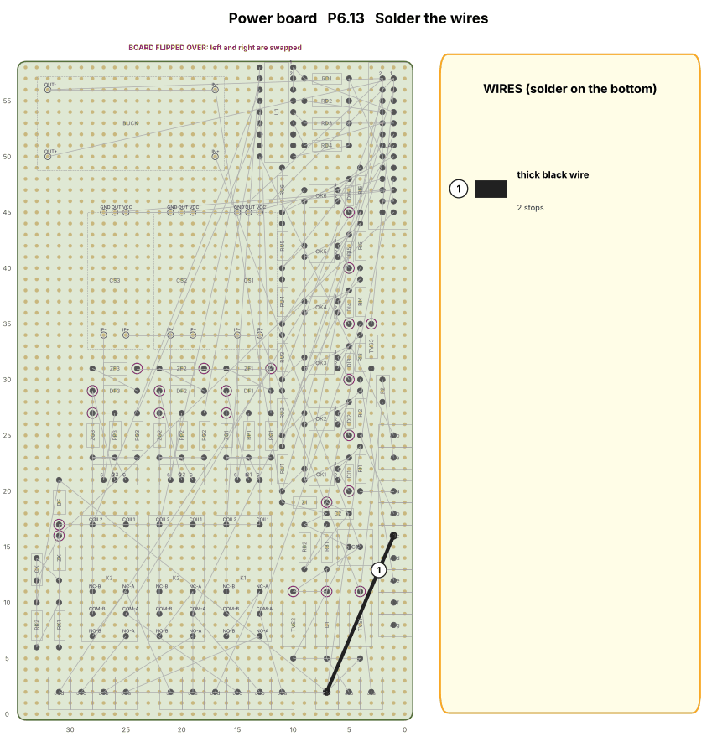
[picture p138: docs/build/power-P6-13.png]
P6.13


- [ ] **1** thick black wire: **J3c** (E1) → **J1c** (GND)

#### P6 — Meter check (power off)

**Every wire:** meter on beep. Hold one probe on the wire's **first** stop and keep it there. Touch the other probe to **each** of its other stops: every one must beep. (This finds a stop that didn't get soldered.)

- [ ] P6.7 wire 1 (blue): from **J3a** (D), 1 beep
- [ ] P6.7 wire 2 (green): from **RI1** at col 4, row 24, 2 beeps
- [ ] P6.7 wire 3 (black): from **OK1** pin 2, 2 beeps
- [ ] P6.7 wire 4 (blue): from **OK1** pin 4, 2 beeps
- [ ] P6.7 wire 5 (red): from **JA** pin 3, 1 beep
- [ ] P6.7 wire 6 (black): from **JA** pin 4, 1 beep
- [ ] P6.8 wire 1 (blue): from **J3b** (STP), 1 beep
- [ ] P6.8 wire 2 (green): from **RI2** at col 4, row 29, 2 beeps
- [ ] P6.8 wire 3 (black): from **OK2** pin 2, 2 beeps
- [ ] P6.8 wire 4 (blue): from **OK2** pin 4, 2 beeps
- [ ] P6.8 wire 5 (red): from **RU1** at col 11, row 24, 1 beep
- [ ] P6.8 wire 6 (black): from **OK1** pin 3, 1 beep
- [ ] P6.9 wire 1 (blue): from **J3e** (TAC), 1 beep
- [ ] P6.9 wire 2 (green): from **RI3** at col 4, row 34, 2 beeps
- [ ] P6.9 wire 3 (black): from **OK3** pin 2, 2 beeps
- [ ] P6.9 wire 4 (blue): from **OK3** pin 4, 2 beeps
- [ ] P6.9 wire 5 (red): from **RU2** at col 11, row 29, 1 beep
- [ ] P6.9 wire 6 (black): from **OK2** pin 3, 1 beep
- [ ] P6.10 wire 1 (white): from **K1** at col 13, row 9, 1 beep
- [ ] P6.10 wire 2 (green): from **RI4** at col 4, row 39, 2 beeps
- [ ] P6.10 wire 3 (black): from **OK4** pin 2, 2 beeps
- [ ] P6.10 wire 4 (blue): from **OK4** pin 4, 2 beeps
- [ ] P6.10 wire 5 (red): from **RU3** at col 11, row 34, 1 beep
- [ ] P6.10 wire 6 (black): from **OK3** pin 3, 1 beep
- [ ] P6.11 wire 1 (white): from **K2** at col 19, row 9, 1 beep
- [ ] P6.11 wire 2 (green): from **RI5** at col 4, row 44, 2 beeps
- [ ] P6.11 wire 3 (black): from **OK5** pin 2, 2 beeps
- [ ] P6.11 wire 4 (blue): from **OK5** pin 4, 2 beeps
- [ ] P6.11 wire 5 (red): from **RU4** at col 11, row 39, 1 beep
- [ ] P6.11 wire 6 (black): from **OK4** pin 3, 1 beep
- [ ] P6.12 wire 1 (white): from **K3** at col 25, row 9, 1 beep
- [ ] P6.12 wire 2 (green): from **RI6** at col 4, row 49, 2 beeps
- [ ] P6.12 wire 3 (black): from **OK6** pin 2, 2 beeps
- [ ] P6.12 wire 4 (blue): from **OK6** pin 4, 2 beeps
- [ ] P6.12 wire 5 (red): from **RU5** at col 11, row 44, 1 beep
- [ ] P6.12 wire 6 (black): from **OK5** pin 3, 1 beep
- [ ] P6.13 wire 1 (black): from **J3c** (E1), 1 beep

**No shorts:** these pairs must **not** beep. (A short chirp that stops straight away is fine: that's a capacitor filling up. A beep that keeps going is a short: find the solder blob before you go on.)

- [ ] **J1a** (+12 DRV) and **J1c** (GND): 12 V (drivers) to ground
- [ ] **J1b** (+12 LOG) and **J1c** (GND): 12 V to ground
- [ ] **JA** pin 1 and **JA** pin 2: 5 V to ground
- [ ] **J1a** (+12 DRV) and **JA** pin 1: 12 V to 5 V
- [ ] **J5b** (FROM ON/OFF) and **J1c** (GND): relay power to ground

<!-- STEP P7 -->
#### P7.1 — Place 6 parts

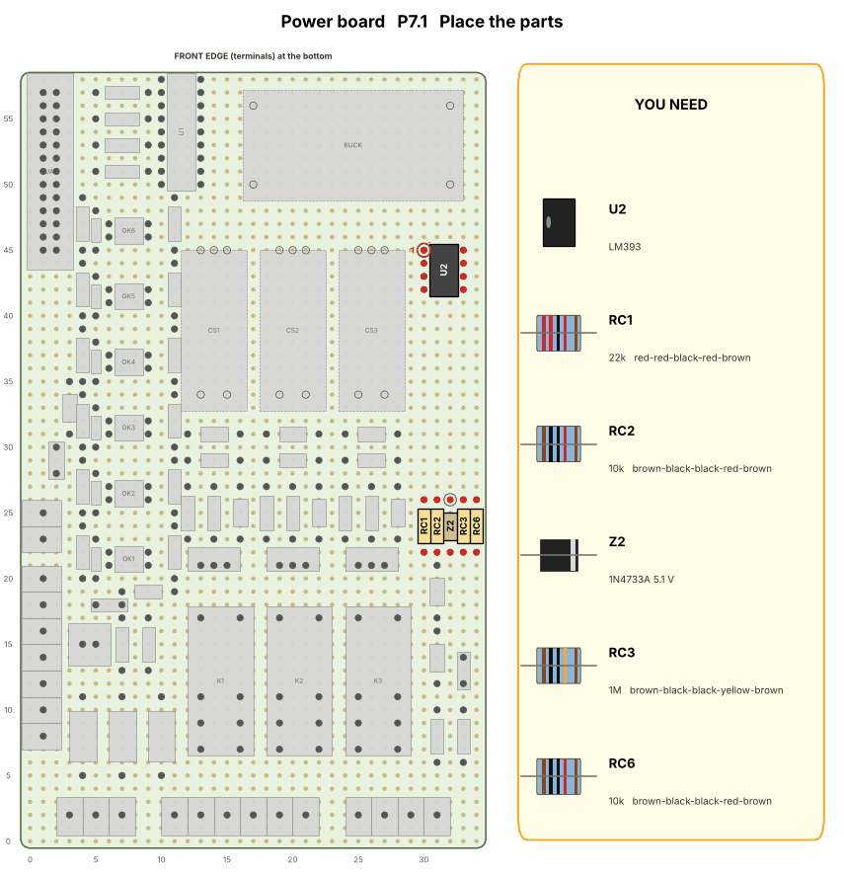
[picture p139: docs/build/power-P7-1.png]
P7.1


- [ ] **U2**: LM393 chip → pin 1 in col 30, row 45. Notch or dot top-left
- [ ] **RC1**: 22k resistor (bands: red-red-black-red-brown) → col 30, row 22 and col 30, row 26
- [ ] **RC2**: 10k resistor (bands: brown-black-black-red-brown) → col 31, row 22 and col 31, row 26
- [ ] **Z2**: 1N4733A 5.1 V diode → col 32, row 22 and col 32, row 26. Stripe towards the back
- [ ] **RC3**: 1M resistor (bands: brown-black-black-yellow-brown) → col 33, row 22 and col 33, row 26
- [ ] **RC6**: 10k resistor (bands: brown-black-black-red-brown) → col 34, row 22 and col 34, row 26

Push the legs through, bend them out a little underneath, solder, snip.

#### P7.2 — Place 2 parts

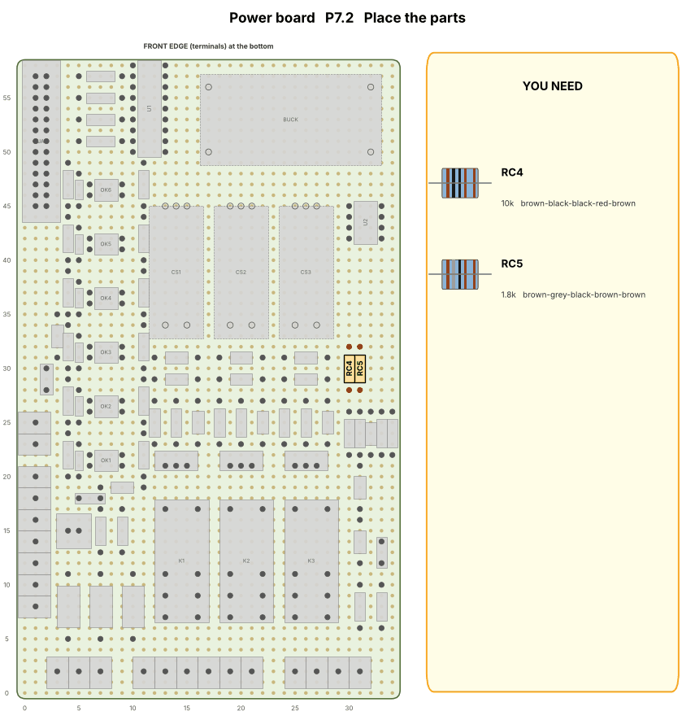
[picture p140: docs/build/power-P7-2.png]
P7.2


- [ ] **RC4**: 10k resistor (bands: brown-black-black-red-brown) → col 30, row 28 and col 30, row 32
- [ ] **RC5**: 1.8k resistor (bands: brown-grey-black-brown-brown) → col 31, row 28 and col 31, row 32

Push the legs through, bend them out a little underneath, solder, snip.

#### P7.3 — Solder 6 wires (bottom side)

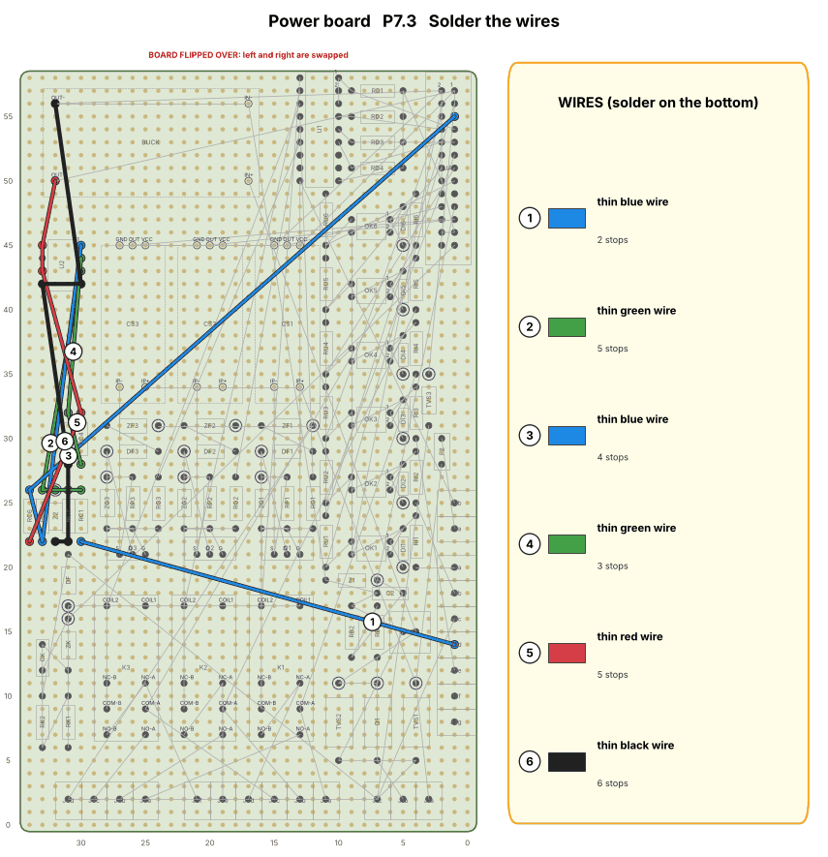
[picture p141: docs/build/power-P7-3.png]
P7.3


- [ ] **1** thin blue wire: **J3d** (SPD) → **RC1** at col 30, row 22
- [ ] **2** thin green wire: **RC1** at col 30, row 26 → **RC2** at col 31, row 26 → **Z2** stripe end → **RC3** at col 33, row 26 → **U2** pin 3
- [ ] **3** thin blue wire: **U2** pin 1 → **RC3** at col 33, row 22 → **RC6** at col 34, row 26 → **JA** pin 5
- [ ] **4** thin green wire: **RC4** at col 30, row 28 → **RC5** at col 31, row 32 → **U2** pin 2
- [ ] **5** thin red wire: **BUCK** OUT+ → **U2** pin 8 → **U2** pin 6 → **RC4** at col 30, row 32 → **RC6** at col 34, row 22
- [ ] **6** thin black wire: **BUCK** OUT- → **U2** pin 4 → **U2** pin 5 → **RC5** at col 31, row 28 → **RC2** at col 31, row 22 → **Z2** plain end

#### P7 — Meter check (power off)

**Every wire:** meter on beep. Hold one probe on the wire's **first** stop and keep it there. Touch the other probe to **each** of its other stops: every one must beep. (This finds a stop that didn't get soldered.)

- [ ] P7.3 wire 1 (blue): from **J3d** (SPD), 1 beep
- [ ] P7.3 wire 2 (green): from **RC1** at col 30, row 26, 4 beeps
- [ ] P7.3 wire 3 (blue): from **U2** pin 1, 3 beeps
- [ ] P7.3 wire 4 (green): from **RC4** at col 30, row 28, 2 beeps
- [ ] P7.3 wire 5 (red): from **BUCK** OUT+, 4 beeps
- [ ] P7.3 wire 6 (black): from **BUCK** OUT-, 5 beeps

**No shorts:** these pairs must **not** beep. (A short chirp that stops straight away is fine: that's a capacitor filling up. A beep that keeps going is a short: find the solder blob before you go on.)

- [ ] **J1a** (+12 DRV) and **J1c** (GND): 12 V (drivers) to ground
- [ ] **J1b** (+12 LOG) and **J1c** (GND): 12 V to ground
- [ ] **JA** pin 1 and **JA** pin 2: 5 V to ground
- [ ] **J1a** (+12 DRV) and **JA** pin 1: 12 V to 5 V
- [ ] **J5b** (FROM ON/OFF) and **J1c** (GND): relay power to ground

<!-- STEP P8 -->
#### P8.1 — Place 6 parts

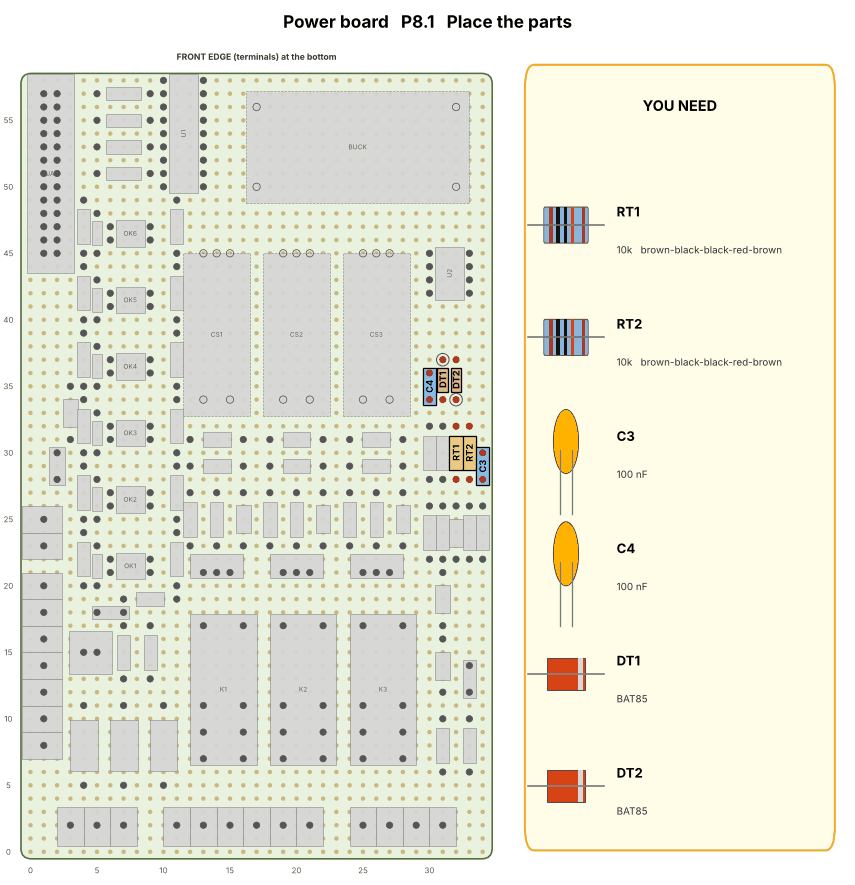
[picture p142: docs/build/power-P8-1.png]
P8.1


- [ ] **RT1**: 10k resistor (bands: brown-black-black-red-brown) → col 32, row 28 and col 32, row 32
- [ ] **RT2**: 10k resistor (bands: brown-black-black-red-brown) → col 33, row 28 and col 33, row 32
- [ ] **C3**: 100 nF capacitor → col 34, row 28 and col 34, row 30
- [ ] **C4**: 100 nF capacitor → col 30, row 34 and col 30, row 36
- [ ] **DT1**: BAT85 diode → col 31, row 34 and col 31, row 37. Stripe towards the back
- [ ] **DT2**: BAT85 diode → col 32, row 37 and col 32, row 34. Stripe towards the front

Push the legs through, bend them out a little underneath, solder, snip.

#### P8.2 — Place 2 parts

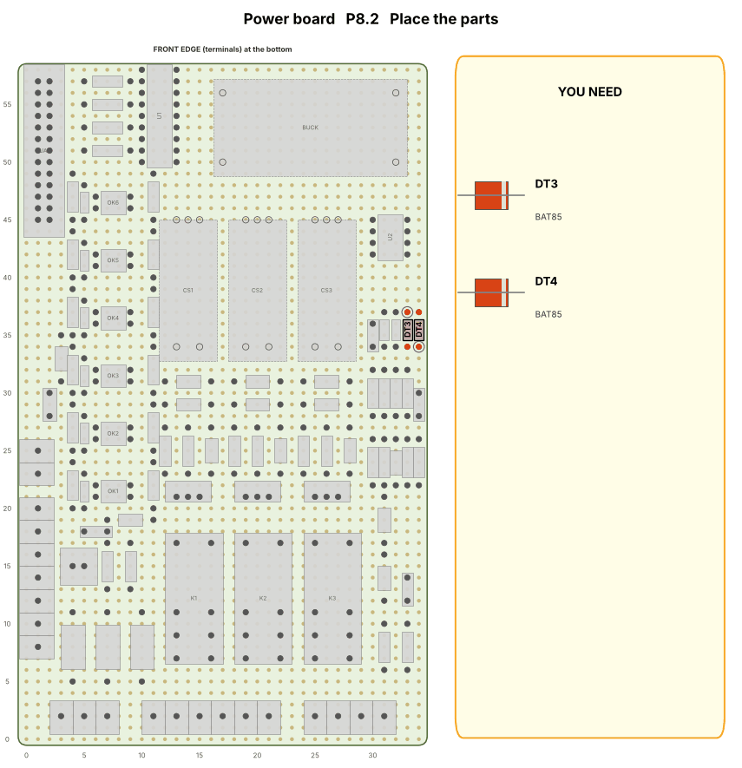
[picture p143: docs/build/power-P8-2.png]
P8.2


- [ ] **DT3**: BAT85 diode → col 33, row 34 and col 33, row 37. Stripe towards the back
- [ ] **DT4**: BAT85 diode → col 34, row 37 and col 34, row 34. Stripe towards the front

Push the legs through, bend them out a little underneath, solder, snip.

#### P8.3 — Solder 6 wires (bottom side)

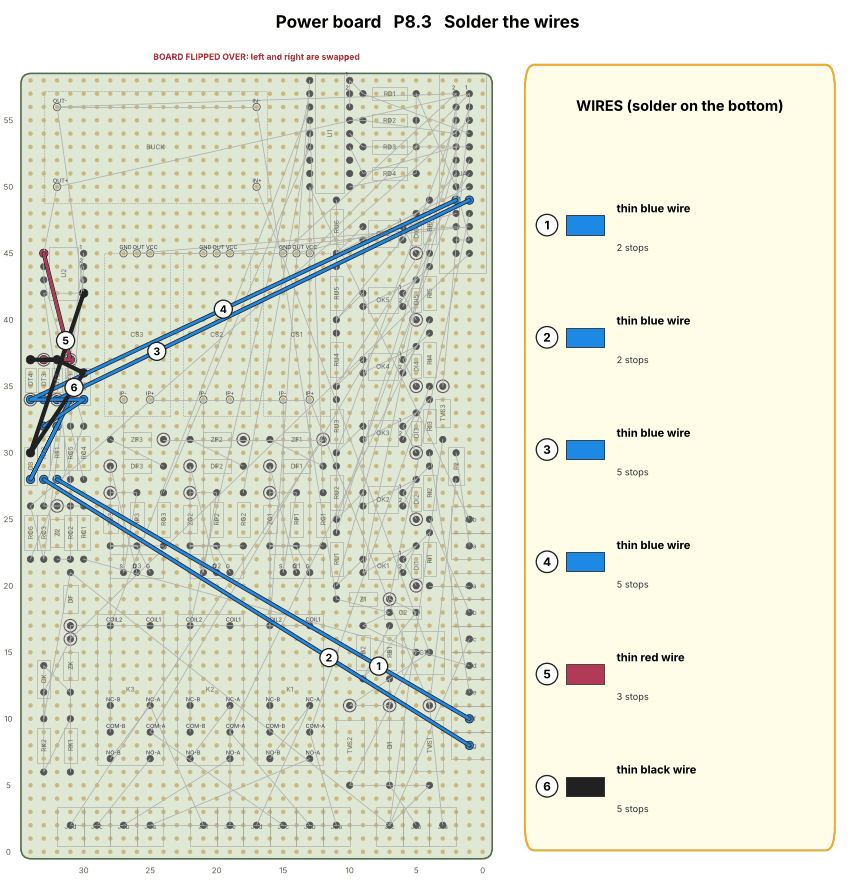
[picture p144: docs/build/power-P8-3.png]
P8.3


- [ ] **1** thin blue wire: **J3f** (VTA) → **RT1** at col 32, row 28
- [ ] **2** thin blue wire: **J3g** (E2) → **RT2** at col 33, row 28
- [ ] **3** thin blue wire: **RT1** at col 32, row 32 → **C3** at col 34, row 28 → **DT1** plain end → **DT2** stripe end → **JA** pin 17
- [ ] **4** thin blue wire: **RT2** at col 33, row 32 → **C4** at col 30, row 34 → **DT3** plain end → **DT4** stripe end → **JA** pin 18
- [ ] **5** thin red wire: **U2** pin 8 → **DT1** stripe end → **DT3** stripe end
- [ ] **6** thin black wire: **U2** pin 4 → **C3** at col 34, row 30 → **C4** at col 30, row 36 → **DT2** plain end → **DT4** plain end

#### P8 — Meter check (power off)

**Every wire:** meter on beep. Hold one probe on the wire's **first** stop and keep it there. Touch the other probe to **each** of its other stops: every one must beep. (This finds a stop that didn't get soldered.)

- [ ] P8.3 wire 1 (blue): from **J3f** (VTA), 1 beep
- [ ] P8.3 wire 2 (blue): from **J3g** (E2), 1 beep
- [ ] P8.3 wire 3 (blue): from **RT1** at col 32, row 32, 4 beeps
- [ ] P8.3 wire 4 (blue): from **RT2** at col 33, row 32, 4 beeps
- [ ] P8.3 wire 5 (red): from **U2** pin 8, 2 beeps
- [ ] P8.3 wire 6 (black): from **U2** pin 4, 4 beeps

**No shorts:** these pairs must **not** beep. (A short chirp that stops straight away is fine: that's a capacitor filling up. A beep that keeps going is a short: find the solder blob before you go on.)

- [ ] **J1a** (+12 DRV) and **J1c** (GND): 12 V (drivers) to ground
- [ ] **J1b** (+12 LOG) and **J1c** (GND): 12 V to ground
- [ ] **JA** pin 1 and **JA** pin 2: 5 V to ground
- [ ] **J1a** (+12 DRV) and **JA** pin 1: 12 V to 5 V
- [ ] **J5b** (FROM ON/OFF) and **J1c** (GND): relay power to ground

<!-- STEP L1 -->
#### L1.1 — Place 6 parts

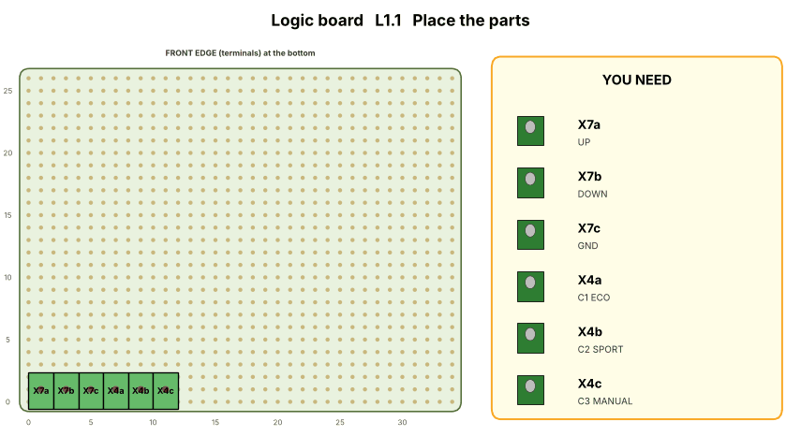
[picture p145: docs/build/logic-L1-1.png]
L1.1


- [ ] **X7a**: UP screw terminal → col 1, row 1
- [ ] **X7b**: DOWN screw terminal → col 3, row 1
- [ ] **X7c**: GND screw terminal → col 5, row 1
- [ ] **X4a**: C1 ECO screw terminal → col 7, row 1
- [ ] **X4b**: C2 SPORT screw terminal → col 9, row 1
- [ ] **X4c**: C3 MANUAL screw terminal → col 11, row 1

Push the legs through, bend them out a little underneath, solder, snip.

#### L1.2 — Place 6 parts

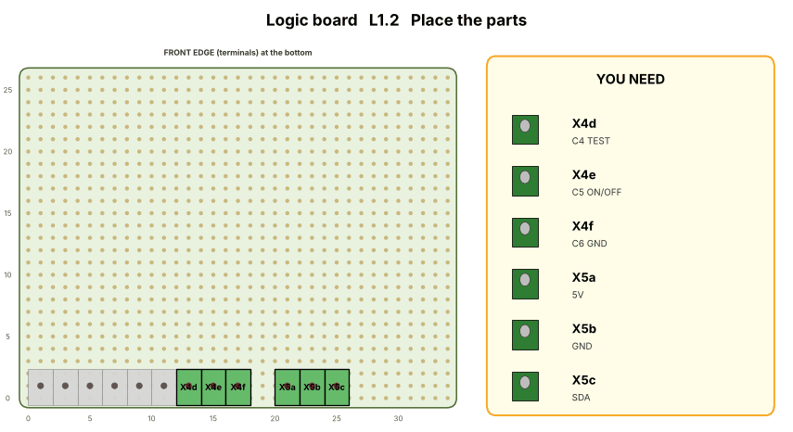
[picture p146: docs/build/logic-L1-2.png]
L1.2


- [ ] **X4d**: C4 TEST screw terminal → col 13, row 1
- [ ] **X4e**: C5 ON/OFF screw terminal → col 15, row 1
- [ ] **X4f**: C6 GND screw terminal → col 17, row 1
- [ ] **X5a**: 5V screw terminal → col 21, row 1
- [ ] **X5b**: GND screw terminal → col 23, row 1
- [ ] **X5c**: SDA screw terminal → col 25, row 1

Push the legs through, bend them out a little underneath, solder, snip.

#### L1.3 — Place 5 parts

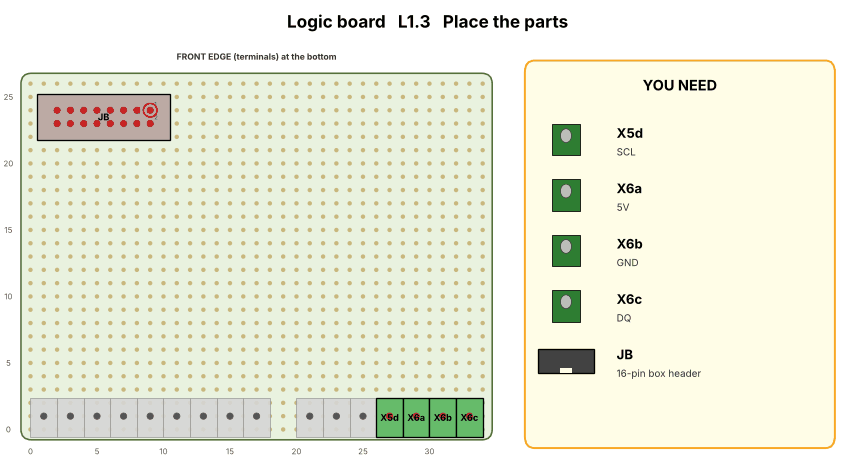
[picture p147: docs/build/logic-L1-3.png]
L1.3


- [ ] **X5d**: SCL screw terminal → col 27, row 1
- [ ] **X6a**: 5V screw terminal → col 29, row 1
- [ ] **X6b**: GND screw terminal → col 31, row 1
- [ ] **X6c**: DQ screw terminal → col 33, row 1
- [ ] **JB**: 16-pin box header (ribbon socket) → pin 1 in col 9, row 24. Notch facing the back edge; the square pad (pin 1) at the right-hand end, back row

Push the legs through, bend them out a little underneath, solder, snip.

#### L1.4 — Solder 4 wires (bottom side)

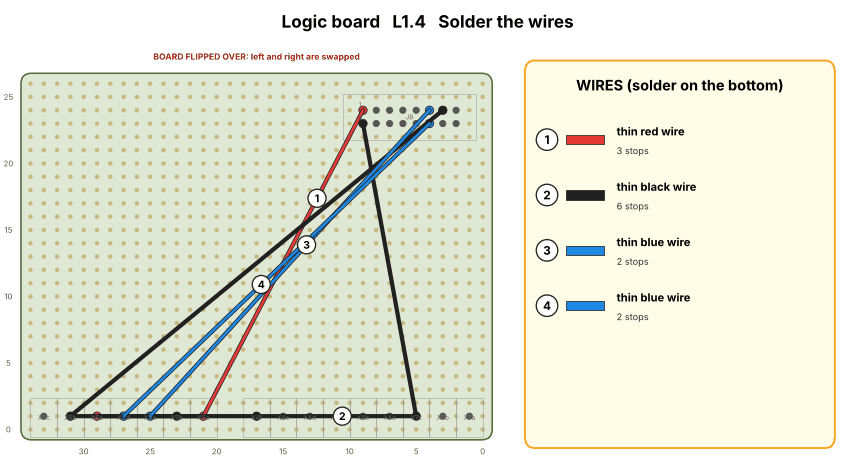
[picture p148: docs/build/logic-L1-4.png]
L1.4


- [ ] **1** thin red wire: **JB** pin 1 → **X5a** (5V) → **X6a** (5V)
- [ ] **2** thin black wire: **JB** pin 2 → **X7c** (GND) → **X4f** (C6 GND) → **X5b** (GND) → **X6b** (GND) → **JB** pin 13
- [ ] **3** thin blue wire: **JB** pin 11 → **X5c** (SDA)
- [ ] **4** thin blue wire: **JB** pin 12 → **X5d** (SCL)

#### L1 — Meter check (power off)

**Every wire:** meter on beep. Hold one probe on the wire's **first** stop and keep it there. Touch the other probe to **each** of its other stops: every one must beep. (This finds a stop that didn't get soldered.)

- [ ] L1.4 wire 1 (red): from **JB** pin 1, 2 beeps
- [ ] L1.4 wire 2 (black): from **JB** pin 2, 5 beeps
- [ ] L1.4 wire 3 (blue): from **JB** pin 11, 1 beep
- [ ] L1.4 wire 4 (blue): from **JB** pin 12, 1 beep

**No shorts:** these pairs must **not** beep. (A short chirp that stops straight away is fine: that's a capacitor filling up. A beep that keeps going is a short: find the solder blob before you go on.)

- [ ] **JB** pin 1 and **JB** pin 2: 5 V to ground
- [ ] **X5a** (5V) and **X5b** (GND): the screen's 5 V to ground

<!-- STEP L2 -->
#### L2.1 — Place 6 parts

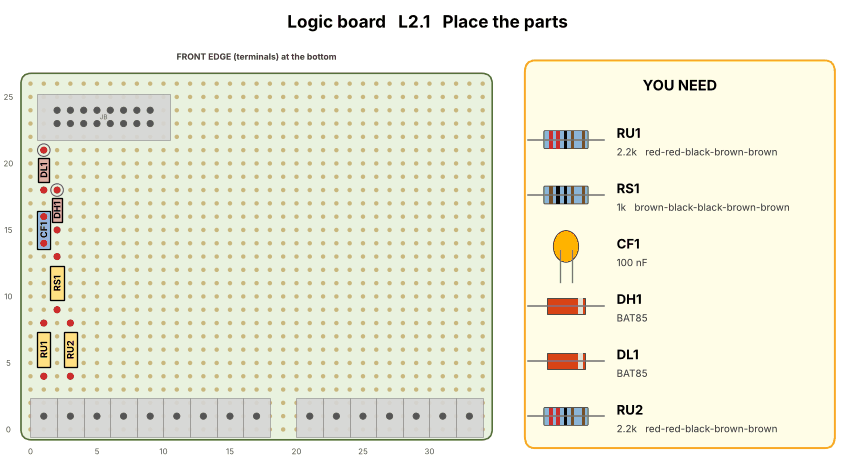
[picture p149: docs/build/logic-L2-1.png]
L2.1


- [ ] **RU1**: 2.2k resistor (bands: red-red-black-brown-brown) → col 1, row 4 and col 1, row 8
- [ ] **RS1**: 1k resistor (bands: brown-black-black-brown-brown) → col 2, row 9 and col 2, row 13
- [ ] **CF1**: 100 nF capacitor → col 1, row 14 and col 1, row 16
- [ ] **DH1**: BAT85 diode → col 2, row 15 and col 2, row 18. Stripe towards the back
- [ ] **DL1**: BAT85 diode → col 1, row 18 and col 1, row 21. Stripe towards the back
- [ ] **RU2**: 2.2k resistor (bands: red-red-black-brown-brown) → col 3, row 4 and col 3, row 8

Push the legs through, bend them out a little underneath, solder, snip.

#### L2.2 — Place 6 parts

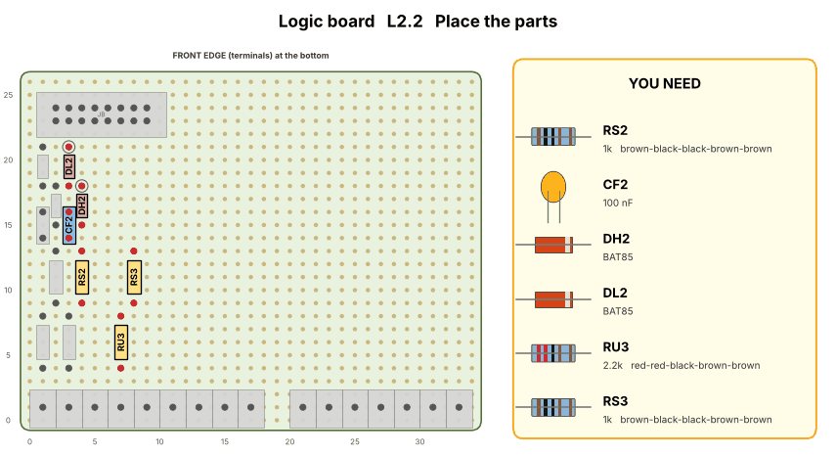
[picture p150: docs/build/logic-L2-2.png]
L2.2


- [ ] **RS2**: 1k resistor (bands: brown-black-black-brown-brown) → col 4, row 9 and col 4, row 13
- [ ] **CF2**: 100 nF capacitor → col 3, row 14 and col 3, row 16
- [ ] **DH2**: BAT85 diode → col 4, row 15 and col 4, row 18. Stripe towards the back
- [ ] **DL2**: BAT85 diode → col 3, row 18 and col 3, row 21. Stripe towards the back
- [ ] **RU3**: 2.2k resistor (bands: red-red-black-brown-brown) → col 7, row 4 and col 7, row 8
- [ ] **RS3**: 1k resistor (bands: brown-black-black-brown-brown) → col 8, row 9 and col 8, row 13

Push the legs through, bend them out a little underneath, solder, snip.

#### L2.3 — Place 6 parts

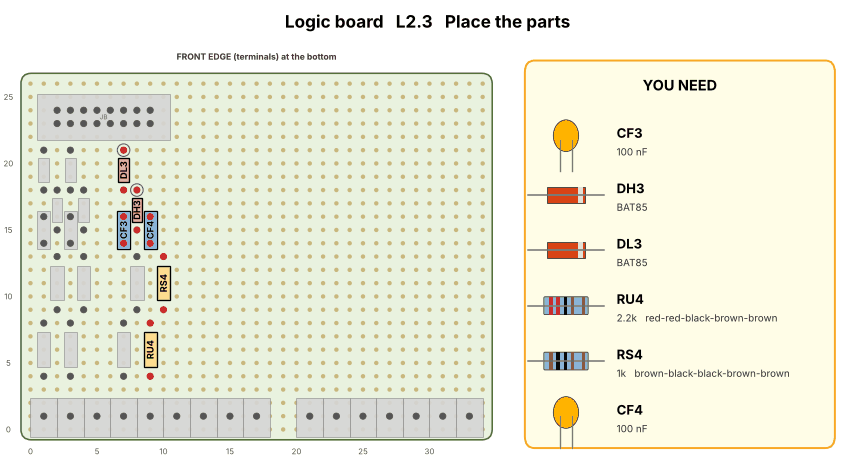
[picture p151: docs/build/logic-L2-3.png]
L2.3


- [ ] **CF3**: 100 nF capacitor → col 7, row 14 and col 7, row 16
- [ ] **DH3**: BAT85 diode → col 8, row 15 and col 8, row 18. Stripe towards the back
- [ ] **DL3**: BAT85 diode → col 7, row 18 and col 7, row 21. Stripe towards the back
- [ ] **RU4**: 2.2k resistor (bands: red-red-black-brown-brown) → col 9, row 4 and col 9, row 8
- [ ] **RS4**: 1k resistor (bands: brown-black-black-brown-brown) → col 10, row 9 and col 10, row 13
- [ ] **CF4**: 100 nF capacitor → col 9, row 14 and col 9, row 16

Push the legs through, bend them out a little underneath, solder, snip.

#### L2.4 — Place 6 parts

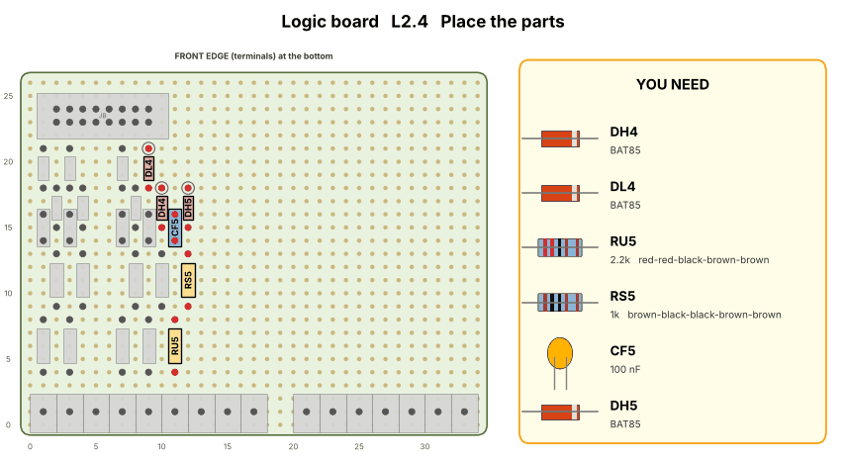
[picture p152: docs/build/logic-L2-4.png]
L2.4


- [ ] **DH4**: BAT85 diode → col 10, row 15 and col 10, row 18. Stripe towards the back
- [ ] **DL4**: BAT85 diode → col 9, row 18 and col 9, row 21. Stripe towards the back
- [ ] **RU5**: 2.2k resistor (bands: red-red-black-brown-brown) → col 11, row 4 and col 11, row 8
- [ ] **RS5**: 1k resistor (bands: brown-black-black-brown-brown) → col 12, row 9 and col 12, row 13
- [ ] **CF5**: 100 nF capacitor → col 11, row 14 and col 11, row 16
- [ ] **DH5**: BAT85 diode → col 12, row 15 and col 12, row 18. Stripe towards the back

Push the legs through, bend them out a little underneath, solder, snip.

#### L2.5 — Place 6 parts

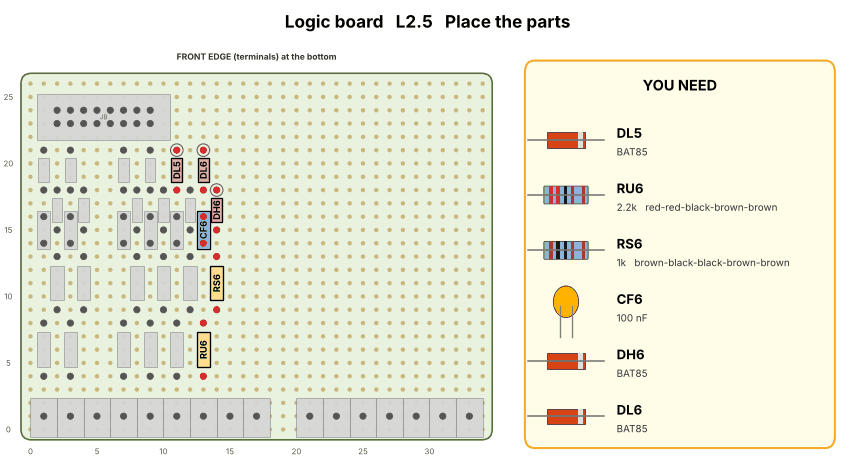
[picture p153: docs/build/logic-L2-5.png]
L2.5


- [ ] **DL5**: BAT85 diode → col 11, row 18 and col 11, row 21. Stripe towards the back
- [ ] **RU6**: 2.2k resistor (bands: red-red-black-brown-brown) → col 13, row 4 and col 13, row 8
- [ ] **RS6**: 1k resistor (bands: brown-black-black-brown-brown) → col 14, row 9 and col 14, row 13
- [ ] **CF6**: 100 nF capacitor → col 13, row 14 and col 13, row 16
- [ ] **DH6**: BAT85 diode → col 14, row 15 and col 14, row 18. Stripe towards the back
- [ ] **DL6**: BAT85 diode → col 13, row 18 and col 13, row 21. Stripe towards the back

Push the legs through, bend them out a little underneath, solder, snip.

#### L2.6 — Place 5 parts

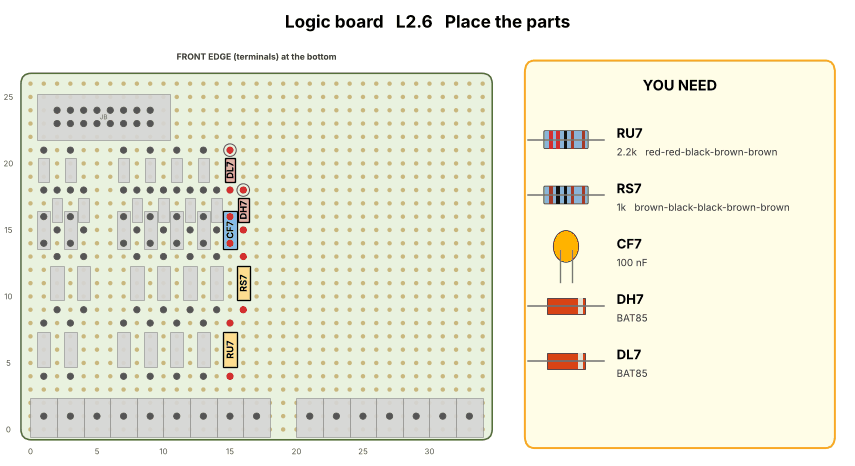
[picture p154: docs/build/logic-L2-6.png]
L2.6


- [ ] **RU7**: 2.2k resistor (bands: red-red-black-brown-brown) → col 15, row 4 and col 15, row 8
- [ ] **RS7**: 1k resistor (bands: brown-black-black-brown-brown) → col 16, row 9 and col 16, row 13
- [ ] **CF7**: 100 nF capacitor → col 15, row 14 and col 15, row 16
- [ ] **DH7**: BAT85 diode → col 16, row 15 and col 16, row 18. Stripe towards the back
- [ ] **DL7**: BAT85 diode → col 15, row 18 and col 15, row 21. Stripe towards the back

Push the legs through, bend them out a little underneath, solder, snip.

#### L2.7 — Solder 6 wires (bottom side)

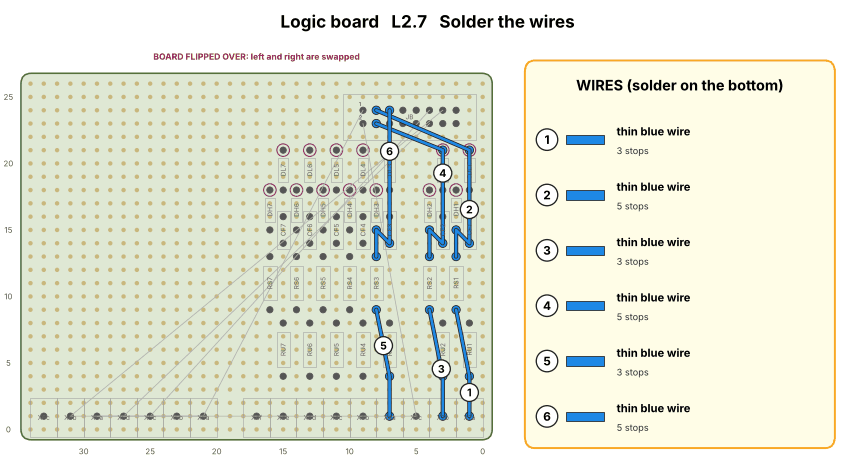
[picture p155: docs/build/logic-L2-7.png]
L2.7


- [ ] **1** thin blue wire: **X7a** (UP) → **RU1** at col 1, row 4 → **RS1** at col 2, row 9
- [ ] **2** thin blue wire: **RS1** at col 2, row 13 → **DH1** plain end → **CF1** at col 1, row 14 → **DL1** stripe end → **JB** pin 3
- [ ] **3** thin blue wire: **X7b** (DOWN) → **RU2** at col 3, row 4 → **RS2** at col 4, row 9
- [ ] **4** thin blue wire: **RS2** at col 4, row 13 → **DH2** plain end → **CF2** at col 3, row 14 → **DL2** stripe end → **JB** pin 4
- [ ] **5** thin blue wire: **X4a** (C1 ECO) → **RU3** at col 7, row 4 → **RS3** at col 8, row 9
- [ ] **6** thin blue wire: **RS3** at col 8, row 13 → **DH3** plain end → **CF3** at col 7, row 14 → **DL3** stripe end → **JB** pin 5

#### L2.8 — Solder 6 wires (bottom side)

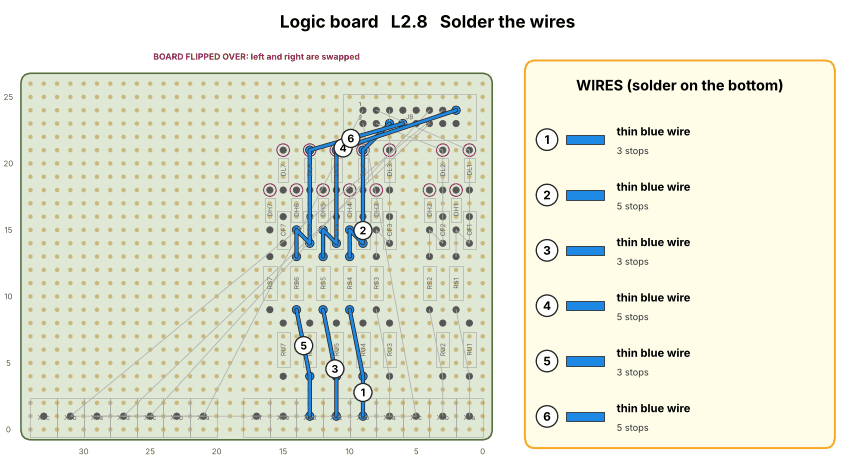
[picture p156: docs/build/logic-L2-8.png]
L2.8


- [ ] **1** thin blue wire: **X4b** (C2 SPORT) → **RU4** at col 9, row 4 → **RS4** at col 10, row 9
- [ ] **2** thin blue wire: **RS4** at col 10, row 13 → **DH4** plain end → **CF4** at col 9, row 14 → **DL4** stripe end → **JB** pin 6
- [ ] **3** thin blue wire: **X4c** (C3 MANUAL) → **RU5** at col 11, row 4 → **RS5** at col 12, row 9
- [ ] **4** thin blue wire: **RS5** at col 12, row 13 → **DH5** plain end → **CF5** at col 11, row 14 → **DL5** stripe end → **JB** pin 15
- [ ] **5** thin blue wire: **X4d** (C4 TEST) → **RU6** at col 13, row 4 → **RS6** at col 14, row 9
- [ ] **6** thin blue wire: **RS6** at col 14, row 13 → **DH6** plain end → **CF6** at col 13, row 14 → **DL6** stripe end → **JB** pin 8

#### L2.9 — Solder 4 wires (bottom side)

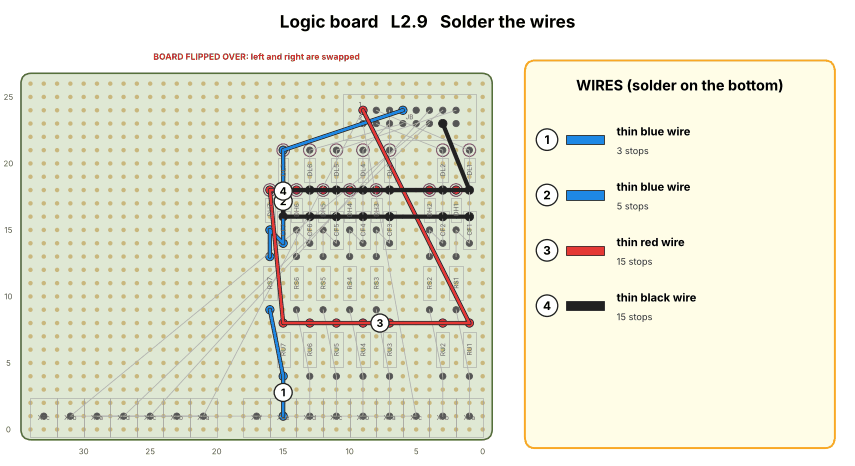
[picture p157: docs/build/logic-L2-9.png]
L2.9


- [ ] **1** thin blue wire: **X4e** (C5 ON/OFF) → **RU7** at col 15, row 4 → **RS7** at col 16, row 9
- [ ] **2** thin blue wire: **RS7** at col 16, row 13 → **DH7** plain end → **CF7** at col 15, row 14 → **DL7** stripe end → **JB** pin 7
- [ ] **3** thin red wire: **JB** pin 1 → **RU1** at col 1, row 8 → **RU2** at col 3, row 8 → **RU3** at col 7, row 8 → **RU4** at col 9, row 8 → **RU5** at col 11, row 8 → **RU6** at col 13, row 8 → **RU7** at col 15, row 8 → **DH7** stripe end → **DH6** stripe end → **DH5** stripe end → **DH4** stripe end → **DH3** stripe end → **DH2** stripe end → **DH1** stripe end
- [ ] **4** thin black wire: **JB** pin 14 → **DL1** plain end → **DL2** plain end → **DL3** plain end → **DL4** plain end → **DL5** plain end → **DL6** plain end → **DL7** plain end → **CF7** at col 15, row 16 → **CF6** at col 13, row 16 → **CF5** at col 11, row 16 → **CF4** at col 9, row 16 → **CF3** at col 7, row 16 → **CF2** at col 3, row 16 → **CF1** at col 1, row 16

#### L2 — Meter check (power off)

**Every wire:** meter on beep. Hold one probe on the wire's **first** stop and keep it there. Touch the other probe to **each** of its other stops: every one must beep. (This finds a stop that didn't get soldered.)

- [ ] L2.7 wire 1 (blue): from **X7a** (UP), 2 beeps
- [ ] L2.7 wire 2 (blue): from **RS1** at col 2, row 13, 4 beeps
- [ ] L2.7 wire 3 (blue): from **X7b** (DOWN), 2 beeps
- [ ] L2.7 wire 4 (blue): from **RS2** at col 4, row 13, 4 beeps
- [ ] L2.7 wire 5 (blue): from **X4a** (C1 ECO), 2 beeps
- [ ] L2.7 wire 6 (blue): from **RS3** at col 8, row 13, 4 beeps
- [ ] L2.8 wire 1 (blue): from **X4b** (C2 SPORT), 2 beeps
- [ ] L2.8 wire 2 (blue): from **RS4** at col 10, row 13, 4 beeps
- [ ] L2.8 wire 3 (blue): from **X4c** (C3 MANUAL), 2 beeps
- [ ] L2.8 wire 4 (blue): from **RS5** at col 12, row 13, 4 beeps
- [ ] L2.8 wire 5 (blue): from **X4d** (C4 TEST), 2 beeps
- [ ] L2.8 wire 6 (blue): from **RS6** at col 14, row 13, 4 beeps
- [ ] L2.9 wire 1 (blue): from **X4e** (C5 ON/OFF), 2 beeps
- [ ] L2.9 wire 2 (blue): from **RS7** at col 16, row 13, 4 beeps
- [ ] L2.9 wire 3 (red): from **JB** pin 1, 14 beeps
- [ ] L2.9 wire 4 (black): from **JB** pin 14, 14 beeps

**No shorts:** these pairs must **not** beep. (A short chirp that stops straight away is fine: that's a capacitor filling up. A beep that keeps going is a short: find the solder blob before you go on.)

- [ ] **JB** pin 1 and **JB** pin 2: 5 V to ground
- [ ] **X5a** (5V) and **X5b** (GND): the screen's 5 V to ground

<!-- STEP L3 -->
#### L3.1 — Place 3 parts

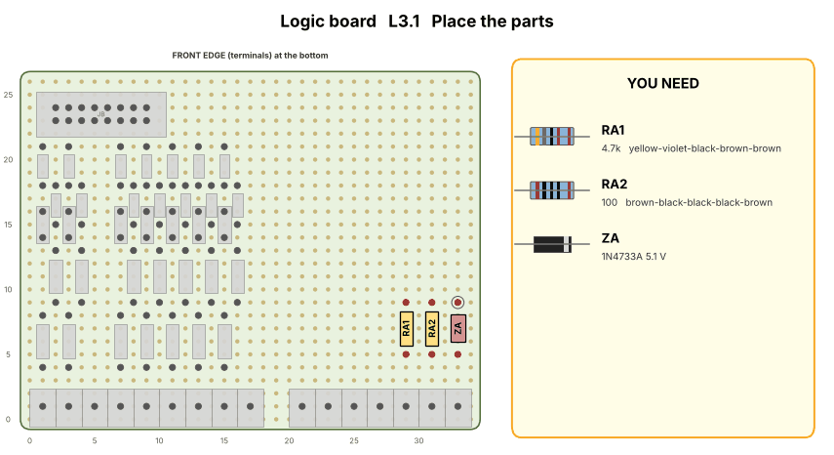
[picture p158: docs/build/logic-L3-1.png]
L3.1


- [ ] **RA1**: 4.7k resistor (bands: yellow-violet-black-brown-brown) → col 29, row 5 and col 29, row 9
- [ ] **RA2**: 100 resistor (bands: brown-black-black-black-brown) → col 31, row 5 and col 31, row 9
- [ ] **ZA**: 1N4733A 5.1 V diode → col 33, row 5 and col 33, row 9. Stripe towards the back

Push the legs through, bend them out a little underneath, solder, snip.

#### L3.2 — Solder 4 wires (bottom side)

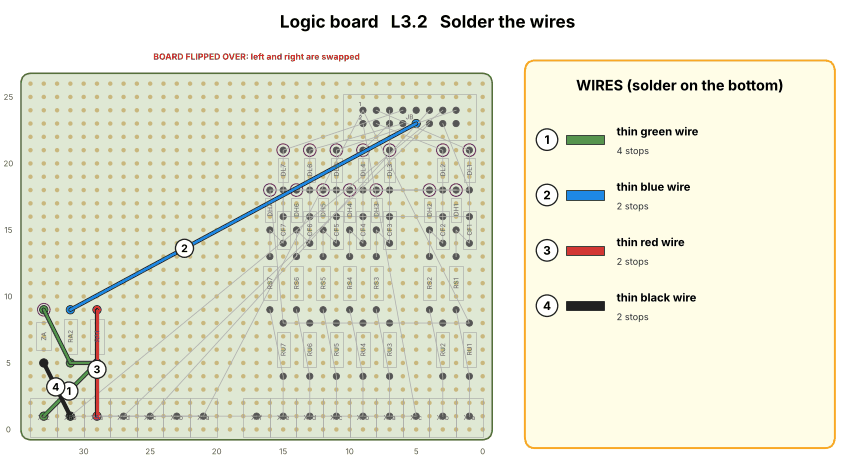
[picture p159: docs/build/logic-L3-2.png]
L3.2


- [ ] **1** thin green wire: **X6c** (DQ) → **RA1** at col 29, row 5 → **RA2** at col 31, row 5 → **ZA** stripe end
- [ ] **2** thin blue wire: **RA2** at col 31, row 9 → **JB** pin 10
- [ ] **3** thin red wire: **X6a** (5V) → **RA1** at col 29, row 9
- [ ] **4** thin black wire: **X6b** (GND) → **ZA** plain end

#### L3 — Meter check (power off)

**Every wire:** meter on beep. Hold one probe on the wire's **first** stop and keep it there. Touch the other probe to **each** of its other stops: every one must beep. (This finds a stop that didn't get soldered.)

- [ ] L3.2 wire 1 (green): from **X6c** (DQ), 3 beeps
- [ ] L3.2 wire 2 (blue): from **RA2** at col 31, row 9, 1 beep
- [ ] L3.2 wire 3 (red): from **X6a** (5V), 1 beep
- [ ] L3.2 wire 4 (black): from **X6b** (GND), 1 beep

**No shorts:** these pairs must **not** beep. (A short chirp that stops straight away is fine: that's a capacitor filling up. A beep that keeps going is a short: find the solder blob before you go on.)

- [ ] **JB** pin 1 and **JB** pin 2: 5 V to ground
- [ ] **X5a** (5V) and **X5b** (GND): the screen's 5 V to ground

<!-- STEP L4 -->
#### L4.1 — Place 1 part

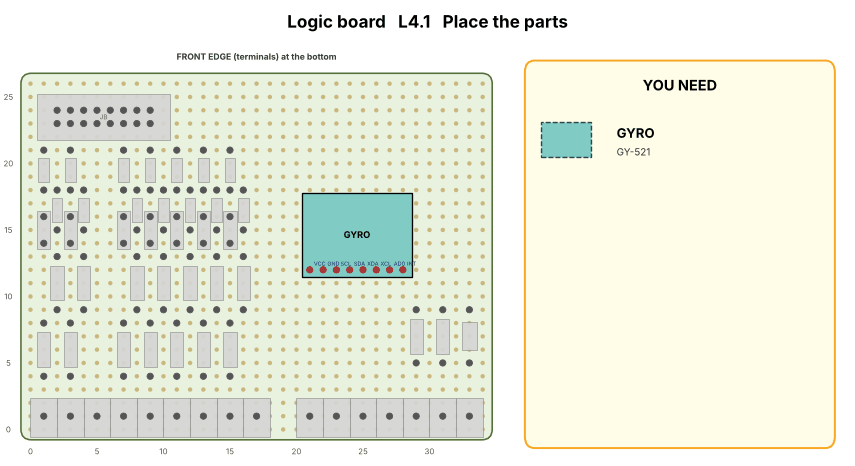
[picture p160: docs/build/logic-L4-1.png]
L4.1


- [ ] **GYRO**: GY-521 module → VCC in col 21, row 12. Chip side up, flat on its header + a dab of hot glue

Push the legs through, bend them out a little underneath, solder, snip.

#### L4.2 — Solder 4 wires (bottom side)

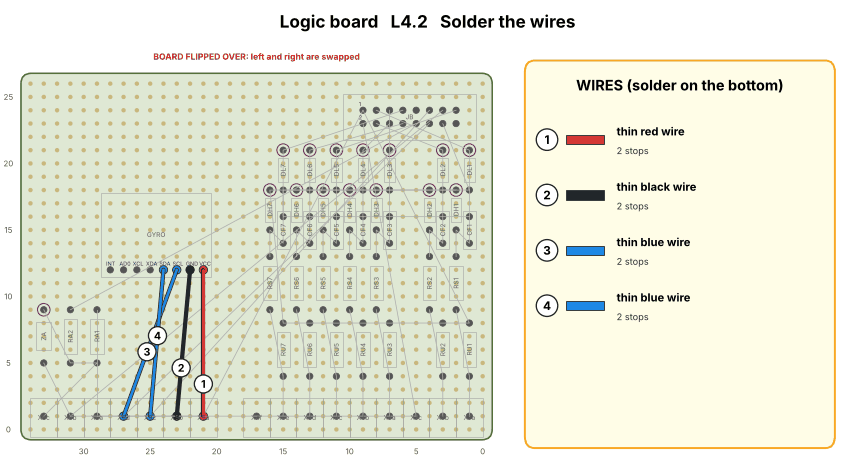
[picture p161: docs/build/logic-L4-2.png]
L4.2


- [ ] **1** thin red wire: **X5a** (5V) → **GYRO** VCC
- [ ] **2** thin black wire: **X5b** (GND) → **GYRO** GND
- [ ] **3** thin blue wire: **X5d** (SCL) → **GYRO** SCL
- [ ] **4** thin blue wire: **X5c** (SDA) → **GYRO** SDA

#### L4 — Meter check (power off)

**Every wire:** meter on beep. Hold one probe on the wire's **first** stop and keep it there. Touch the other probe to **each** of its other stops: every one must beep. (This finds a stop that didn't get soldered.)

- [ ] L4.2 wire 1 (red): from **X5a** (5V), 1 beep
- [ ] L4.2 wire 2 (black): from **X5b** (GND), 1 beep
- [ ] L4.2 wire 3 (blue): from **X5d** (SCL), 1 beep
- [ ] L4.2 wire 4 (blue): from **X5c** (SDA), 1 beep

**No shorts:** these pairs must **not** beep. (A short chirp that stops straight away is fine: that's a capacitor filling up. A beep that keeps going is a short: find the solder blob before you go on.)

- [ ] **JB** pin 1 and **JB** pin 2: 5 V to ground
- [ ] **X5a** (5V) and **X5b** (GND): the screen's 5 V to ground

<!-- STEP HUB -->
**Header A** (26-way, to the power board):

- [ ] A1 → **5V** (5V)
- [ ] A2 → **GND** (GND)
- [ ] A3 → **5V** (5V)
- [ ] A4 → **GND** (GND)
- [ ] A5 → **D2** (SPD (speed))
- [ ] A6 → **D3** (TAC (tach))
- [ ] A7 → **D6** (RLY (relays))
- [ ] A8 → **D8** (DRV1 (S1 driver))
- [ ] A9 → **D9** (DRV2 (S2 driver))
- [ ] A10 → **D10** (DRV3 (SL driver))
- [ ] A11 → **D27** (STP (brake))
- [ ] A12 → **D28** (LEVD (lever in D))
- [ ] A13 → **D29** (ECU1 (ECU S1))
- [ ] A14 → **D30** (ECU2 (ECU S2))
- [ ] A15 → **D31** (ECU3 (ECU SL))
- [ ] A16 → **GND** (GND)
- [ ] A17 → **A0** (VTA (throttle))
- [ ] A18 → **A1** (E2 (throttle ground))
- [ ] A19 → **A3** (VBAT (battery))
- [ ] A20 → **A4** (IS1 (S1 current))
- [ ] A21 → **A5** (IS2 (S2 current))
- [ ] A22 → **A6** (IS3 (SL current))
- [ ] A23 → **GND** (GND)
- [ ] A24 → **GND** (GND)
- [ ] A25 → **A7** (COILSNS (relay power sense))

**Header B** (16-way, to the logic board):

- [ ] B1 → **5V** (5V)
- [ ] B2 → **GND** (GND)
- [ ] B3 → **D22** (shifter UP)
- [ ] B4 → **D23** (shifter DOWN)
- [ ] B5 → **D24** (ECO)
- [ ] B6 → **D25** (SPORT)
- [ ] B7 → **D26** (ON/OFF)
- [ ] B8 → **D32** (TEST)
- [ ] B10 → **D33** (ATF probe)
- [ ] B11 → **D20 (SDA)** (SDA)
- [ ] B12 → **D21 (SCL)** (SCL)
- [ ] B13 → **GND** (GND)
- [ ] B14 → **GND** (GND)
- [ ] B15 → **D34** (MANUAL)

Pins A26, B9 and B16 stay empty.
