gamer927/rav4/docs/build/logic-L1.png

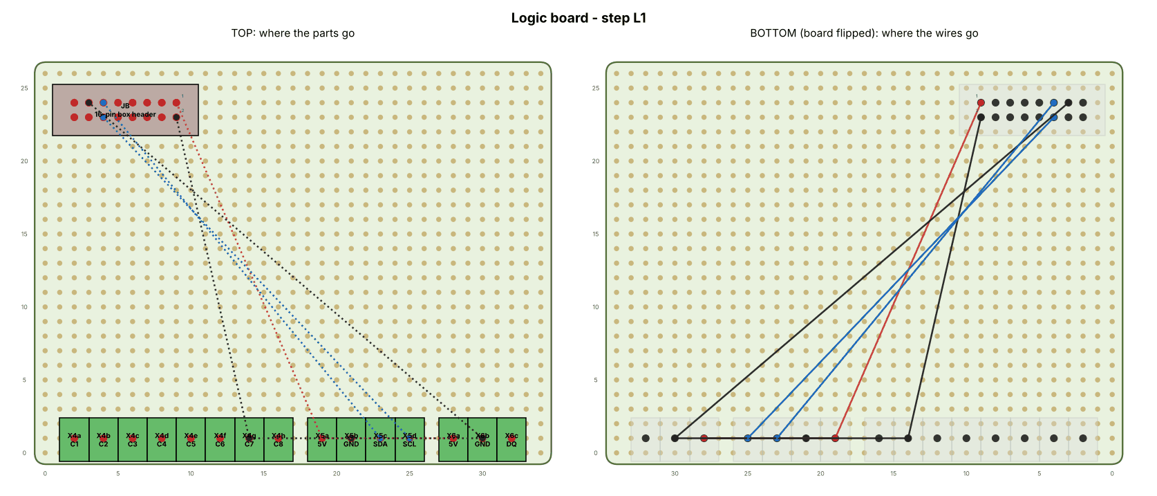
docs/build/logic-L1.png
