gamer927/rav4/docs/build/logic-L2.png

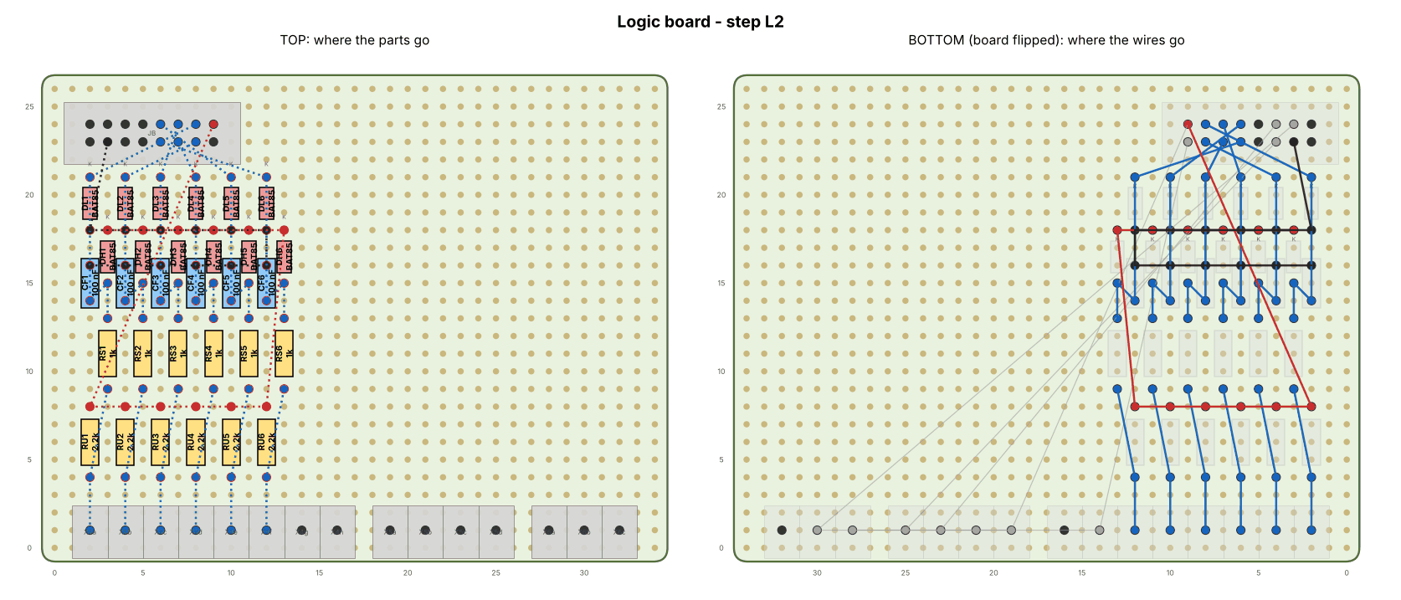
docs/build/logic-L2.png
