gamer927/rav4/docs/build/logic-L3.png

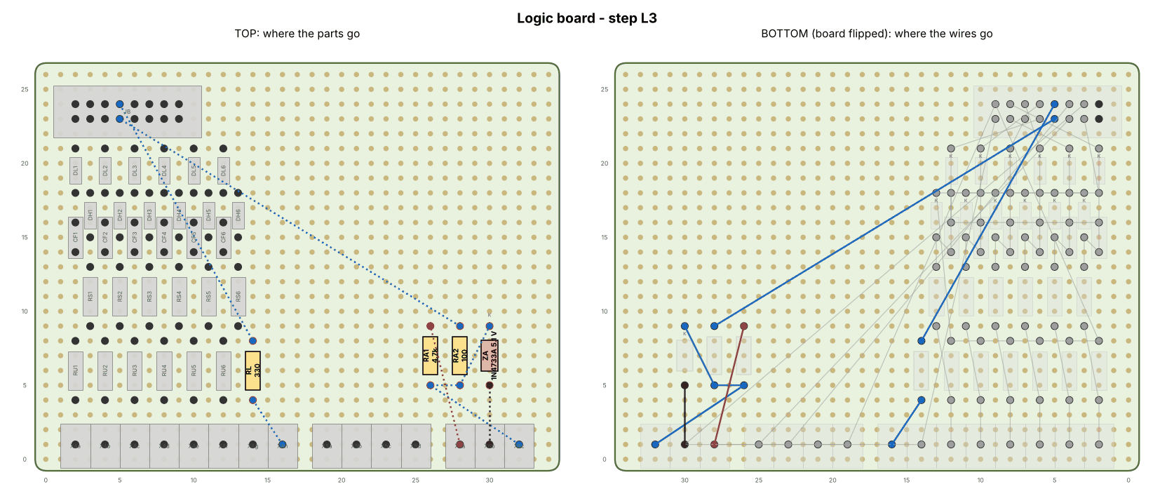
docs/build/logic-L3.png
