gamer927/rav4/docs/build/logic-L4.png

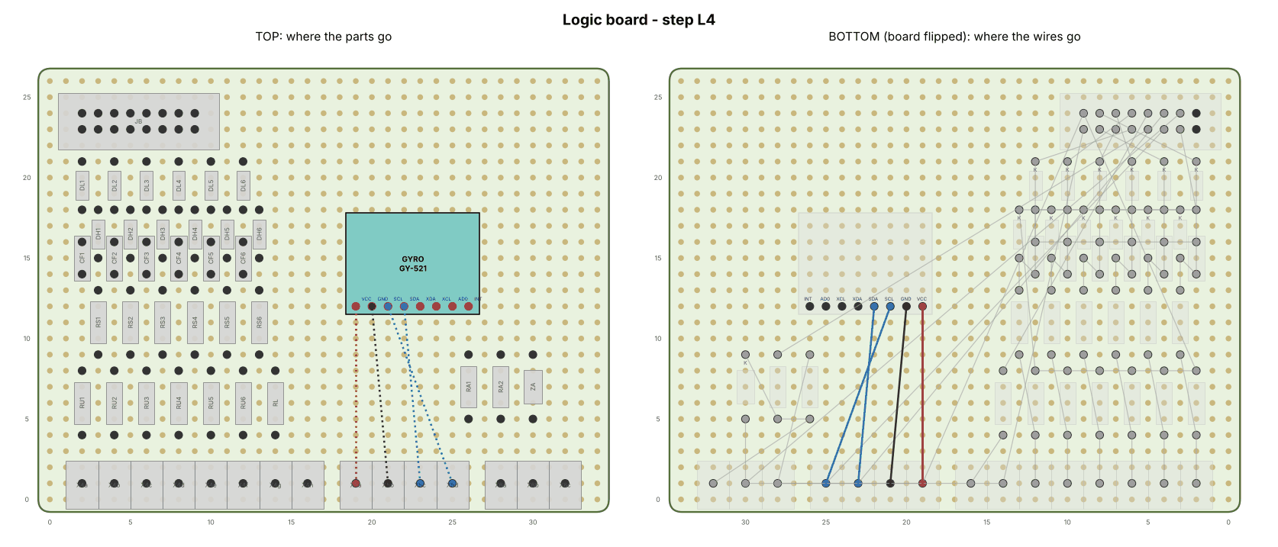
docs/build/logic-L4.png
