gamer927/rav4/docs/build/logic-layout.png

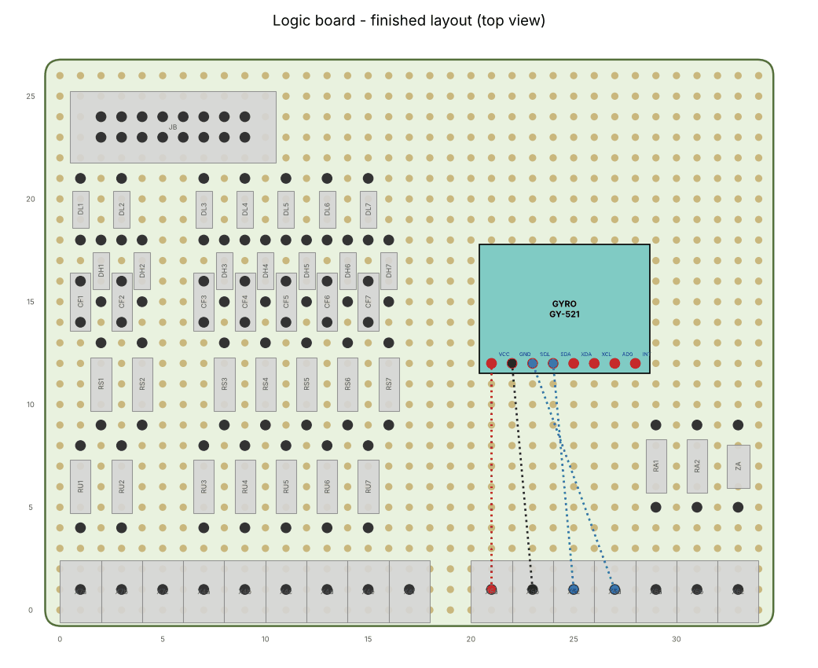
docs/build/logic-layout.png
