gamer927/rav4/docs/build/pod-6.png

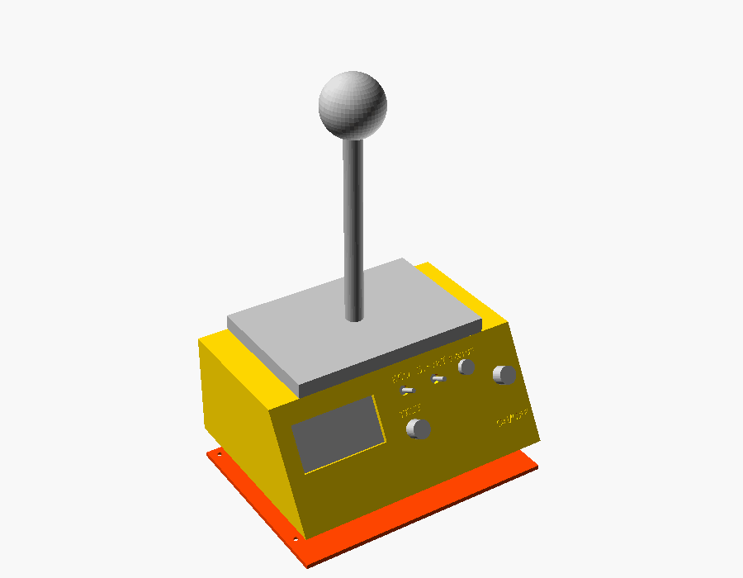
docs/build/pod-6.png
