gamer927/rav4/docs/build/power-layout.png

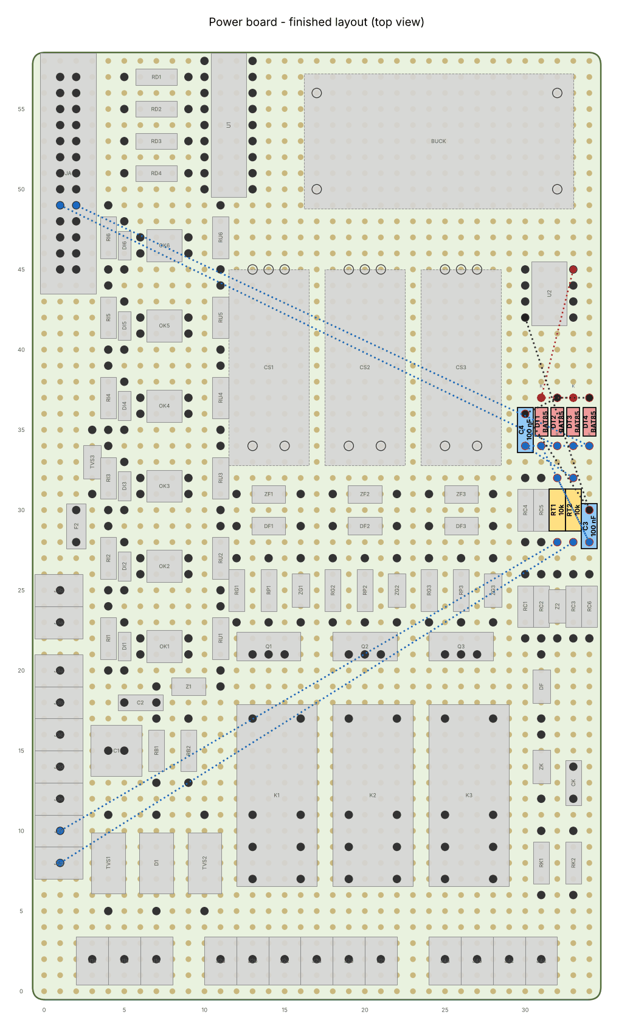
docs/build/power-layout.png
