gamer927/rav4/docs/build/power-P1.png

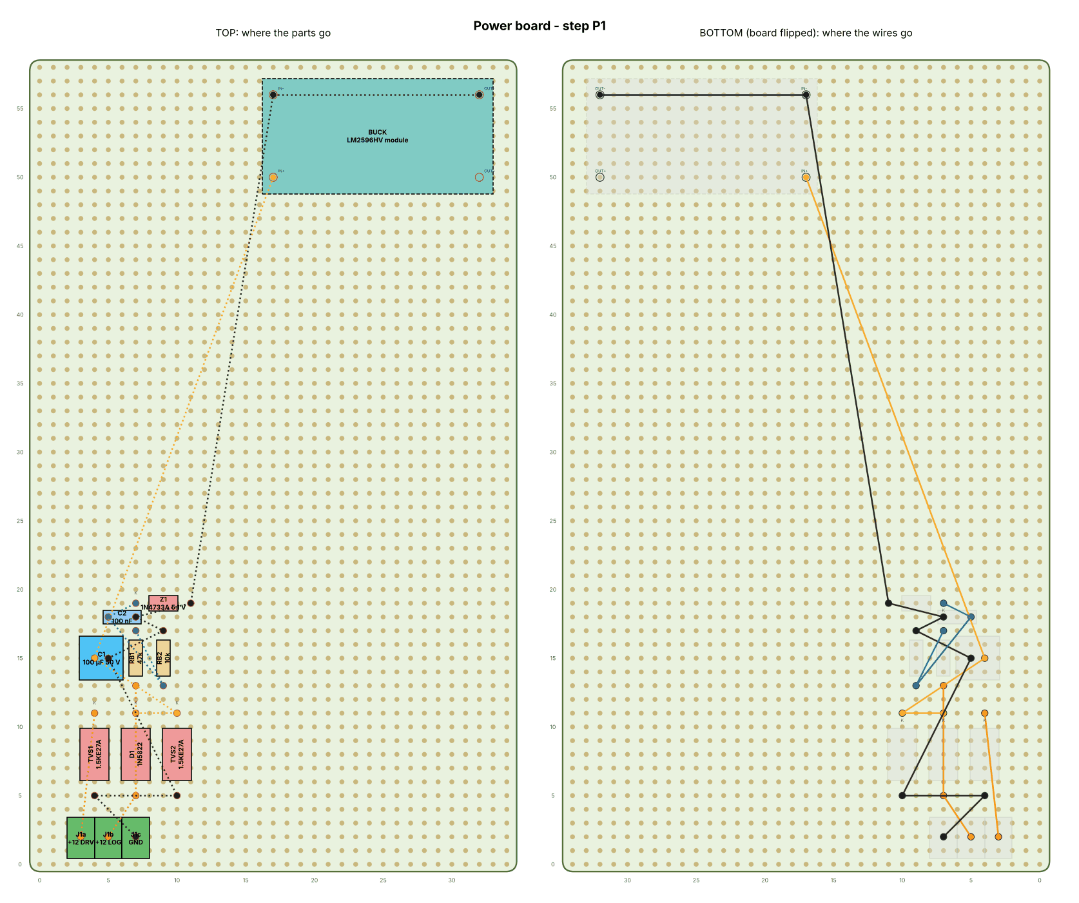
docs/build/power-P1.png
