gamer927/rav4/docs/build/power-P2.png

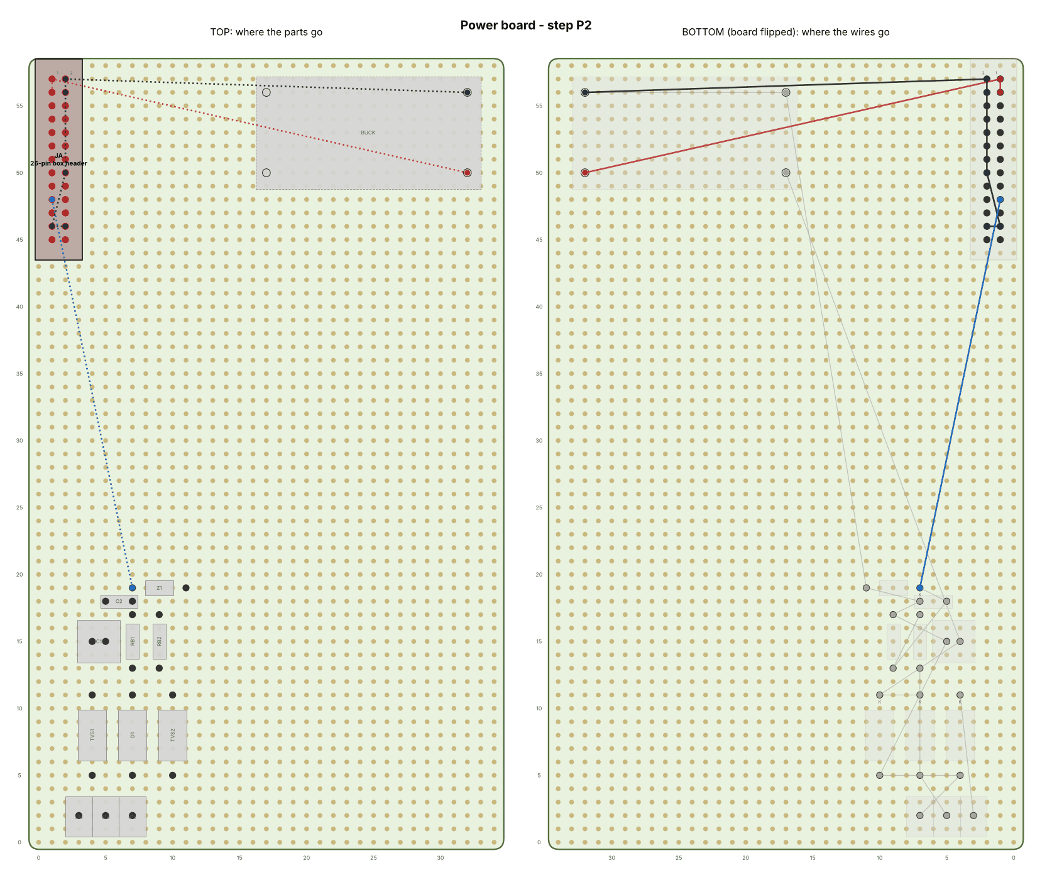
docs/build/power-P2.png
