gamer927/rav4/docs/build/power-P3.png

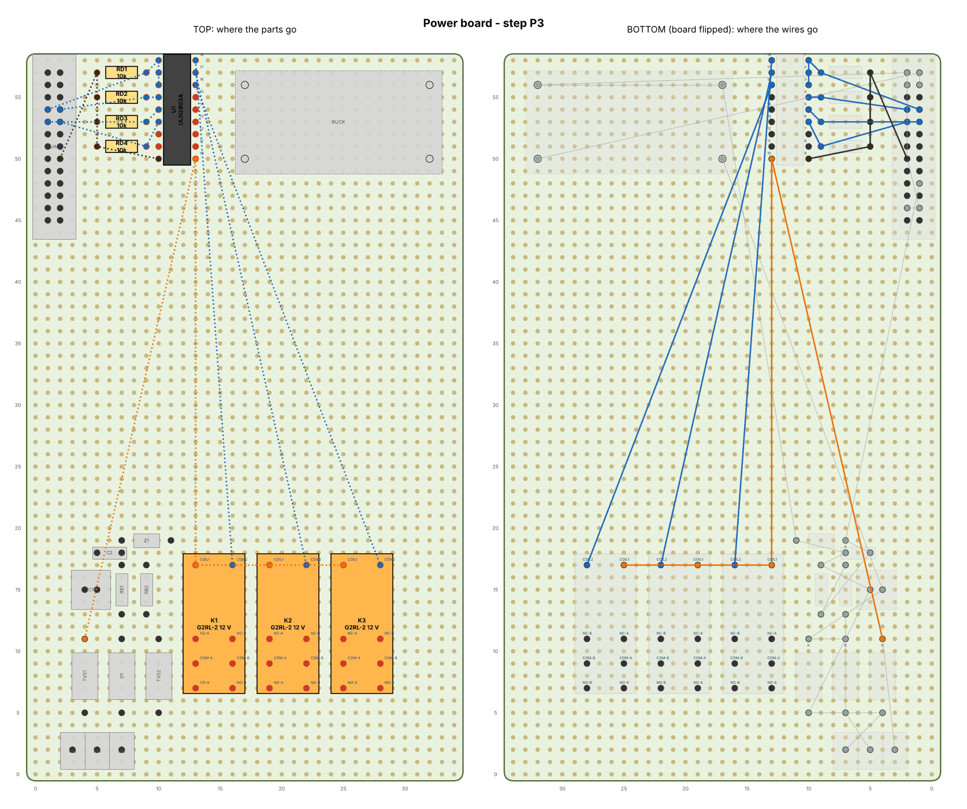
docs/build/power-P3.png
