gamer927/rav4/docs/build/power-P4.png

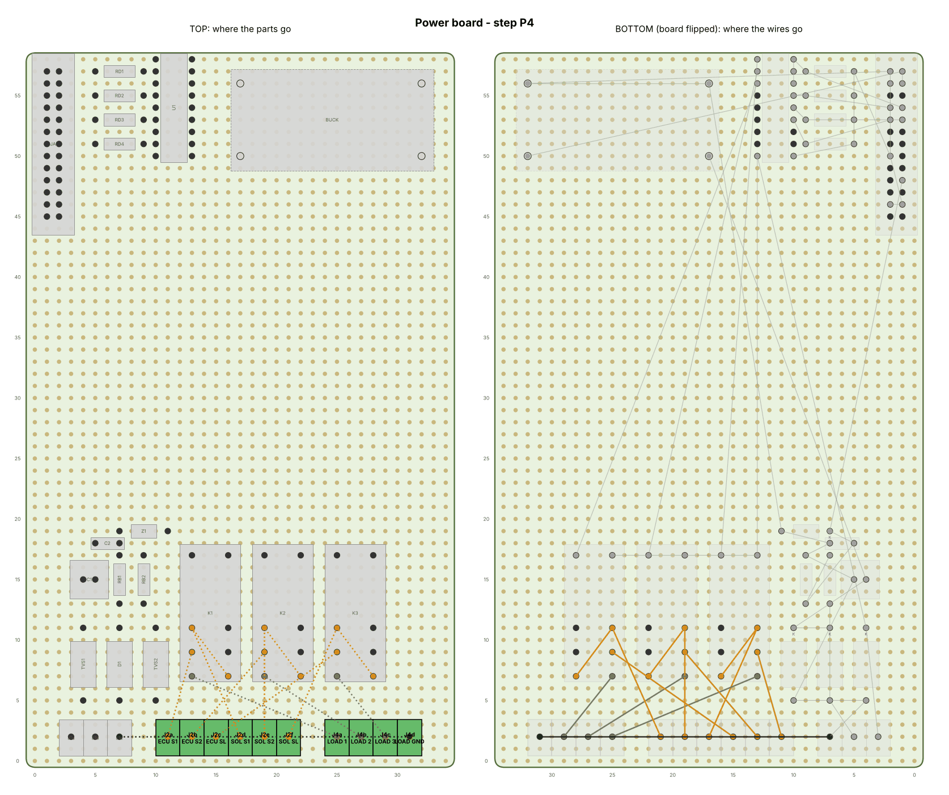
docs/build/power-P4.png
