gamer927/rav4/docs/build/power-P6.png

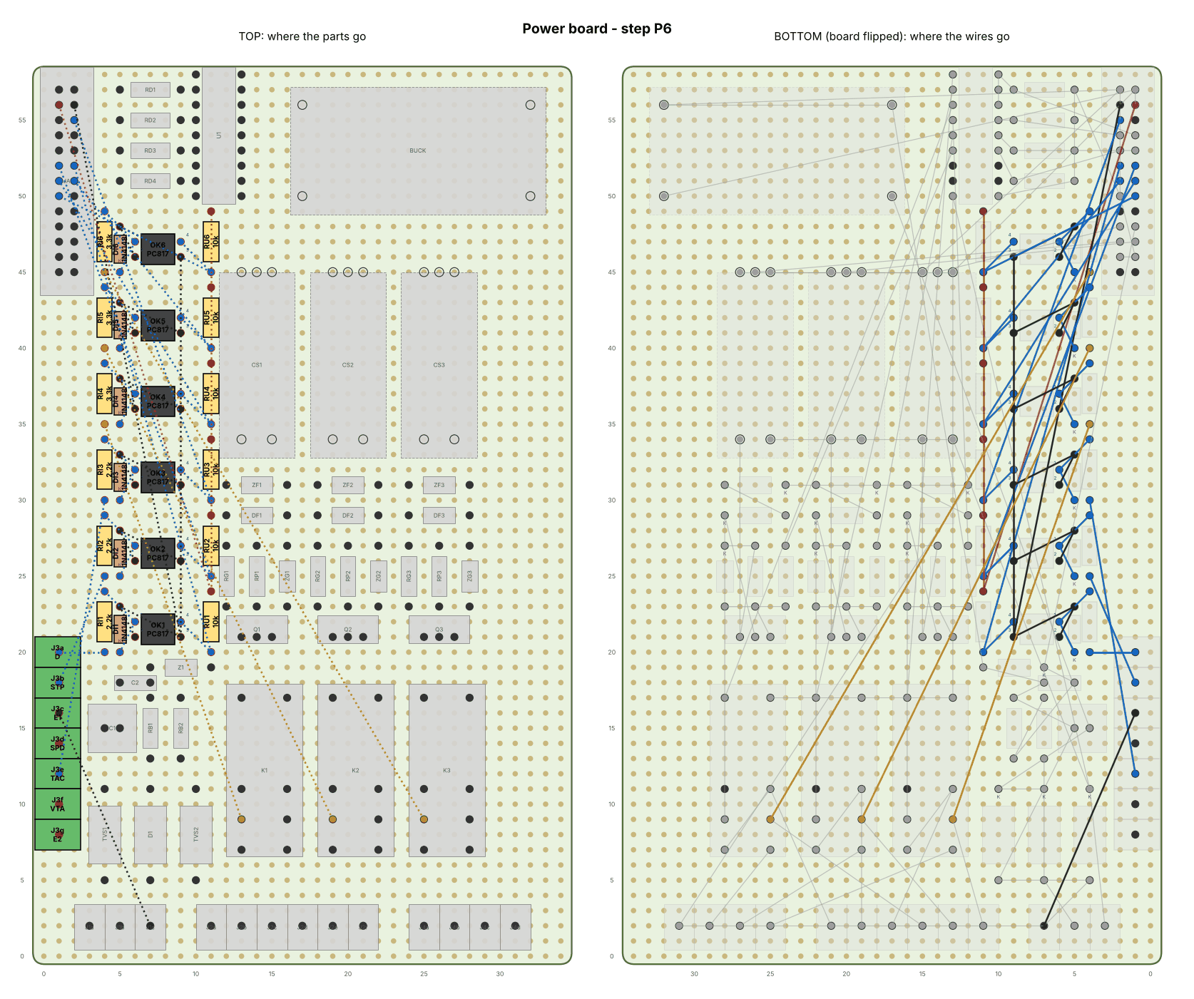
docs/build/power-P6.png
