gamer927/rav4/docs/build/power-P7.png

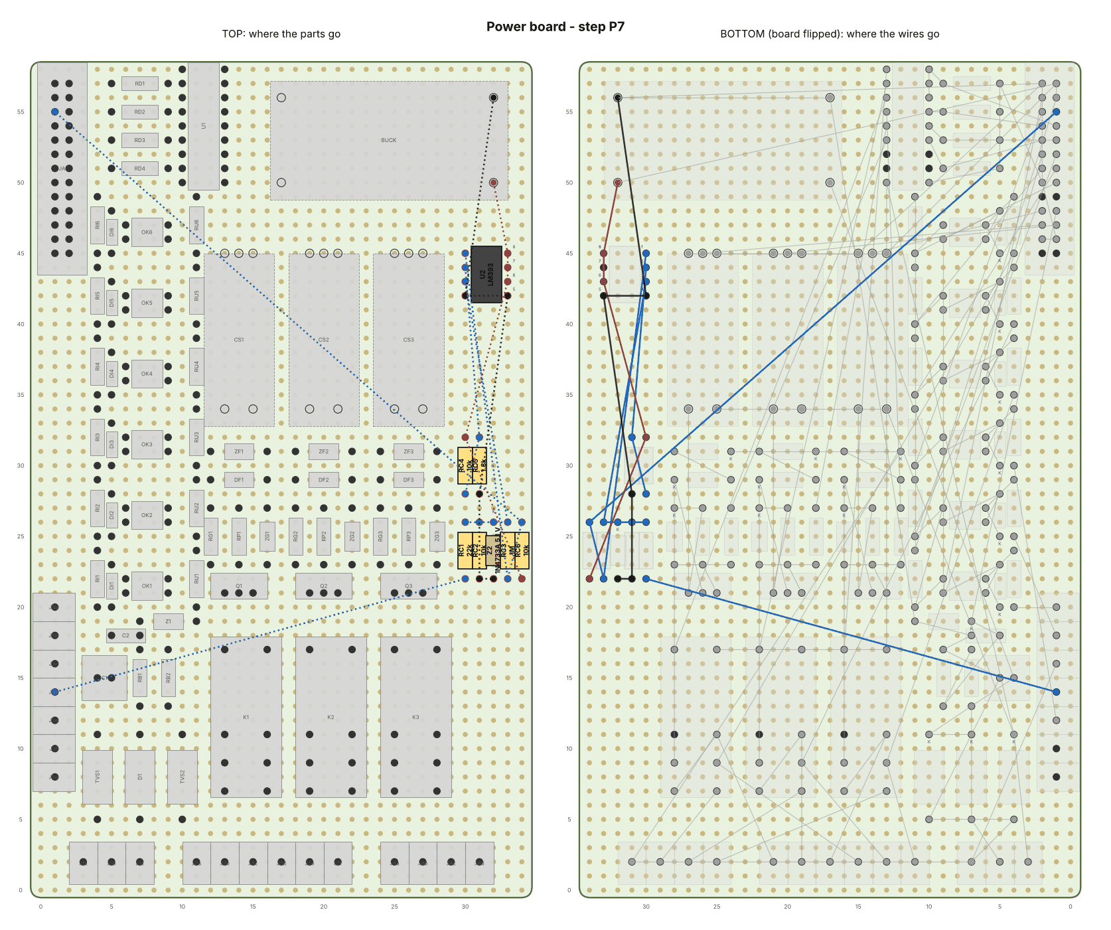
docs/build/power-P7.png
