gamer927/rav4/docs/build/power-P8.png

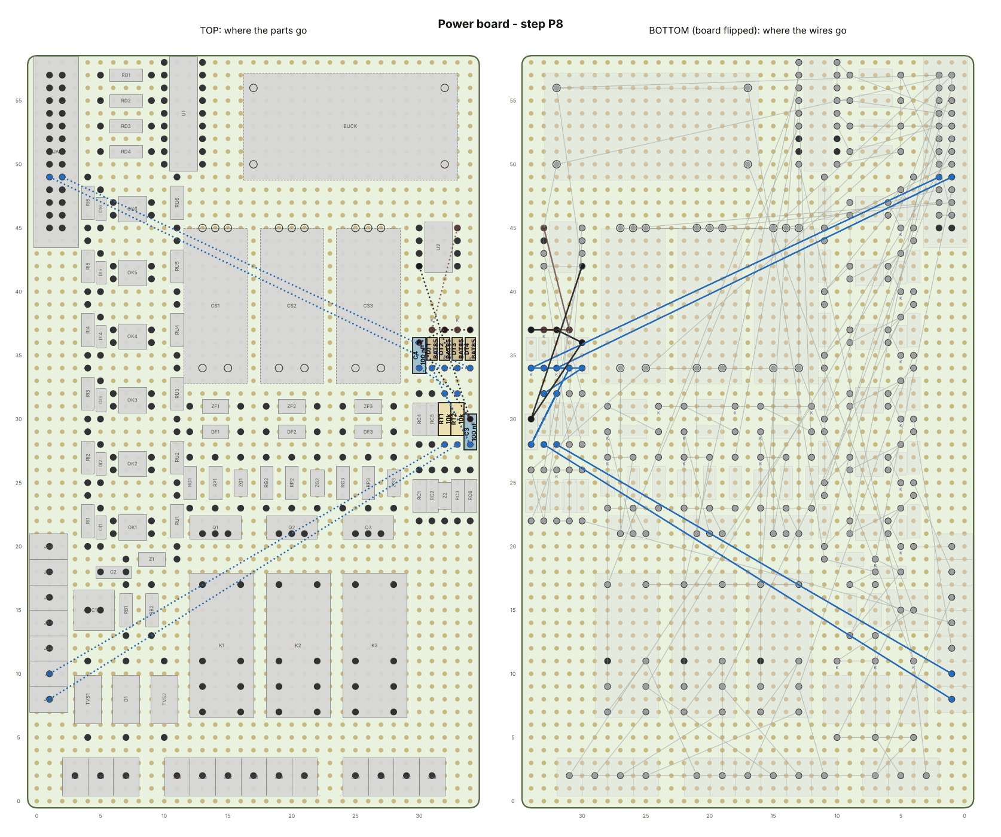
docs/build/power-P8.png
