gamer927/rav4/docs/wiring-detail-a.png

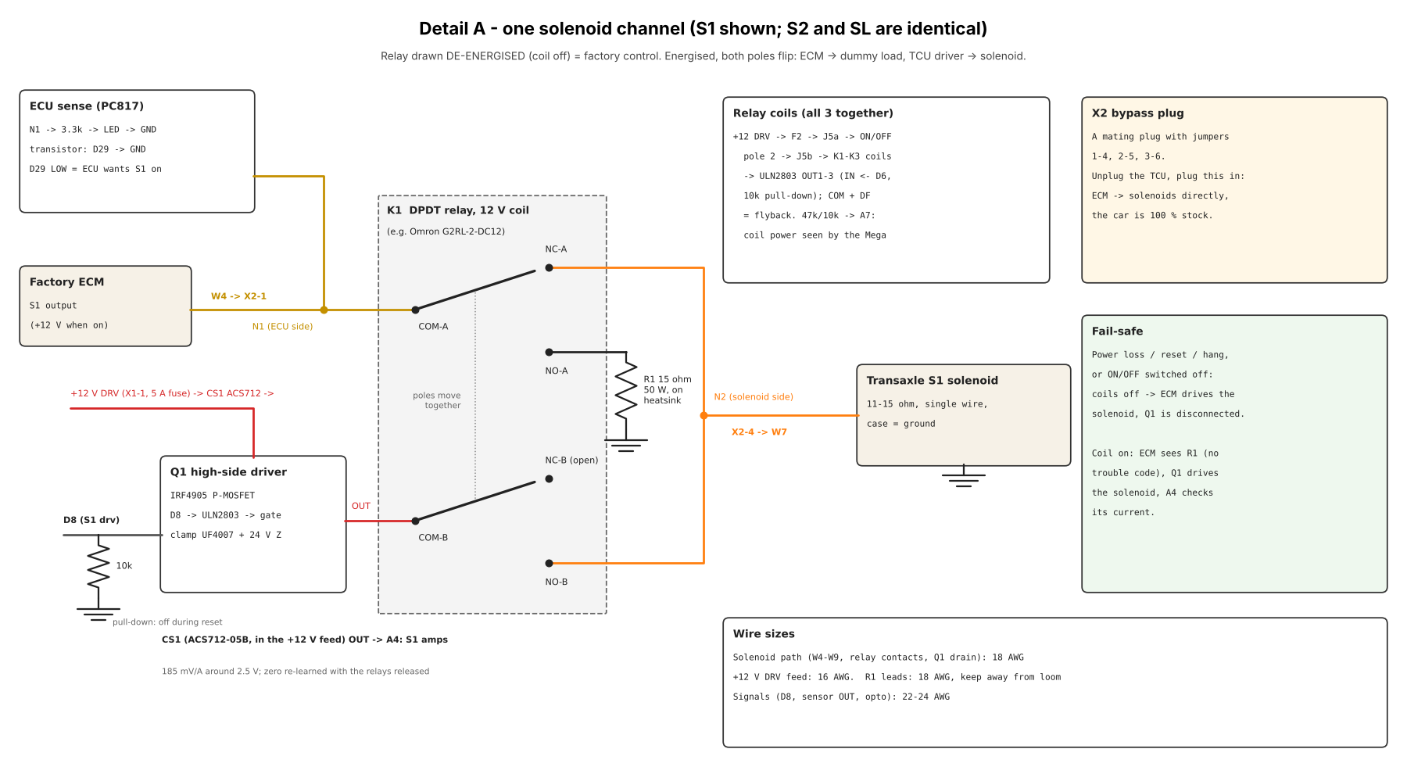
docs/wiring-detail-a.png
