gamer927/rav4/hardware/pcb/rav4-tcu.kicad_pcb

## KiCad design hardware/pcb/rav4-tcu.kicad_pcb (2026-10-28)

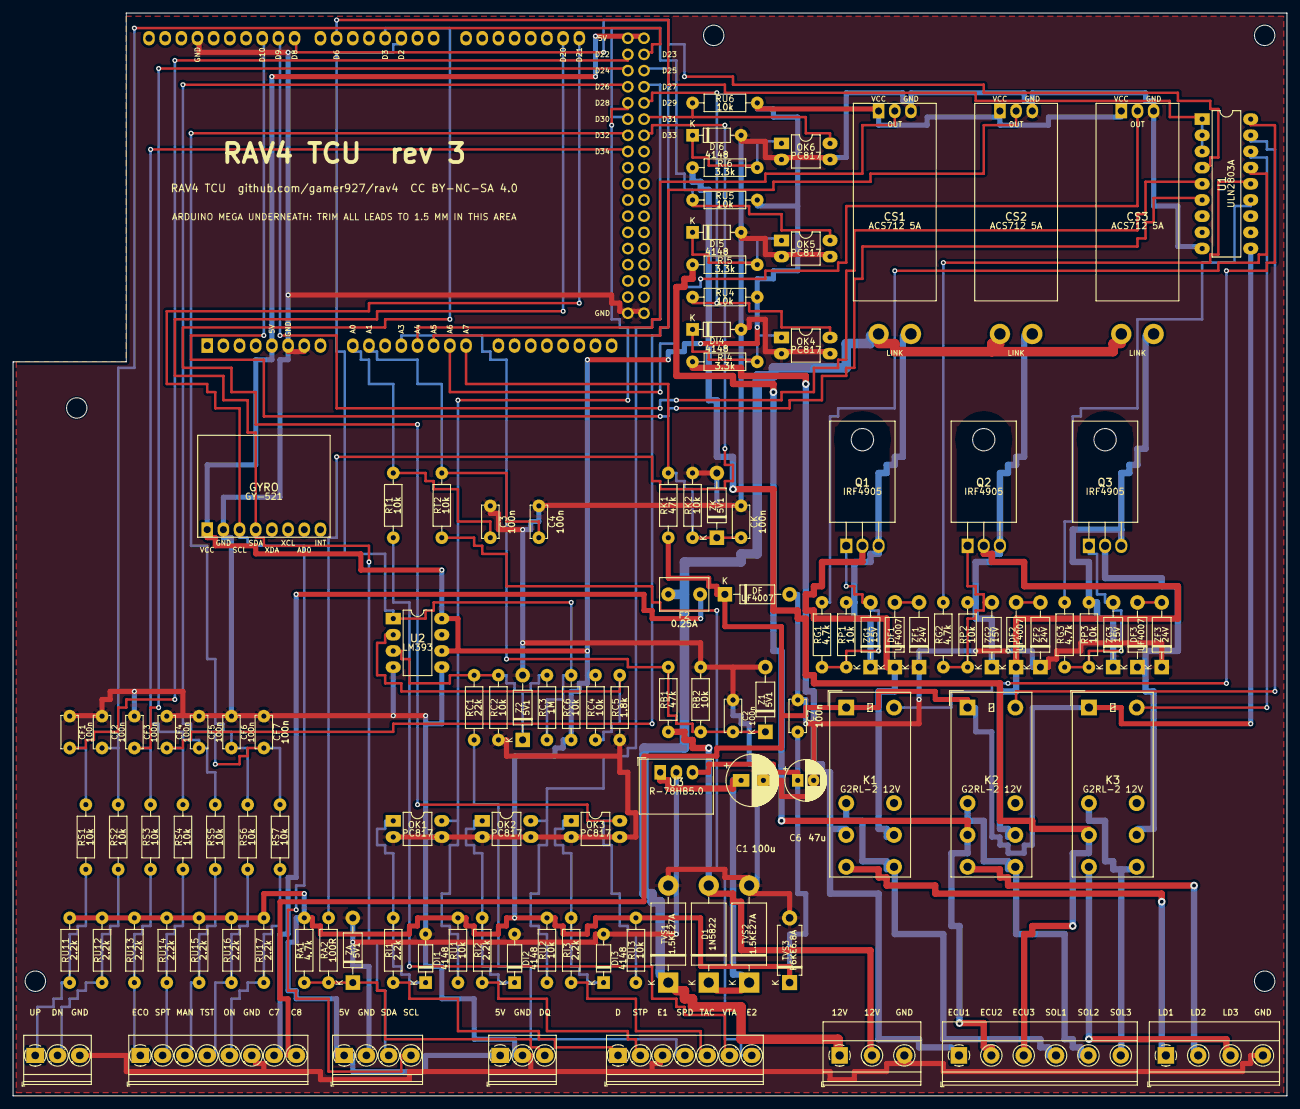
[picture p177: board rav4-tcu.kicad_pcb from above]

Board: 2 copper layers, 200.0 x 170.0 mm, 118 parts (0 on the bottom side), 84 nets.

Parts:
A1: Arduino Mega; Arduino_Mega2560_Shield
C1: 100u; CP_Radial_D8.0mm_P3.50mm
C2, C3, C4, C7: 100n; C_Disc_D5.0mm_W2.5mm_P5.00mm
C6: 47u; CP_Radial_D6.3mm_P2.50mm
CF1, CF2, CF3, CF4, CF5, CF6, CF7: 100n; C_Disc_D5.0mm_W2.5mm_P5.00mm
CK: 100n; C_Disc_D5.0mm_W2.5mm_P5.00mm
CS1, CS2, CS3: ACS712 5A; ACS712_Module
D1: 1N5822; D_DO-201AD_P15.24mm_Horizontal
DF, DF1, DF2, DF3: UF4007; D_DO-41_SOD81_P10.16mm_Horizontal
DI1, DI2, DI3, DI4, DI5, DI6: 4148; D_DO-35_SOD27_P7.62mm_Horizontal
F2: 0.25A; C_Disc_D7.5mm_W5.0mm_P5.00mm
GYRO: GY-521; GY-521_Module
H1, H2, H3, H4, H5: MountingHole_3.2mm_M3
J1: PWR; TerminalBlock_Phoenix_MKDS-1,5-3-5.08_1x03_P5.08mm_Horizont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
J2: SOL; TerminalBlock_Phoenix_MKDS-1,5-6-5.08_1x06_P5.08mm_Horizont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
J3: SIG; TerminalBlock_Phoenix_PT-1,5-7-3.5-H_1x07_P3.50mm_Horizontal
J4: LOAD; TerminalBlock_Phoenix_MKDS-1,5-4-5.08_1x04_P5.08mm_Horizont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
K1, K2, K3: G2RL-2 12V; Relay_DPDT_Omron_G2RL-2
OK1, OK2, OK3, OK4, OK5, OK6: PC817; DIP-4_W7.62mm_LongPads
Q1, Q2, Q3: IRF4905; TO-220-3_Horizontal_TabDown
RA1: 4.7k; R_Axial_DIN0207_L6.3mm_D2.5mm_P10.16mm_Horizontal
RA2: 100R; R_Axial_DIN0207_L6.3mm_D2.5mm_P10.16mm_Horizontal
RB1: 47k; R_Axial_DIN0207_L6.3mm_D2.5mm_P10.16mm_Horizontal
RB2: 10k; R_Axial_DIN0207_L6.3mm_D2.5mm_P10.16mm_Horizontal
RC1: 22k; R_Axial_DIN0207_L6.3mm_D2.5mm_P10.16mm_Horizontal
RC2, RC4, RC6: 10k; R_Axial_DIN0207_L6.3mm_D2.5mm_P10.16mm_Horizontal
RC3: 1M; R_Axial_DIN0207_L6.3mm_D2.5mm_P10.16mm_Horizontal
RC5: 1.8k; R_Axial_DIN0207_L6.3mm_D2.5mm_P10.16mm_Horizontal
RG1, RG2, RG3: 4.7k; R_Axial_DIN0207_L6.3mm_D2.5mm_P10.16mm_Horizontal
RI1, RI2, RI3: 2.2k; R_Axial_DIN0207_L6.3mm_D2.5mm_P10.16mm_Horizontal
RI4, RI5, RI6: 3.3k; R_Axial_DIN0207_L6.3mm_D2.5mm_P10.16mm_Horizontal
RK1: 47k; R_Axial_DIN0207_L6.3mm_D2.5mm_P10.16mm_Horizontal
RK2: 10k; R_Axial_DIN0207_L6.3mm_D2.5mm_P10.16mm_Horizontal
RP1, RP2, RP3: 10k; R_Axial_DIN0207_L6.3mm_D2.5mm_P10.16mm_Horizontal
RS1, RS2, RS3, RS4, RS5, RS6, RS7: 10k; R_Axial_DIN0207_L6.3mm_D2.5mm_P10.16mm_Horizontal
RT1, RT2: 10k; R_Axial_DIN0207_L6.3mm_D2.5mm_P10.16mm_Horizontal
RU1, RU2, RU3, RU4, RU5, RU6: 10k; R_Axial_DIN0207_L6.3mm_D2.5mm_P10.16mm_Horizontal
RU11, RU12, RU13, RU14, RU15, RU16, RU17: 2.2k; R_Axial_DIN0207_L6.3mm_D2.5mm_P10.16mm_Horizontal
TVS1, TVS2: 1.5KE27A; D_DO-201AD_P15.24mm_Horizontal
TVS3: P6KE6.8A; D_DO-15_P10.16mm_Horizontal
U1: ULN2803A; DIP-18_W7.62mm_LongPads
U2: LM393; DIP-8_W7.62mm_LongPads
U3: R-78HB5.0; Converter_DCDC_RECOM_R-78HB-0.5_THT
X4: DASH; TerminalBlock_Phoenix_PT-1,5-8-3.5-H_1x08_P3.50mm_Horizontal
X5: SCREEN; TerminalBlock_Phoenix_PT-1,5-4-3.5-H_1x04_P3.50mm_Horizontal
X6: ATF; TerminalBlock_Phoenix_PT-1,5-3-3.5-H_1x03_P3.50mm_Horizontal
X7: SHIFT; TerminalBlock_Phoenix_PT-1,5-3-3.5-H_1x03_P3.50mm_Horizontal
Z1, Z2: 5V1; D_DO-41_SOD81_P10.16mm_Horizontal
ZA: 5V1; D_DO-41_SOD81_P10.16mm_Horizontal
ZF1, ZF2, ZF3: 24V; D_DO-41_SOD81_P10.16mm_Horizontal
ZG1, ZG2, ZG3: 15V; D_DO-41_SOD81_P10.16mm_Horizontal
ZK: 5V1; D_DO-41_SOD81_P10.16mm_Horizontal

Connections:
+5V: A1.5V, C6.1, C7.1, CS1.VCC, CS2.VCC, CS3.VCC, GYRO.VCC, RA1.2, RC4.2, RC6.1, RU1.2, RU2.2, RU3.2, RU4.2, RU5.2, RU6.2, RU11.2, RU12.2, RU13.2, RU14.2, RU15.2, RU16.2, RU17.2, TVS3.1, U2.6, U2.8, U3.3, X5.1, X6.1
+12_COIL: DF.1, K1.A1, K2.A1, K3.A1, RK1.1, U1.10, X4.8
+12_DRV: CS1.IP+, CS2.IP+, CS3.IP+, F2.1, J1.1, TVS1.1
+12_LOG: D1.2, J1.2, RB1.1
A0: A1.A0, C3.1, RT1.2
A1: A1.A1, C4.1, RT2.2
A3: A1.A3, C2.1, RB1.2, RB2.1, Z1.1
A4: A1.A4, CS1.OUT
A5: A1.A5, CS2.OUT
A6: A1.A6, CS3.OUT
A7: A1.A7, CK.1, RK1.2, RK2.1, ZK.1
CLAMP1: DF1.2, ZF1.2
CLAMP2: DF2.2, ZF2.2
CLAMP3: DF3.2, ZF3.2
COIL_K1: K1.A2, U1.18
COIL_K2: K2.A2, U1.17
COIL_K3: K3.A2, U1.16
D2: A1.D2, RC3.1, RC6.2, U2.1
D3: A1.D3, OK3.4, RU3.1
D6: A1.D6, U1.1, U1.2, U1.3
D8: A1.D8, U1.4
D9: A1.D9, U1.5
D10: A1.D10, U1.6
D20: A1.D20, GYRO.SDA, X5.3
D21: A1.D21, GYRO.SCL, X5.4
D22: A1.D22, CF1.1, RS1.2
D23: A1.D23, CF2.1, RS2.2
D24: A1.D24, CF3.1, RS3.2
D25: A1.D25, CF4.1, RS4.2
D26: A1.D26, CF7.1, RS7.2
D27: A1.D27, OK2.4, RU2.1
D28: A1.D28, OK1.4, RU1.1
D29: A1.D29, OK4.4, RU4.1
D30: A1.D30, OK5.4, RU5.1
D31: A1.D31, OK6.4, RU6.1
D32: A1.D32, CF6.1, RS6.2
D33: A1.D33, RA2.2
D34: A1.D34, CF5.1, RS5.2
DOUT1: DF1.1, K1.21, Q1.2
DOUT2: DF2.1, K2.21, Q2.2
DOUT3: DF3.1, K3.21, Q3.2
DQ: RA1.1, RA2.1, X6.3, ZA.1
D_in: J3.1, RI1.1
E2_in: J3.7, RT2.1
ECU_1: J2.1, K1.11, RI4.1
ECU_2: J2.2, K2.11, RI5.1
ECU_3: J2.3, K3.11, RI6.1
GATE1: Q1.1, RG1.1, RP1.1, ZG1.2
GATE2: Q2.1, RG2.1, RP2.1, ZG2.2
GATE3: Q3.1, RG3.1, RP3.1, ZG3.2
GDRV1: RG1.2, U1.15
GDRV2: RG2.2, U1.14
GDRV3: RG3.2, U1.13
GND: A1.GND, C1.2, C2.2, C3.2, C4.2, C6.2, C7.2, CF1.2, CF2.2, CF3.2, CF4.2, CF5.2, CF6.2, CF7.2, CK.2, CS1.GND, CS2.GND, CS3.GND, DF.2, DI1.2, DI2.2, DI3.2, DI4.2, DI5.2, DI6.2, GYRO.GND, J1.3, J3.3, J4.4, OK1.2, OK1.3, OK2.2, OK2.3, OK3.2, OK3.3, OK4.2, OK4.3, OK5.2, OK5.3, OK6.2, OK6.3, RB2.2, RC2.1, RC5.1, RK2.2, TVS1.2, TVS2.2, TVS3.2, U1.9, U2.4, U2.5, U3.2, X4.6, X5.2, X6.2, X7.3, Z1.2, Z2.2, ZA.2, ZF1.1, ZF2.1, ZF3.1, ZK.2
IN1_shifter_UP: RS1.1, RU11.1, X7.1
IN2_shifter_DOWN: RS2.1, RU12.1, X7.2
IN3_C1_ECO: RS3.1, RU13.1, X4.1
IN4_C2_SPORT: RS4.1, RU14.1, X4.2
IN5_C3_MANUAL: RS5.1, RU15.1, X4.3
IN6_C4_TEST: RS6.1, RU16.1, X4.4
IN7_C5_ON_OFF: RS7.1, RU17.1, X4.5
LED_OK1: DI1.1, OK1.1, RI1.2
LED_OK2: DI2.1, OK2.1, RI2.2
LED_OK3: DI3.1, OK3.1, RI3.2
LED_OK4: DI4.1, OK4.1, RI4.2
LED_OK5: DI5.1, OK5.1, RI5.2
LED_OK6: DI6.1, OK6.1, RI6.2
LOAD_1: J4.1, K1.14
LOAD_2: J4.2, K2.14
LOAD_3: J4.3, K3.14
LOG: C1.1, D1.1, TVS2.1, U3.1
REF: RC4.1, RC5.2, U2.2
SOL_1: J2.4, K1.12, K1.24
SOL_2: J2.5, K2.12, K2.24
SOL_3: J2.6, K3.12, K3.24
SPDIN: RC1.2, RC2.2, RC3.2, U2.3, Z2.1
SPD_in: J3.4, RC1.1
SRC1: CS1.IP-, Q1.3, RP1.2, ZG1.1
SRC2: CS2.IP-, Q2.3, RP2.2, ZG2.1
SRC3: CS3.IP-, Q3.3, RP3.2, ZG3.1
STP_in: J3.2, RI2.1
SWITCH_FEED: F2.2, X4.7
TAC_in: J3.5, RI3.1
VTA_in: J3.6, RT1.1
