gamer927/rav4/firmware/tcu/imu.h

// SPDX-License-Identifier: CC-BY-NC-SA-4.0
// Copyright (c) 2026 gamer927. RAV4 TCU, https://github.com/gamer927/rav4
// MPU-6050 gyro (GY-521 module) on the shared I2C bus, used only for yaw
// rate. Lateral g is then yaw rate x road speed, which doesn't care how the
// module is tilted, only that the axis it reads (cfg::GYRO_AXIS) is roughly
// vertical in the car.
#pragma once
#include <stdint.h>

class Imu {
 public:
  bool begin(uint8_t addr = 0x68);
  bool present() const { return present_; }
  bool readYawDps(float& dps);  // false on a bus error

 private:
  bool writeReg(uint8_t reg, uint8_t value);
  uint8_t addr_ = 0x68;
  bool present_ = false;
};
