gamer927/rav4/tools/mutate.py

#!/usr/bin/env python3
# SPDX-License-Identifier: CC-BY-NC-SA-4.0
# Copyright (c) 2026 gamer927. RAV4 TCU, https://github.com/gamer927/rav4
"""Mutation testing: do the tests catch bugs, or just pass?

Plants one small bug at a time in the firmware (a < becomes <=, an && becomes
||, true becomes false, a statement goes missing...), rebuilds, and runs the
unit tests and the system test against it. A bug the tests catch is "killed";
one they don't is a "survivor". Every survivor is either a gap in the tests
or a change that makes no difference (an "equivalent" mutant: listed in
EQUIVALENT below, each with the reason).

  python3 tools/mutate.py               # everything (about 10 minutes on 4 cores)
  python3 tools/mutate.py --file tcu_logic.cpp --jobs 4
  python3 tools/mutate.py --list        # just print the mutants

Writes build/mutants/report.md.
"""
import argparse
import concurrent.futures as cf
import json
import os
import re
import shutil
import subprocess
import sys

ROOT = os.path.dirname(os.path.dirname(os.path.abspath(__file__)))
FW = os.path.join(ROOT, "firmware", "tcu")
OUT = os.path.join(ROOT, "build", "mutants")
FILES = ["tcu_logic.cpp", "self_test.cpp", "tcu.ino"]
CXX = os.environ.get("CXX", "g++")
SAN = "-g -fsanitize=address,undefined -fno-sanitize-recover=all"  # as the Makefile: out-of-bounds reads fail
CHIP = False  # --chip: tcu.ino mutants also face the chip test (slow: about 1 min each)

# (pattern, replacement, name): applied to one occurrence at a time, outside
# comments and string literals.
OPERATORS = [
    (r"(?<![<>=!])<=", "<", "<= to <"),
    (r"(?<![<>=!])>=", ">", ">= to >"),
    (r"(?<![<>=\-])<(?![<=])", "<=", "< to <="),
    (r"(?<![<>=\-])>(?![>=])", ">=", "> to >="),
    (r"==", "!=", "== to !="),
    (r"!=", "==", "!= to =="),
    (r"&&", "||", "&& to ||"),
    (r"\|\|", "&&", "|| to &&"),
    (r"\btrue\b", "false", "true to false"),
    (r"\bfalse\b", "true", "false to true"),
    (r"(?<=[\w)\]]) \+ (?=[\w(])", " - ", "+ to -"),
    (r"(?<=[\w)\]]) - (?=[\w(])", " + ", "- to +"),
    (r"(?<![\w)\]!=<>])!(?!=)", "", "drop !"),
]

# Surviving mutants that make no difference anything could see, each with
# the reason: (file, operator, text in the line, text in the line before it
# or None, why). Reviewed by hand; a survivor not listed here is a gap.
ST, TL, INO = "self_test.cpp", "tcu_logic.cpp", "tcu.ino"
LATER = "the step ends one 10 ms control period later: no result depends on it"
EQUIVALENT = [
    # self_test.cpp
    (ST, "delete statement", "out_ = TestOutputs();", "if (in.solSenseValid && !in.leverInD",
     "runPowerOn() runs once at key-on, before anything has been driven: the outputs are already off"),
    (ST, "delete statement", "out_ = TestOutputs();", "runPassive(in);",
     "start() is refused while a test runs, and every way a test ends clears the outputs"),
    (ST, "delete statement", "out_ = TestOutputs();", "void SelfTest::finish() {",
     "finish() is only reached from endCutTest(), which has just cleared the outputs"),
    (ST, "delete statement", "out_ = TestOutputs();", "restoreAfterWatchdog() records the pass",
     "endCutTest() cleared the outputs before this step; the next line sets the one it needs"),
    (ST, "delete statement", "out_ = TestOutputs();", "set(T_WATCHDOG, watchdogWorked",
     "restoreAfterWatchdog() runs on the fresh SelfTest of a just-reset board: nothing is on"),
    (ST, "delete statement", "aborted_ = false;", "out_ = TestOutputs();",
     "restoreAfterWatchdog() runs on the fresh SelfTest of a just-reset board: not aborted"),
    (ST, "delete statement", "inhibit_ = INH_NONE;", "aborted_ = false;",
     "restoreAfterWatchdog() runs on the fresh SelfTest of a just-reset board: no inhibit"),
    (ST, "false to true", "bool ok = false;", None, "every prompt's case sets ok"),
    (ST, "delete statement", "current_ = T_ONOFF_CUT;", None,
     "already T_ONOFF_CUT since the last prompt set it (it names the step on the screen)"),
    (ST, ">= to >", "inPhase >= cfg::IBIT_", None, LATER),
    (ST, "> to >=", "maxA = in.solAmps[i] > maxA ?", None, "the larger of two equal values is the same value"),
    (ST, ">= to >", "return in >= cfg::IBIT_PROMPT_TIMEOUT_MS ? 0", None,
     "at exactly the timeout both give 0 seconds left"),
    # tcu_logic.cpp
    (TL, "> to >=", "const float onMph = baseOn > floorOn", None, "the larger of two equal values is the same value"),
    (TL, "> to >=", "const float offMph = baseOff > floorOff", None, "the larger of two equal values is the same value"),
    (TL, "&& to ||", "cfg::RPM_PER_MPH[gear_ >= 1 && gear_ <= 4", None,
     "lockup is only worked out in CUSTOM, where the gear is always 1-4"),
    (TL, "<= to <", "cfg::RPM_PER_MPH[gear_ >= 1 && gear_ <= 4", None, "gear 4 picks RPM_PER_MPH[4] either way"),
    (TL, ">= to >", "cfg::RPM_PER_MPH[gear_ >= 1 && gear_ <= 4", None,
     "lockup is never allowed in 1st (LU_MIN_GEAR), so the 1st-gear ratio isn't used"),
    (TL, "|| to &&", "} else if (!armed_ || !in.customRequested || !in.leverInD) {", None,
     "armed_ is only ever true while ON/OFF is on, so !armed_ already covers !customRequested"),
    (TL, "drop !", "if (!engineWasOff_) crankDip_ = false;", None,
     "the engine-off check stays true while the engine is off, so the reset happens one step later either way"),
    (TL, "delete statement", "pendingGear_ = 0;", "gear_ = g;",
     "exitToStock() already cleared it, and only STOCK leads to a take-over"),
    (TL, "delete statement", "pendingGear_ = 0;", "gear_ = 0;",
     "tryEnterCustom() clears it again before anything reads it"),
    (TL, "delete statement", "gear_ = 0;", "out_.control = CTRL_STOCK;",
     "in STOCK the reported gear comes from the ECU sense, and a take-over sets gear_ first"),
    (TL, "delete statement", "slCmd_ = false;", "pendingGear_ = 0;",
     "in STOCK the lockup output comes from the ECU, and a take-over sets slCmd_ first"),
    (TL, "false to true", "slCmd_ = false;", "pendingGear_ = 0;",
     "in STOCK the lockup output comes from the ECU, and a take-over sets slCmd_ first"),
    (TL, "true to false", "raise(EV_CUSTOM, true);", None,
     "a take-over always follows a different event (a hand-back or a wait), so it's raised either way"),
    (TL, "true to false", "raise(why, true);", None,
     "a hand-back always follows the take-over's EV_CUSTOM, so it's raised either way"),
    (TL, "true to false", "raise(want == CTRL_MANUAL ? EV_MANUAL : EV_AUTO_RESUMED, true);", None,
     "MANUAL and AUTO alternate, so the event always differs from the last one"),
    (TL, "true to false", "raise(EV_SHIFT, true);", None, "EV_SHIFT puts nothing on the screen"),
    (TL, "delete statement", "setLockup(false);", "Release the converter clutch first",
     "updateLockup() releases lockup in the same step while a shift is pending"),
    (TL, "false to true", "setLockup(false);", "Release the converter clutch first",
     "updateLockup() releases lockup in the same step while a shift is pending"),
    (TL, "delete statement", "if (slCmd_ == on) return;", None,
     "updateLockup() only ever asks for a change (off when on, on when off)"),
    (TL, "delete statement", "lastLockupChangeMs_ = now_;", "brakeHold_ = liftHold_ = highTpsSeen_ = false;",
     "after a take-over lockup waits the longer settle-after-shift time, counted from the take-over"),
    (TL, "delete statement", "overRev_ = Persist();", None,
     "the rev-limit timer restarts the moment the engine is under the limit; a stale one only matters "
     "if a take-over happens over 6,200 rpm"),
    (TL, "delete statement", "overRev_.active = false;", None,
     "the rev-limit timer restarts the moment the engine is under the limit"),
    (TL, "false to true", "overRev_.active = false;", None,
     "the rev-limit timer restarts the moment the engine is under the limit"),
    (TL, "|| to &&", "if (gear_ >= 4 || pendingGear_ || (out_.control", None,
     "an upshift from 4th, or during a shift, is refused by requestShift() anyway"),
    (TL, "delete statement", "straight_.active = false;", None,
     "the straight-again timer restarts as soon as the side force is over the exit level, "
     "within a step of a corner starting"),
    (TL, "false to true", "straight_.active = false;", None,
     "the straight-again timer restarts as soon as the side force is over the exit level, "
     "within a step of a corner starting"),
    (TL, "true to false", "return true;", "brakeHold_ = true;",
     "after a brake downshift, any further request in the same step is refused (shift in progress)"),
    (TL, "delete statement", "if (pendingGear_) return;", "void Controller::autoSchedule",
     "requestShift() refuses every shift while one is pending"),
    (TL, "drop !", "if (prevBrake_ && !in.brake) brakeReleasedMs_ = now_;", None,
     "it then marks the last step with the brake on instead of the first one off: 10 ms apart"),
    (TL, "|| to &&", "if (pendingGear_ || gear_ <= 1) return;", None,
     "requestShift() refuses a shift while one is pending and below 1st"),
    (TL, "false to true", "if (!requestShift(gear_ - 1, in.speedMph, false)) return false;", "=>return true;",
     "a brake downshift is only refused while a shift is in progress, when the map's own request "
     "would be refused too"),
    (TL, "+ to -", "tpsShift_ = tau == 0", "=>(float)(tau - dt)",
     "the throttle smoothing's time constant becomes 0.79 s instead of 0.81 s"),
    (TL, "|| to &&", "if (!cfg::BRAKE_DOWNSHIFT[m]", "=>cornering_ && gear_ <= 1",
     "from 1st a brake downshift would ask for gear 0, which requestShift() refuses"),
    (TL, "drop !", "if (!brakeHold_ && !liftHold_", "=>(kickdown || elapsed",
     "without a kickdown the dwell has passed by here (the return above); after a kickdown the speed "
     "is below the next upshift point anyway"),
    (TL, "false to true", "requestShift(gear_ + 1, in.speedMph, false);", None,
     "only matters if a map upshift is refused, and map upshift points are above the too-slow "
     "limits (test_maps_are_sane)"),
    (TL, "delete statement", "if (pendingGear_ || gear_ <= 1) return;", None,
     "requestShift() refuses a shift while one is pending and below 1st"),
    (TL, "<= to <", "if (pendingGear_ || gear_ <= 1) return;", None, "requestShift() refuses a shift below 1st"),
    (TL, "delete statement", "now_ = nowMs;", None, "step() sets now_ before anything reads it"),
    (TL, "delete statement", "upSince_ = downSince_ = nowMs;", None, "set on each press before it's read"),
    (TL, "delete statement", "offSinceMs_ = nowMs;", None,
     "prevCustomReq_ starts true, so the first OFF step sets it before it's read"),
    (TL, "delete statement", "dropRefMs_ = nowMs;", None,
     "only gives the first 100 ms speed-drop window a longer span; the check needs 15 mph to start"),
    (TL, "delete statement", "decelRefMs_ = nowMs;", None,
     "only stretches the first deceleration window, while parked at key-on"),
    (TL, "delete statement", "lastStepMs_ = tpsRefMs_ = nowMs;", None,
     "only the first step's throttle filter and tip-in windows, while parked at key-on"),
]
LED = "the Mega's own LED (D13) is hidden under the circuit board: nobody can see it"
EQUIVALENT += [
    (INO, "delete statement", "MCUSR = 0;", None, "the Mega's bootloader has already cleared it"),
    (INO, "delete statement", "wdt_disable();", "MCUSR = 0;", "the Mega's bootloader has already disabled the watchdog"),
    (INO, "false to true", "bool unexpectedWdtReset = false;", None, "setup() sets it before anything reads it"),
    (INO, "false to true", "bool have = false;", None,
     "a power-on 85 C is only accepted within 5 C of the last reading, and the starting 0 C never is"),
    (INO, "false to true", "bool converting = false;", None,
     "the first read finds the power-on value and rejects it; the first good reading still comes "
     "before the key-on checks (the chip test checks TEMP PROBE OK there)"),
    (INO, "delete statement", "digitalWrite(pin::STATUS_LED, t.lamps ? HIGH : LOW);", None, LED),
    (INO, "&& to ||", "if (o.faults && o.armed) on = (now / 125) & 1;", None, LED),
    (INO, "!= to ==", "else if (o.control != tcu::CTRL_STOCK) on = true;", None, LED),
    (INO, "true to false", "else if (o.control != tcu::CTRL_STOCK) on = true;", None, LED),
    (INO, "== to !=", "else if (o.armed && o.event == tcu::EV_NEED_SYNC)", None, LED),
    (INO, "&& to ||", "else if (o.armed && o.event == tcu::EV_NEED_SYNC)", None, LED),
    (INO, "false to true", "else on = false;", None, LED),
    (INO, "delete statement", "digitalWrite(pin::STATUS_LED, on ? HIGH : LOW);", None, LED),
    (INO, "delete statement", "updateLeds(out, now);", None, LED),
    (INO, "delete statement", "pinMode(pin::STATUS_LED, OUTPUT);", None, LED),
    (INO, "delete statement", "if (!cfg::OLED_INSTALLED) return;", None, "OLED_INSTALLED is true in this build"),
    (INO, "delete statement", "if (!USB_LOG_ENABLED) return;", None, "USB_LOG_ENABLED is true in this build"),
    (INO, "delete statement", "digitalWrite(pin::RELAY, LOW);", "pull-downs hold them off until this point",
     "every PORT register is 0 after a reset: the pin is already low"),
    (INO, "delete statement", "digitalWrite(pin::S1, LOW);", "digitalWrite(pin::RELAY, LOW);",
     "every PORT register is 0 after a reset: the pin is already low"),
    (INO, "delete statement", "digitalWrite(pin::S2, LOW);", "digitalWrite(pin::S1, LOW);",
     "every PORT register is 0 after a reset: the pin is already low"),
    (INO, "delete statement", "digitalWrite(pin::SL, LOW);", "digitalWrite(pin::S2, LOW);",
     "every PORT register is 0 after a reset: the pin is already low"),
    (INO, "delete statement", "pinMode(pin::VSS, INPUT);", None, "every pin is an input after a reset"),
    (INO, "delete statement", "pinMode(pin::TACH, INPUT);", None, "every pin is an input after a reset"),
    (INO, "delete statement", "delay(20);", None,
     "the bootloader's 0.8 s wait at power-up lets the input filters settle first; after a reset "
     "they're settled already"),
    (INO, "false to true", "bool testEdgePending = false;", None,
     "the first step that reads it is the key-on relay check, which ignores it and clears it"),
    (INO, "false to true", "static bool prev = false, longFired = false;", "=>longFired = true",
     "longFired is only read while TEST is held, and every press resets it first"),
    (INO, "delete statement", "ibitWasActive = false;", None,
     "the key-on relay check, the only other user of the log title, runs before any self-test"),
    (INO, "false to true", "ibitWasActive = false;", None,
     "the key-on relay check, the only other user of the log title, runs before any self-test"),
    (INO, "< to <=", "while (*t && len < Oled::LINE_CHARS) buf[len++] = *t++;", None,
     "no screen text is longer than a line (system_check.py checks every one)"),
    (INO, "< to <=", "while (len < col && len < Oled::LINE_CHARS) buf[len++] = ' ';", None,
     "no line is padded past its width"),
    (INO, "delete statement", "buf[len] = '\\0';", "while (len < col && len < Oled::LINE_CHARS)",
     "pad() is never the last call on a line: the text added after it ends the string"),
    (INO, "delete statement", "s(\"-\");", None,
     "fixed() only shows values that aren't below zero, apart from a solenoid reading within 0.01 A "
     "of zero, whose sign doesn't matter"),
    (INO, "delete statement", "t = -t;", None,
     "fixed() only shows values that aren't below zero, apart from a solenoid reading within 0.01 A "
     "of zero, whose sign doesn't matter"),
    (INO, "delete statement", "hasValue = hasValue && r != tcu::TR_CHECK;", None,
     "a solenoid check only says CHECK without current sensors; this build has them"),
    (INO, "delete statement", "if (faults & tcu::FAULT_ONOFF) return \"ON/OFF SWITCH\";", None,
     "this fault has its own message, shown before the generic one (alertMessage)"),
    (INO, "delete statement", "if (faults & tcu::FAULT_RELAY) return \"RELAY STUCK\";", None,
     "this fault has its own message, shown before the generic one (alertMessage)"),
    (INO, "delete statement", "if (faults & tcu::FAULT_LEVER) return \"LEVER SENSOR\";", None,
     "this fault has its own message, shown before the generic one (alertMessage)"),
    (INO, "delete statement", "applyTestOutputs(tcu::TestOutputs());", "void runWatchdogTest() {",
     "the self-test has switched everything off before its last step"),
    (INO, "delete statement", "watchdogOn();", "}",
     "the watchdog is already running, in interrupt-then-reset mode, since setup()"),
    (INO, "delete statement", "wdt_reset();", "for (uint8_t i = 0; i < 40 && oled.present(); i++) {",
     "the 40 screen writes take well under 250 ms"),
    (INO, "delete statement", "Serial.flush();", "expecting a reset",
     "the 250 ms before the reset are plenty for the UART to send the line (64 bytes take 6 ms)"),
    (INO, "delete statement", "oled.setHero('\\0');", "if (cfg::OLED_INSTALLED) {",
     "the self-test page, showing at that moment, has no gear digit already"),
    (INO, "delete statement", "for (uint8_t i = 0; i < sizeof(dbPins); i++) *dbs[i] = tcu::Debouncer(", None,
     "starting the switch filters at OFF makes them 25 ms late, and the controller needs 100 ms of "
     "OFF before an ON arms it; at power-up the bootloader's wait has settled them first"),
    (INO, "- to +", "atfProbe.startMs = millis() - cfg::DS18B20_PERIOD_MS;", None,
     "in unsigned arithmetic the first reading still starts at once (now - start wraps past the period)"),
]
# Mutants no simulation can show either way (a race with an interrupt, a
# floating pin): real protections, reported apart, never counted as caught.
UNTESTABLE = [
    (INO, "delete statement", "noInterrupts();", "float pulseHz(PulseInput& p, uint32_t timeoutUs) {",
     "an interrupt landing between the reads of two 32-bit values: about once in a million reads"),
    (INO, "delete statement", "noInterrupts();", "void paintStack() {",
     "an interrupt during the stack paint at boot"),
    (INO, "delete statement", "for (uint8_t p : inputs) pinMode(p, INPUT_PULLUP);", None,
     "the board's own pull-ups hold these pins; the internal ones are a backstop for a broken resistor"),
    (INO, "delete statement", "for (uint8_t p : kUnusedPins) pinMode(p, INPUT_PULLUP);", None,
     "no simulation models a floating pin picking up noise"),
    (INO, "delete statement", "if (cfg::ATF_SENSOR != cfg::ATF_NTC) pinMode(pin::ATF, INPUT_PULLUP);", None,
     "no simulation models a floating pin picking up noise"),
    (INO, "!= to ==", "if (cfg::ATF_SENSOR != cfg::ATF_NTC) pinMode(pin::ATF, INPUT_PULLUP);", None,
     "no simulation models a floating pin picking up noise"),
]
UNTESTABLE = [u for u in UNTESTABLE if u[4]]


def untestable(m):
    for f, op, text, before, why in UNTESTABLE:
        if m["file"] == f and m["op"] == op and text in m["old"] and (before is None or before in m["prev"]):
            return why
    return None


# Comparing a measured value (volts, amps, mph, rpm, a time) with a limit
# using < instead of <= (or the reverse) only changes the result when the
# reading lands exactly on the limit. These are reported apart.
BOUNDARY = {"< to <=", "<= to <", "> to >=", ">= to >"}


def code_spans(line):
    """(start, end) spans of `line` that are code: not in a string, char or // comment."""
    spans, i, start, n = [], 0, 0, len(line)
    while i < n:
        c = line[i]
        if line.startswith("//", i):
            break
        if c in "\"'":
            spans.append((start, i))
            q = c
            i += 1
            while i < n and line[i] != q:
                i += 2 if line[i] == "\\" else 1
            start = i + 1
        i += 1
    spans.append((start, min(i, n)))
    return [(a, b) for a, b in spans if b > a]


def skip_line(text):
    s = text.strip()
    return (not s or s.startswith(("#", "//", "/*", "*")) or "static_assert" in s or
            s.startswith(("template", "constexpr uint8_t kUnusedPins")))


def prev_code(lines, ln):
    """The nearest non-blank line before line `ln` (0-based), stripped."""
    for i in range(ln - 1, -1, -1):
        if lines[i].strip():
            return lines[i].strip()
    return ""


def equivalent(m):
    # `before` is text in the line before, or "=>text": text in the mutated line itself.
    for f, op, text, before, why in EQUIVALENT:
        if m["file"] != f or m["op"] != op or text not in m["old"]:
            continue
        if before is None or (before.startswith("=>") and before[2:] in m["new"]) or \
                (not before.startswith("=>") and before in m["prev"]):
            return why
    return None


def mutants_of(fname):
    lines = open(os.path.join(FW, fname)).read().split("\n")
    out = []
    in_block = False
    for ln, text in enumerate(lines):
        if in_block:
            if "*/" in text:
                in_block = False
            continue
        if text.strip().startswith("/*") and "*/" not in text:
            in_block = True
            continue
        if skip_line(text):
            continue
        for a, b in code_spans(text):
            seg = text[a:b]
            for pat, rep, name in OPERATORS:
                for m in re.finditer(pat, seg):
                    # leave #include <...>, templates and casts alone
                    if name.startswith(("<", ">")) and re.search(r"(include|template|_cast)\s*$", seg[:m.start()]):
                        continue
                    new = text[:a + m.start()] + rep + text[a + m.end():]
                    out.append(dict(file=fname, line=ln + 1, op=name, old=text, new=new, prev=prev_code(lines, ln)))
        # statement deletion: a plain call or assignment on its own line
        s = text.strip()
        if (s.endswith(";") and not s.startswith(("return", "const ", "static ", "uint", "int", "float", "bool",
                                                  "tcu::", "auto ", "char ", "case ", "break", "default"))
                and re.match(r"^[\w.\[\]>()*&:-]+\s*(\(|=|\+=|-=|\|=|&=|\+\+|--)", s)):
            out.append(dict(file=fname, line=ln + 1, op="delete statement", old=text, prev=prev_code(lines, ln),
                            new=text[:len(text) - len(text.lstrip())] + ";"))
    return out


def sh(cmd, cwd, timeout=120):
    try:
        r = subprocess.run(cmd, cwd=cwd, shell=True, capture_output=True, text=True, timeout=timeout)
        return r.returncode, r.stdout + r.stderr
    except subprocess.TimeoutExpired:
        return "timeout", ""


SIM_SED = (r"sed -i -e 's/^constexpr bool IBIT_WATCHDOG_TEST = true;/constexpr bool IBIT_WATCHDOG_TEST = false;/' "
           r"-e 's/^constexpr bool CALIBRATED = false;/constexpr bool CALIBRATED = true;/' "
           r"-e 's/^constexpr AtfSensor ATF_SENSOR = ATF_DS18B20;/constexpr AtfSensor ATF_SENSOR = ATF_NTC;/' "
           "config.h")


def run_mutant(k, m):
    d = os.path.join(OUT, "work", f"m{k:04d}")
    shutil.rmtree(d, ignore_errors=True)
    fw, sim = os.path.join(d, "fw"), os.path.join(d, "sim")
    shutil.copytree(FW, fw)
    lines = open(os.path.join(fw, m["file"])).read().split("\n")
    assert lines[m["line"] - 1] == m["old"]
    lines[m["line"] - 1] = m["new"]
    open(os.path.join(fw, m["file"]), "w").write("\n".join(lines))
    shutil.copytree(fw, sim)
    sh(SIM_SED, sim)
    logic = f"{fw}/tcu_logic.cpp {fw}/self_test.cpp"
    steps = []
    if m["file"] != "tcu.ino":
        steps += [f"{CXX} -std=c++11 -O1 {SAN} -w -I{fw} -o t1 {ROOT}/test/test_tcu_logic.cpp {logic} && ./t1",
                  f"{CXX} -std=c++11 -O1 {SAN} -w -I{fw} -o t2 {ROOT}/test/test_self_test.cpp {logic} && ./t2"]
    steps.append(f"{CXX} -std=gnu++17 -O1 {SAN} -w -I{ROOT}/test -I{ROOT}/test/system/mock -I{sim} -o st "
                 f"{ROOT}/test/system/system_test.cpp {sim}/tcu_logic.cpp {sim}/self_test.cpp "
                 f"{sim}/oled.cpp {sim}/ds18b20.cpp {sim}/imu.cpp && ./st")
    # The calibration helper reads the firmware's USB log: it must still work.
    steps.append(f"./st --callog cal.log > /dev/null && python3 {ROOT}/test/test_calibrate.py cal.log")
    # What the screen shows and the log says, against the reference copies (make golden).
    gold = f"{ROOT}/test/system/golden"
    steps.append(f"./st --journal journal.txt > /dev/null; cmp -s {gold}/journal.txt journal.txt && "
                 f"cmp -s {gold}/cal.log cal.log || (echo 'FAIL golden: the screen or the USB log changed'; exit 1)")
    if CHIP and m["file"] == "tcu.ino":
        # The chip test: the mutant built for the Mega, on the simulated chip.
        core = f"PREBUILT_CORE={ROOT}/build/avr/core"
        steps.append(f"{core} OUT={d}/avr SK={fw} {ROOT}/tools/avr_build.sh > /dev/null && "
                     f"cp -r {fw} calsrc && sed -i 's/^constexpr bool CALIBRATED = false;/constexpr bool CALIBRATED = true;/' "
                     f"calsrc/config.h && {core} OUT={d}/cal SK={d}/calsrc {ROOT}/tools/avr_build.sh > /dev/null && "
                     f"{ROOT}/build/chip/chip_test {d}/avr/tcu.hex {d}/cal/tcu.hex {ROOT}/build/chip/bootloader.hex")
    result, why = "survived", ""
    for i, cmd in enumerate(steps):
        code, text = sh(cmd, d, timeout=600 if "chip_test" in cmd else 120)
        if code == "timeout":
            result, why = "killed", "timed out (hung)"
            break
        if code != 0:
            built = {"t1", "t2", "st"} & set(os.listdir(d))
            if "error:" in text and i < 3 and not built:
                result, why = "stillborn", "doesn't compile"
            else:
                fails = [ln.strip() for ln in text.splitlines() if "FAIL" in ln][:2]
                result, why = "killed", "; ".join(fails)[:200] or f"exit {code}"
            break
    shutil.rmtree(d, ignore_errors=True)
    return k, result, why


def main():
    ap = argparse.ArgumentParser()
    ap.add_argument("--file", action="append", help="only this firmware file (repeatable)")
    ap.add_argument("--jobs", type=int, default=os.cpu_count() or 2)
    ap.add_argument("--list", action="store_true")
    ap.add_argument("--fresh", action="store_true", help="forget saved results (after changing the tests)")
    ap.add_argument("--report", action="store_true",
                    help="no testing: write the report from the saved results (the chip pass counts too)")
    ap.add_argument("--chip", action="store_true", help="tcu.ino mutants also run the chip test (make chip first)")
    ap.add_argument("--only", help="only the mutants listed (numbers, comma-separated), e.g. the last survivors")
    args = ap.parse_args()
    global CHIP
    CHIP = args.chip
    ms = [m for f in (args.file or FILES) for m in mutants_of(f)]
    if args.only:
        keep = {int(k) for k in args.only.split(",")}
        ms = [m for k, m in enumerate(ms) if k in keep]
    if args.list:
        for k, m in enumerate(ms):
            print(f"{k:4d} {m['file']}:{m['line']} {m['op']}: {m['new'].strip()}")
        return
    os.makedirs(OUT, exist_ok=True)
    if args.report:
        return report_from_saved(ms)
    # Each result is saved as it comes (build/mutants/results.jsonl), so a run
    # that is stopped carries on where it left off: --fresh starts over.
    saved = os.path.join(OUT, "results_chip.jsonl" if CHIP else "results.jsonl")
    if args.fresh and os.path.exists(saved):
        os.remove(saved)
    done = {}
    if os.path.exists(saved):
        for line in open(saved):
            r = json.loads(line)
            done[(r["file"], r["line"], r["op"], r["new"])] = (r["result"], r["why"])
    key = lambda m: (m["file"], m["line"], m["op"], m["new"])  # noqa: E731
    results = {k: done[key(m)] for k, m in enumerate(ms) if key(m) in done}
    todo = [(k, m) for k, m in enumerate(ms) if k not in results]
    print(f"{len(ms)} mutants, {len(results)} already done, {len(todo)} to run", flush=True)
    with cf.ThreadPoolExecutor(args.jobs) as ex, open(saved, "a") as out:
        futs = [ex.submit(run_mutant, k, m) for k, m in todo]
        for n, f in enumerate(cf.as_completed(futs), 1):
            k, res, why = f.result()
            results[k] = (res, why)
            m = ms[k]
            out.write(json.dumps(dict(file=m["file"], line=m["line"], op=m["op"], new=m["new"],
                                      result=res, why=why)) + "\n")
            out.flush()
            if n % 25 == 0 or n == len(todo):
                print(f"  {n}/{len(todo)} done", flush=True)
    write_report(ms, results)


def report_from_saved(ms):
    """The report from build/mutants/results.jsonl, with a survivor there
    that the chip pass (results_chip.jsonl) killed counted as killed."""
    key = lambda m: (m["file"], m["line"], m["op"], m["new"])  # noqa: E731
    saved = {}
    for name in ("results.jsonl", "results_chip.jsonl"):
        path = os.path.join(OUT, name)
        if not os.path.exists(path):
            continue
        for line in open(path):
            r = json.loads(line)
            k = (r["file"], r["line"], r["op"], r["new"])
            if name == "results.jsonl" or (r["result"] == "killed" and saved.get(k, ("",))[0] == "survived"):
                saved[k] = (r["result"], ("chip test: " if name != "results.jsonl" else "") + r["why"])
    results = {k: saved.get(key(m), ("not run", "")) for k, m in enumerate(ms)}
    write_report(ms, results)


def write_report(ms, results):
    rows, tally = [], {}
    for k, m in enumerate(ms):
        res, why = results[k]
        if res == "survived" and equivalent(m):
            res, why = "equivalent", equivalent(m)
        elif res == "survived" and untestable(m):
            res, why = "untestable", untestable(m)
        elif res == "survived" and m["op"] in BOUNDARY:
            res = "boundary"
        tally.setdefault(m["file"], {}).setdefault(res, 0)
        tally[m["file"]][res] += 1
        rows.append((m, res, why))
    md = ["# Mutation test report", "", "Generated by `tools/mutate.py`. Each row is one planted bug.", "",
          "Score = caught / (caught + missed), leaving out the equivalent ones (proven to change nothing) "
          "and the ones that don't compile. *At a limit only* are missed bugs that only matter when a "
          "reading lands exactly on a limit; the second score leaves those out too.", "",
          "| File | Caught | Missed | At a limit only | Can't simulate | Equivalent | Doesn't compile | Score | Score without limit-only |",
          "|---|---|---|---|---|---|---|---|---|"]
    for f, t in tally.items():
        k, sv, b = t.get("killed", 0), t.get("survived", 0), t.get("boundary", 0)
        u = t.get("untestable", 0)
        md.append(f"| {f} | {k} | {sv} | {b} | {u} | {t.get('equivalent', 0)} | {t.get('stillborn', 0)} | "
                  f"{100 * k / max(k + sv + b + u, 1):.0f} % | {100 * k / max(k + sv + u, 1):.0f} % |")
    for title, kind in (("Missed", "survived"), ("Missed, at a limit only", "boundary")):
        md += ["", f"## {title}", "", "| Where | Bug planted | Line after |", "|---|---|---|"]
        for m, res, why in rows:
            if res == kind:
                md.append(f"| {m['file']}:{m['line']} | {m['op']} | `{m['new'].strip().replace('|', '\\|')}` |")
    md += ["", "## Equivalent (no test can see them)", "", "| Where | Bug planted | Why it changes nothing |",
           "|---|---|---|"]
    for m, res, why in rows:
        if res == "equivalent":
            md.append(f"| {m['file']}:{m['line']} | {m['op']} | {why} |")
    md += ["", "## Real, but no simulation can show them", "", "| Where | Bug planted | Why |", "|---|---|---|"]
    for m, res, why in rows:
        if res == "untestable":
            md.append(f"| {m['file']}:{m['line']} | {m['op']} | {why} |")
    open(os.path.join(OUT, "report.md"), "w").write("\n".join(md) + "\n")
    print("\n".join(md[6:6 + 2 + len(tally)]))
    print(f"report: {os.path.relpath(os.path.join(OUT, 'report.md'), ROOT)}")


if __name__ == "__main__":
    sys.exit(main())
