gamer927/rav4/(commit log)

2026-10-26 Audit TCU spec and add revised design, firmware and tests
    Audit of the rev 0 "Unified TCU & Telemetry Dashboard" spec (docs/01-audit.md)
    and a corrected rev 1 design (docs/02-revised-spec.md). Key fixes: A241E
    solenoid truth table, high-side solenoid drivers, fail-safe ECU relay
    handover with gear sync, lockup speed/brake interlocks, downshift over-rev
    guards with VSS plausibility checks, hot-ATF lockup strategy corrected,
    edge-triggered debounced shifting, watchdog, and per-mode shift maps.
    Firmware targets the Arduino Mega 2560. Control logic is hardware-free and
    covered by host unit tests (make test); tools/avr_build.sh compile-checks
    the sketch against the Arduino AVR core.
    Co-Authored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
2026-10-26 Tailor TCU design to the 1999 RAV4
    Replace the generic A241 defaults with 1999 RAV4 data: published gear
    ratios 2.810/1.549/1.000/0.734 (3rd direct) with ~4.40 final drive on
    215/70R16 tyres, rescaled shift maps, and the Toyota service-text
    confirmation of the S1/S2/SL logic, high-side drive and connector pins.
    The published final-drive figures disagree, so CUSTOM is now locked out
    until CALIBRATED is set in config.h after the STOCK-mode calibration.
    Claude-Session: https://claude.ai/code/session_01ETJrLv4Z1USdoRELecEc2N
2026-10-26 Let kickdown skip the anti-hunting dwell
    Flooring it within 1.2 s of a previous shift used to wait out the AUTO
    dwell, so a 4->3->2 kickdown could take over 2 s. At 80 % throttle or more,
    AUTO downshifts now only wait for the previous shift to finish (700 ms).
    Upshifts and part-throttle downshifts keep the dwell.
    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
2026-10-26 Add built-in test (PBIT/CBIT/IBIT) and console OLED
    Aircraft-style built-in test:
    - PBIT: passive sensor, switch, calibration and reset-cause checks at boot.
    - CBIT: new FAULT_SOLENOID from the high-side drivers' current-sense pins;
    a solenoid whose current doesn't match its command hands back to the ECU.
    - IBIT: hold the console TEST button 2 s. Interlocked like weight-on-wheels
    (master at STOCK, not in D, stationary, engine off by tach and oil
    pressure, battery in range); aborts and de-energises on any change.
    Lamp test, oil-sender zero, per-solenoid current, relay release, prompted
    console switch checks, and a deliberate watchdog reset whose results
    survive in .noinit RAM.
    Ad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
2026-10-26 Make it transmission-only with a simple console
    Console is now an ON/OFF switch, an ECO switch, a SPORT switch, [+]/[-]
    shift buttons and a TEST button, with the small OLED as the only screen.
    - Remove the oil-pressure sender (input, warnings, PBIT/IBIT checks).
    - Remove the Nextion dashboard and its telemetry protocol.
    - IBIT's second "engine running" check is now the alternator charging
    voltage (battery > 13.4 V) instead of oil pressure.
    - ECO and SPORT are two separate switches; both on runs NORMAL with an
    ECO+SPT warning instead of being treated as a wiring fault.
    - Spec rev 2 and README updated; screen images regenerated.
    Cla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
2026-10-26 Add DS18B20 ATF probe, gyro corner hold and per-mode driving features
    - ATF temperature from a DS18B20 in the cooler line (D33, 1-Wire): own
    open-drain driver, one reading per second, CRC-checked, unplugged and
    shorted probe detection, and the 85.0 C power-on value accepted only
    when it matches the previous reading. NTC sender kept as an option.
    - MPU-6050 gyro on the shared I2C bus: lateral g = yaw rate x speed, with
    the zero offset re-learned whenever the car is stopped.
    - Corner hold (all modes): no automatic shifts mid-corner; manual and
    over-rev shifts still work; ends 0.7 s after straightening, 10 s max.
    - Brake downshift (SPORT): step down while braking in a straight line to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
2026-10-26 Add per-mode throttle response: ECO smoothing, SPORT tip-in release
    - Shift decisions use a low-passed throttle per mode (ECO 0.8 s, NORMAL
    0.25 s, SPORT none), so a quick pedal stab doesn't downshift in ECO.
    Flooring it (>= KICKDOWN_TPS) always uses the raw throttle.
    - SPORT releases lockup on a fast tip-in (>= 150 %/s), except with hot ATF.
    - Spec: per-mode feel, and why not to modify the throttle linkage (the TV
    cable sets line pressure on this transaxle).
    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
2026-10-27 Rewrite README as the project cover page with a full parts list
    Summarises what the controller does per mode and its protections, the
    current status (designed and simulation-tested, not yet built), a parts
    list grouped by area, the tools and equipment needed, and the first steps
    from bench test to road.
    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
2026-10-27 Make MANUAL behave as SPORT that you shift yourself
    - In MANUAL the controller uses SPORT's lockup, coast-unlock and tip-in
    settings whatever the ECO/SPORT switches say; back in AUTO the switch
    mode returns. The screen shows the gear and MANUAL.
    - Spec: engine facts marked confirmed / unconfirmed (US 127 hp / 132 lb-ft
    and 86x86 mm confirmed; redline and fuel cut not found in any source),
    and why SPORT holds gears to near the redline with these ratio steps.
    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
2026-10-27 SPORT: lift-off hold and earlier kickdown; log factory shifts in STOCK
    - Lift-off hold (SPORT): snapping off the throttle after a hard push holds
    the gear for up to 4 s or until the throttle returns, instead of
    upshifting between corners. A gentle ease-off still upshifts.
    - Kickdown threshold per mode (ECO/NORMAL 80 %, SPORT 60 %).
    - In STOCK, the USB log prints each factory ECU shift and lockup change
    with speed, throttle and rpm, so NORMAL can be tuned to the factory map.
    - Screen shows HOLD while a brake or lift-off hold is active.
    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
2026-10-27 ECO: earlier, per-gear lockup with an anti-lug guard
    - Lockup now also needs a per-mode locked-rpm floor (ECO 1,250, NORMAL
    1,400, SPORT 1,800 rpm, released 150 rpm lower), which makes it per gear.
    ECO's speed thresholds drop to 35/30 km/h, so it locks 3rd from ~37 km/h
    and 4th from ~51 km/h instead of 50 km/h in both.
    - Anti-lug: below 1,600 locked rpm, more than 25 % throttle releases
    lockup.
    - Hot ATF uses the lowest floor, so the cooling strategy keeps working.
    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
2026-10-27 Switch everything to mph; add highway lockup for long fast runs
    - All speeds are now mph: config (shift maps, lockup, guards, VSS
    pulses/mile, rpm per mph), controller, screen, USB log, tests and docs.
    Values were converted and checked to keep the same rpm behaviour
    (e.g. SPORT full-throttle upshifts still ~5,600 rpm locked-equivalent).
    - Highway lockup (ECO, NORMAL): in 4th from 2,000 locked rpm (~51 mph),
    lockup holds up to 95 % throttle, so a 90 mph cruise or highway grade
    stays locked instead of slipping and heating the ATF.
    - Screen images regenerated in mph.
    Claude-Session: https://claude.ai/code/session_01ETJrLv4Z1USdo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
2026-10-27 Review pass: highway lockup in every mode, stale names and docs
    - Highway lockup now also applies in SPORT (and so MANUAL). A 90 mph
    cruise takes about half to two-thirds pedal, above SPORT's 45 % lockup
    limit, so the converter would have slipped the whole time and heated the
    ATF. SPORT keeps its instant release on a quick stab (tip-in).
    - Comments say ON/OFF switch instead of the old "master switch"; sketch
    header renamed to the RAV4 Transmission Controller.
    - Spec and README: highway lockup row for all modes; audit doc marked as
    historical (km/h, removed parts).
    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
2026-10-27 Add wiring guide, wiring diagrams and shifter-lever support
    - docs/03-wiring-guide.md: connector pin-outs (X1-X6), harness colour
    code and wire sizes, numbered wire list W1-W21, where each signal is on
    the 1999 RAV4 with a multimeter test to confirm it before cutting or
    tapping, every input/output circuit, a bypass plug that restores stock
    driving, and the build order.
    - docs/wiring-diagram.svg/png (system) and wiring-detail-a.svg/png (one
    solenoid channel), generated by tools/wiring_diagram.py.
    - Throttle signal now measured against the ECM's sensor ground E2 on A1
    (A0 - A1), so the TCU never ties its ground to E2.
    - SWAP_SHIFT_INPUTS for a sequential shifter lever (push or pull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
2026-10-27 Add 3D-printed console pod and TCU enclosure; placement guide for 4WD
    - hardware/console_pod.scad: wedge pod with a sloped driver-facing panel
    (ON/OFF with safety cover, ECO, SPORT, TEST, status LED, OLED window,
    optional [+]/[-]) and a top deck with the Beavis sequential shifter's
    4 x M6 116 x 74 mm pattern, nut traps and a wire slot. Prints upside
    down without supports.
    - hardware/tcu_enclosure.scad: box for the Mega, main board, buck
    converter and MPU-6050 gyro, seven labelled cable glands, USB access,
    M6 ears (or floor holes for 220 mm beds) and a screw-on lid.
    - hardware/stl/: print-oriented STLs; tools/build_stl.sh regenerates
    them and hardware/preview.png.
    - hardware/REA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
2026-10-27 Shopping list with costs, fit check, buildable boards, Lego-style build book
    Cost and parts
    - docs/04-shopping-list.md (+ CSV), generated by tools/shopping_list.py:
    every item with a price estimate, by store, incl. the Beavis shifter.
    ~$640 in parts; the README's old $250-400 left out the harness,
    connectors, housings, probe fittings and shifter.
    Hand-buildable hardware (rev 3)
    - Solenoid drivers: through-hole IRF4905 P-MOSFET + ACS712-05B current
    sensor per channel instead of PROFETs (the only through-hole one is
    end-of-life; the rest are surface-mount). Firmware: current-sense zero
    offset, re-learned only with the relays released and that driver off.
    - New over-current check: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
2026-10-27 2.42" OLED with a glanceable gear display; Lego-style build book
    Screen
    - Default screen is now a 2.42" 128x64 SSD1309 I2C OLED (55 x 27.5 mm):
    the 0.96" screen's text was 1.2 mm tall, unreadable from the seat.
    - Driver: SSD1309 support (OLED_CHIP in config.h replaces OLED_SH1106;
    no charge-pump command) and a hero layout: the gear as one 6x digit
    (18 mm tall on the 2.42") with the mode beside it in 2x text.
    - MAIN page uses it; other pages keep the normal layout. Self-test status
    shortened to fit beside the digit. Screen pictures regenerated from
    the firmware simulator.
    - Pod: 176 mm wide, screen in a pocket of ribs behind a 58 x 30.5 mm
    window (foam tape, no screws), controls r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
2026-10-27 Split into three pieces: dash pod, shifter base, TCU box; MANUAL switch
    - Dash pod (hardware/dash_pod.scad) replaces the console pod: 2.42" screen
    on the left, then one row of TCU LED, ECO, SPORT, MANUAL, TEST, ON/OFF.
    Hangs on an M5 hinge from a small mount, so it sits upright on the dash
    top or hanging from the ceiling. Fit check sweeps the hinge tilt.
    - Shifter base (hardware/shifter_base.scad): the Beavis lever bolts on top,
    lever-nut connectors inside, own 3-core cable (X7) to the TCU box.
    - Firmware: MANUAL is its own switch (D34). On = the lever shifts, off =
    AUTO; a click with MANUAL off shows FLIP MANUAL ON. Tap-to-manual and
    hold-[+] removed. IBIT adds an ONLY MANUAL ON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
2026-10-27 ECO/SPORT/MANUAL only, plain-English screen, real Beavis shifter, dash-only pod
    - Modes: NORMAL removed. Exactly one of ECO, SPORT, MANUAL must be on;
    none or more than one for 1 s hands control to the factory ECU with
    MODE ERROR / PICK MODE on the screen, and the TCU takes back over by
    itself once it's fixed (not a latched fault). Tests cover it.
    - Screen: plain words, no codes. Double-size text on any row pair; MAIN
    shows gear, mode and one big line (trans temp in F, or a headline with
    short explanations). SENSORS adds brake and lever; self-test results
    read OK / BAD / CHECK / SKIP.
    - Dash pod: dash top only, no status light (ECO, SPORT, MANUAL, TEST,
    ON/OFF); logic board los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
2026-10-27 Room to wire the TCU box; wires in the fit check; one-page cable map
    - The fit check found every part fitted but the wires had only 7 mm
    between the gland nuts and the terminals: too tight to wire by hand.
    The boards move 14 mm back (box 216 x 192 mm), leaving 21 mm.
    - The TCU box fit check now models the wires: each cable's cores fanned
    from its gland to its own terminals, both ribbon cables with plugs,
    and a minimum 15 mm working gap (asserted). build_stl.sh fails on
    assertion errors too.
    - boards.py exports terminal-group positions for the box model.
    - docs/cable-map.png (tools/cable_map.py): the system as 8 cables, one
    per labelled hole, at the top of the wiring guide and REA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
2026-10-28 Safety review, part 1: two-pole ON/OFF hardware cut, system test, cross-checks
    Firmware and hardware fixes found by the review:
    - ON/OFF is now a 2-pole switch: one pole is read (D26), the other carries
    the relay coils' power (J5 on the power board, PTC-protected, flyback
    diode), sensed on A7. OFF drops the relays in hardware even if the
    firmware hangs; the poles must agree (FAULT_ONOFF).
    - Key-on relay-release check (PBIT): a welded relay is found at every
    start and blocks take-over (FAULT_RELAY). IBIT now needs ON/OFF ON and
    ends by testing the hardware cut (TURN ON/OFF OFF).
    - Bug: switch filters started at "off", so a switch already ON at boot (or
    after a mid-drive reset) loo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
2026-10-28 Safety review, part 2: system review document, lever-sensor check, docs
    - docs/06-system-review.md: the system on one page, the safety chain,
    fallbacks, a failure-mode table (each row names the test that proves
    it), integrity cross-checks, test results, residual risks, and what to
    confirm on the bench before the custom PCB.
    - New FAULT_LEVER: the starter only turns in P or N, so an engine start
    while the lever-D input reads D means that input is stuck on. No
    take-over until the next key-on (LEVER SENSOR on the screen). Needs the
    starter's battery dip, so a tach dropout at idle can't trip it.
    - New tests: stuck lever input (unit + system scenario), dead gyro,
    shorted driver MOSF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
2026-10-28 Build book in plainer words
    - A "Words you'll see" table, numbered soldering steps, a general "if a
    check fails" routine, and an "If not:" hint under most checks.
    - Plain names instead of jargon (engine computer, big/small board, ribbon
    socket, gas pedal...), one action per tick box, self-test prompts as a
    numbered list, a worked formula for the current-sensor setting.
    - Generated board steps: hole positions instead of relay/MOSFET pin codes,
    "thin"/"thick" wire instead of AWG numbers, "stripe end" for diodes,
    and only the which-way-round notes (designer notes dropped).
    - Fixes: a broken sentence in part 8.3; thick wires used colours the
    18 AWG kit didn't have (now a 6-colour kit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
2026-10-28 Build book: meter checks everywhere, calibration helper, step-by-step first tests
    Meter checks:
    - After every board step (generated): beep-test each wire from its first
    stop to every other stop, then "no shorts" pairs on the power rails.
    system_check confirms each no-short pair really is on two different nets.
    - New checks for the screen (part 7), every cable end (part 11), and each
    car-side plug before it's plugged in (part 12: X1 volts, X3 signals with
    expected readings, X6, X2 to the engine computer and transmission pins).
    Calibration helper, tools/calibrate.py:
    - bench / parked / drive / unlock / status. Records the USB log, asks the
    driver plain questions (meter reading, GPS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
2026-10-28 MANUAL: no automatic upshift at the redline; SHIFT UP! on the screen
    In MANUAL the gear is now entirely the driver's. The TCU no longer
    upshifts at 6,200 rpm (MANUAL_REV_LIMIT_UPSHIFT = false); from 6,000 rpm
    (SHIFT_LIGHT_RPM) the screen shows SHIFT UP! (WARN_SHIFT_UP, speed x ratio
    standing in without a tach), and above that the engine computer's own fuel
    cut limits the revs (spec section 10: confirm it). ECO and SPORT still
    upshift at the rev limit. Downshift over-rev protection is unchanged.
    Tests: unit test for MANUAL (warns, keeps the gear, the driver's upshift
    clears it, works without a tach) and ECO (still upshifts); a system
    scenario checks the real screen. README, spec, review and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
2026-10-28 README: what the mod does and doesn't do, day to day, and mpg
    A plain "does / doesn't" section (no extra power, shifts no faster or
    firmer, no engine braking from 2nd or 1st, no warning lights, not proven
    yet), what everyday driving in ECO feels like, estimated mpg changes by
    kind of driving and how to measure your own, and transmission wear.
    Replaces the short "What it isn't" paragraph; the mode table is now
    "The modes in detail".
    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
2026-10-28 One circuit board for the TCU, instead of hand-wired perfboards
    The two perfboards, the hub shield and the ribbon cables become one 2-layer
    board (200 x 150 mm) that plugs onto the Mega. The builder solders the parts
    in; the board does all the wiring.
    - tools/pcb.py: netlist from boards.py, placement, routing (tools/pcb_router.py,
    a grid router), ground fill, KiCad DRC (0 errors, 0 unconnected), Gerber zip,
    BOM, step pictures, the build book's six soldering steps, and
    hardware/pcb_envelope.scad for the box's fit check
    - 5 V from a fixed RECOM R-78HB5.0-0.5 regulator instead of the LM2596HV module
    - TCU box: Mega under the board, glands placed in front of their terminals
    - system_check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
2026-10-28 Circuit board: no copper under the bolted MOSFET tabs; posts 2.5 mm taller
    Found on review:
    - Each IRF4905 lies flat with its metal tab (the drain, switched +12 V) bolted
    to the board, over the ground fill, with only solder mask in between. Now
    there is no copper under the tab on top or around the bolt on either side.
    - The board's posts left out the 2.5 mm plastic strip of the male headers that
    sits on the Mega's sockets: 16.1 mm became 18.6 mm. Fit check passes.
    - Build book: header strips go in long ends down.
    - system_check covers both.
    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
2026-10-28 Part fit check: every real part at its largest size, against the board
    tools/part_fit.py (run by tools/pcb.py, report in hardware/pcb/part_fit.md)
    checks each part on the shopping list, at its datasheet maximum or the
    biggest version sellers list: legs vs holes, room to bend the legs, bodies vs
    neighbours, screw heads, board edge and notch, clearance over the Mega, and
    heights for the box's fit check. It found, and the board now fixes:
    - square header pins (Mega, modules) had 0.09 mm in 1.0 mm holes: now 1.1 mm
    - TO-220 legs (up to 1.03 mm across) in 1.1 mm holes: now 1.3 mm
    - a 10 mm-wide 100 uF capacitor would hit the regulator: regulator moved 1.27 mm
    - a 33 mm ACS712 module would cover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
2026-10-28 Circuit board rev 2: easier to solder
    - 20 mm deeper (200 x 170 mm), the front half spread out; the box grows to
    216 x 212 mm and its fit check passes
    - every part's value printed beside its name (RU11 2.2k, DL1 BAT85, ...),
    beside thin parts where it won't fit on them, sized to the room there
    - bigger pads: a 0.6 mm copper ring where there's room, long ovals on the chips
    - no ground pad joined solidly to the ground fill (hard to heat)
    - 5 mm spacing in the crowded rows; sockets for U1 and U2
    - router: a wide track leaving a via is now checked at its own width
    (KiCad's DRC caught one too close)
    DRC 0 errors / 0 unconnected; part fit 0 problems; make check passes.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
2026-10-28 Build book: rev 2 board wording, complete parts bags
    - bags now include the chip sockets, the MOSFET screws and nuts, the LINK
    wires (the big diodes' cut-off legs) and three 40-pin header strips, and
    say what's printed on the board where it differs from the part's name
    - glossary: names and values on the board, modules plug in, sockets
    - bare-board check and "don't solder the Mega's holes" match the new layout
    - parts total about $670
    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
2026-10-28 Build book: Lego-style soldering, 60 small steps with pictures
    Each of the six soldering steps is cut into small steps: one kind of part in
    one area, at most 7 at a time, lowest first (tools/build_steps.py). Every
    small step has a picture: FIND (the part as it looks, with its real colour
    stripes, diode stripe or chip notch, how many, what's printed on the board),
    WHERE (the whole board with the area boxed), and a close-up with this step's
    parts in colour and outlined in orange, earlier parts faded, empty places as
    printed on the bare board. pcb.py --book redoes just the book from the saved
    board.
    Claude-Session: https://claude.ai/code/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
2026-10-28 Build book accuracy pass: fixes from a full read-through
    Checked every claim against the board's nets, the firmware's pins and
    messages, the calibration helper, the wiring guide and the shopping list.
    Errors fixed:
    - Mega power header: the board had 7 holes, the book says an 8-pin strip.
    The unused first pin (NC) now has a hole, so a standard strip fits
    - Part 11's final check (the full self-test through the plugs) couldn't
    pass: now a power-up check through X1; the full self-test is in 12.4/13.3
    - Part 9: how to drill the heatsink, with M3 x 16 screws and nuts
    - Shopping list: foam tape for the screen, 11 lever connectors, 3 fuse
    holders, 23 x 10k, a 3.2 mm drill bit, the heatsink sc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
2026-10-28 Firmware: watchdog-reset detection that works with the Mega's bootloader
    The Mega 2560's stk500v2 bootloader clears MCUSR before it starts the
    sketch, so on a real Mega the firmware never saw a watchdog reset: the
    self-test's SAFETY RESET step would always report BAD, and a hang
    mid-drive never showed TCU RESTARTED. The watchdog now runs in
    interrupt-then-reset mode: its ISR leaves a mark in .noinit RAM, and the
    boot code counts that as a watchdog reset.
    - System test models the bootloader (MCUSR always 0 after a reset) and a
    real watchdog timeout (the ISR runs, then the reset). New scenarios: a
    reset button mid-drive, and the SAFETY RESET step after a reboot. Both
    fail on the old cod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
2026-10-28 Optimise: 22 fewer board parts, one electronics order (~$50 cheaper)
    Board (rev 3, 113 parts instead of 135):
    - The 4 pull-downs on the ULN2803A's inputs are gone: each input already
    has 2.7k + 7.2k to ground inside the chip, so a high-Z Mega pin still
    means every driver and relay off. The cross-check now verifies those
    nets go only to ULN2803A inputs.
    - The 18 BAT85 clamp diodes are gone. The switch inputs' series resistor
    goes from 1k to 10k: with 100 nF it is a 1 ms filter, and a core
    shorted to 12 V puts at most 0.65 mA into the Mega's own clamps
    (Microchip AN2519 allows 1 mA). The throttle taps already had 10k.
    - Placement spread out where the parts went; routed, DRC 0 error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
2026-10-29 Chip test: the real .hex and bootloader on a simulated ATmega2560
    The PC tests replace the Arduino core, the chip and its bootloader with
    stand-ins, so a wrong assumption about the hardware passes them (the
    bootloader clearing MCUSR was one). make chip runs the hex exactly as
    flashed, started by the Mega's own stk500v2 bootloader, on simavr: real
    instructions, timers, interrupts, watchdog, ADC, UART and TWI.
    Around the chip, the board and car are modelled from the circuit, not
    from config.h: switches and optos on their real port bits (read from the
    Arduino core's Mega pin table), relays that need D6 and the ON/OFF
    power pole, ACS712 currents, the 47k/10k dividers, VSS/tach pulses timed
    in c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
2026-10-29 Tests: close the gaps mutation testing found
    Mutation testing (tools/mutate.py) planted 1,401 bugs; the tests caught
    68 % in tcu_logic.cpp, 60 % in self_test.cpp, 29 % in tcu.ino. This adds
    the tests the survivors asked for:
    - Self-test: every failure path of the ON/OFF CUT check (welded relay,
    no current sensors with a broken cut, nothing to cut, prompt timeout,
    TEST skip, waits for the relay to drop); nothing left on between steps,
    exactly three solenoid steps; a re-run starts clean; the watchdog
    restore keeps the amps and rejects garbage; the prompt countdown;
    PBIT gyro result and the key-on check dropping when you move off.
    - The bench model gets real timing: a relay closes 15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
2026-10-29 Tests: second batch from the mutation survivors
    Stuck shifter switch timed from the press (either switch, after any
    drive); shift maps at full throttle, past it, and gears with no shift;
    the ATF hot state clears when the probe is lost; a re-take-over starts
    without a leftover gear hold; corner hold ends when the gyro reading is
    lost; SPORT brake downshifts never land above their rpm limit; IBIT
    re-checks the passive items, names every step for the screen, a second
    full run tests everything again, and step() on an idle self-test does
    nothing.
    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
2026-10-29 Tests: gyro, throttle, probe and saved-table blind spots; reasoned equivalents
    From the mutation survivors (PC tests, then the chip pass):
    - System test: corner hold from the gyro with an 8 deg/s zero drift
    learned at a stop and re-learned as it warms up; gyro glitches that
    mustn't switch corner hold off for good, then the gyro dying
    mid-corner; the throttle reading at 0/50/100 % and with a shifted
    engine ground; a broken VTA wire (PEDAL SENSOR, ECU back); a corrupted
    saved self-test table is not restored. The mock bus can fail the gyro
    alone.
    - Chip test: the DS18B20 read once a second, two bad readings tolerated
    and the count reset by a good one, three a probe fault that clea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
2026-10-29 Tests: sanitizers on, exact limits, third batch from the survivors
    - make test / make system now build with AddressSanitizer and UBSan
    (and mutate.py too): a read one past an array, or any undefined
    behaviour, fails instead of passing by luck. Everything is clean.
    - Self-test: every limit exactly at its value passes and just past it
    fails (interlocks, PBIT supply, key-on check speed, relay release leak,
    solenoid min/max current, the cut); testName() out of range; MANUAL
    means only MANUAL; a restarted self-test starts at the first prompt
    and runs all three solenoid steps again. The bench can set a
    solenoid's current and a leak through a released relay.
    - Controller: an ECO stab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
2026-10-29 Golden screens and USB log; reasoned equivalents; lockup re-apply test
    - make golden: every system scenario's screen changes (read from the
    pixels, row by row) and the firmware's event lines on the USB log, plus
    the calibration session's whole log, compared with reference copies in
    test/system/golden/. Any change to what the driver sees or what the
    log says fails with a diff; make golden-update records an intended
    change. Part of make check, and of every mutant in mutate.py.
    - mutate.py: survivors proven to change nothing are listed with the
    reason (EQUIVALENT), and those that only matter when a reading lands
    exactly on a limit are reported apart, with a score each way.
    - Test: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
2026-10-30 Tests: shift points, lockup timing, braking; more reasoned equivalents
    - Brake tests check the gear at every step (a downshift and straight
    back up was hiding a planted bug); ECO never brake-downshifts.
    - Floored from a stop, 1->2 at the map's full-throttle point, not the
    rev limiter; ECO at a steady half throttle shifts where the map says;
    highway lockup comes back under heavy throttle after a dab of the
    brake; after a take-over lockup waits the settle time; SPORT braking
    gently still gets the map's downshifts.
    - mutate.py: equivalents can match the mutated line itself; the
    remaining harmless survivors in tcu_logic.cpp are listed with reasons.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
2026-10-30 System test: screen tour (below zero, SENSORS page values, a self-test with many failures) into the golden journal; self-test screens now journaled
    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
2026-10-30 Simulations: real current-sensor zeros, outputs read back like the chip
    - Each ACS712 now reads 2.54 / 2.47 / 2.52 V at zero amps (PC and chip
    simulations), as real parts do. Unlearned, 2.54 V would read 0.22 A,
    over the 0.2 A "off" limit. The normal drive checks every solenoid's
    current reads right.
    - The PC stand-in for the Arduino core returned the input level when
    the sketch read back one of its own outputs; the chip returns the level
    written. So the firmware's "relays released?" test never passed on the
    PC and the sensors' zeros were never learned there: with a perfect
    2.50 V it didn't show. Fixed (pinMode is tracked), and a reset makes
    every pin an input again.
    - Gyro s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
2026-10-31 Tests: the last driving-logic gaps
    - SPORT, straight off the throttle onto the brake in 2nd at 50 mph:
    1st would over-rev, so no brake downshift, and when the lift-off hold
    ends the map's upshift still comes.
    - Refused automatic downshifts while braking (SPORT emergency stop, and
    MANUAL's forced downshift right after the driver's own) never put NO
    SHIFT on the screen.
    - SPORT: no brake downshift mid-corner, even past the corner hold's
    time limit.
    - mutate.py: a refused brake downshift returning "handled" is listed as
    equivalent (only refused while a shift is in progress, when the map's
    request would be refused too).
    Claud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
2026-10-31 Tests: the hardware-side gaps; harmless and unsimulatable cases listed
    - PC simulator: 250 ms without a watchdog kick now fails (it only
    measured gaps before, so a loop that never kicked passed); a reboot
    clears the firmware's objects as a reset clears RAM; the journal shows
    the self-test's screen flash.
    - New scenarios: a wrong gear engaged (S1/S2 swapped in 3rd: WRONG
    GEAR), a stuck shifter switch (one shift, SHIFTER?), SPORT's brake hold
    (HOLDING GEAR), 40 mph round a long gentle bend (not learned as the
    gyro's zero). Battery fault says BATTERY VOLTS; after a restart and a
    re-arm the screen says TCU RESTARTED. The screen tour adds the TEST
    page before the key-on checks, sp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
